Global-Health-Labs/nPOC-BB/docs/index.md

# Project Introduction

## Overview

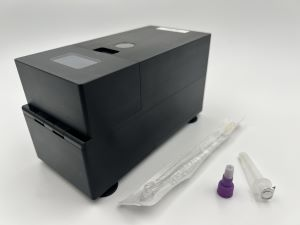
[picture p1: docs/img/gamma-09.jpg]
nPOC-BB Gamma version


The Near Point-Of-Care Bead Beater (nPOC-BB) is a portable sample preparation instrument that is designed to:

1. produce a biosafe cell lysate,
2. release amplifiable cellular nucleic acids, and
3. stabilize released nucleic acids by thermal denaturation of nucleases;

all from a minimally treated human specimen, especially when collected by a swab and transferred into a small (≤3 mL) dropper tube filled with buffer and micro-scale glass beads. Collectively, this intended use enables molecular diagnostic applications for detecting difficult-to-lyse pathogens in human biological specimens in a variety of settings.

The mechanisms by which the device achieves these intentions are a combination of heating to near-boiling liquid temperatures and rapid shaking (also known as "bead beating") to shear-force-inducing frequencies. Both mechanisms are important: the heating increases susceptibility of microorganisms to killing and lysis, which improves biosafety and contributes to lysis efficiency, and decreases nuclease activity, which stabilizes the released nucleic acids in the resulting lysate; the shaking drastically increases lysis efficiency, which releases more amplifiable nucleic acids into the resulting lysate than heating alone. We typically measure lysis efficiency by the quantity of amplifiable nucleic acids released from target cells in the sample.

Data generated on this instrument at Global Health Labs (GHL), its original developer, show that for difficult-to-lyse cellular microorganisms, such as *Mycobacterium tuberculosis* (Mtb), heating alone results in almost no lysis efficiency, while shaking alone (such as with a lab-grade bead beater or homogenizer) results in reduced lysis efficiency, compared to heating and shaking together. Therefore, we created the nPOC-BB instrument for you, the diagnostic test developer who requires a low-cost, portable, robust, and rapid method for the efficient preparation of a sample to be used in a nucleic acid amplification test (NAAT).

The goal of this documentation is to describe the nPOC-BB instrument as a stand-alone instrument whose principles may be replicated in commercial diagnostic (global) health care products, but the development of this specific instrument took place within the context of the development at GHL of [NAATOS][1], a diagnostic system for the nucleic-acid-based detection of Mtb from human tongue swab specimens. However, because the nPOC-BB has also been shown to yield high lysis efficiency of Mtb in human sputum samples, which is an excellent model for a difficult-to-lyse organism in a challenging sample matrices, we believe this instrument will be useful beyond the original application—a claim that of course must be validated in your own context.

## Contributors

### Global Health Labs (GHL)

GHL is the lead developer of the nPOC-BB device, having invested in several areas of early stage research related to new tools and technologies for diagnosis of tuberculosis (and other endemic infectious disease) in low-resource settings.

- Lex Ball [:material-linkedin:](https://www.linkedin.com/in/lex-ball-a0041219/){:target="_blank"}
- [Josh Bishop](https://github.com/jdbishop) [:material-linkedin:](https://www.linkedin.com/in/josh-bishop-ph-d-6207324/){:target="_blank"}
- [Stephen Burkot](https://github.com/sburkot24) [:material-linkedin:](https://www.linkedin.com/in/stephenburkot/){:target="_blank"}
- [Ryan Calderon](https://github.com/rcalderon04) [:material-linkedin:](https://www.linkedin.com/in/ryan-calderon-a6a02625/){:target="_blank"}
- [Simon Ghionea](https://github.com/sghionea) [:material-linkedin:](https://www.linkedin.com/in/simonghionea/){:target="_blank"}
- [Chin Ng Hei](https://github.com/ngchei) [:material-linkedin:](https://www.linkedin.com/in/chin-ng-ph-d-21522013/){:target="_blank"}
- Isabel Izek [:material-linkedin:](https://www.linkedin.com/in/isabel-izek/){:target="_blank"}
- [Matt Keller](https://github.com/mkeller99) [:material-linkedin:](https://www.linkedin.com/in/matt-keller-a360b483/){:target="_blank"}
- Khushboo Khimani [:material-linkedin:](https://www.linkedin.com/in/khushboo-khimani/){:target="_blank"}
- [Andrew Miller](https://github.com/andrewmiller-ghl) [:material-linkedin:](https://www.linkedin.com/in/andrew-miller-78938520/){:target="_blank"}
- Bryan Norton [:material-linkedin:](https://www.linkedin.com/in/bryanjnorton/){:target="_blank"}
- Julie Pendergraft [:material-linkedin:](https://www.linkedin.com/in/julielpendergraft/){:target="_blank"}
- Jamie Purcell [:material-linkedin:](https://www.linkedin.com/in/jamie-purcell-phd-098aa65a/){:target="_blank"}
- Amy Steadman [:material-linkedin:](https://www.linkedin.com/in/amy-steadman-aa80578b/){:target="_blank"}

### Central Centerless Grinding (CCG)/Scitus Engineering

[CCG](http://ccgonline.net/) is the hardware design and instrument manufacturing partner for the nPOC-BB and NAATOS systems.

- Philip Almquist
- Mark Flanagan[^1]
- James Paolino[^1]
- Ed Sienczylo
- David Sorenson
- Binh Tran

### Odic

[Odic](https://odic.com/) is the electronics design partner for the nPOC-BB and NAATOS systems.

- Rob Filipkowski[^2]
- Liam Sullivan
- Ian O’Neil
- Dylan Derose

### Market Access Africa (MAA)

[MAA](https://www.marketaccess.africa/) is the African healthcare market research partner for the nPOC-BB and NAATOS systems.

- Olawale Ajose[^3] [:material-linkedin:](https://www.linkedin.com/in/olawale-ajose-1521b975/){:target="_blank"}
- Obakeng Bagopi
- Zipporah Bundi
- Nancy Njoku-Attah
- Wambui Nyabero
- Pam Pillay[^3] [:material-linkedin:](https://www.linkedin.com/in/pam-pillay-a7b5ba65/){:target="_blank"}
- Newton Runyowa
- Chris Smit
- Shabnam Zavahir

### Health Innovation Advisors (HIA)

[HIA](https://innovationadvisors.org/) is the user research and implementation science partner for the nPOC-BB and NAATOS systems.

- Melissa Mugambi[^4] [:material-linkedin:](https://www.linkedin.com/in/melissamugambi/){:target="_blank"}

[^1]: Corresponding contributor for CCG.
[^2]: Corresponding contributor for Odic.
[^3]: Corresponding contributor for MAA.
[^4]: Corresponding contributor for HIA.

[1]: <https://www.ghlabs.org/innovations/next-generation-dx-platforms-2> "NAATOS: Nucleic Acid Amplification Test On a Strip"
