Global-Health-Labs/nPOC-BB/docs/outputs/programming.md

# Programming Instructions

## Instruction for Config / Logs

On an nPOC-BB (Gamma) unit running firmware v3.1 or later, the file system on the exposed mass storage device and NOR flash 1Gbit storage contains the two subdirectories `config` and `logs`, which contain the files for the configuration of the unit and all logs created by the unit, respectively. Below is an example filesystem from a nPOC-BB (Gamma) unit running firmware v3.5 that has been configured to operate four distinct cycles in a run and has logged two distinct runs.

    \
    ├─ config
    │   ├─ config_v3.5.txt
    │   ├─ cycle_config_1.txt
    │   ├─ cycle_config_2.txt
    │   ├─ cycle_config_3.txt
    │   └─ cycle_config_4.txt
    └─ logs
        ├─ sample_05-21-25_121449.csv
        └─ sample_05-22-25_120343.csv

### Config

The `config` subdirectory contains text files that configure the operation of an nPOC-BB unit. The configuration files contain configuration parameters that either apply to the entire run, which may comprise one or more independent cycles, or to cycles, the number of which is configurable. A standard run on a nPOC-BB (Gamma) unit running firmware v3.5 is four cycles: startup; heating; heating and shaking, and passive cooling and shaking.

!!! note
    When a new firmware version is flashed onto a unit, the unit will compare the current firmware version to the Run Configuration file version in storage. If the Run Configuration file name (e.g., `config_v3.4`) does do not match the flashed firmware version (e.g., `v3.5`), the unit will delete all configuration files from storage and create new configuration files that match the current version and contains default values. This functionality exists in the firmware to guarantee compatibility with the configuration files.

#### Run Configuration

A single Run Configuration file will be in the `config` subdirectory. The Run Configuration file is named after the current firmware of the unit (e.g., `config_v3.5.txt` when the firmware version is `v3.5`). The Run Configuration file contains the parameters that configure unit operation for an entire run of one or more cycles (but does not configure the individual cycles; see below). The following table describes the firmware v3.5 Run Configuration parameters and lists their types, default values, and units.

{{ read_csv("docs/tables/nPOC-BB_config_run_params.csv") }}

#### Cycle Configuration

One or more Cycle Configuration files will be found in the `config` subdirectory. The Cycle Configuration files are named for the cycle number (starting with `1` and proceeding in integer order, e.g., `cycle_config_1.txt`, `cycle_config_2.txt`, `cycle_config_3.txt`, and `cycle_config_4.txt`). Each Cycle Configuration file contains the parameters that apply to a single cycle. The default configuration for a nPOC-BB (Gamma) unit running firmware v3.5 uses four cycles defined by four Cycle Configuration files. The following table describes the firmware v 3.5 cycle parameters found in a Cycle Configuration file and lists their types, default values, and units.

{{ read_csv("docs/tables/nPOC-BB_config_cycle_params.csv") }}

### Logs

The `logs` subdirectory contains log files in `*.csv` format. A new log file is generated for every power-on event and every run. A log file is named after the date and time of the event or run (e.g., `sample_05-21-25_121449.csv`).

A log file containers a header row and one or more data rows. Each data row is a single line of comma-delineated text that begins with a timestamp followed by the most recent sensor data gathered at `sample_rate` (a configuration parameter set in the Run Configuration file) and an `Event`, if one has occurred. `Event`-based log entries are generated at the time of the event. Non-`Event` log entries are generated at the `logging_rate` (a configuration parameter set in the Run Configuration file).

The following table contains the header row and the first three data rows of an example log file:

| Time | HeaterTemp | HeaterPWM | MotorSpeed | MotorPWM | Battery | BatteryV | BatteryT | Event |
| - | - | - | - | - | - | - | - | - |
| 2024-12-05 12:04:34 | 24.01 | 100.00 | 0.00 | 0.00 | 19 | 3.57 | 25.03 | Cycle 1 Started |
| 2024-12-05 12:04:35 | 26.39 | 100.00 | 0.00 | 0.00 | 19 | 3.63 | 25.05 | |
| 2024-12-05 12:04:36 | 29.77 | 100.00 | 0.00 | 0.00 | 19 | 3.64 | 25.60 | |

## Instruction for Flashing Firmware

Download the latest [firmware build (v3.5)](https://github.com/Global-Health-Labs/nPOC-BB/tree/main/sw/firmware_with_bootloader) or build from source code in [firmware repository](https://github.com/Global-Health-Labs/NAATOS-V1-Modules-FW).

1. On PC, open `Device Manager` window.
2. In the `Device Manager` window, click `View` => `Show hidden devices`.
3. Connect nPOC-BB unit to PC via USB-C cable.
4. On nPOB-BB unit, With its lid opened, press its start/stop button (top of unit) at least 3 times (4/5 presses may be necessary in case some presses are not registered).
5. Verify in `Device manager` window that two new COM ports have appeared.
   - One "current" port
   - One "hidden" port (with a grey out icon). Remember the number of this port.
6. On PC, open `Command Prompt` window.
7. In the `Command Prompt` window, change directory to the folder that contains the firmware.
8. In the `Command Prompt` window, enter
   `uploadImage.bat COMX`
   (where X is the “hidden” port number we identified in 4b). You should see a progress bar (no progress until next step).
9. On the nPOC-BB unit, press its start/stop button at least 3 times.
10. In the `Command Prompt` window, once the progress reaches 100%, the nPOC-BB LEDs will turn off momentarily.
11. The firmware is updated on the nPOC-BB when its battery LED breathes blue.
12. Disconnect the nPOC-BB from the PC.

## Instruction for Programming Firmware

### Requirements

- [Segger Embedded Studio](https://www.segger.com/downloads/embedded-studio/){:target="_blank"} software version 5.34 was originally used to develop the firmware. Later versions may also work.
- [nRF Connect](https://www.nordicsemi.com/Products/Development-tools/nRF-Connect-for-Desktop){:target="_blank"} software is used to upload the firmware.
- [`nrfutil`](https://www.nordicsemi.com/Products/Development-tools/nrf-util){:target="_blank"}
- Source code for nPOC-BB firmware (shared as [NAATOS---Modules](https://github.com/Global-Health-Labs/NAATOS---Modules){:target="_blank"})
- An nRF PCA10040/56 or a Segger programmer connected to a 6-pin JTAG programming cable is used to program and communicate to the boards via both Segger Embedded Studio and nRF Connect.

### Environment

Open the code in Segger Embedded Studio go to `application/solution/`. The firmware code base for nPOC-BB is shared with the NAATOS system. Therefore, in this directory there should be `naatos_fw.emProject` which is the project file and can be double clicked to open the project inside of Segger Embedded Studio.

For opening the bootloader project, follow the same steps except follow the path `bootloader/solution/` and open `naatos_bootloader.emProject`.

### Debug / Release Modes

Switching the project between Debug and Release can be done inside of the Project Explorer tab of Segger Embedded Studio.  

In most cases, the project should be inside of Debug mode when building the firmware. The only time the Release mode should be used for would be when creating final firmware builds to keep the optimization as high as possible and memory usage as low as possible.  

For the bootloader, ONLY the release mode should be used and not the debug mode. Building and using the bootloader inside of Debug mode will lead to the Bootloader not working and unable to update firmware properly.  

When building the application code, certain memory spaces may have to be changed depending on whether the resulting .hex file being produced will be used with or without a bootloader. The two cases being one where the bootloader is being used on the unit and one that is not. Depending on this the memory map for the unit will need to be changed.  

When simple testing is required, and the bootloader is not needed on the board the memory space for the unit needs to be modified so that it does not expect bootloader code within its memory.  This is done by modifying the linker options of the project. Follow these steps to modify the linker options:

1. Right-click the project in the Project Explorer tab of Segger Embedded studios and select Options.  
2. Choose the build type for the Options, and set it to Common.  
3. Select Linker in the Options.  
4. Double-click on the Section Placement Macros  
5. A property editor should then come up on the screen.  
6. Replace the Text with the following to make the application run without the need of a bootloader flashed onto the unit:

        FLASH_PH_START=0x0
        FLASH_PH_SIZE=0x100000
        RAM_PH_START=0x20000000
        RAM_PH_SIZE=0x40000
        FLASH_START=0x0000
        FLASH_SIZE=0xF3000
        RAM_START=0x20000000
        RAM_SIZE=0x40000

    If the unit is being programmed and the firmware image is expecting to have a bootloader on the unit and contain the full firmware the following options need to be set:  

        FLASH_PH_START=0x0 
        FLASH_PH_SIZE=0x100000 
        RAM_PH_START=0x20000000 
        RAM_PH_SIZE=0x40000 
        FLASH_START=0x1000 
        FLASH_SIZE=0xF3000 
        RAM_START=0x20000008 
        RAM_SIZE=0x3FFF8 

### Bootloader

Triple-press the start button for the board to enter the bootloader from the application firmware. Bootloader must be programmed onto the board of a unit to enter the mode, or the unit will end up in a hard fault state with the unit crashing.  

There are four required files for full firmware programming of the unit (found in `/sw/firmware_with_bootloader/`):

- The [application firmware hex file]({{ files_url }}/sw/firmware_with_bootloader/npoc-bb_fw.hex), `npoc-bb_fw.hex`, is the application code, which is flashed onto the board, is generated with each revision of application firmware changes, and can be overwritten.
- The [bootloader firmware hex file]({{ files_url }}/sw/firmware_with_bootloader/npoc-bb_bootloader_SG_compilerelease_NORELOC.hex), `npoc-bb_bootloader_SG_compilerelease_NORELOC.hex`, is the bootloader code, which is flashed onto the board, is generated only once, and cannot be overwritten.  
- The [master boot record]({{ files_url }}/sw/firmware_with_bootloader/mbr_nrf52_24.1_mbr.hex), `mbr_nrf52_24.1_mbr.hex`, is the static record of the bootloader, which is taken from the nRF52840 SDK, not modified for this application, and cannot be overwritten.
- The [bootloader settings hex file]({{ files_url }}/sw/firmware_with_bootloader/npoc-bb_bootloader_settings.hex), `npoc-bb_bootloader_settings.hex`, contains the settings for the bootloader to run on, tells the bootloader what to expect on a firmware upgrade, and can be regenerated to accommodate changes to the bootloader.

!!! note
    nRF Connect must be used to program the bootloader onto the unit. Segger Embedded Studio cannot program the bootloader onto the unit.  

1. Open nRF Connect.

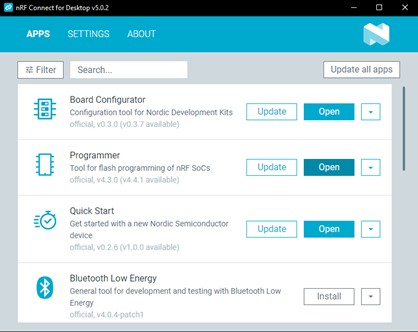
[picture p2: docs/img/sw-06-nrf_connect.png]
nRF Connect
    

2. Select the Programmer Tool, then select `nRF52 DK` as the programmer (top left).

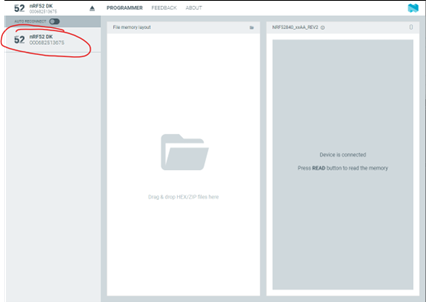
[picture p3: docs/img/sw-07-nrf52_dk.png]
Programmer Tool > nRF52 DK
    

3. Add all four firmware files into the Programmer Tool.

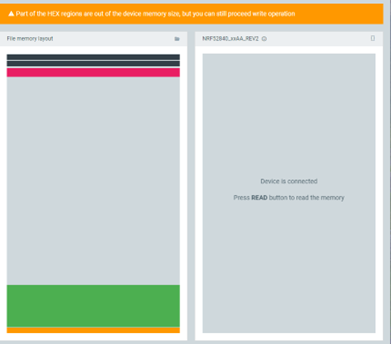
[picture p4: docs/img/sw-08-file_memory.png]
File memory
    

    !!! note
        Ensure that the application firmware hex file is generated with the correct memory layout and expects the bootloader to be there.  

4. When the firmware files are loaded into the programmer the `Erase and Write` button can be pressed to write the full firmware to the unit.

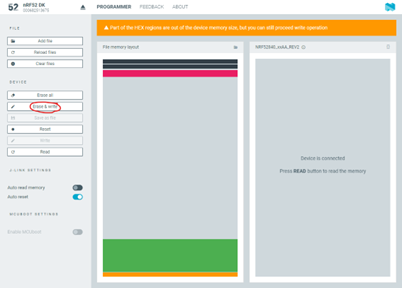
[picture p5: docs/img/sw-09-completed.png]
Erase and Write
    

    There should be no red messages in the console log and the finishing programming line should be `Reading readback protection status for Application core completed`.

5. The unit has been fully programmed and has both the bootloader and the application firmware on the unit and is ready for operation and future upgrades via the bootloader.  

### Generate Upgrade Package

To generate a package, first ```nrfutil``` must be installed which runs the entire firmware upgrade creation and flashing process.

To create a package the following command must be run with ```nrfutil```:

    nrfutil pkg generate --hw-version 52 --sd-req 0x00 --application-version 4 --application Path/To/Application/Hex/File --key-file Path/To/Key/File npoc-bb_dfu_package.zip 

This command takes in the newly created application firmware hex and our Odic generated key file which will be provided to create a .zip upgrade package with the given application firmware hex file.  

A script will also be provided which can be run to create a firmware upgrade package when the correct paths are set inside of it.  

### Flashing Upgrade Package

Now to flash the unit, it must first be put into bootloader mode via clicking the button 3 times on the unit. The unit should then open a COM port on the computer which can be seen inside of the unit manager for Windows.  



The COM port for the bootloader should be named ‘nRF52 SDFU USB’, run the following command with the COM port replacing COM_PORT:

    nrfutil dfu usb-serial -pkg npoc-bb_dfu_package.zip -p COM_PORT -b 115200 

The firmware should then begin uploading to the unit and updating it.

## Instruction for Programming Power Driver (PD) Controller

### Requirements

- nPOC-BB (Gamma) unit main printed circuit board (PCB)
- nPOC-BB (Gamma) unit battery pack
- USB-C cable (×2)
- [Adafruit FT232H breakout board](https://www.adafruit.com/product/2264){:target="_blank"}
- 6-pin TAG-Connect cable, terminated with headers
- [Zadig](https://zadig.akeo.ie/){:target="_blank"}
- `eeprom_flasher.py`
- PyFTDI python module
- `nPOC-BB_PD.bin`
- [Optional] Microsoft Visual Studio Code (vscode)
- [Optional] [TI TPS2570 Application Customization Tool](https://dev.ti.com/gallery/view/USBPD/TPS25750_Application_Customization_Tool/ver/7.0.4/){:target="_blank"}

### Setup

#### Setup Adafruit FT232H

Adafruit [has provided detailed instructions](https://learn.adafruit.com/circuitpython-on-any-computer-with-ft232h/windows){:target="_blank"} on using the Adafruit FT232H on Windows because Windows does not allow driverless devices. The driver must be updated manually, but only once per FT232H per computer. A summary of the Adafruit instructions is below.

1. Connect only the Adafruit FT232H to your PC. Disconnect all other USB to serial devices (this includes Arduinos).
2. Launch Zadig.
3. Under `Options > List All Devices`, find `USB Serial Converter`.
4. Replace the default driver with `libusbK`.

#### Wire TAG-Connect and Adafruit FT232H

Connect the TAG-Connect to the Adafruit FT232H board as follows:

| FT232H Pin | TAG-Connect Pin |
|---|---|
| GND | 4 |
| D0 | 1 |
| D1 | 3 |

Note that when looking at the header side of the TAG-Connect cable, it has the following pin numbering:

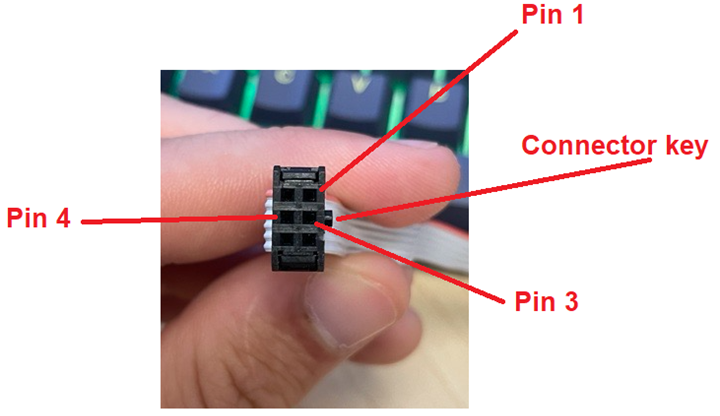
[picture p6: docs/img/sw-02.png]
TAG-Connect pins


#### Configure TPS25750

The `nPOC-BB_PD.bin` and `nPOC-BB_TPS25750_config.json` files were generated using the [TI TPS2570 Application Customization Tool](https://dev.ti.com/gallery/view/USBPD/TPS25750_Application_Customization_Tool/ver/7.0.4/){:target="_blank"}. It should not be necessary, but to regenerate the `nPOC-BB_PD.bin` and `nPOC-BB_TPS25750_config.json` files, follow the steps below.

!!! note
    The TI TPS2570 Application Customization Tool requires free registration to use. The tool will suggest to download and install software, but the `Esc` key can be pressed to avoid that step.

1. Answer the questions about your desired configuration using the values in the table below.

    | Question | Answer |
    |-|-|
    | 1. Configuration | Power Sink only (second box) with BQ and integrated switch (upper left option) |
    | 2. N/A ||
    | 3. What Sink Power is Required? | 60W |
    | 4. N/A ||
    | 5. What is the supported USB Highest Speed? | USB 2 |
    | 6. Do you have a preferred data role? | Device |
    | 7. Do you have a vendor ID supplied by the USB-IF? | No |
    | 8. Do you have a desired product ID? | No |
    | 9. Select the battery charger component to integrate | BQ25792 |
    | 10. Battery charging voltage | 8.4V |
    | 11. Battery charging current | 3.3A |
    | 12. Charge termination current | 0.12A |
    | 13. Pre-charge current | 0.32A |

2. Click `Export Settings`, type the file name `nPOC-BB_TPS25750_config`, and click `Export` to download the `nPOC-BB_TPS25750_config.json` file.
3. Click `Generate Full Flash Binary`, choose the format `Binary`, type the file name `nPOC-BB_PD`, and click `Download` to download the `nPOC-BB_PD.bin` file.

!!! note
    The TPS25750 has GPIOs that can be configured under `Advanced Configuration`. Reference the TPS25750 Host Interface Technical Reference Manual for more information.

### Programming

1. If not already installed, install PyFTDI from vscode (or other Python-enabled terminal) with `pip install pyftdi`.
2. Change directory to the location of the `eeprom_flasher.py` and `nPOC-BB_PD.bin` files.
3. Connect a USB-C cable between the PC running the Python script and the Adafruit FT232H board.
4. Connect the battery pack to the nPOC-BB (Gamma) unit main PCB. First connect black (battery pack ground), then red (battery pack positive), and finally purple (battery pack center-tap).

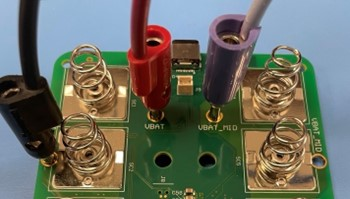
[picture p7: docs/img/sw-03.jpg]
Battery connections
    

5. Attach alligator clip to nPOC-BB (Gamma) unit main PCB at J9.

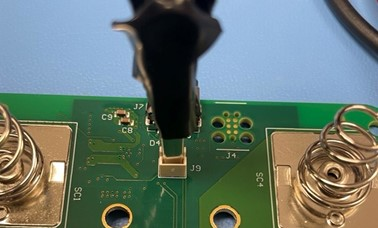
[picture p8: docs/img/sw-04.jpg]
Alligator clip
    

6. Connect a USB-C cable between the PC and the nPOC-BB (Gamma) unit main PCB.
7. Connect the TAG-Connect to the nPOC-BB (Gamma) unit main PCB at J8.

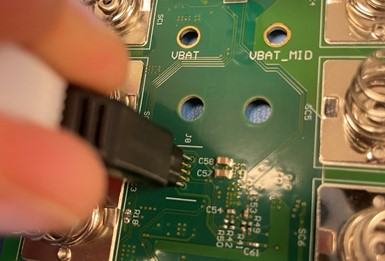
[picture p9: docs/img/sw-05.jpg]
TAG-Connect
    

8. Run `python eeprom_flasher.py`.
    - It will take approximately 15 seconds to program the board.
    - When the script reads back what it programmed to the board, it should print out `bytearray(b'\x00\x08\x00\x00\xff\xff\xff\xff\xff\xff\xff\xff\xff\xff\xff\xff')`.
9. Disconnect the TAG-Connect cable.
10. Disconnect the USB-C cable attached to the nPOC-BB (Gamma) unit main PCB.
11. Disconnect the battery pack from the nPOC-BB (Gamma) unit main PCB. First disconnect the purple wire (battery pack center-tap), then the red wire (battery pack positive), then the black wire (battery pack negative).
