Global-Health-Labs/nPOC-BB/docs/inputs/rtm.md

# Requirements Traceability Matrix (RTM)

## Overview

The nPOC-BB was originally developed at GHL as the front-end of a prototype diagnostic test system called NAATOS. Therefore, the design inputs for the nPOC-BB are a subset of the design inputs for NAATOS, and the RTM for the nPOC-BB is excerpted from the larger NAATOS RTM. As such, some of the excerpted User Needs and/or Requirements:

1. Contain NAATOS-specific references.
    1. **Product** denotes the NAATOS system.Nucleic Acid Amplification Test On a Strip. A technology under development at Global Health Labs (GHL) that combines the low-cost and availability of lateral flow assay (LFA) testing with nucleic acid amplification (i.e., molecular) testing.
    2. **SPM** is the abbreviated name of the nPOC-BB instrument in the NAATOS system.
    3. **SCC** is the abbreviated name of the swab used to collect a sample.
    4. **STC** is the abbreviated name of the dropper tube used in the nPOC-BB.
2. Do not apply to the nPOC-BB parts of NAATOS and therefore state "N/A" in an adjacent cell.
3. Apply to the specific manufacture and regulatory approval of a medical device and therefore state "**TBD**" in the cell.

You can also [download a tabular version of this RTM in the ```*.csv``` format](../tables/nPOC-BB_rtm.csv).

## Requirements Traceability Matrix

{{ read_csv("docs/tables/nPOC-BB_rtm.csv", na_filter = False) }}
