Global-Health-Labs/nPOC-BB/docs/outputs/alpha.md

# Alpha version (2024Q2)

## Bill of Materials

Not available.

## Hardware

### CAD

- SolidWorks Parts, Assemblies, and Drawings
    - [/hw/alpha/CAD/solidworks/](https://github.com/Global-Health-Labs/nPOC-BB/tree/main/hw/alpha/CAD/solidworks){:target="_blank"}
- Top-Level Assembly
    - [/hw/alpha/CAD/solidworks/GHL-1-22000.SLDASM](https://github.com/Global-Health-Labs/nPOC-BB/blob/main/hw/alpha/CAD/solidworks/GHL-1-22000.SLDASM){:target="_blank"}
- Derived Solid Files
    - [/hw/alpha/CAD/derived/](https://github.com/Global-Health-Labs/nPOC-BB/blob/main/hw/alpha/CAD/derived/){:target="_blank"}

### eCAD

- Main PCBA
    - [/hw/alpha/ECAD/](https://github.com/Global-Health-Labs/nPOC-BB/tree/main/hw/alpha/ECAD){:target="_blank"}

## Firmware

- Version 1.0–2.0a
    - [NAATOS-V1-Modules-FW](https://github.com/Global-Health-Labs/NAATOS-V1-Modules-FW){:target="_blank"}
