Global-Health-Labs/nPOC-BB/docs/outputs/notifications.md

# Notification Specification

On an nPOC-BB (Gamma) unit running firmware v3.5, the LED notification lights will notify the user according to the specification in the table below.

{{ read_csv("docs/tables/nPOC-BB_notifications.csv") }}
