Global-Health-Labs/nPOC-BB/docs/img/01-nPOC-BB-beta.png

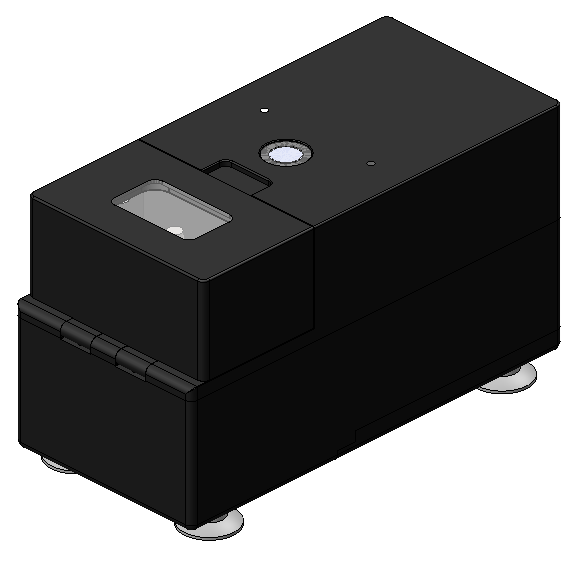
docs/img/01-nPOC-BB-beta.png
