Global-Health-Labs/nPOC-BB/docs/img/gamma-01.jpg

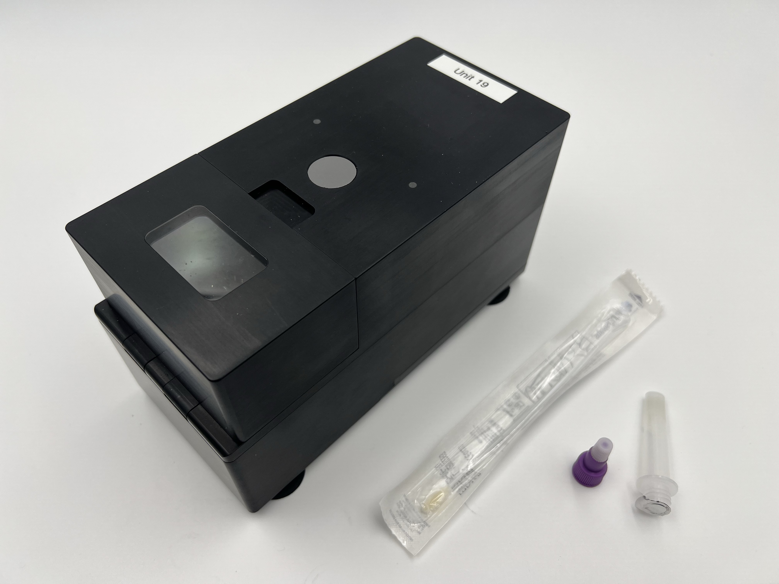
docs/img/gamma-01.jpg
