Global-Health-Labs/nPOC-BB/docs/img/gamma-02.jpg

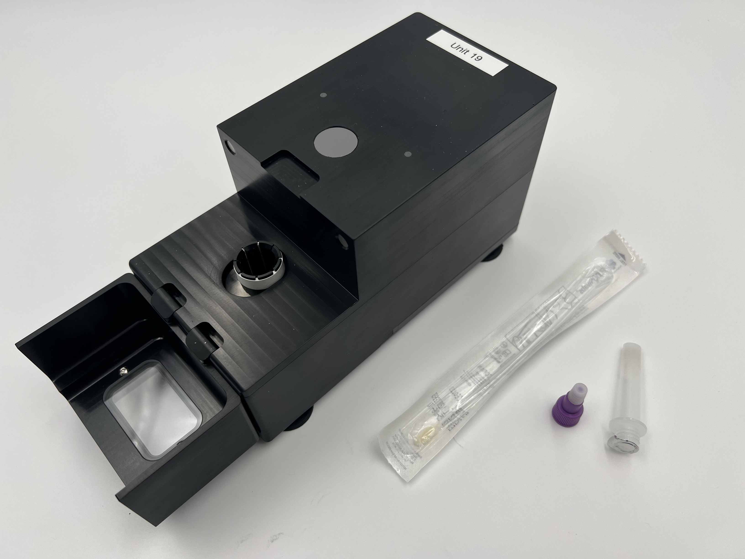
docs/img/gamma-02.jpg
