Global-Health-Labs/nPOC-BB/docs/img/gamma-04.jpg

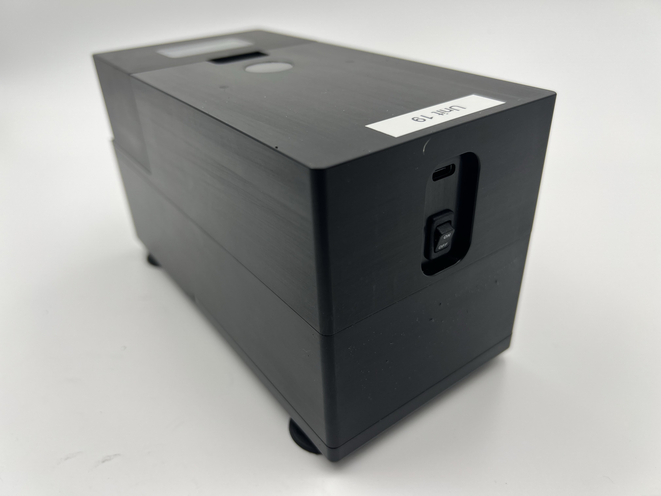
docs/img/gamma-04.jpg
