Global-Health-Labs/nPOC-BB/docs/img/gamma-05.jpg

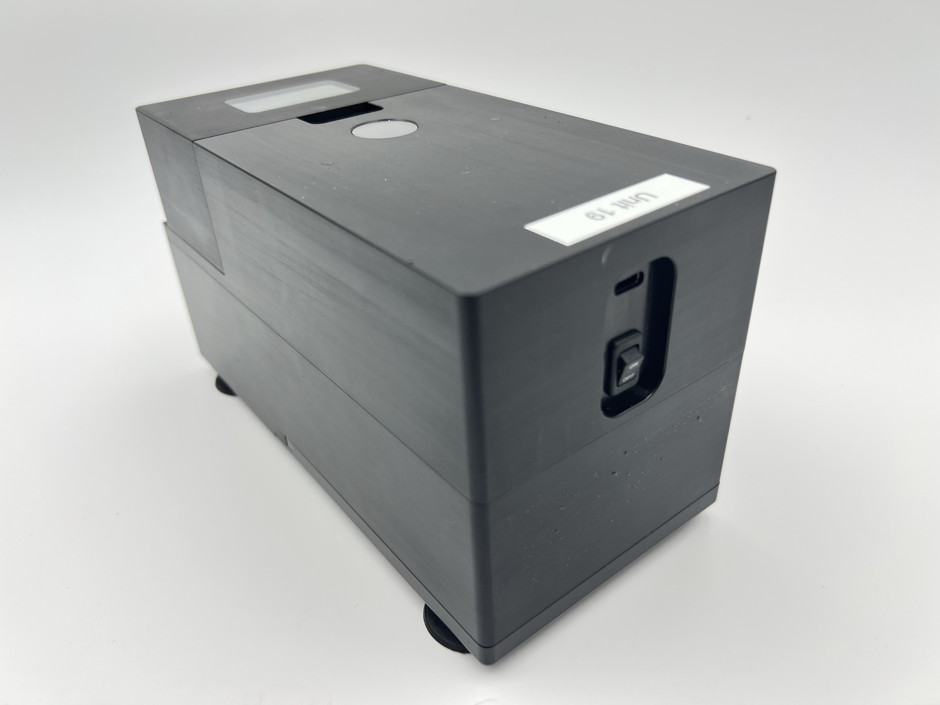
docs/img/gamma-05.jpg
