Global-Health-Labs/nPOC-BB/docs/img/gamma-07.jpg

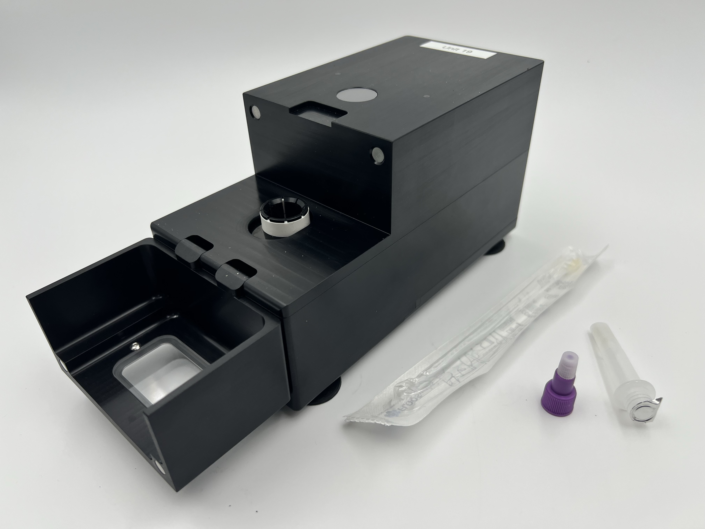
docs/img/gamma-07.jpg
