Global-Health-Labs/nPOC-BB/docs/img/gamma-08.jpg

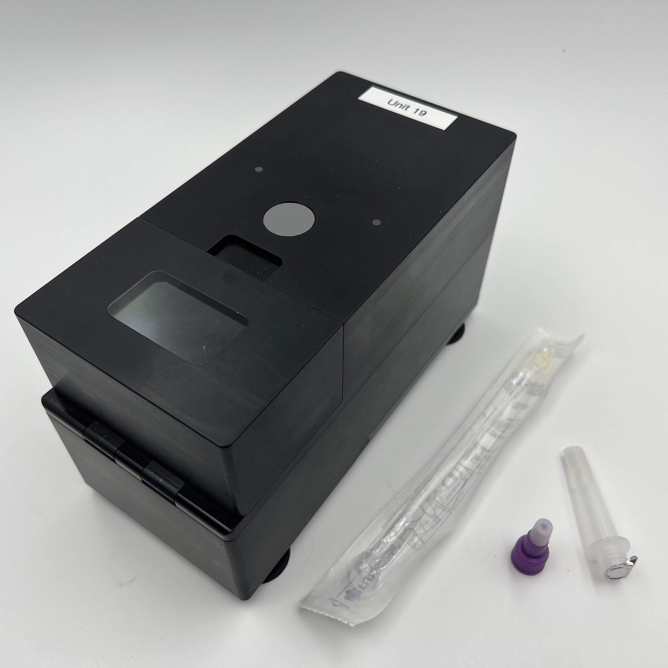
docs/img/gamma-08.jpg
