Global-Health-Labs/nPOC-BB/docs/img/vcbb-01.jpg

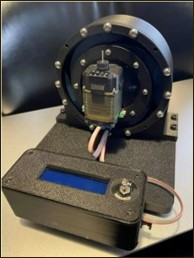
docs/img/vcbb-01.jpg
