Global-Health-Labs/nPOC-BB/docs/img/web-app-manifest-192x192.png

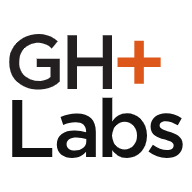
docs/img/web-app-manifest-192x192.png
