Global-Health-Labs/nPOC-BB/hw/alpha/CAD/solidworks/Heater block consumable combo.SLDASM

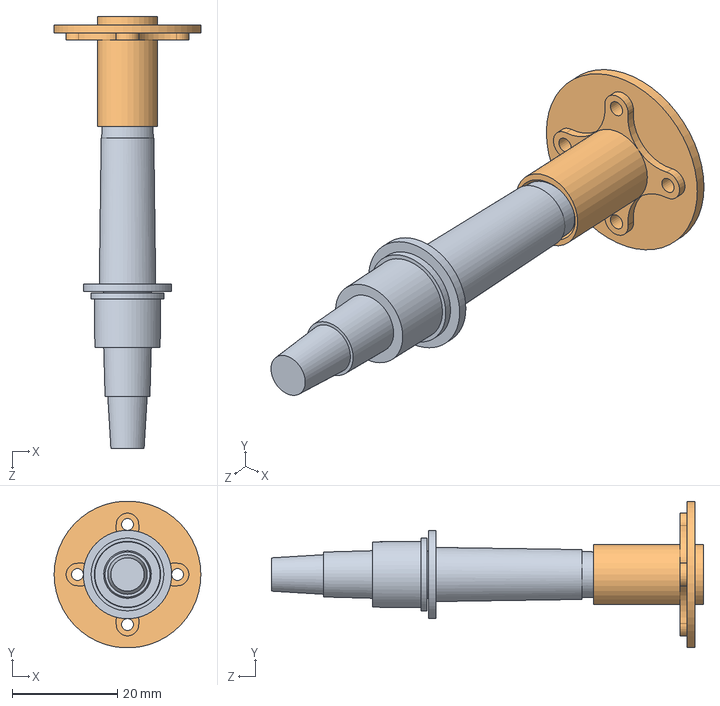
[picture p81: CAD file, 2025-06-21]
hw/alpha/CAD/solidworks/Heater block consumable combo.SLDASM
27.9 x 27.9 x 82.3 mm
GHL-1-20007
purple top big ellipsoid squeeze bottle #6
