Global-Health-Labs/nPOC-BB/hw/alpha/CAD/solidworks/DX07S024XJ1R1100--3DModel-STEP-1.SLDPRT

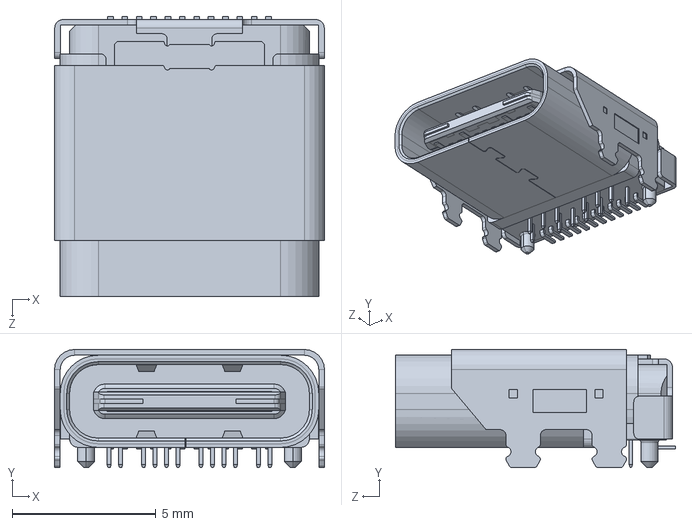
[picture p83: CAD file, 2025-06-21]
hw/alpha/CAD/solidworks/DX07S024XJ1R1100--3DModel-STEP-1.SLDPRT
9.40 x 4.11 x 9.76 mm
