Global-Health-Labs/nPOC-BB/hw/beta/ECAD/heater-board/altium/nPOC-BB_beta_heater-board.step

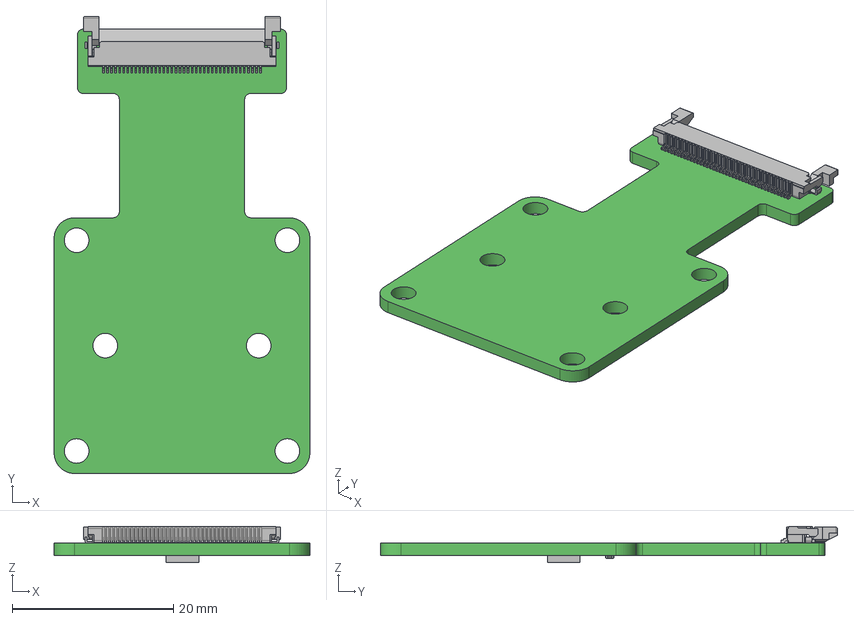
[picture p84: CAD file, 2025-06-21]
hw/beta/ECAD/heater-board/altium/nPOC-BB_beta_heater-board.step
31.8 x 56.7 x 4.53 mm
FH12A-40S-0.5SH_Èª
ť1
ť2 x 2
Extruded
