Global-Health-Labs/nPOC-BB/hw/gamma/CAD/solidworks/DIX36B.SLDPRT

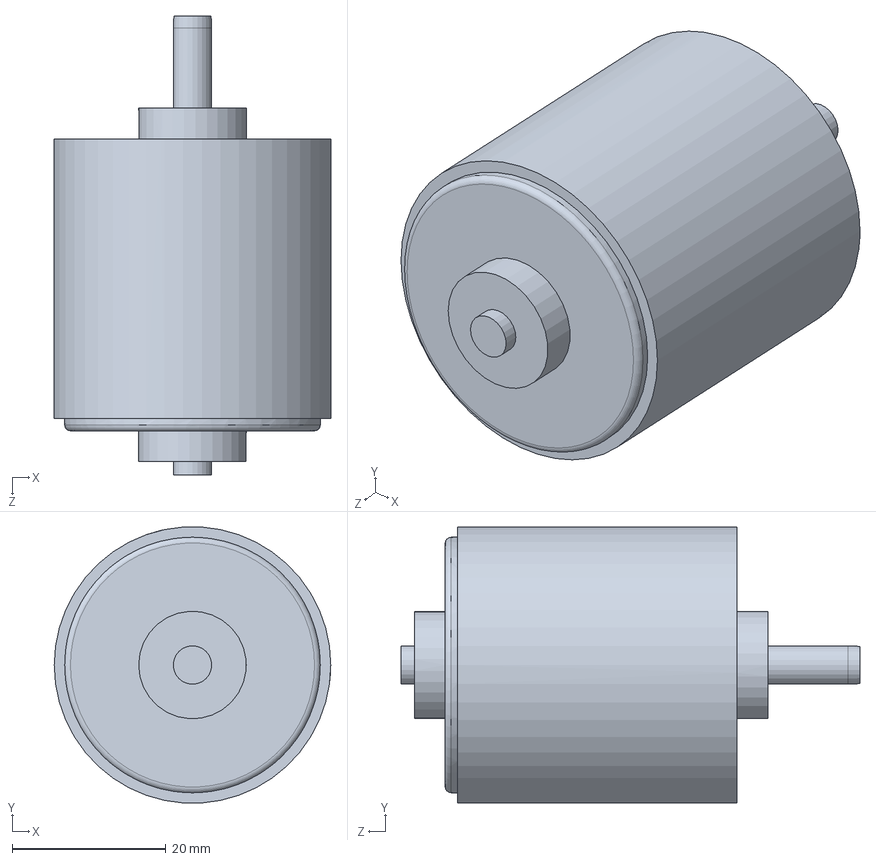
[picture p85: CAD file, 2025-06-21]
hw/gamma/CAD/solidworks/DIX36B.SLDPRT
36.0 x 35.9 x 59.8 mm
