Global-Health-Labs/nPOC-BB/hw/alpha/CAD/derived/GHL-1-20013.STEP

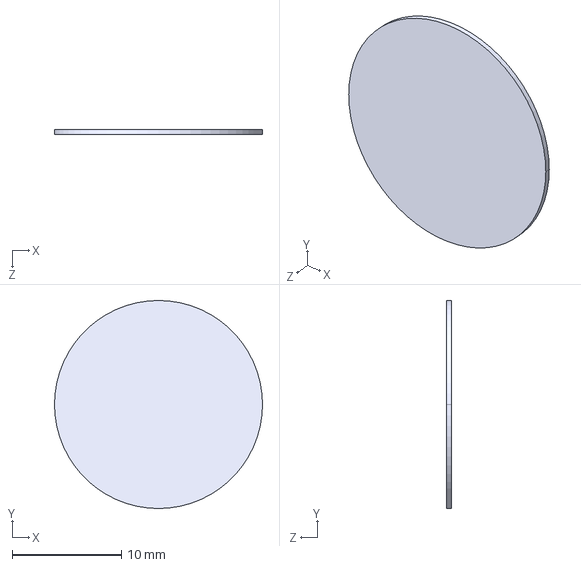
[picture p86: CAD file, 2025-06-21]
hw/alpha/CAD/derived/GHL-1-20013.STEP
19.1 x 19.1 x 0.432 mm
