Global-Health-Labs/nPOC-BB/hw/alpha/CAD/solidworks/GHL-1-20014.SLDPRT

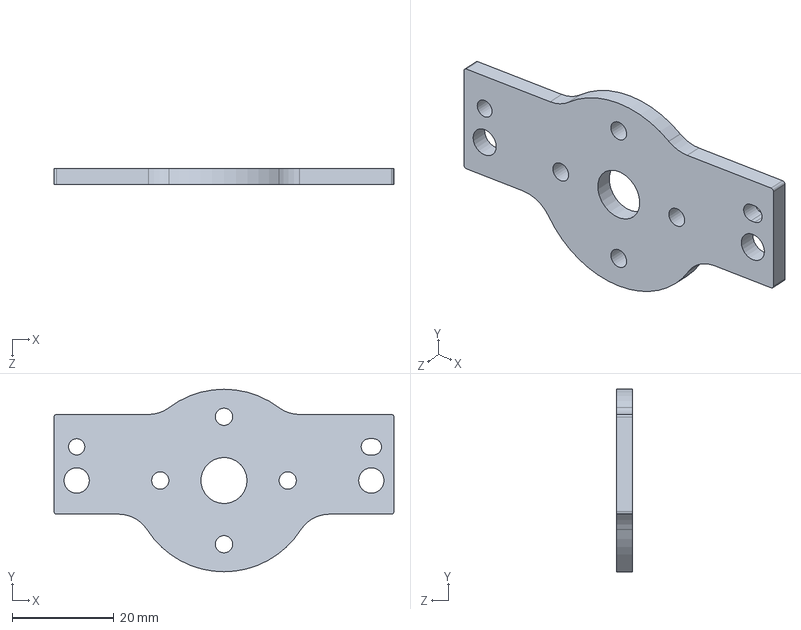
[picture p87: CAD file, 2025-06-21]
hw/alpha/CAD/solidworks/GHL-1-20014.SLDPRT
66.7 x 35.8 x 3.17 mm
