Global-Health-Labs/nPOC-BB/hw/beta/CAD/solidworks/GHL-1-20005.SLDPRT

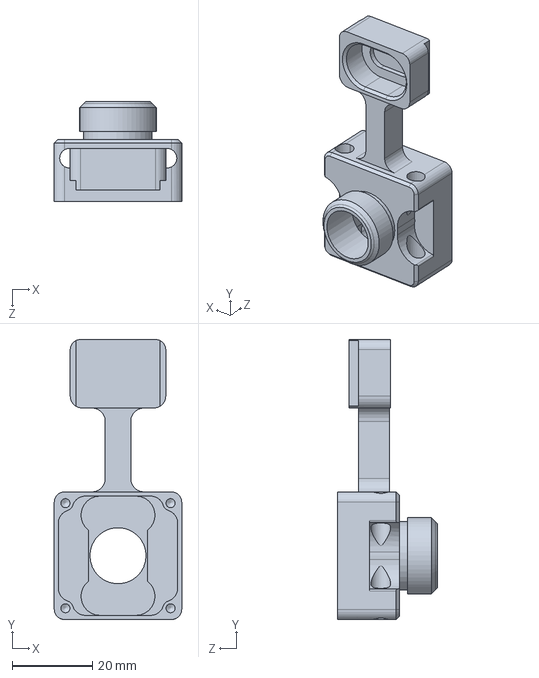
[picture p88: CAD file, 2025-06-21]
hw/beta/CAD/solidworks/GHL-1-20005.SLDPRT
31.8 x 69.7 x 24.9 mm
