Global-Health-Labs/nPOC-BB/hw/gamma/CAD/solidworks/GHL-1-20008.SLDPRT

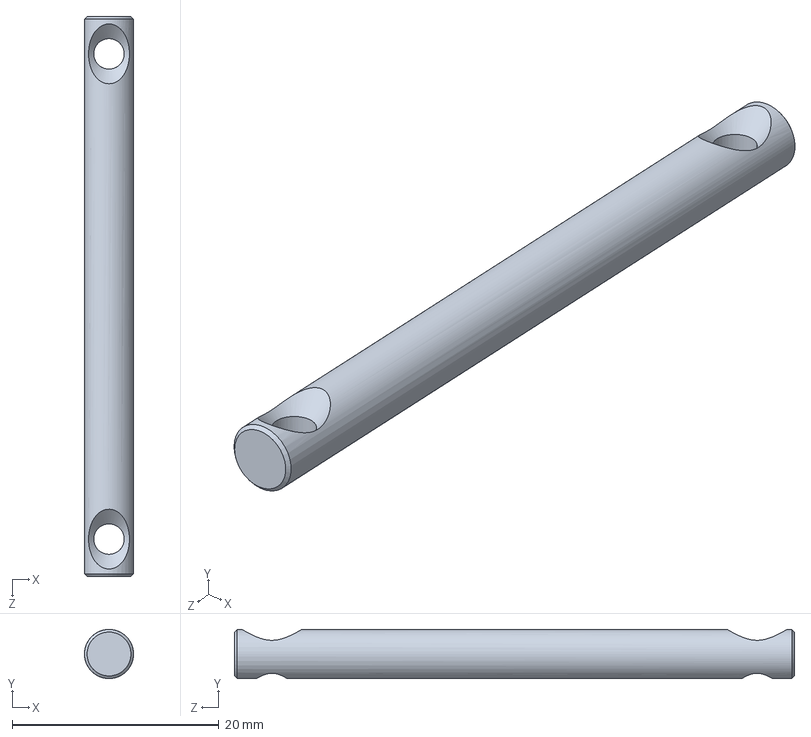
[picture p89: CAD file, 2025-06-21]
hw/gamma/CAD/solidworks/GHL-1-20008.SLDPRT
4.76 x 4.76 x 54.2 mm
