Global-Health-Labs/nPOC-BB/hw/alpha/CAD/solidworks/B2B-PH-K-S.SLDPRT

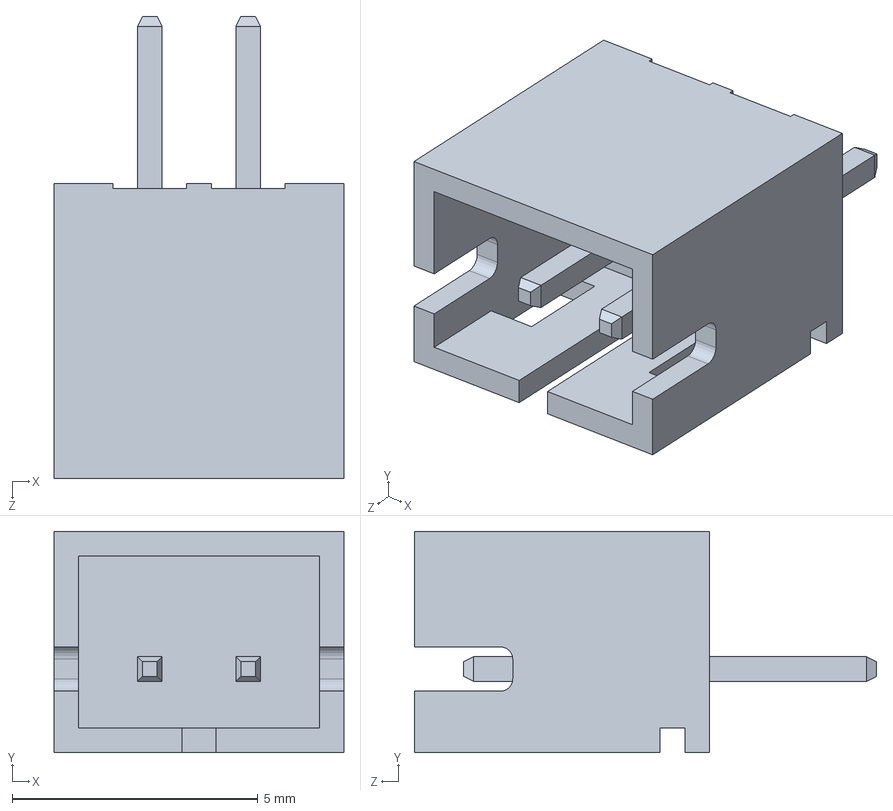
[picture p90: CAD file, 2025-06-21]
hw/alpha/CAD/solidworks/B2B-PH-K-S.SLDPRT
5.90 x 4.50 x 9.40 mm
