Global-Health-Labs/nPOC-BB/hw/alpha/CAD/derived/GHL-1-20005.STEP

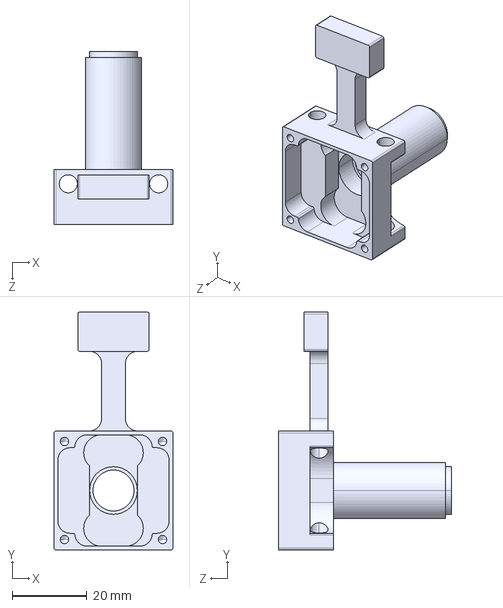
[picture p92: CAD file, 2025-06-21]
hw/alpha/CAD/derived/GHL-1-20005.STEP
31.8 x 63.5 x 46.0 mm
