Global-Health-Labs/nPOC-BB/hw/alpha/CAD/solidworks/SI7201-B-06.SLDPRT

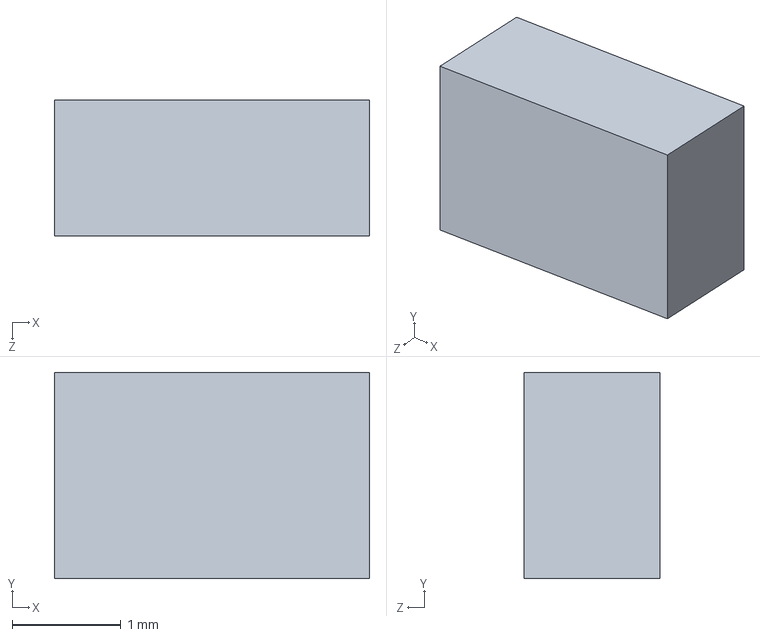
[picture p93: CAD file, 2025-06-21]
hw/alpha/CAD/solidworks/SI7201-B-06.SLDPRT
2.90 x 1.90 x 1.25 mm
