Global-Health-Labs/nPOC-BB/hw/gamma/CAD/solidworks/GHL-1-20021.SLDPRT

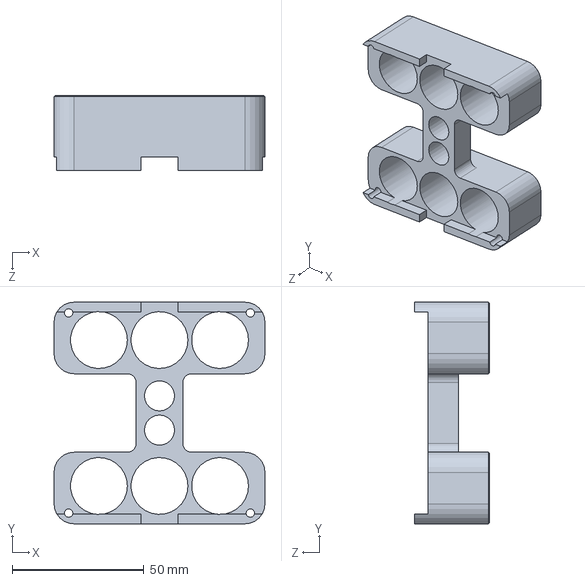
[picture p94: CAD file, 2025-06-21]
hw/gamma/CAD/solidworks/GHL-1-20021.SLDPRT
80.1 x 84.2 x 28.6 mm
