Global-Health-Labs/nPOC-BB/hw/alpha/CAD/derived/GHL-1-20007.STEP

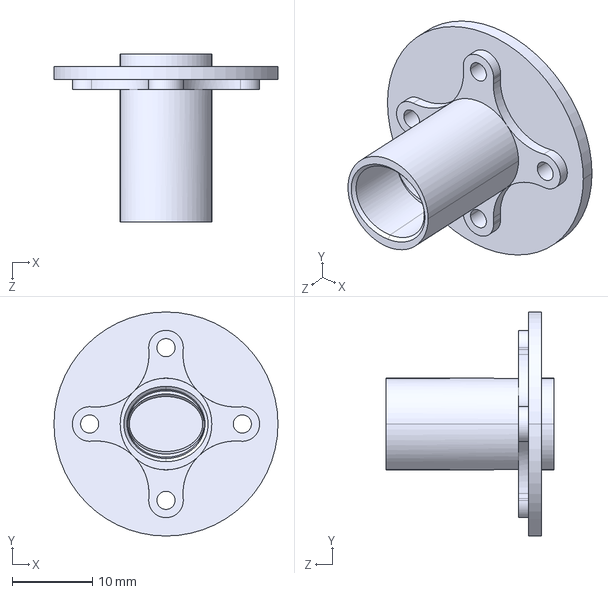
[picture p95: CAD file, 2025-06-21]
hw/alpha/CAD/derived/GHL-1-20007.STEP
27.9 x 27.9 x 21.0 mm
