Global-Health-Labs/nPOC-BB/hw/alpha/CAD/solidworks/GHL-1-20005.SLDPRT

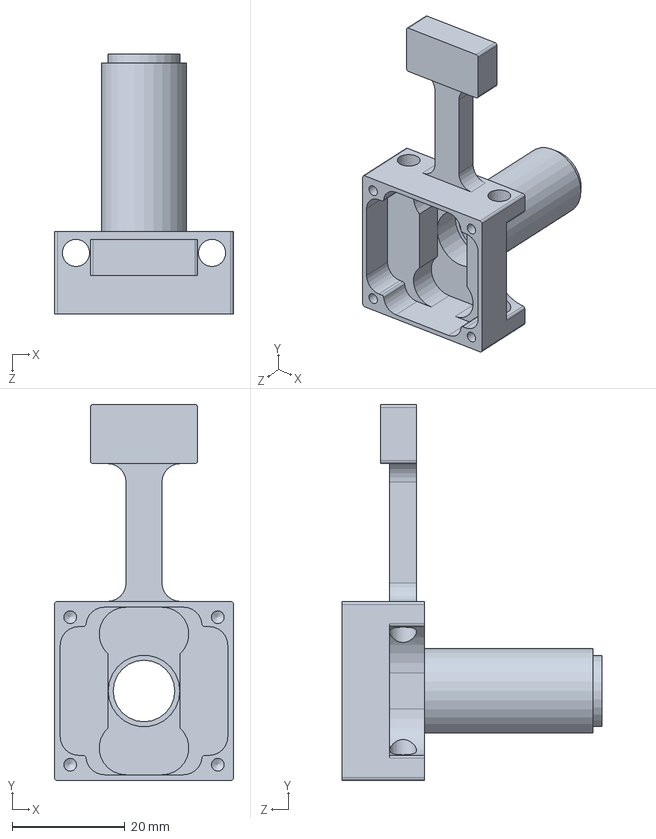
[picture p96: CAD file, 2025-06-21]
hw/alpha/CAD/solidworks/GHL-1-20005.SLDPRT
31.8 x 66.7 x 46.0 mm
