Global-Health-Labs/nPOC-BB/hw/beta/CAD/solidworks/S-21907.SLDPRT

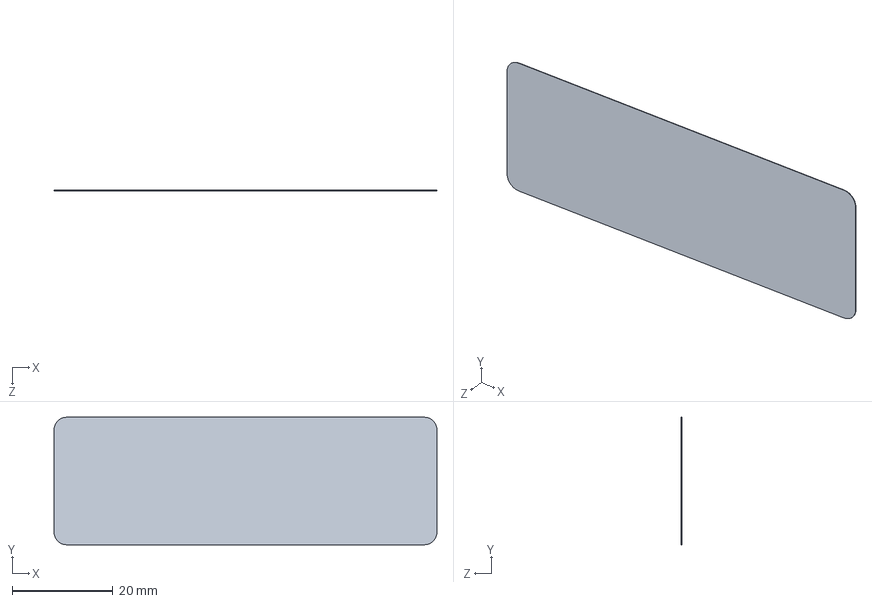
[picture p97: CAD file, 2025-06-21]
hw/beta/CAD/solidworks/S-21907.SLDPRT
76.2 x 25.4 x 0.102 mm
