Global-Health-Labs/nPOC-BB/hw/gamma/CAD/solidworks/GHL-1-20001.SLDPRT

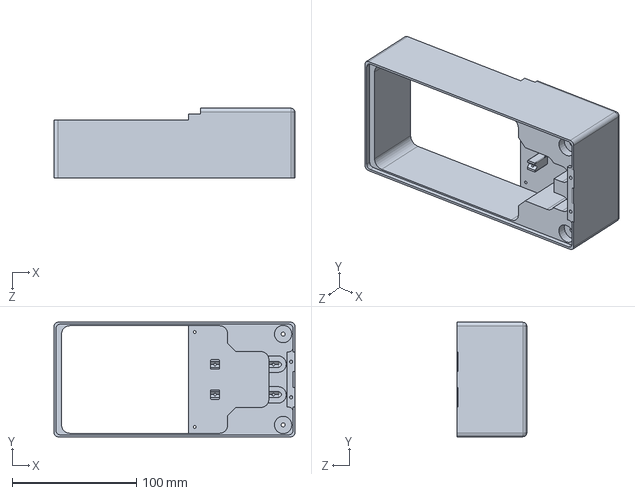
[picture p98: CAD file, 2025-06-21]
hw/gamma/CAD/solidworks/GHL-1-20001.SLDPRT
193.7 x 92.1 x 55.9 mm
