Global-Health-Labs/nPOC-BB/hw/alpha/CAD/derived/GHL-1-20012.STEP

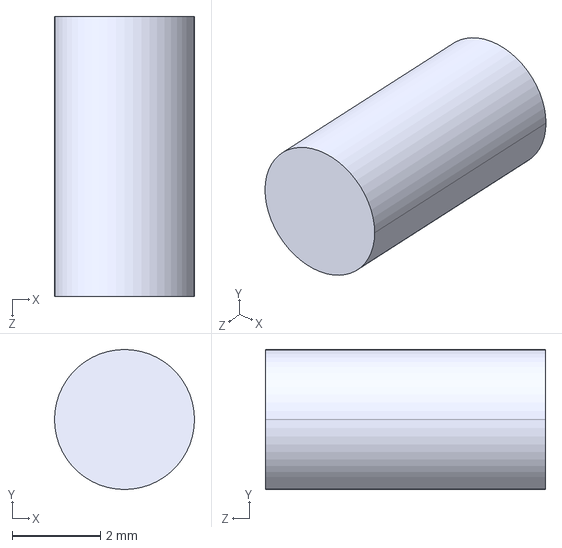
[picture p99: CAD file, 2025-06-21]
hw/alpha/CAD/derived/GHL-1-20012.STEP
3.17 x 3.17 x 6.35 mm
