Global-Health-Labs/nPOC-BB/hw/gamma/CAD/solidworks/GHL-1-20011.SLDPRT

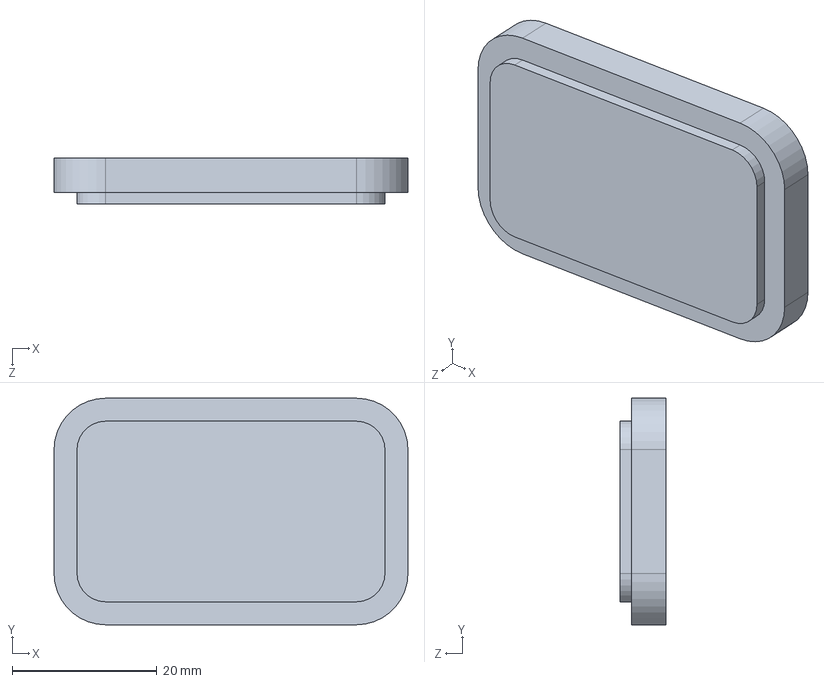
[picture p100: CAD file, 2025-06-21]
hw/gamma/CAD/solidworks/GHL-1-20011.SLDPRT
48.9 x 31.3 x 6.35 mm
