Global-Health-Labs/nPOC-BB/hw/alpha/CAD/derived/GHL-1-20010.STEP

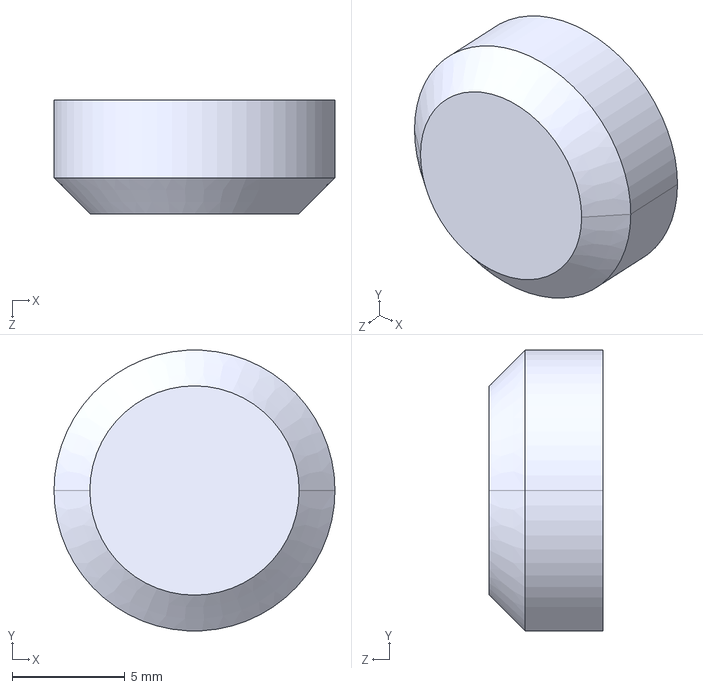
[picture p101: CAD file, 2025-06-21]
hw/alpha/CAD/derived/GHL-1-20010.STEP
12.4 x 12.4 x 5.03 mm
