Global-Health-Labs/nPOC-BB/hw/alpha/CAD/derived/GHL-1-20006.STEP

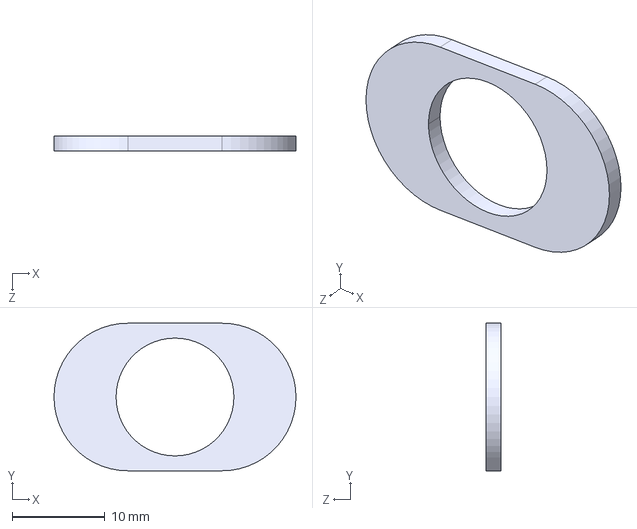
[picture p102: CAD file, 2025-06-21]
hw/alpha/CAD/derived/GHL-1-20006.STEP
26.0 x 15.9 x 1.59 mm
