Global-Health-Labs/nPOC-BB/hw/beta/CAD/solidworks/GHL-1-20003.SLDPRT

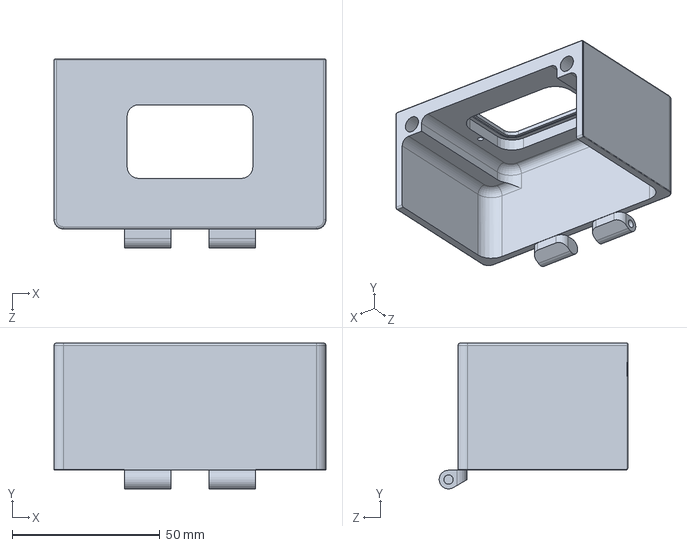
[picture p103: CAD file, 2025-06-21]
hw/beta/CAD/solidworks/GHL-1-20003.SLDPRT
92.1 x 49.4 x 63.9 mm
