Global-Health-Labs/nPOC-BB/hw/gamma/CAD/solidworks/GHL-1-20002.SLDPRT

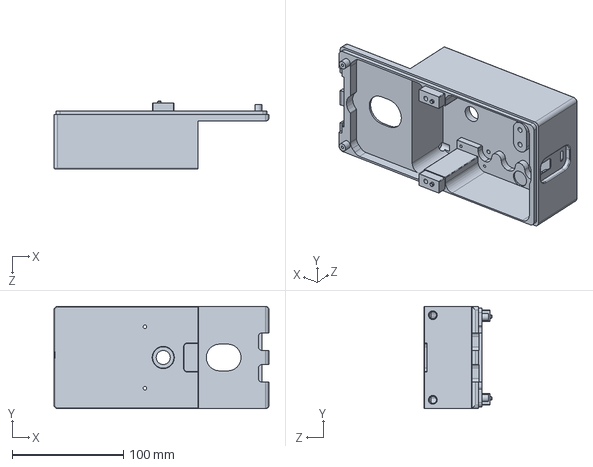
[picture p104: CAD file, 2025-06-21]
hw/gamma/CAD/solidworks/GHL-1-20002.SLDPRT
193.7 x 92.1 x 61.2 mm
