Global-Health-Labs/nPOC-BB/hw/alpha/CAD/derived/GHL-1-20009.STEP

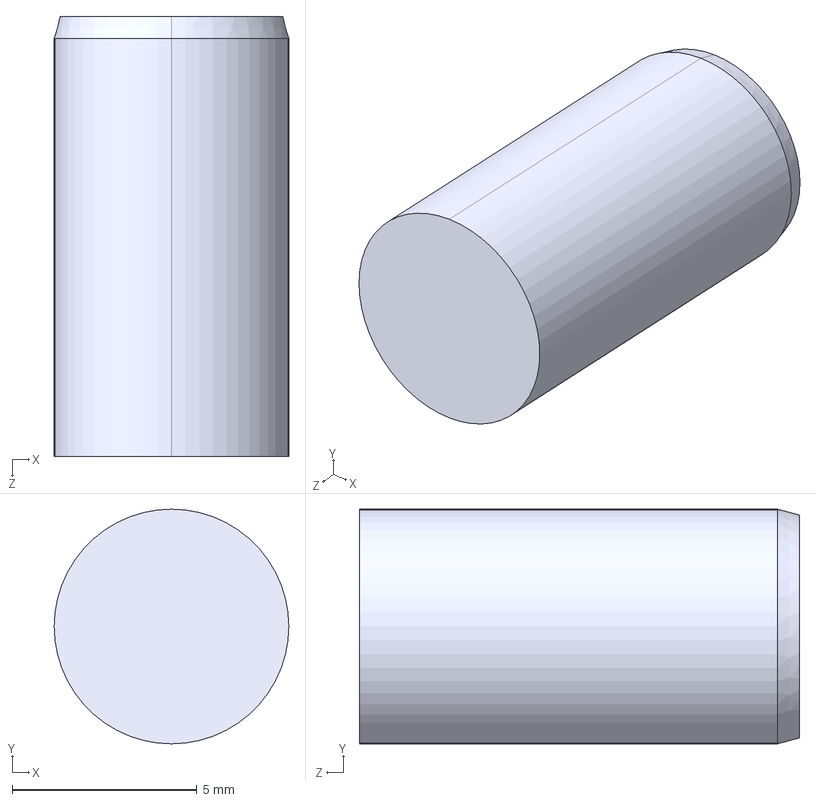
[picture p105: CAD file, 2025-06-21]
hw/alpha/CAD/derived/GHL-1-20009.STEP
6.35 x 6.35 x 11.9 mm
