Global-Health-Labs/nPOC-BB/hw/alpha/CAD/solidworks/psfw8s-2stlf.SLDPRT

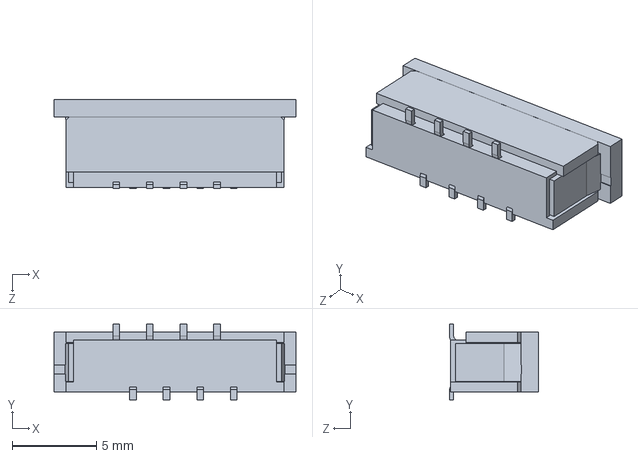
[picture p106: CAD file, 2025-06-21]
hw/alpha/CAD/solidworks/psfw8s-2stlf.SLDPRT
14.4 x 4.50 x 5.30 mm
