Global-Health-Labs/nPOC-BB/hw/gamma/CAD/solidworks/GHL-1-20024.SLDPRT

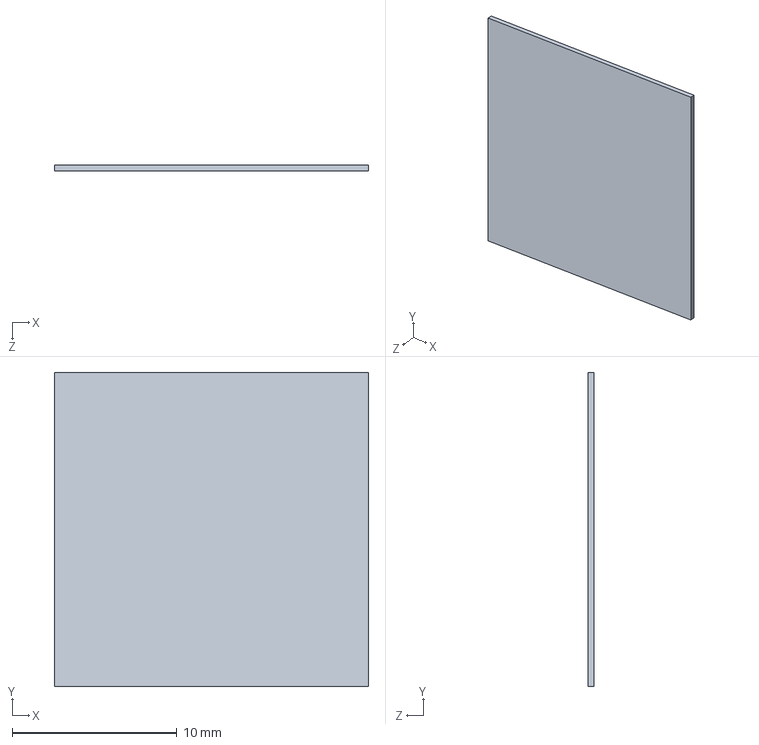
[picture p107: CAD file, 2025-06-21]
hw/gamma/CAD/solidworks/GHL-1-20024.SLDPRT
19.1 x 19.1 x 0.381 mm
