Global-Health-Labs/nPOC-BB/hw/alpha/CAD/derived/GHL-1-20003.STEP

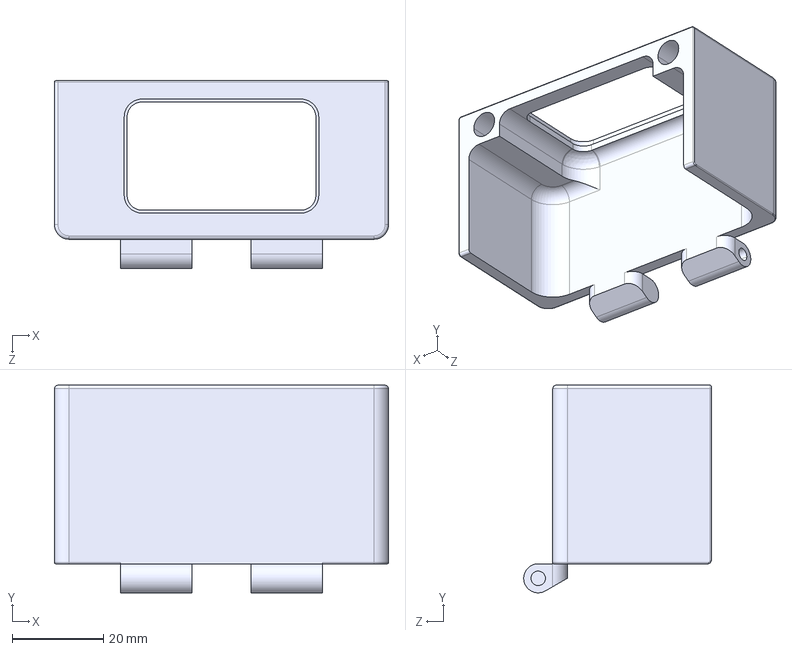
[picture p108: CAD file, 2025-06-21]
hw/alpha/CAD/derived/GHL-1-20003.STEP
73.0 x 45.4 x 41.0 mm
