Global-Health-Labs/nPOC-BB/hw/alpha/CAD/derived/GHL-1-20004.STEP

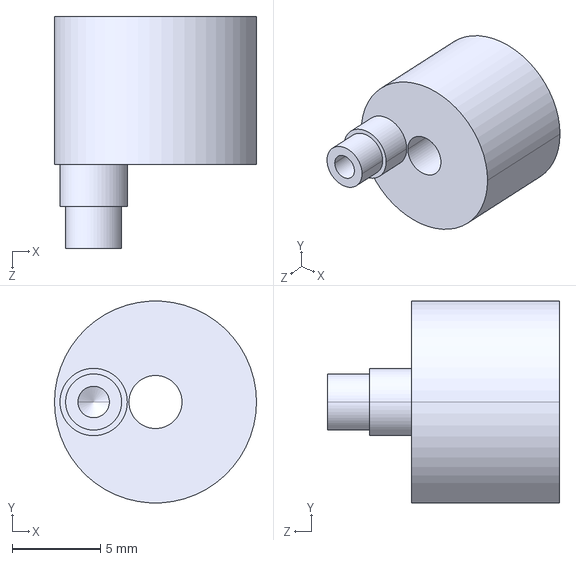
[picture p109: CAD file, 2025-06-21]
hw/alpha/CAD/derived/GHL-1-20004.STEP
11.4 x 11.4 x 13.2 mm
