Global-Health-Labs/nPOC-BB/hw/alpha/CAD/derived/GHL-1-20001.STEP

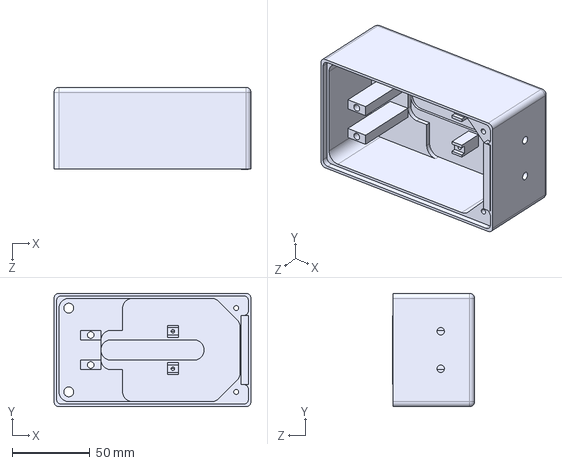
[picture p110: CAD file, 2025-06-21]
hw/alpha/CAD/derived/GHL-1-20001.STEP
127.0 x 73.0 x 53.0 mm
