Global-Health-Labs/nPOC-BB/hw/gamma/CAD/solidworks/GHL-1-20010.SLDPRT

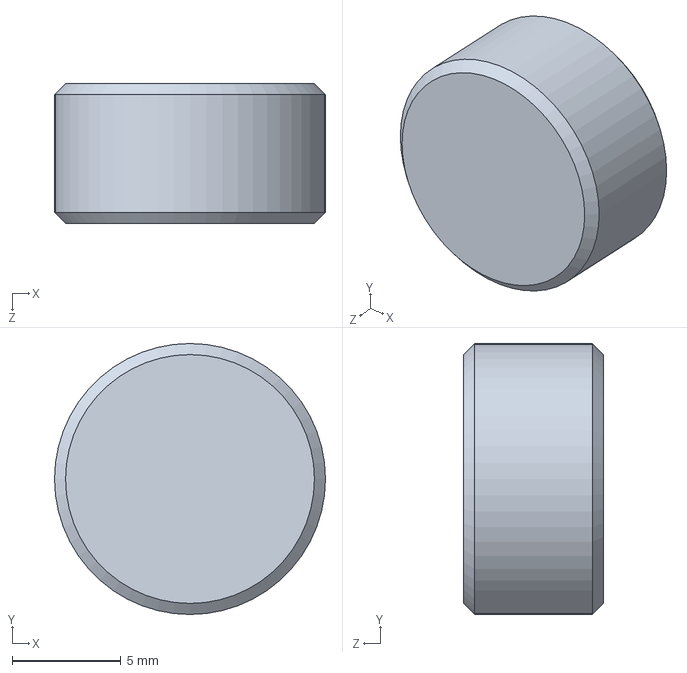
[picture p111: CAD file, 2025-06-21]
hw/gamma/CAD/solidworks/GHL-1-20010.SLDPRT
12.4 x 12.4 x 6.43 mm
