Global-Health-Labs/nPOC-BB/hw/alpha/CAD/derived/GHL-1-20002.STEP

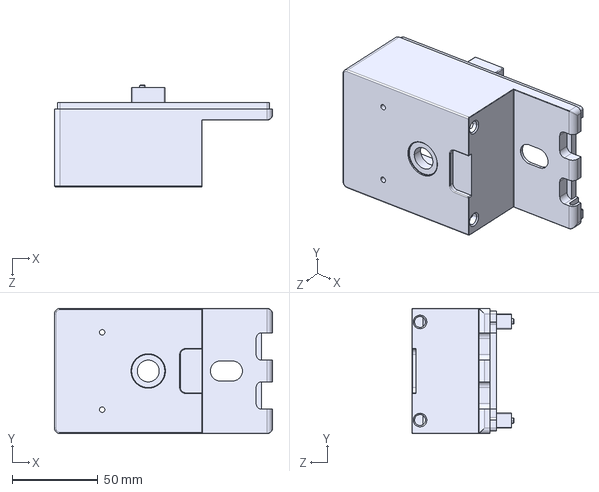
[picture p112: CAD file, 2025-06-21]
hw/alpha/CAD/derived/GHL-1-20002.STEP
127.0 x 73.0 x 59.6 mm
