Global-Health-Labs/nPOC-BB/hw/alpha/CAD/solidworks/NMB BKL7.SLDPRT

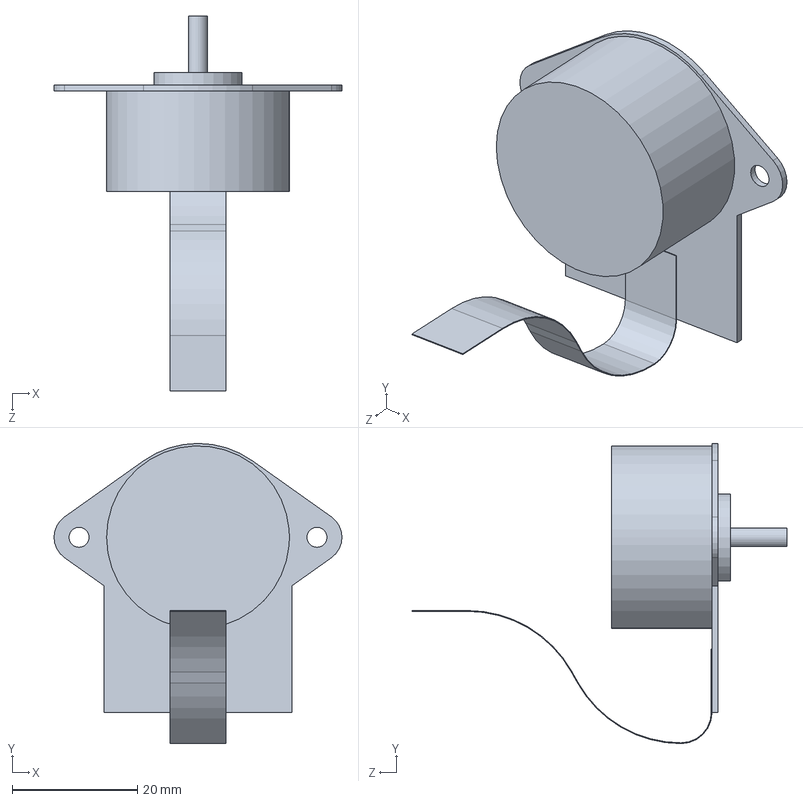
[picture p113: CAD file, 2025-06-21]
hw/alpha/CAD/solidworks/NMB BKL7.SLDPRT
46.0 x 48.0 x 59.9 mm
