Global-Health-Labs/nPOC-BB/hw/alpha/CAD/solidworks/Small Heater PCA.SLDPRT

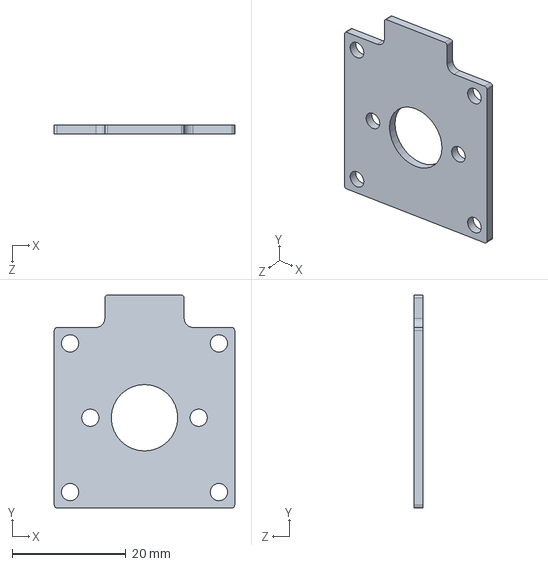
[picture p114: CAD file, 2025-06-21]
hw/alpha/CAD/solidworks/Small Heater PCA.SLDPRT
31.8 x 37.5 x 1.59 mm
