Global-Health-Labs/nPOC-BB/hw/beta/CAD/solidworks/GHL-1-20025.SLDPRT

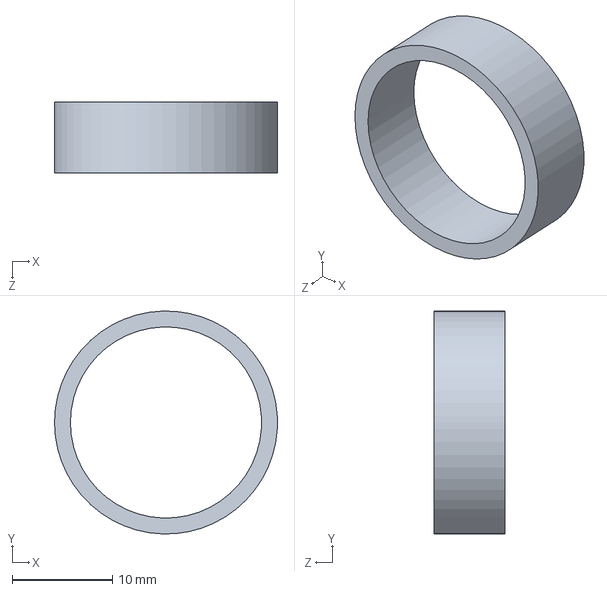
[picture p115: CAD file, 2025-06-21]
hw/beta/CAD/solidworks/GHL-1-20025.SLDPRT
22.2 x 22.2 x 7.11 mm
