Global-Health-Labs/nPOC-BB/hw/alpha/CAD/solidworks/Sanyo NCR18650GA 3500mAh 10A.SLDPRT

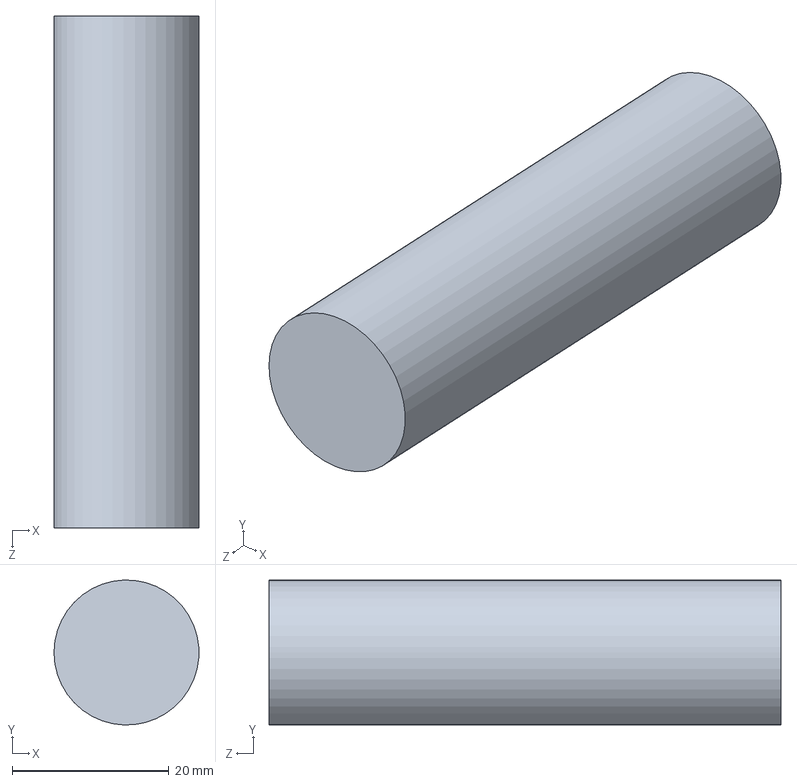
[picture p116: CAD file, 2025-06-21]
hw/alpha/CAD/solidworks/Sanyo NCR18650GA 3500mAh 10A.SLDPRT
18.5 x 18.5 x 65.3 mm
