Global-Health-Labs/nPOC-BB/hw/alpha/CAD/solidworks/Sample Prep PCA.SLDPRT

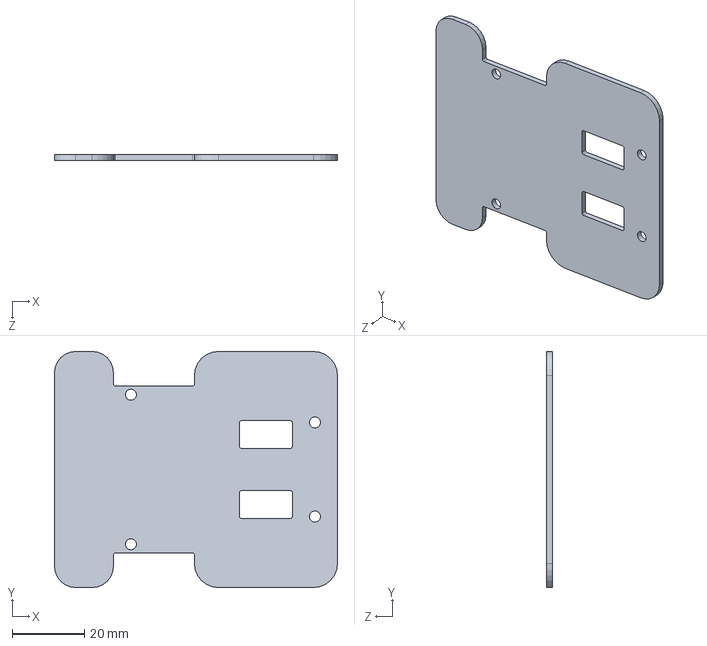
[picture p117: CAD file, 2025-06-21]
hw/alpha/CAD/solidworks/Sample Prep PCA.SLDPRT
78.1 x 65.2 x 1.59 mm
