Global-Health-Labs/nPOC-BB/hw/beta/CAD/solidworks/molicel-p45b.SLDPRT

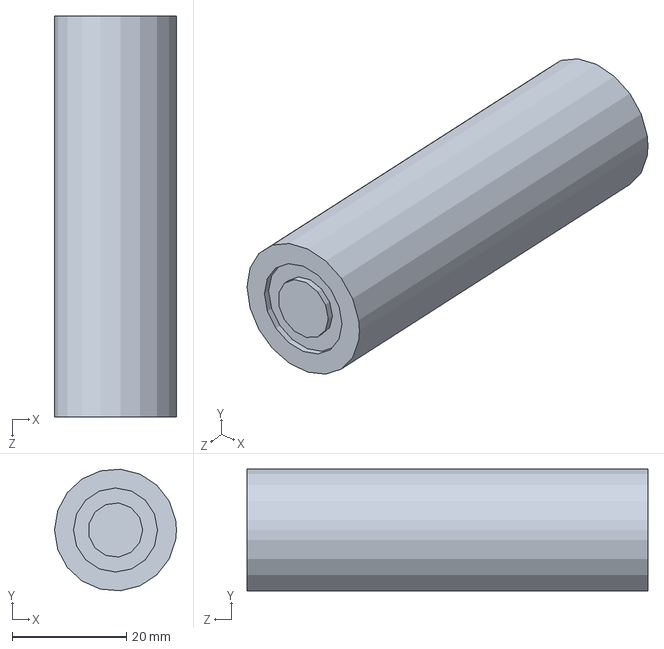
[picture p118: CAD file, 2025-06-21]
hw/beta/CAD/solidworks/molicel-p45b.SLDPRT
21.4 x 21.3 x 70.2 mm
