Global-Health-Labs/nPOC-BB/hw/beta/CAD/solidworks/GHL-1-20014.SLDPRT

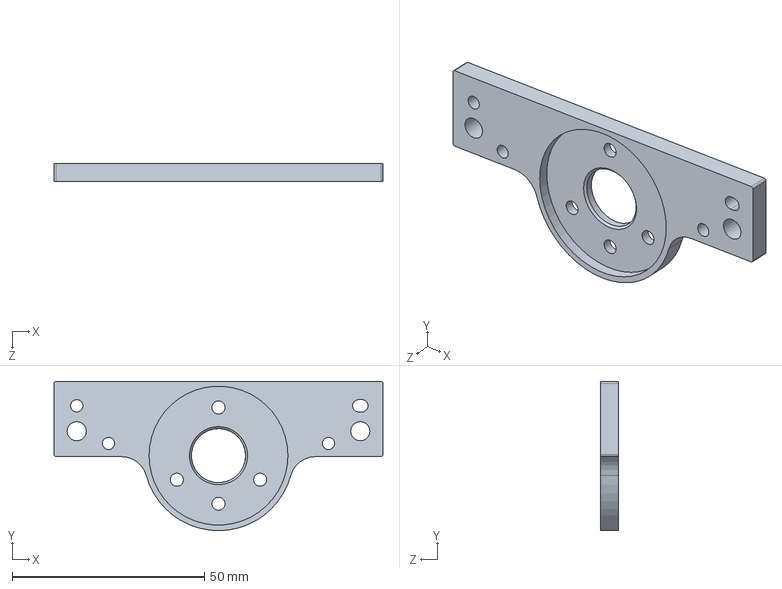
[picture p119: CAD file, 2025-06-21]
hw/beta/CAD/solidworks/GHL-1-20014.SLDPRT
85.5 x 38.8 x 4.76 mm
