Global-Health-Labs/nPOC-BB/hw/gamma/CAD/solidworks/GHL-1-20004.SLDPRT

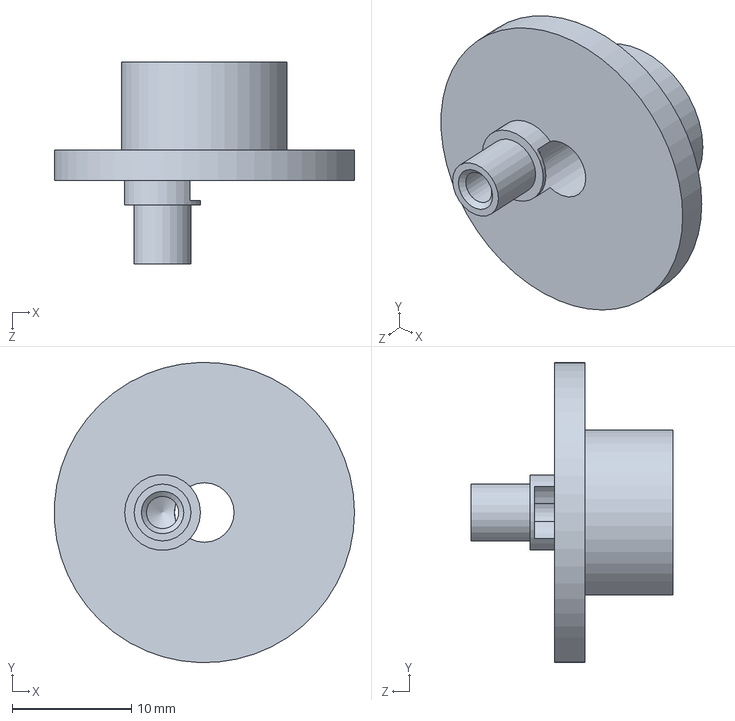
[picture p120: CAD file, 2025-06-21]
hw/gamma/CAD/solidworks/GHL-1-20004.SLDPRT
25.1 x 25.1 x 16.9 mm
