Global-Health-Labs/nPOC-BB/hw/beta/CAD/solidworks/A06ZR06ZR28H51A.SLDPRT

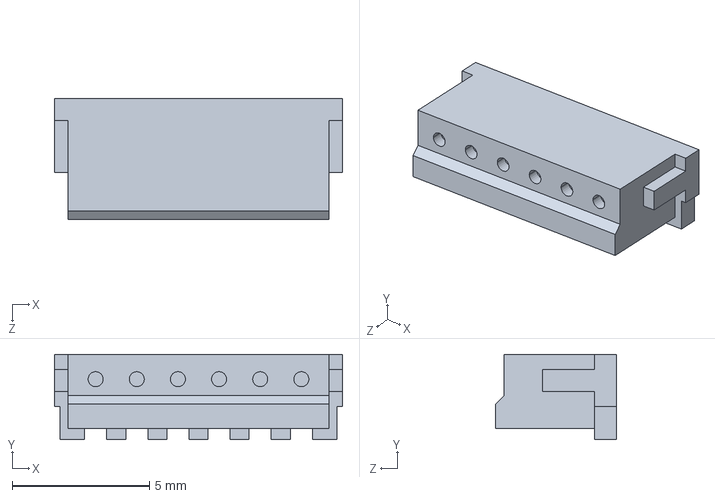
[picture p121: CAD file, 2025-06-21]
hw/beta/CAD/solidworks/A06ZR06ZR28H51A.SLDPRT
10.5 x 3.10 x 4.40 mm
