Global-Health-Labs/nPOC-BB/hw/alpha/CAD/solidworks/purple top big ellipsoid squeeze bottle #6.SLDPRT

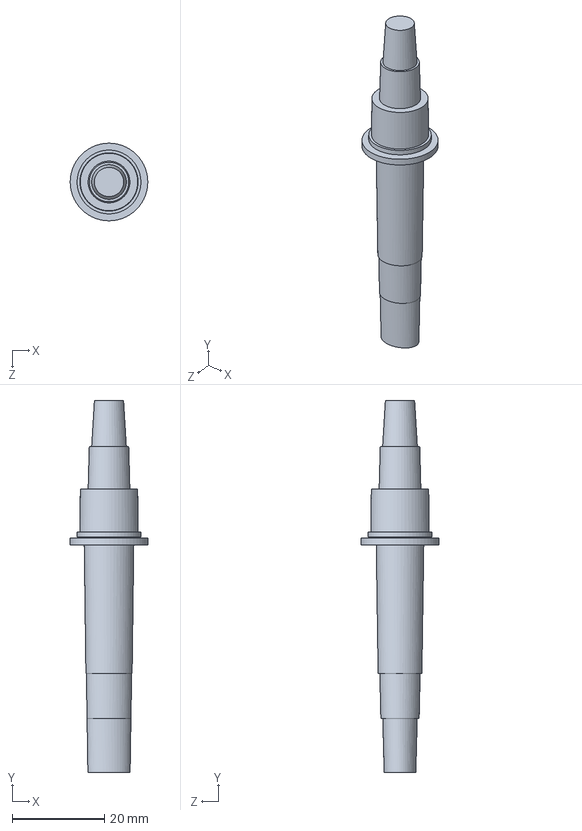
[picture p122: CAD file, 2025-06-21]
hw/alpha/CAD/solidworks/purple top big ellipsoid squeeze bottle #6.SLDPRT
16.8 x 80.7 x 16.8 mm
