Global-Health-Labs/nPOC-BB/hw/beta/CAD/solidworks/GHL-1-20007.SLDPRT

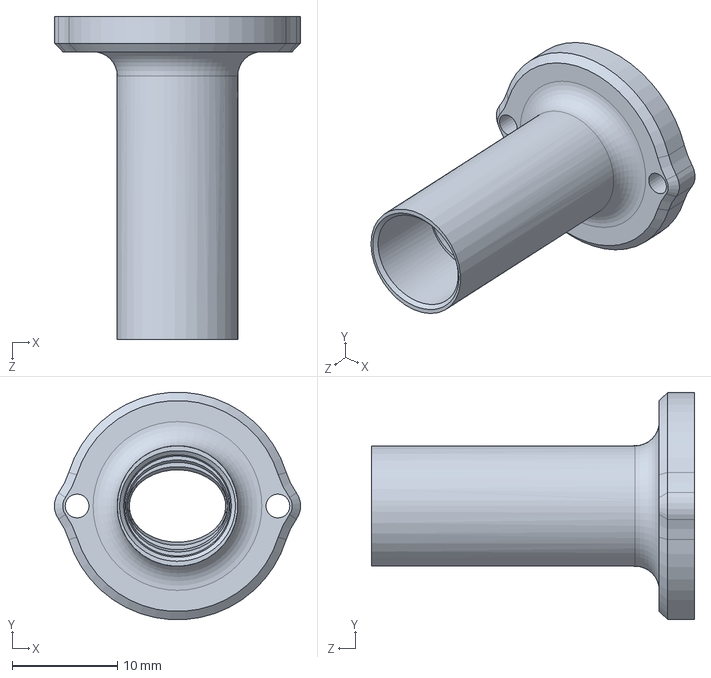
[picture p123: CAD file, 2025-06-21]
hw/beta/CAD/solidworks/GHL-1-20007.SLDPRT
23.3 x 21.5 x 30.7 mm
