Global-Health-Labs/nPOC-BB/hw/beta/CAD/solidworks/GHL-1-20026.SLDPRT

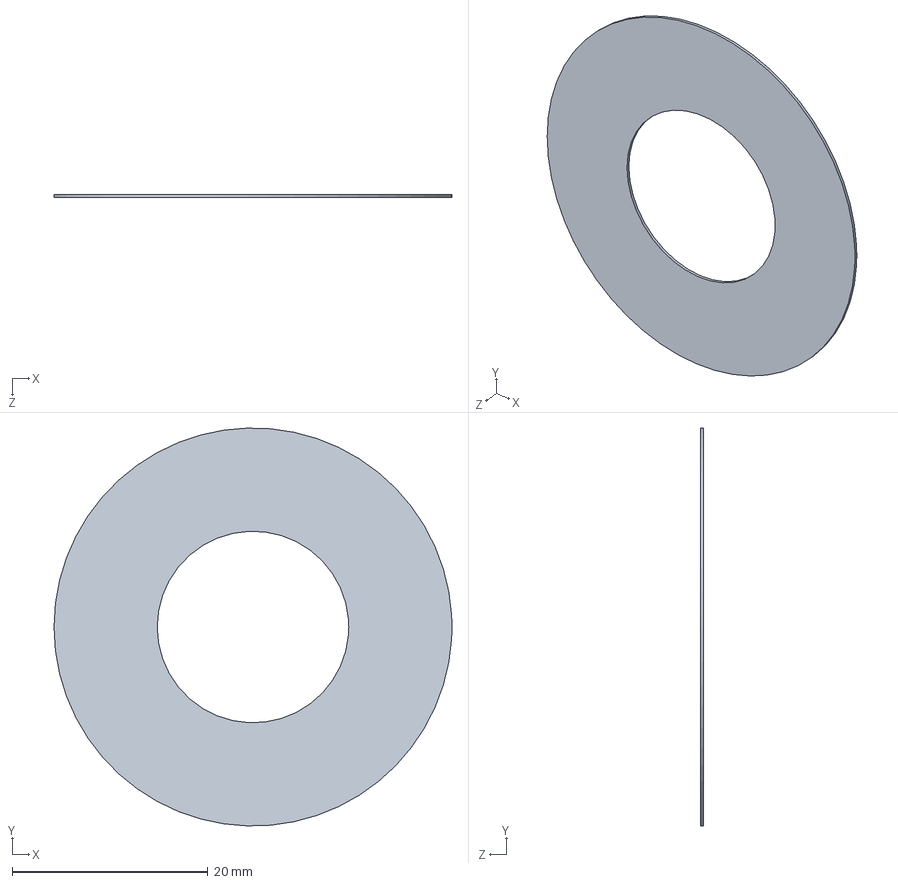
[picture p124: CAD file, 2025-06-21]
hw/beta/CAD/solidworks/GHL-1-20026.SLDPRT
40.6 x 40.6 x 0.317 mm
