Global-Health-Labs/nPOC-BB/hw/beta/CAD/solidworks/PRK22J5DBBNN.SLDPRT

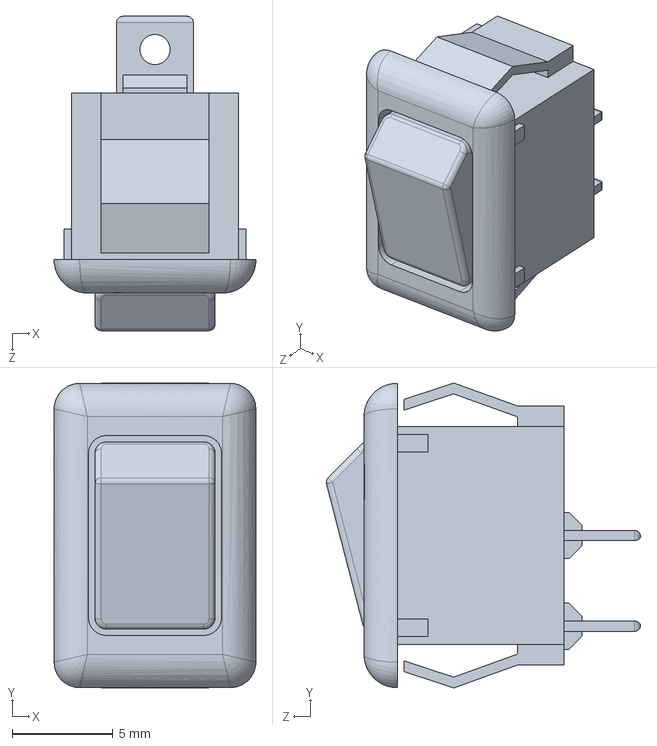
[picture p125: CAD file, 2025-06-21]
hw/beta/CAD/solidworks/PRK22J5DBBNN.SLDPRT
10.0 x 15.1 x 15.6 mm
