Global-Health-Labs/nPOC-BB/hw/beta/CAD/solidworks/GHL-1-20029.SLDPRT

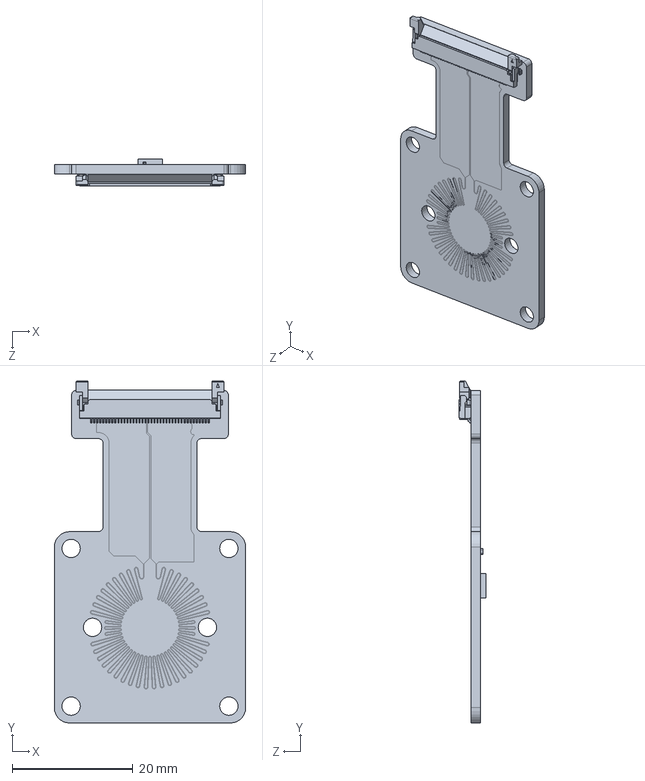
[picture p126: CAD file, 2025-06-21]
hw/beta/CAD/solidworks/GHL-1-20029.SLDPRT
31.8 x 56.7 x 4.52 mm
