Global-Health-Labs/nPOC-BB/hw/alpha/CAD/solidworks/TSYS01.SLDPRT

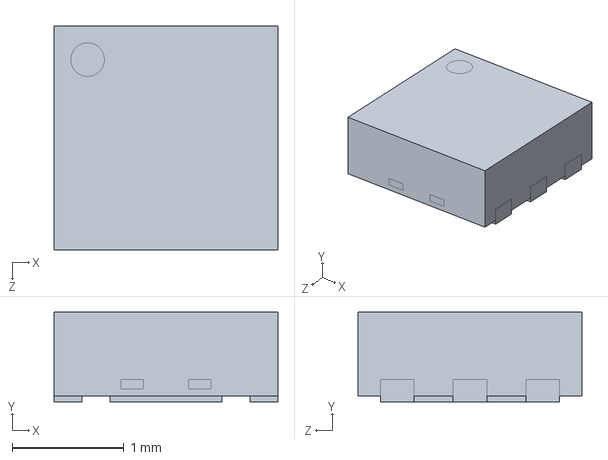
[picture p127: CAD file, 2025-06-21]
hw/alpha/CAD/solidworks/TSYS01.SLDPRT
2.00 x 0.8 x 2.00 mm
