Global-Health-Labs/nPOC-BB/hw/gamma/CAD/solidworks/D44.SLDPRT

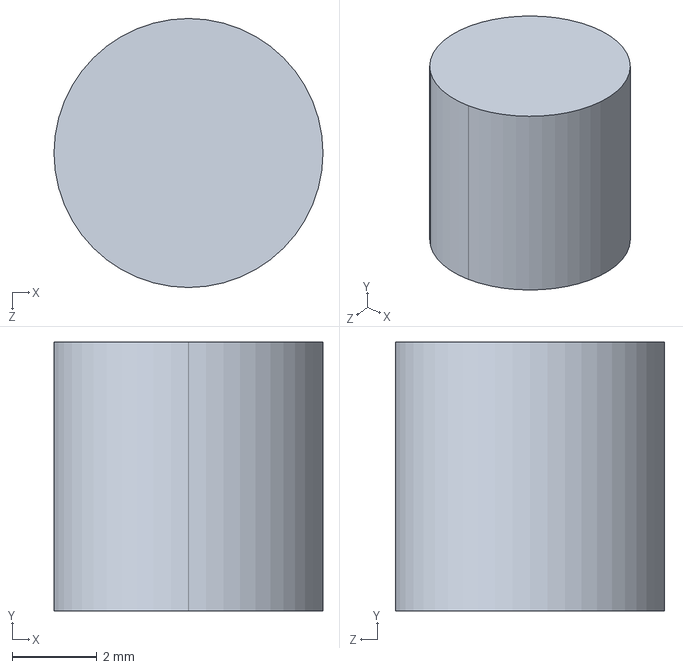
[picture p128: CAD file, 2025-06-21]
hw/gamma/CAD/solidworks/D44.SLDPRT
6.35 x 6.35 x 6.35 mm
