Global-Health-Labs/nPOC-BB/hw/beta/CAD/solidworks/GHL-1-20015.SLDPRT

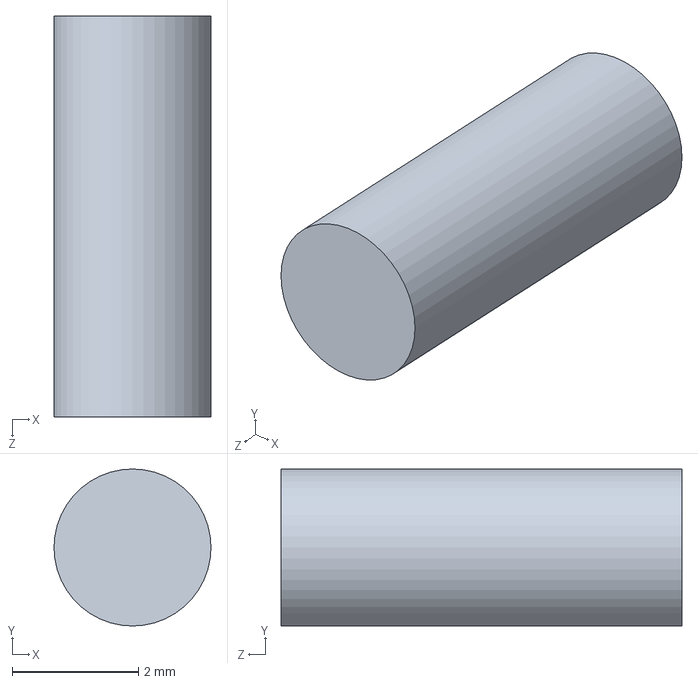
[picture p129: CAD file, 2025-06-21]
hw/beta/CAD/solidworks/GHL-1-20015.SLDPRT
2.49 x 2.49 x 6.35 mm
