Global-Health-Labs/nPOC-BB/hw/gamma/CAD/solidworks/GHL-1-20022.SLDPRT

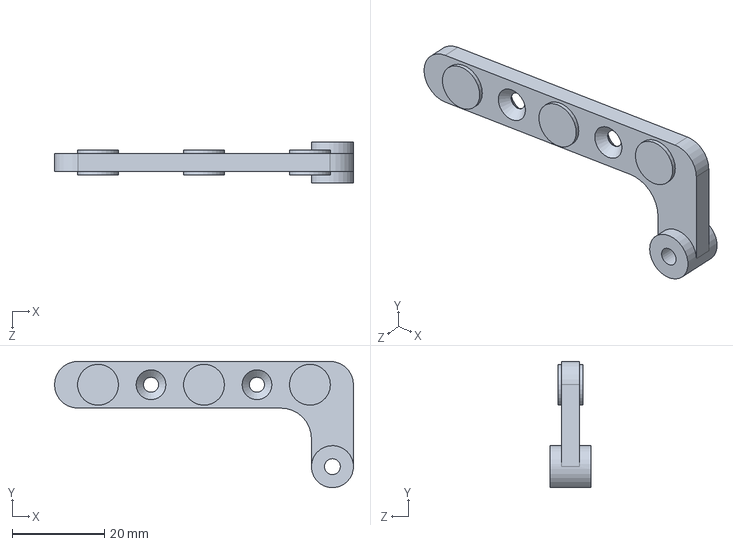
[picture p130: CAD file, 2025-06-21]
hw/gamma/CAD/solidworks/GHL-1-20022.SLDPRT
64.9 x 27.4 x 8.89 mm
