Global-Health-Labs/nPOC-BB/hw/beta/CAD/solidworks/GHL-1-20027.SLDPRT

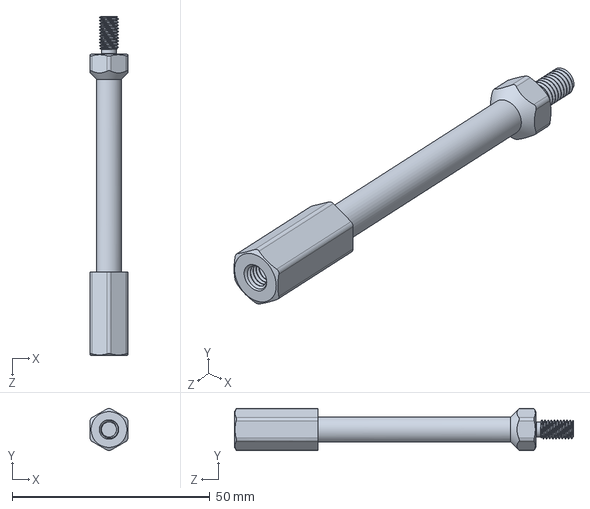
[picture p131: CAD file, 2025-06-21]
hw/beta/CAD/solidworks/GHL-1-20027.SLDPRT
9.53 x 10.7 x 85.7 mm
