Global-Health-Labs/nPOC-BB/hw/gamma/CAD/solidworks/GHL-1-20020.SLDPRT

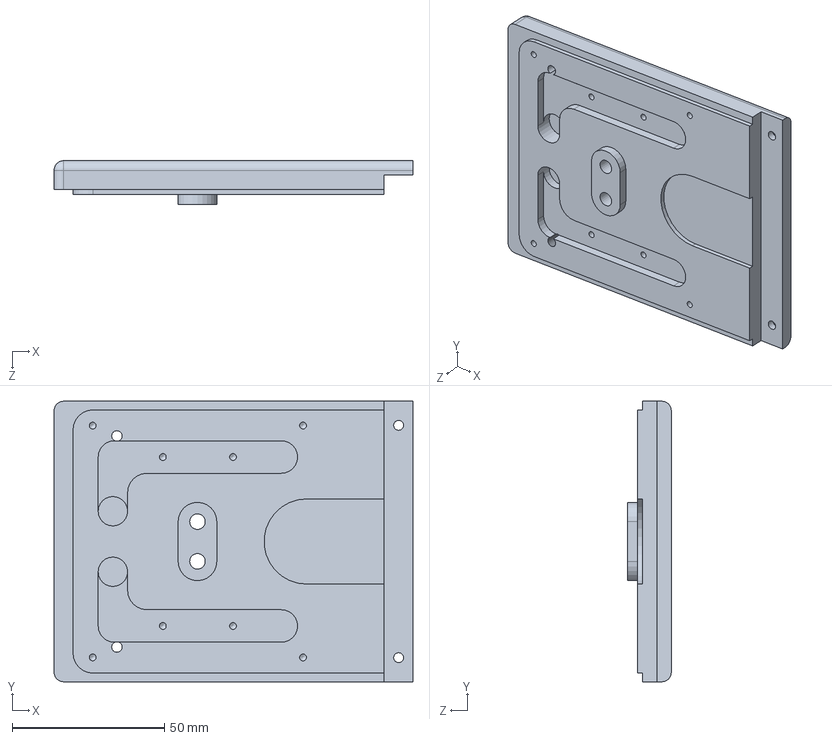
[picture p132: CAD file, 2025-06-21]
hw/gamma/CAD/solidworks/GHL-1-20020.SLDPRT
117.7 x 92.1 x 14.4 mm
