Global-Health-Labs/nPOC-BB/hw/alpha/CAD/solidworks/3625BL-24.SLDPRT

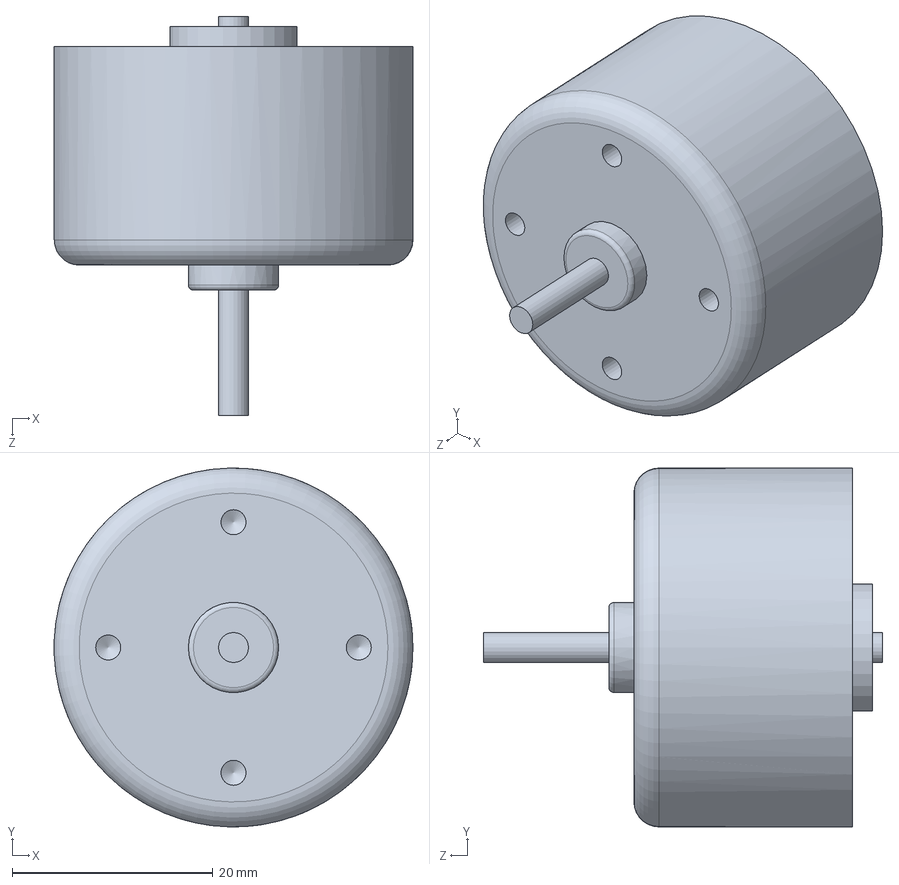
[picture p133: CAD file, 2025-06-21]
hw/alpha/CAD/solidworks/3625BL-24.SLDPRT
35.8 x 35.8 x 39.8 mm
