Global-Health-Labs/nPOC-BB/hw/gamma/CAD/solidworks/GHL-1-20023.SLDPRT

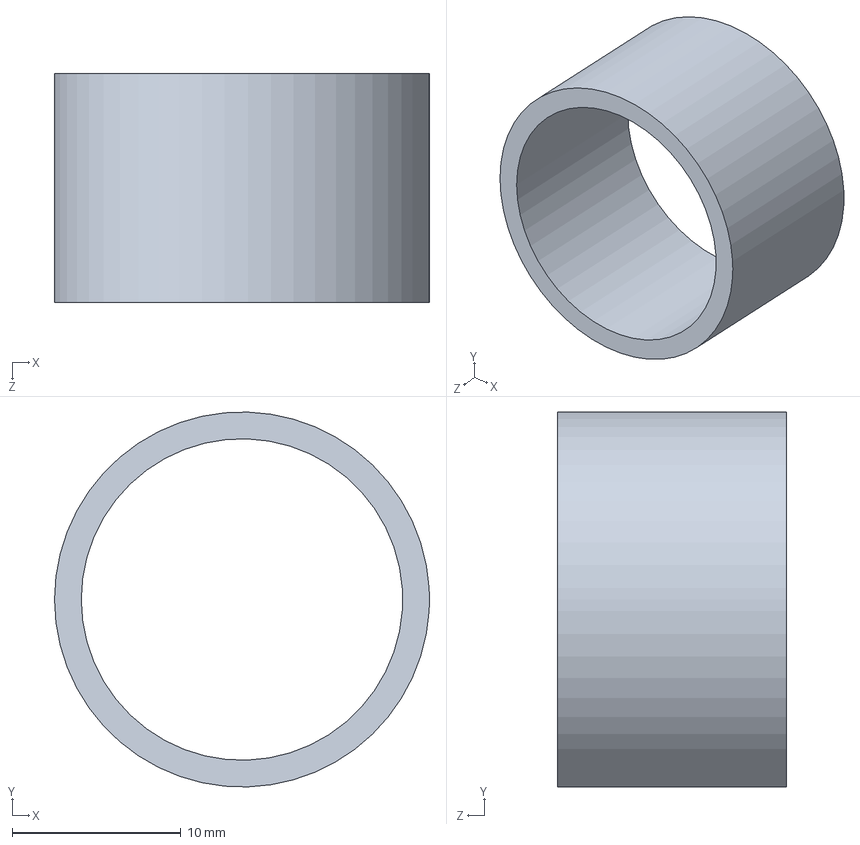
[picture p134: CAD file, 2025-06-21]
hw/gamma/CAD/solidworks/GHL-1-20023.SLDPRT
22.2 x 22.2 x 13.6 mm
