Global-Health-Labs/nPOC-BB/hw/alpha/CAD/solidworks/PTS645SM43SMTR92 LFS.SLDPRT

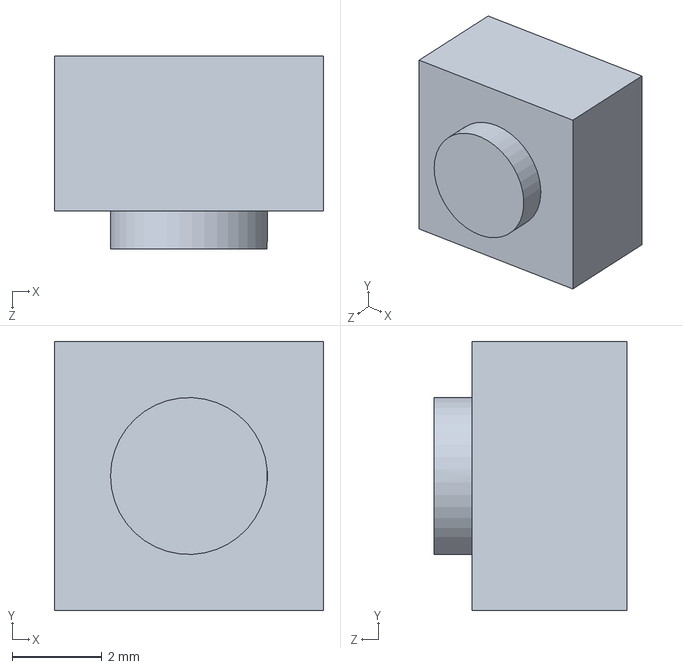
[picture p135: CAD file, 2025-06-21]
hw/alpha/CAD/solidworks/PTS645SM43SMTR92 LFS.SLDPRT
6.00 x 6.00 x 4.30 mm
