Global-Health-Labs/nPOC-BB/hw/gamma/CAD/solidworks/GHL-1-20009.SLDPRT

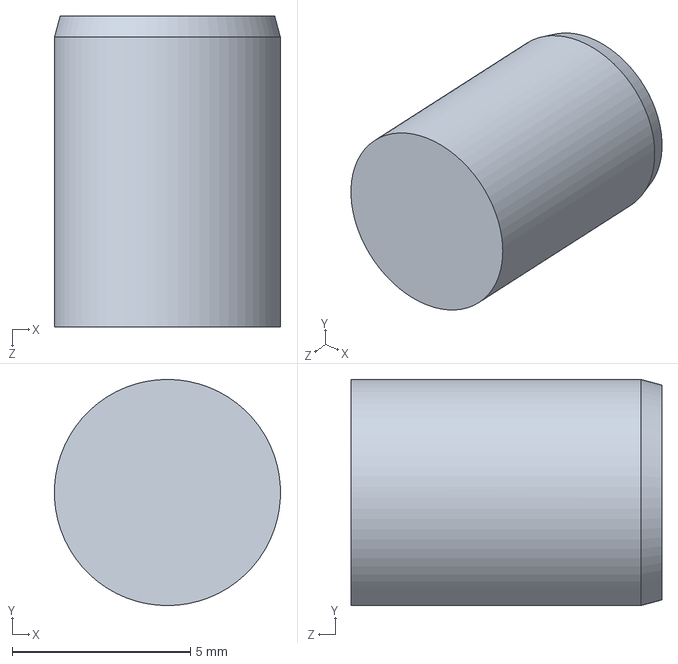
[picture p136: CAD file, 2025-06-21]
hw/gamma/CAD/solidworks/GHL-1-20009.SLDPRT
6.35 x 6.35 x 8.73 mm
