Global-Health-Labs/nPOC-BB/hw/beta/CAD/solidworks/GHL-1-22001.SLDASM

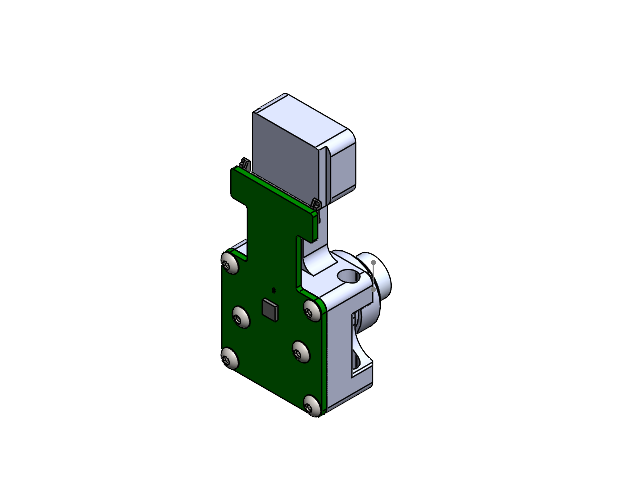
[picture p137: CAD file, 2025-06-21]
hw/beta/CAD/solidworks/GHL-1-22001.SLDASM
GHL-1-20005
GHL-1-20007
92949A105 x 6
GHL-1-20029
