Global-Health-Labs/nPOC-BB/hw/gamma/CAD/solidworks/GHL-1-22004.SLDASM

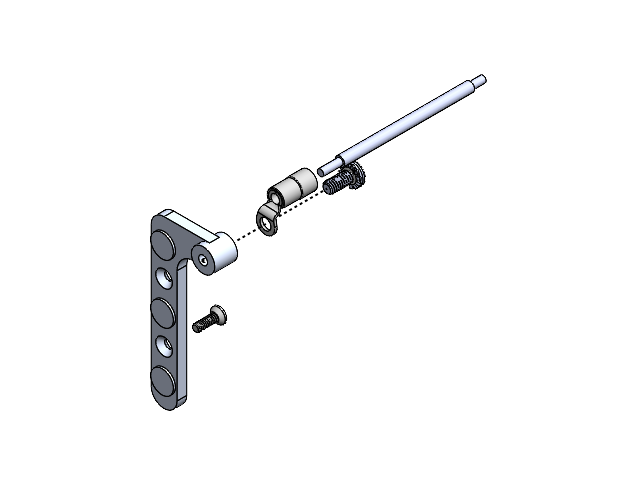
[picture p138: CAD file, 2025-06-21]
hw/gamma/CAD/solidworks/GHL-1-22004.SLDASM
GHL-1-20022
7113K219
8054T19
95345A530
92210A108 x 2
