Global-Health-Labs/nPOC-BB/hw/beta/CAD/solidworks/GHL-1-22002.SLDASM

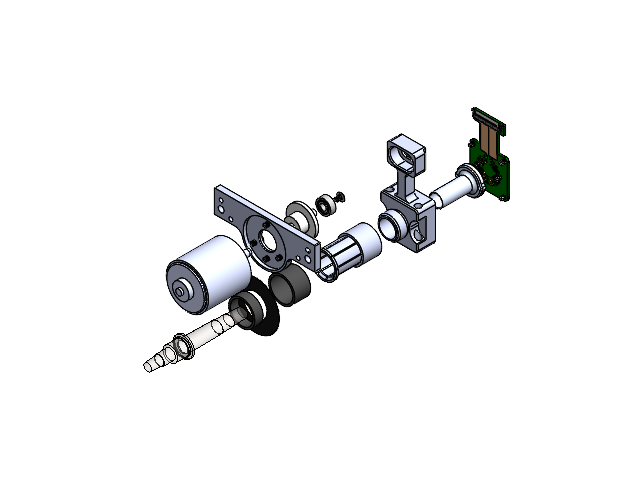
[picture p139: CAD file, 2025-06-21]
hw/beta/CAD/solidworks/GHL-1-22002.SLDASM
GHL-1-20004
GHL-1-20005
GHL-1-20007
92949A105 x 6
GHL-1-20029
57155K374
92949A143
KJ7025-3ML
DIX36B
GHL-1-20018
GHL-1-20023
GHL-1-20025
GHL-1-20026
GHL-1-20014
91292A110 x 4
