Global-Health-Labs/nPOC-BB/hw/gamma/CAD/solidworks/GHL-1-22003.SLDASM

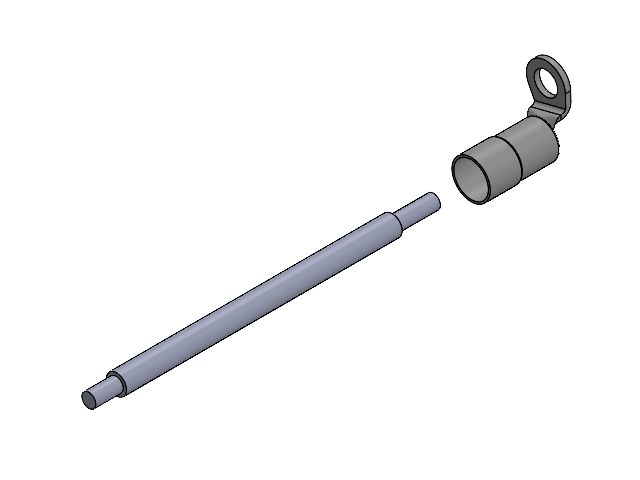
[picture p140: CAD file, 2025-06-21]
hw/gamma/CAD/solidworks/GHL-1-22003.SLDASM
7113K219
8054T19
