Global-Health-Labs/nPOC-BB/hw/alpha/CAD/solidworks/Heater PCA.SLDASM

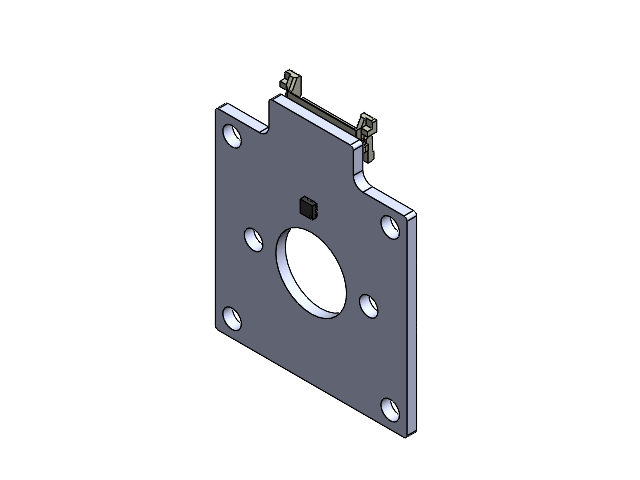
[picture p141: CAD file, 2025-06-21]
hw/alpha/CAD/solidworks/Heater PCA.SLDASM
FH12A-20S-0.5SH
TSYS01
Small Heater PCA
