Global-Health-Labs/nPOC-BB/hw/alpha/CAD/solidworks/SP Main PCA.SLDASM

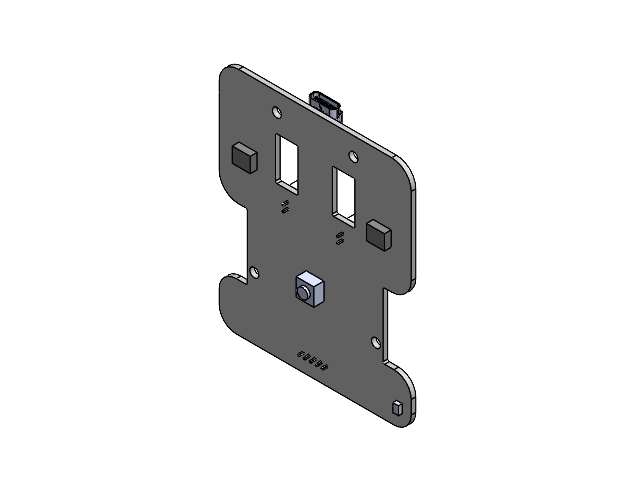
[picture p142: CAD file, 2025-06-21]
hw/alpha/CAD/solidworks/SP Main PCA.SLDASM
Sample Prep PCA
SI7201-B-06
DX07S024XJ1R1100--3DModel-STEP-1
B2B-PH-K-S x 2
FH12A-20S-0.5SH
PTS645SM43SMTR92 LFS
B5B-PH-K-S(LF)(SN)
