Global-Health-Labs/nPOC-BB/(list of files, cad)

Other CAD files:
hw/alpha/CAD/solidworks/U1.SLDASM
hw/alpha/CAD/solidworks/0402.SLDASM
hw/alpha/CAD/solidworks/J1.SLDASM
hw/alpha/CAD/solidworks/GHL-1-22001.SLDASM
hw/alpha/CAD/solidworks/C1.SLDASM
hw/alpha/CAD/solidworks/BATTERY HOLDER x2(2).SLDASM
hw/alpha/CAD/solidworks/FH12A-20S-0.5SH_RGB8421504.SLDASM
hw/alpha/CAD/derived/GHL-1-20008.STEP
hw/alpha/CAD/solidworks/GHL-1-20007.SLDPRT
hw/alpha/CAD/solidworks/______2.SLDPRT
hw/beta/CAD/solidworks/GHL-1-20012.SLDPRT
hw/alpha/CAD/derived/GHL-1-20014.STEP
hw/alpha/CAD/solidworks/B5B-PH-K-S(LF)(SN).SLDPRT
hw/gamma/CAD/solidworks/GHL-1-20012.SLDPRT
hw/alpha/CAD/solidworks/GHL-1-20003.SLDPRT
hw/beta/CAD/solidworks/GHL-1-20013.SLDPRT
hw/alpha/CAD/solidworks/GHL-1-20001.SLDPRT
hw/alpha/CAD/solidworks/Contacto_Helice_v2.0.SLDPRT
hw/alpha/CAD/solidworks/GHL-1-20009.SLDPRT
hw/alpha/CAD/solidworks/GHL-1-20011.SLDPRT
hw/alpha/CAD/solidworks/Extruded.SLDPRT
hw/alpha/CAD/solidworks/GHL-1-20012.SLDPRT
hw/alpha/CAD/solidworks/remache_v1.0.SLDPRT
hw/alpha/CAD/solidworks/GHL-1-20008.SLDPRT
hw/alpha/CAD/solidworks/SP Label.SLDPRT
hw/gamma/CAD/solidworks/KJ7025-3ML.SLDPRT
hw/alpha/CAD/solidworks/FH12A-20S-0.5SH.SLDPRT
hw/alpha/CAD/solidworks/GHL-1-20002.SLDPRT
hw/alpha/CAD/solidworks/GHL-1-20010.SLDPRT
hw/alpha/CAD/solidworks/D44.SLDPRT
hw/beta/CAD/solidworks/KJ7025-3ML.SLDPRT
hw/gamma/CAD/solidworks/GHL-1-20013.SLDPRT
hw/alpha/CAD/solidworks/GHL-1-20006.SLDPRT
hw/alpha/CAD/solidworks/Contacto_plano_v1.0.SLDPRT
hw/alpha/CAD/solidworks/______1.SLDPRT
hw/alpha/CAD/solidworks/Porta baterias 2x18650.SLDPRT
hw/alpha/CAD/solidworks/0151660215.SLDPRT
hw/alpha/CAD/solidworks/57155K346.SLDPRT
hw/alpha/CAD/solidworks/6181182224.SLDPRT
hw/alpha/CAD/solidworks/6495828208.SLDASM
hw/alpha/CAD/solidworks/90145A483.SLDPRT
hw/alpha/CAD/solidworks/91292A110.SLDPRT
hw/alpha/CAD/solidworks/92196A108.SLDPRT
hw/alpha/CAD/solidworks/92196A215.SLDPRT
hw/alpha/CAD/solidworks/92196A241.SLDPRT
hw/alpha/CAD/solidworks/92210A418.SLDPRT
hw/alpha/CAD/solidworks/92949A074.SLDPRT
hw/alpha/CAD/solidworks/92949A105.SLDPRT
hw/alpha/CAD/solidworks/92949A106.SLDPRT
hw/alpha/CAD/solidworks/9305K114.SLDPRT
hw/alpha/CAD/solidworks/B18650-2.SLDASM
hw/alpha/CAD/solidworks/FH12A-20S-0.5SH_________.SLDPRT
hw/alpha/CAD/solidworks/GHL-1-20001.SLDDRW
hw/alpha/CAD/solidworks/GHL-1-20002.SLDDRW
hw/alpha/CAD/solidworks/GHL-1-20003.SLDDRW
hw/alpha/CAD/solidworks/GHL-1-20004.SLDDRW
hw/alpha/CAD/solidworks/GHL-1-20005.SLDDRW
hw/alpha/CAD/solidworks/GHL-1-20006.SLDDRW
hw/alpha/CAD/solidworks/GHL-1-20007.SLDDRW
hw/alpha/CAD/solidworks/GHL-1-20008.SLDDRW
hw/alpha/CAD/solidworks/GHL-1-20009.SLDDRW
hw/alpha/CAD/solidworks/GHL-1-20010.SLDDRW
hw/alpha/CAD/solidworks/GHL-1-20011.SLDDRW
hw/alpha/CAD/solidworks/GHL-1-20012.SLDDRW
hw/alpha/CAD/solidworks/GHL-1-20013.SLDDRW
hw/alpha/CAD/solidworks/GHL-1-20014.SLDDRW
hw/beta/CAD/solidworks/151660436.SLDPRT
hw/beta/CAD/solidworks/53535A11.SLDPRT
hw/beta/CAD/solidworks/57155K374.SLDPRT
hw/beta/CAD/solidworks/7113K219.SLDPRT
hw/beta/CAD/solidworks/77595A33.SLDPRT
hw/beta/CAD/solidworks/8054T19.SLDPRT
hw/beta/CAD/solidworks/8969T108.SLDPRT
hw/beta/CAD/solidworks/90145A483.SLDPRT
hw/beta/CAD/solidworks/90295A420.SLDPRT
hw/beta/CAD/solidworks/91292A110.SLDPRT
hw/beta/CAD/solidworks/92196A106.SLDPRT
hw/beta/CAD/solidworks/92196A118.SLDPRT
hw/beta/CAD/solidworks/92196A215.SLDPRT
hw/beta/CAD/solidworks/92196A242.SLDPRT
hw/beta/CAD/solidworks/92196A273.SLDPRT
hw/beta/CAD/solidworks/92210A108.SLDPRT
hw/beta/CAD/solidworks/92949A103.SLDPRT
hw/beta/CAD/solidworks/92949A105.SLDPRT
hw/beta/CAD/solidworks/92949A143.SLDPRT
hw/beta/CAD/solidworks/95345A530.SLDPRT
hw/beta/CAD/solidworks/DIX36B.SLDDRW
hw/beta/CAD/solidworks/GHL-1-20001.SLDDRW
hw/beta/CAD/solidworks/GHL-1-20002.SLDDRW
hw/beta/CAD/solidworks/GHL-1-20003.SLDDRW
hw/beta/CAD/solidworks/GHL-1-20004.SLDDRW
hw/beta/CAD/solidworks/GHL-1-20005.SLDDRW
hw/beta/CAD/solidworks/GHL-1-20007.SLDDRW
hw/beta/CAD/solidworks/GHL-1-20008.SLDDRW
hw/beta/CAD/solidworks/GHL-1-20009.SLDDRW
hw/beta/CAD/solidworks/GHL-1-20010.SLDDRW
hw/beta/CAD/solidworks/GHL-1-20011.SLDDRW
hw/beta/CAD/solidworks/GHL-1-20012.SLDDRW
hw/beta/CAD/solidworks/GHL-1-20013.SLDDRW
hw/beta/CAD/solidworks/GHL-1-20014.SLDDRW
hw/beta/CAD/solidworks/GHL-1-20015.SLDDRW
hw/beta/CAD/solidworks/GHL-1-20018.SLDDRW
hw/beta/CAD/solidworks/GHL-1-20020.SLDDRW
hw/beta/CAD/solidworks/GHL-1-20021.SLDDRW
hw/beta/CAD/solidworks/GHL-1-20022.SLDDRW
hw/beta/CAD/solidworks/GHL-1-20023.SLDDRW
hw/beta/CAD/solidworks/GHL-1-20024.SLDDRW
hw/beta/CAD/solidworks/GHL-1-20025.SLDDRW
hw/beta/CAD/solidworks/GHL-1-20026.SLDDRW
hw/beta/CAD/solidworks/GHL-1-20027.SLDDRW
hw/beta/CAD/solidworks/GHL-1-22002.SLDDRW
hw/beta/CAD/solidworks/GHL-1-22003.SLDDRW
hw/gamma/CAD/solidworks/151660436.SLDPRT
hw/gamma/CAD/solidworks/53535A11.SLDPRT
hw/gamma/CAD/solidworks/57155K374.SLDPRT
hw/gamma/CAD/solidworks/7113K219.SLDPRT
hw/gamma/CAD/solidworks/77595A33.SLDPRT
hw/gamma/CAD/solidworks/8054T19.SLDPRT
hw/gamma/CAD/solidworks/8969T108.SLDPRT
hw/gamma/CAD/solidworks/90145A483.SLDPRT
hw/gamma/CAD/solidworks/90295A420.SLDPRT
hw/gamma/CAD/solidworks/91292A110.SLDPRT
hw/gamma/CAD/solidworks/92196A106.SLDPRT
hw/gamma/CAD/solidworks/92196A118.SLDPRT
hw/gamma/CAD/solidworks/92196A215.SLDPRT
hw/gamma/CAD/solidworks/92196A242.SLDPRT
hw/gamma/CAD/solidworks/92196A273.SLDPRT
hw/gamma/CAD/solidworks/92210A108.SLDPRT
hw/gamma/CAD/solidworks/92949A103.SLDPRT
hw/gamma/CAD/solidworks/92949A105.SLDPRT
hw/gamma/CAD/solidworks/92949A143.SLDPRT
hw/gamma/CAD/solidworks/95345A530.SLDPRT
hw/gamma/CAD/solidworks/DIX36B.SLDDRW
hw/gamma/CAD/solidworks/GHL-1-20001.SLDDRW
hw/gamma/CAD/solidworks/GHL-1-20002.SLDDRW
hw/gamma/CAD/solidworks/GHL-1-20003.SLDDRW
hw/gamma/CAD/solidworks/GHL-1-20004.SLDDRW
hw/gamma/CAD/solidworks/GHL-1-20005.SLDDRW
hw/gamma/CAD/solidworks/GHL-1-20007.SLDDRW
hw/gamma/CAD/solidworks/GHL-1-20008.SLDDRW
hw/gamma/CAD/solidworks/GHL-1-20009.SLDDRW
hw/gamma/CAD/solidworks/GHL-1-20010.SLDDRW
hw/gamma/CAD/solidworks/GHL-1-20011.SLDDRW
hw/gamma/CAD/solidworks/GHL-1-20012.SLDDRW
hw/gamma/CAD/solidworks/GHL-1-20013.SLDDRW
hw/gamma/CAD/solidworks/GHL-1-20014.SLDDRW
hw/gamma/CAD/solidworks/GHL-1-20015.SLDDRW
hw/gamma/CAD/solidworks/GHL-1-20018.SLDDRW
hw/gamma/CAD/solidworks/GHL-1-20020.SLDDRW
hw/gamma/CAD/solidworks/GHL-1-20021.SLDDRW
hw/gamma/CAD/solidworks/GHL-1-20022.SLDDRW
hw/gamma/CAD/solidworks/GHL-1-20023.SLDDRW
hw/gamma/CAD/solidworks/GHL-1-20024.SLDDRW
hw/gamma/CAD/solidworks/GHL-1-20025.SLDDRW
hw/gamma/CAD/solidworks/GHL-1-20026.SLDDRW
hw/gamma/CAD/solidworks/GHL-1-20027.SLDDRW
hw/gamma/CAD/solidworks/GHL-1-22002.SLDDRW
hw/gamma/CAD/solidworks/GHL-1-22003.SLDDRW
