Global-Health-Labs/nPOC-BB/hw/beta/ECAD/main-board/derived/PDF/Schematic Prints.PDF

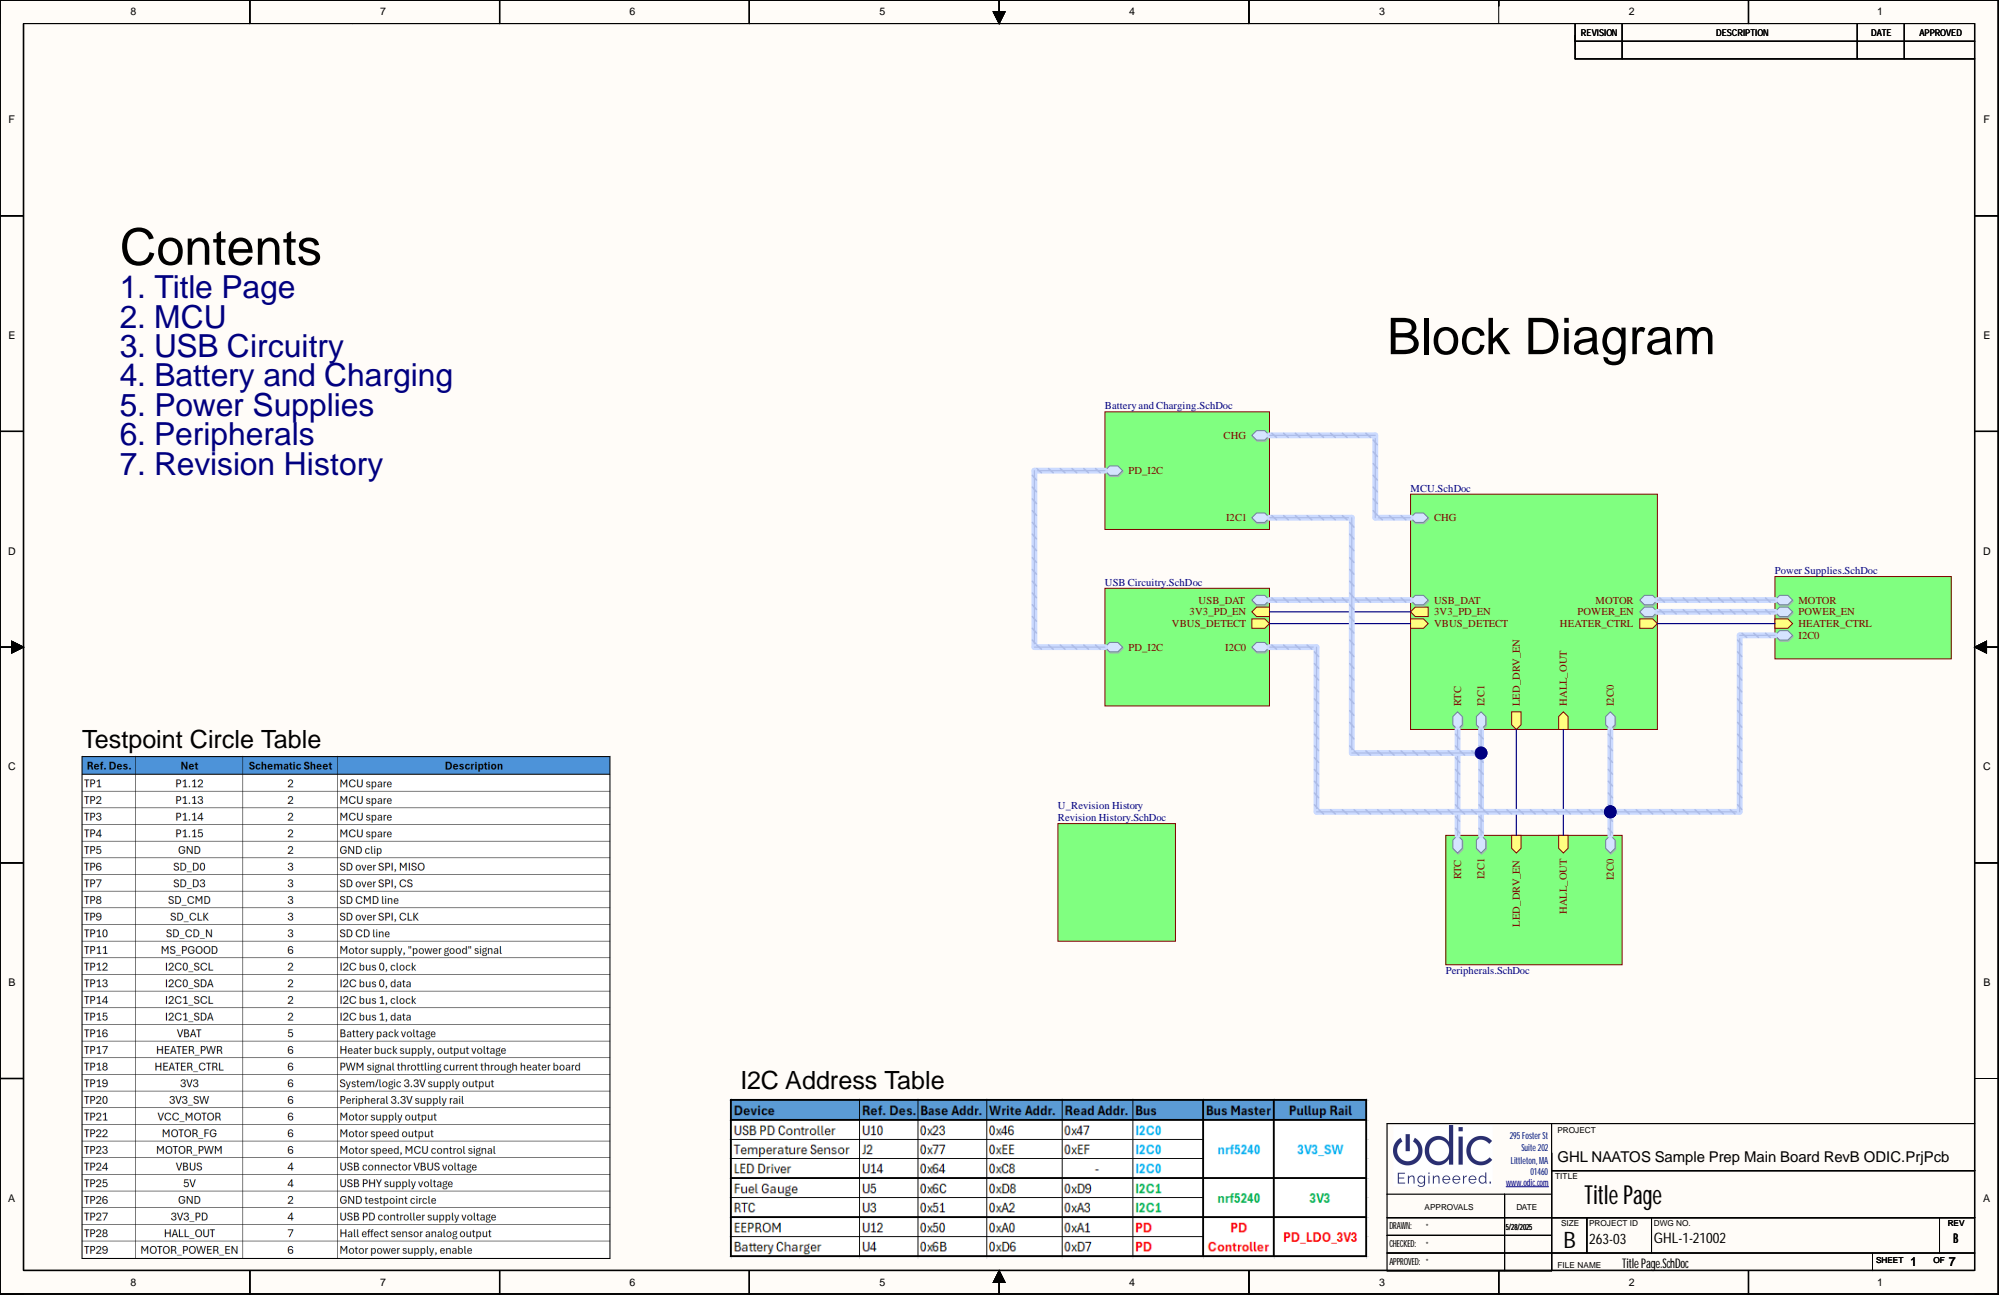
[picture p147: page 1]

Battery and Charging.SchDoc

PROJECT
GHL NAATOS Sample Prep Main Board RevB ODIC.PrjPcb

APPROVALS | DATE
DRAWN: * | | SIZE B | PROJECT ID | DWG NO. GHL-1-21002 | REV

CHECKED:
APPROVED: * | | FILE NAME Title Page.SchDoc | SHEET SHEET 1 1 OF OF 7 7

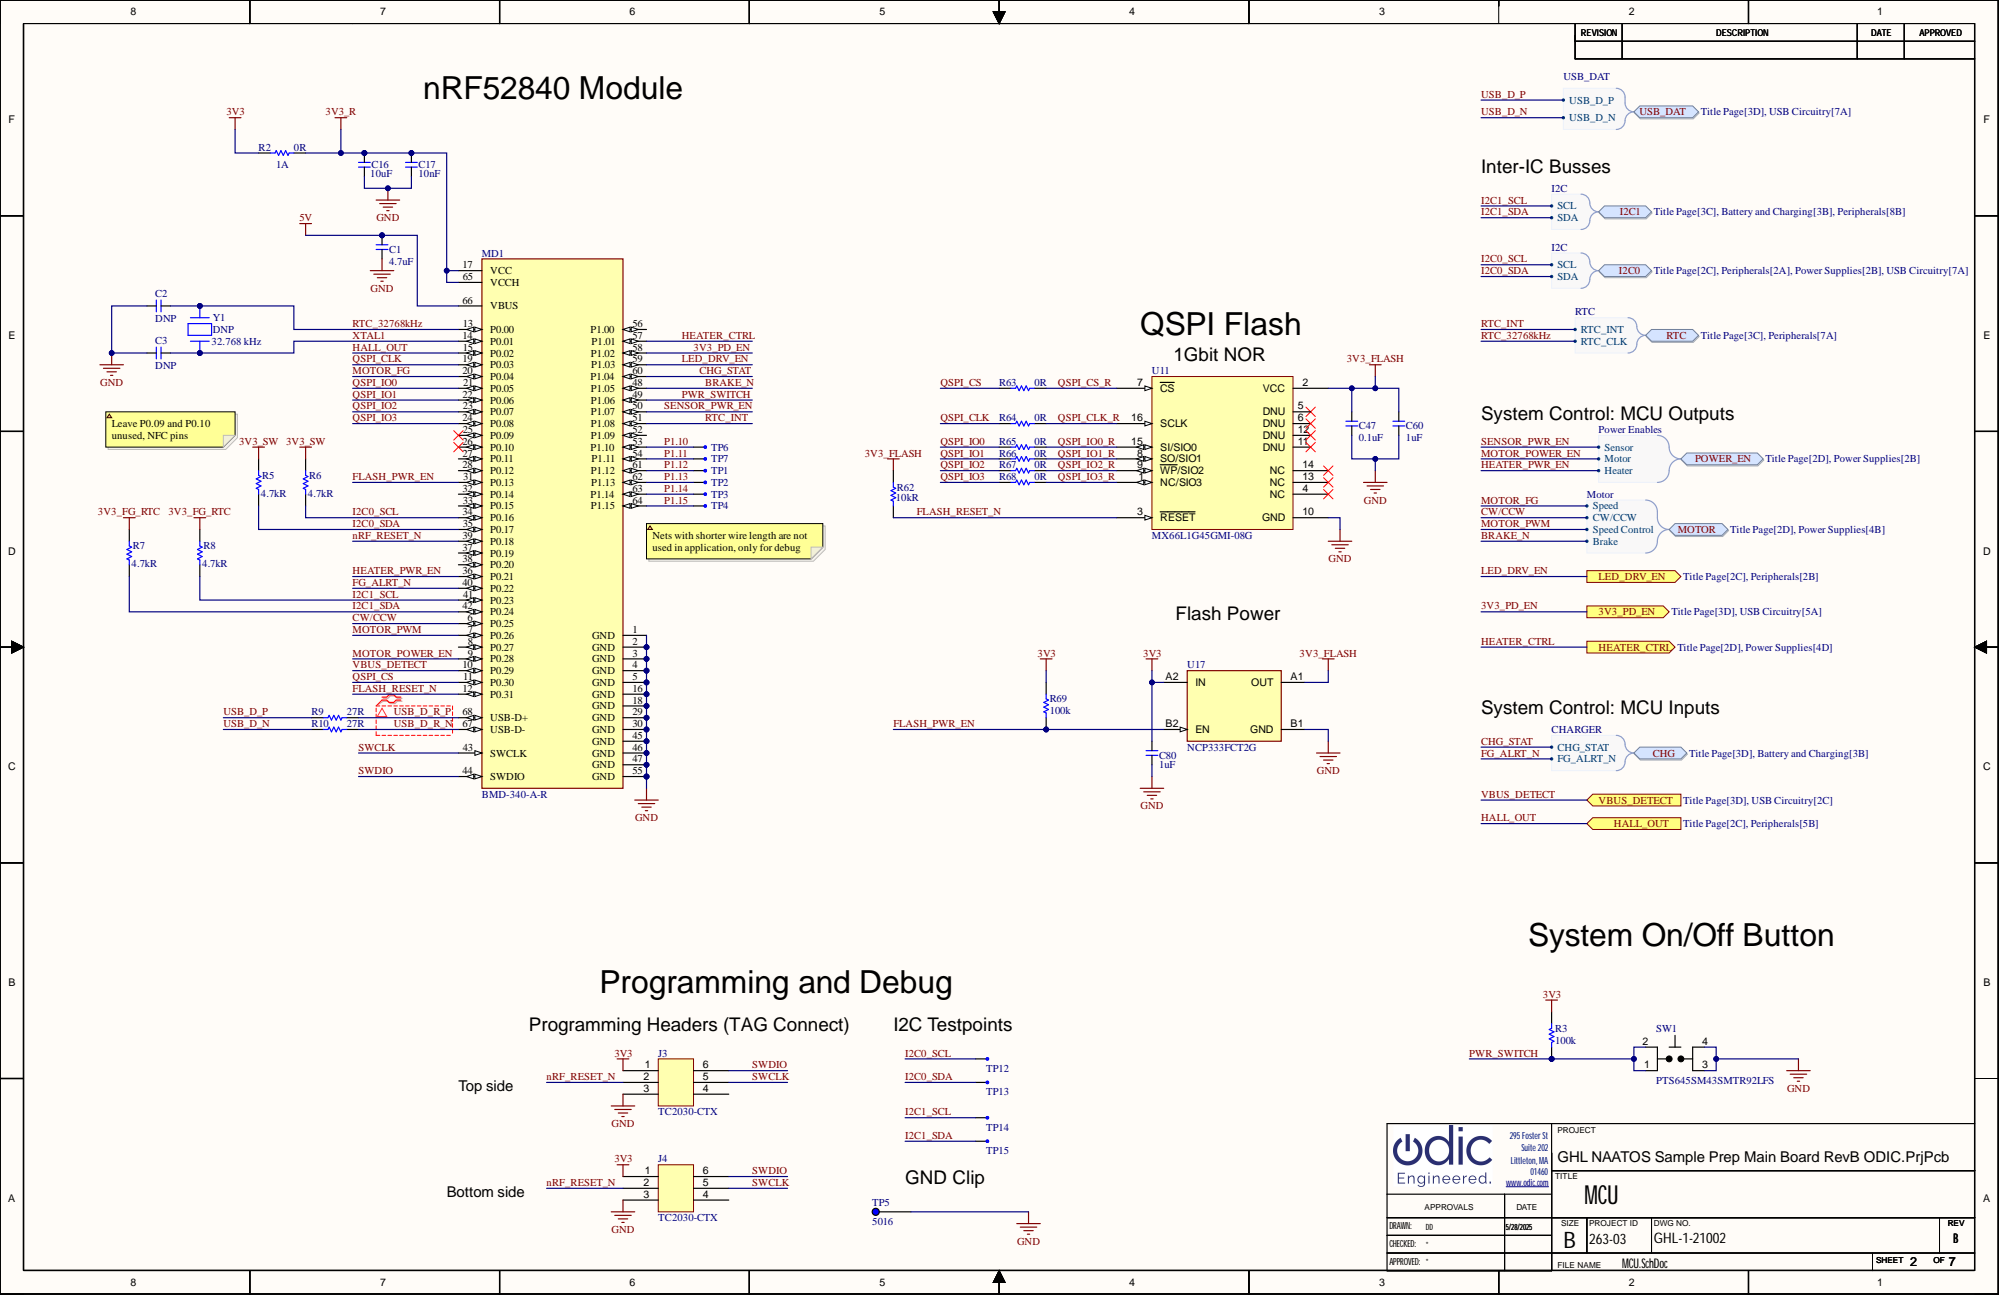
[picture p148: page 2]

VCCH 65

HALL_OUT | | P0.02 15 | 3V3_PD_EN

DNP MOTOR_FG QSPI_IO0 QSPI_IO1 QSPI_IO2 QSPI_IO3 Leave P0.09 and P0.10 unused, NFC pins 3V3_SW 3V3_SW R5 R6 FLASH_PWR_EN R7 R8 | P0.03 19 P0.04 20 P0.05 21 P0.06 22 P0.07 23 P0.08 24 P0.09 25 | LED_DRV_EN

System Control: MCU Outputs

Nets with shorter wire length are not
used in application, only for debug

System Control: MCU Inputs

VBUS_DETECT Title Page[3D], USB Circuitry[2C] VBUS_DETECT

System On/Off Button

PROJECT
GHL NAATOS Sample Prep Main Board RevB ODIC.PrjPcb

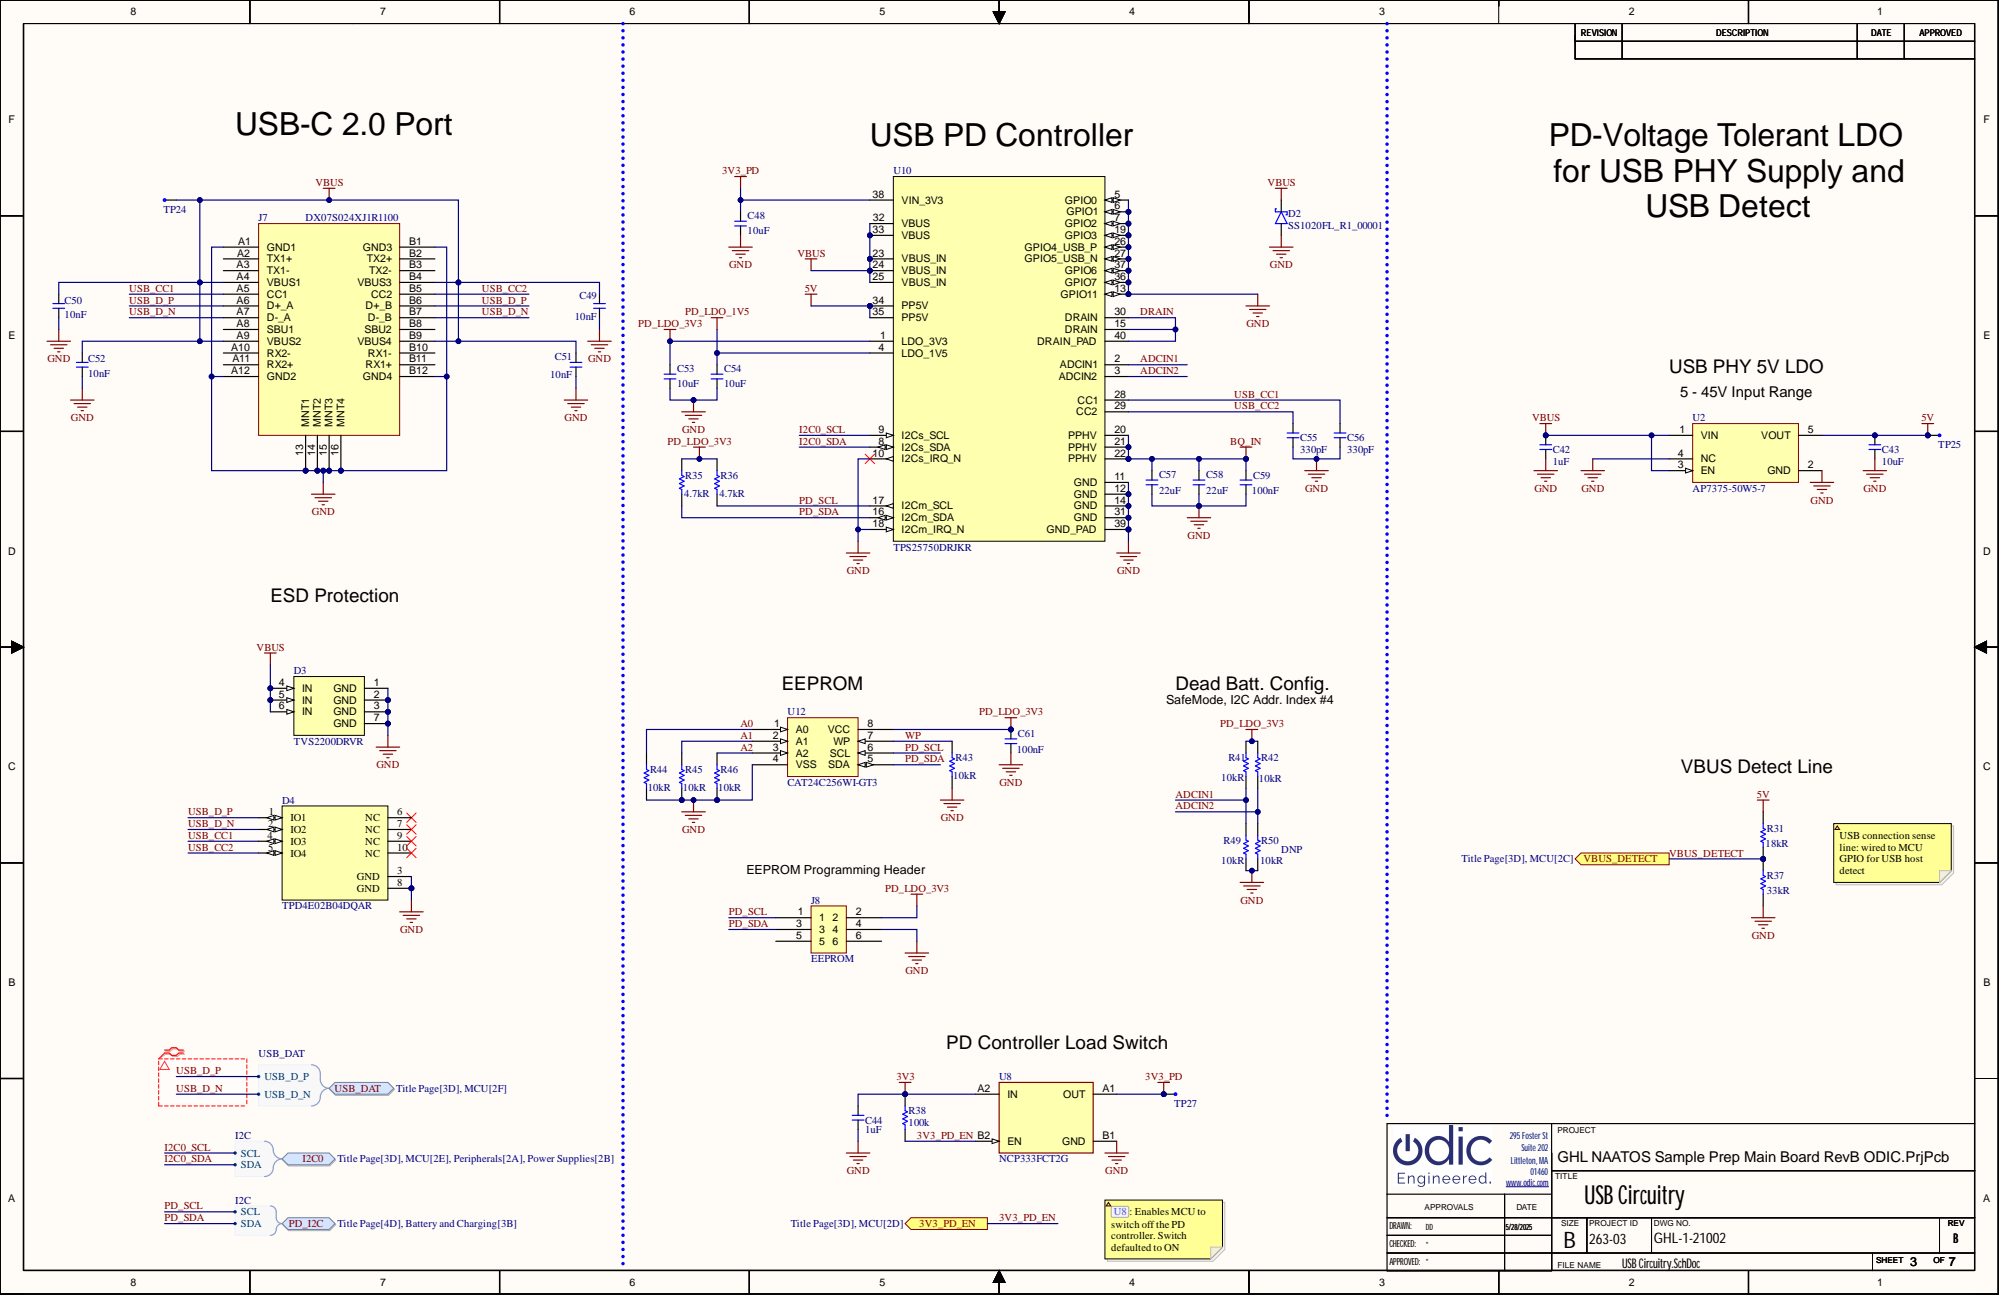
[picture p149: page 3]

PD-Voltage Tolerant LDO
for USB PHY Supply and

A1 | A1 2 | WP
A2 | A2 3

USB connection sense
line: wired to MCU
GPIO for USB host
detect

PD Controller Load Switch

PROJECT
GHL NAATOS Sample Prep Main Board RevB ODIC.PrjPcb

U8 : Enables MCU to
switch off the PD
controller. Switch
defaulted to ON

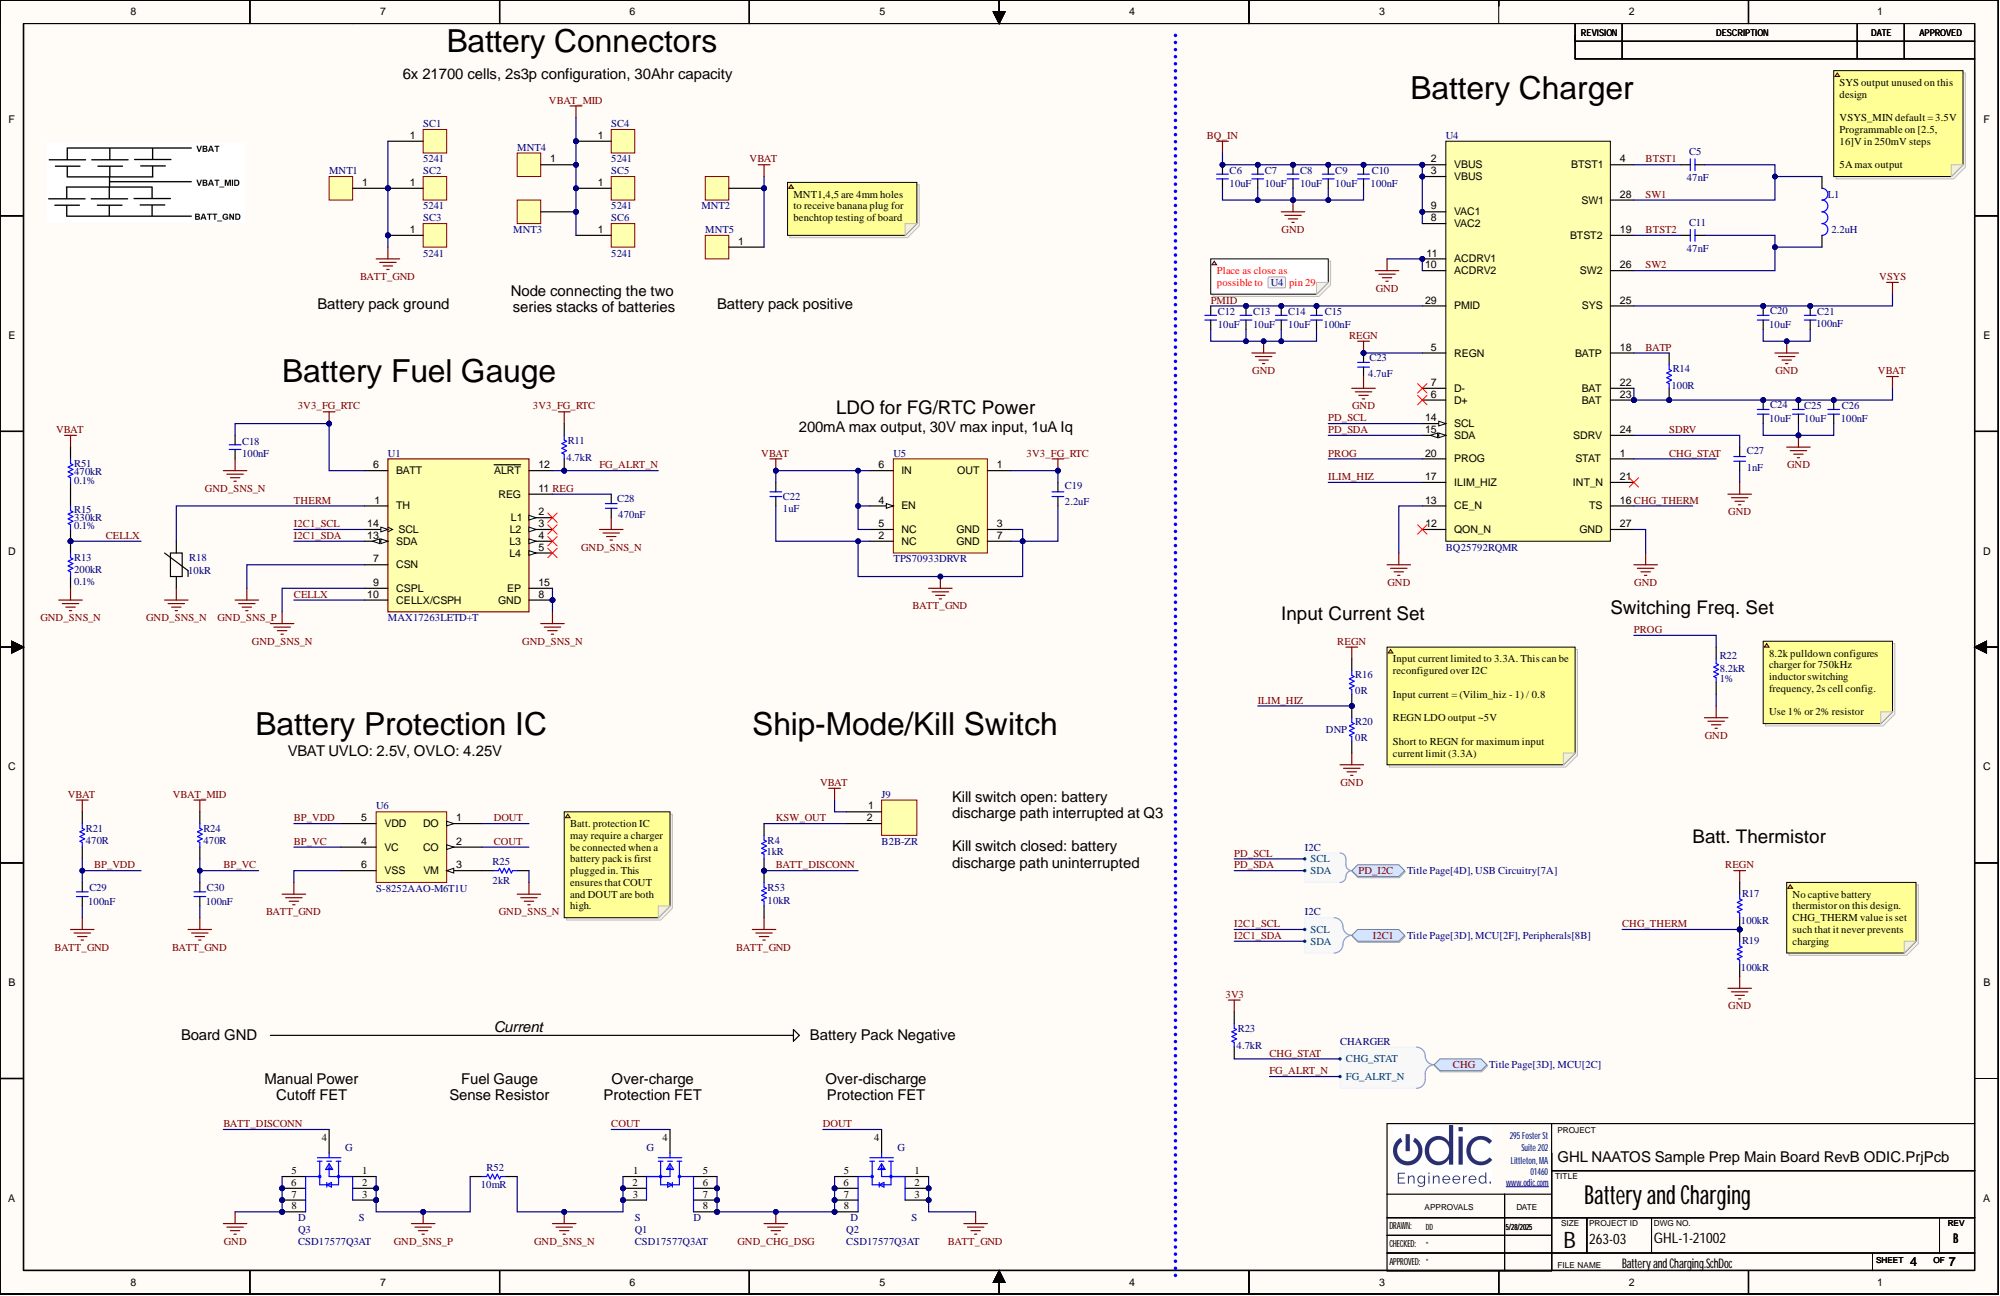
[picture p150: page 4]

SYS output unused on this
design

MNT1,4,5 are 4mm holes
to receive banana plug for
benchtop testing of board

Node connecting the two

LDO for FG/RTC Power
200mA max output, 30V max input, 1uA Iq

CSPL 9

CELLX | | CELLX/CSPH 10

Input current limited to 3.3A. This can be
reconfigured over I2C

Ship-Mode/Kill Switch

Short to REGN for maximum input
current limit (3.3A)

Kill switch open: battery
discharge path interrupted at Q3

Batt. protection IC
may require a charger
be connected when a
battery pack is first
plugged in. This
ensuresthat COUT
and DOUT are both
high.

Kill switch closed: battery
discharge path uninterrupted

No captive battery
thermistor on this design.
CHG_THERM value is set
such that it never prevents
charging

PROJECT
GHL NAATOS Sample Prep Main Board RevB ODIC.PrjPcb
Battery and Charging 5/28/2025

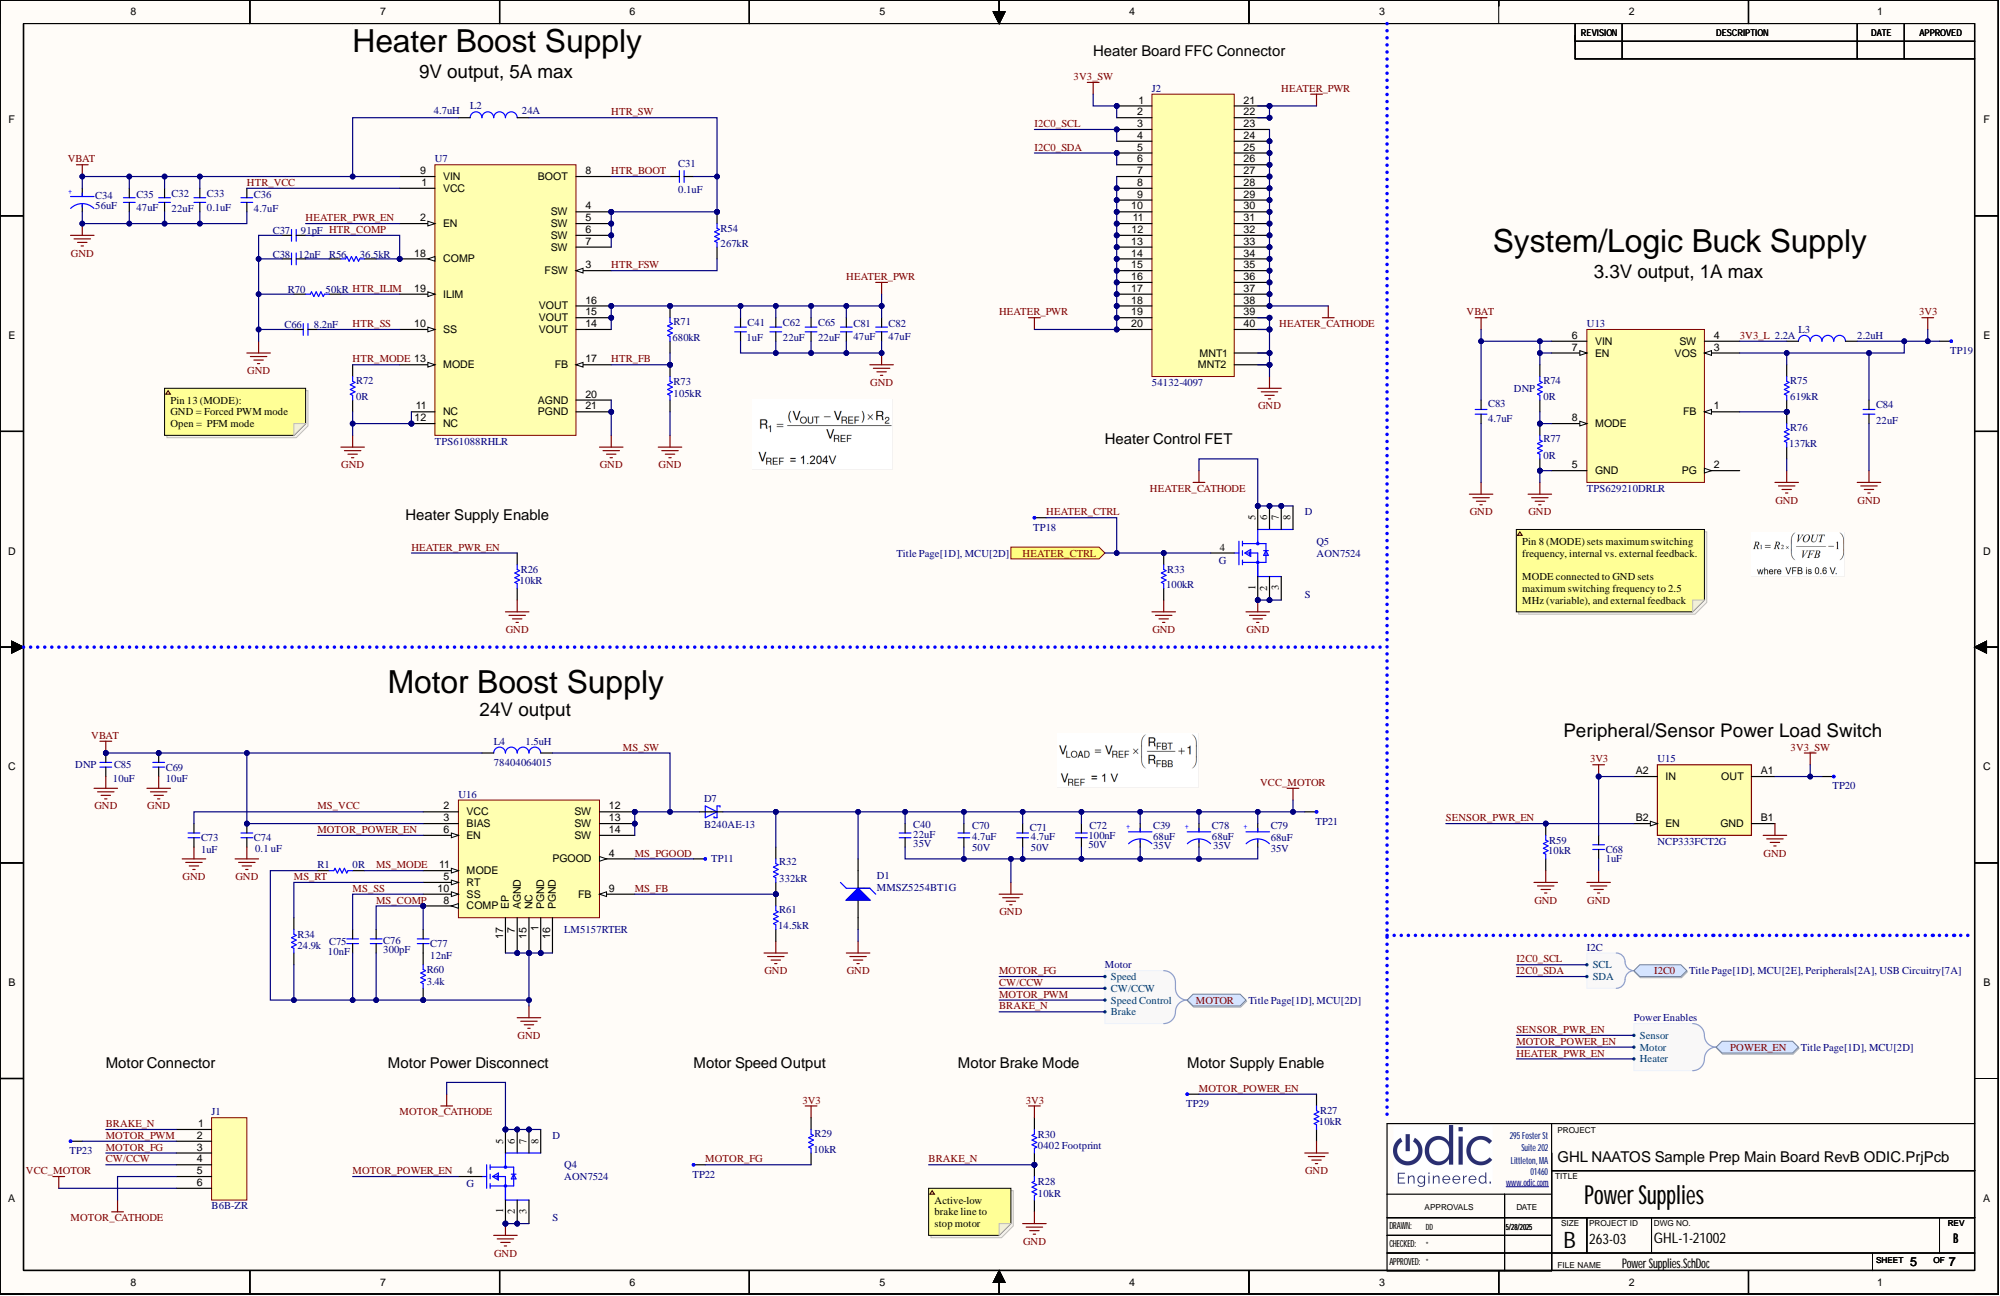
[picture p151: page 5]

Heater Board FFC Connector

System/Logic Buck Supply

13 | 33
14 | 34

16 | 36
17 | 37
18 | 38

Pin 13 (MODE):
GND = Forced PWM mode
Open = PFM mode

Pin 8 (MODE) sets maximum switching
frequency, internal vs. external feedback.

MODE connected to GND sets
maximum switching frequency to 2.5
MHz (variable), and external feedback

Peripheral/Sensor Power Load Switch

PROJECT
GHL NAATOS Sample Prep Main Board RevB ODIC.PrjPcb
Power Supplies 5/28/2025

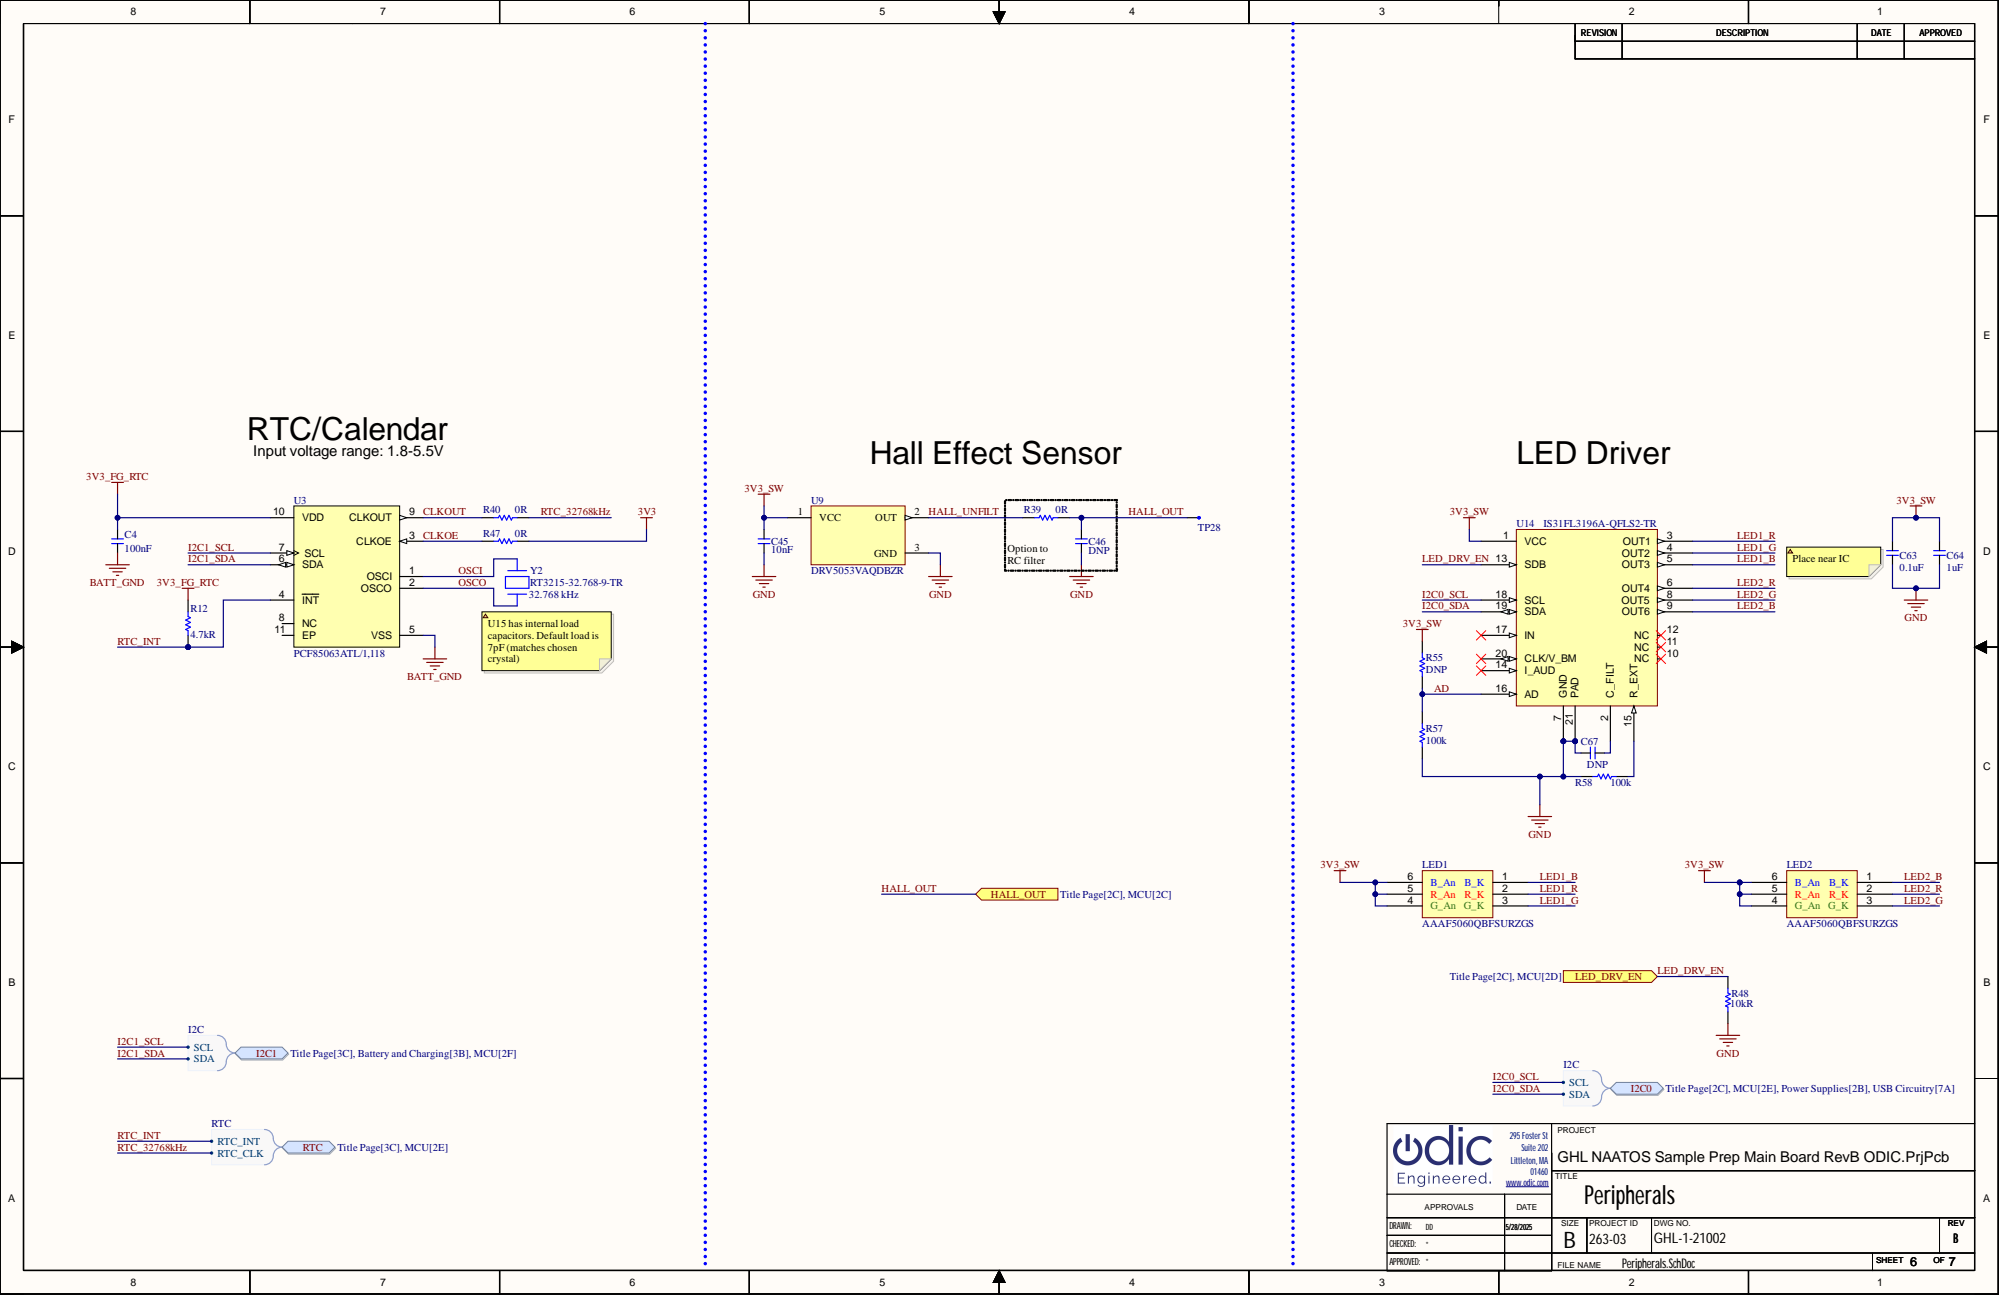
[picture p152: page 6]

U15 has internal load
capacitors. Default load is
7pF (matches chosen
crystal)

PROJECT
GHL NAATOS Sample Prep Main Board RevB ODIC.PrjPcb

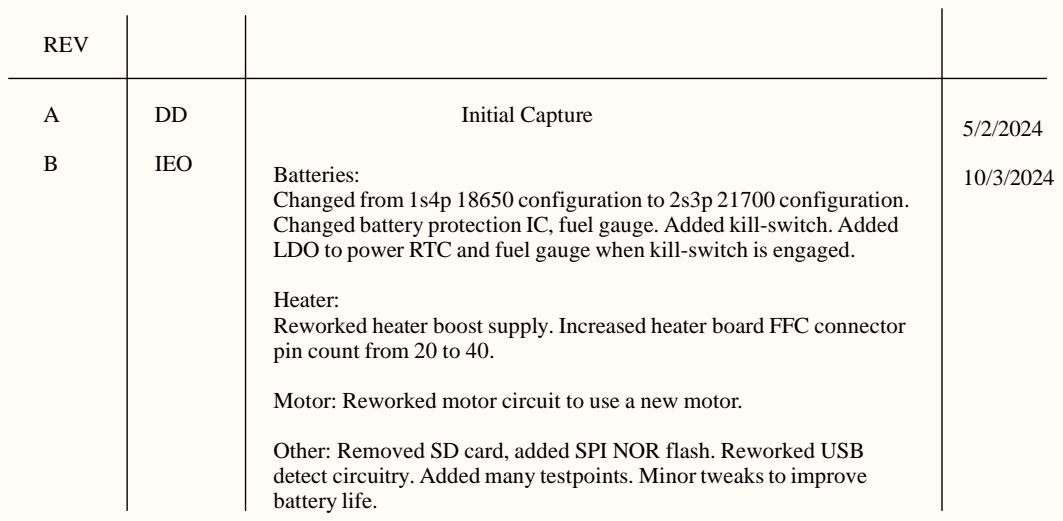
[picture p153: page 7]

Changed from 1s4p 18650 configuration to 2s3p 21700 configuration.
Changed battery protection IC, fuel gauge. Added kill-switch. Added
LDO to power RTC and fuel gauge when kill-switch is engaged.

Heater:
Reworked heater boost supply. Increased heater board FFC connector
pin count from 20 to 40.

Motor: Reworked motor circuit to use a new motor.

Other: Removed SD card, added SPI NOR flash. Reworked USB
detect circuitry. Added many testpoints. Minor tweaks to improve
battery life.

PROJECT
GHL NAATOS Sample Prep Main Board RevB ODIC.PrjPcb
Revision History 5/28/2025
