Global-Health-Labs/nPOC-BB/docs/verifications/tr-20240821.md

# 20240821 Technical Review (Alpha)

[Technical Review](../reviews/20240821%20TR%20NAATOS%20v1%20Alpha%20Technical%20Review.pdf){:target="_blank"}

[Meeting Review Record](../reviews/20240611%20MRR%20NAATOS%20v1%20Alpha%20Handoff.pdf){:target="_blank"} (20240611 Prototype Transfer)
