Global-Health-Labs/nPOC-BB/docs/verifications/tr-20250409.md

# 20250409 Technical Review (Gamma)

[Technical Review](../reviews/20250409%20TR%20nPOC-BB%20Final%20Technical%20Review.pdf){:target="_blank"} / [Meeting Review Record](../reviews/20250409%20MRR%20NAATOS%20v1%20Gamma%20(Final)%20Technical%20Review.pdf){:target="_blank"}
