Global-Health-Labs/nPOC-BB/sw_tools/python/_sample_data/SamplePrepTestData/20250501_npocbb_autodl/SP16/logs/sample_03-14-25_160727.csv

Time | HeaterTemp | HeaterPWM | MotorSpeed | MotorPWM | Battery | BatteryV | BatteryT | Event
2025-03-14 16:07:27 | 0.00 | 0.00 | 0.00 | 0.00 | 99 | 4.14 | 23.07 | Cycle 1 Started. runtime_s=51 ticks=15165 rtc=1741968447
2025-03-14 16:07:28 | 22.58 | 100.00 | 0.00 | 0.00 | 99 | 4.07 | 23.09
2025-03-14 16:07:29 | 24.98 | 100.00 | 0.00 | 0.00 | 99 | 4.07 | 23.30
2025-03-14 16:07:30 | 28.15 | 100.00 | 0.00 | 0.00 | 99 | 4.07 | 23.36
2025-03-14 16:07:31 | 31.57 | 100.00 | 0.00 | 0.00 | 99 | 4.07 | 23.64
2025-03-14 16:07:32 | 35.04 | 100.00 | 0.00 | 0.00 | 99 | 4.07 | 23.79
2025-03-14 16:07:33 | 38.47 | 100.00 | 0.00 | 0.00 | 99 | 4.07 | 23.99
2025-03-14 16:07:34 | 41.84 | 100.00 | 0.00 | 0.00 | 99 | 4.07 | 23.81
2025-03-14 16:07:35 | 45.14 | 100.00 | 0.00 | 0.00 | 99 | 4.07 | 24.36
2025-03-14 16:07:36 | 48.36 | 100.00 | 0.00 | 0.00 | 99 | 4.07 | 24.34
2025-03-14 16:07:37 | 51.51 | 100.00 | 0.00 | 0.00 | 99 | 4.07 | 24.36
2025-03-14 16:07:38 | 54.58 | 100.00 | 0.00 | 0.00 | 99 | 4.07 | 24.69
2025-03-14 16:07:39 | 57.57 | 100.00 | 0.00 | 0.00 | 98 | 4.07 | 24.56
2025-03-14 16:07:40 | 60.52 | 100.00 | 0.00 | 0.00 | 98 | 4.07 | 24.75
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
