Global-Health-Labs/nPOC-BB/sw_tools/python/_sample_data/SamplePrepTestData/20250501_npocbb_autodl/SP16/logs/sample_03-19-25_114259.csv

Time | HeaterTemp | HeaterPWM | MotorSpeed | MotorPWM | Battery | BatteryV | BatteryT | Event
2025-03-19 11:42:59 | 0.00 | 0.00 | 0.00 | 0.00 | 97 | 4.12 | 23.73 | Cycle 1 Started. runtime_s=51 ticks=178365 rtc=1742384579
2025-03-19 11:43:00 | 24.25 | 100.00 | 0.00 | 0.00 | 97 | 4.06 | 23.79
2025-03-19 11:43:01 | 26.62 | 100.00 | 0.00 | 0.00 | 97 | 4.06 | 23.91
2025-03-19 11:43:02 | 29.67 | 100.00 | 0.00 | 0.00 | 97 | 4.06 | 24.20
2025-03-19 11:43:03 | 32.94 | 100.00 | 0.00 | 0.00 | 97 | 4.06 | 24.44
2025-03-19 11:43:04 | 36.21 | 100.00 | 0.00 | 0.00 | 97 | 4.06 | 24.36
2025-03-19 11:43:05 | 39.35 | 100.00 | 0.00 | 0.00 | 97 | 4.06 | 24.62
2025-03-19 11:43:06 | 42.41 | 100.00 | 0.00 | 0.00 | 97 | 4.06 | 24.67
2025-03-19 11:43:07 | 45.32 | 100.00 | 0.00 | 0.00 | 97 | 4.06 | 24.83
2025-03-19 11:43:08 | 48.12 | 100.00 | 0.00 | 0.00 | 97 | 4.06 | 24.93
2025-03-19 11:43:09 | 50.81 | 100.00 | 0.00 | 0.00 | 97 | 4.06 | 24.99
2025-03-19 11:43:10 | 53.37 | 100.00 | 0.00 | 0.00 | 97 | 4.06 | 25.10
2025-03-19 11:43:11 | 55.83 | 100.00 | 0.00 | 0.00 | 97 | 4.06 | 25.24
2025-03-19 11:43:12 | 58.19 | 100.00 | 0.00 | 0.00 | 97 | 4.06 | 25.28
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
