Global-Health-Labs/nPOC-BB/sw_tools/python/_sample_data/SamplePrepTestData/20250501_npocbb_autodl/SP16/logs/sample_03-19-25_115029.csv

Time | HeaterTemp | HeaterPWM | MotorSpeed | MotorPWM | Battery | BatteryV | BatteryT | Event
2025-03-19 11:50:29 | 0.00 | 0.00 | 0.00 | 0.00 | 94 | 4.11 | 25.05 | Cycle 1 Started. runtime_s=51 ticks=638980 rtc=1742385029
2025-03-19 11:50:30 | 39.90 | 100.00 | 0.00 | 0.00 | 94 | 4.11 | 25.05
2025-03-19 11:50:31 | 40.69 | 100.00 | 0.00 | 0.00 | 94 | 4.06 | 24.95
2025-03-19 11:50:32 | 42.84 | 100.00 | 0.00 | 0.00 | 94 | 4.06 | 25.10
2025-03-19 11:50:33 | 45.54 | 100.00 | 0.00 | 0.00 | 94 | 4.06 | 25.10
2025-03-19 11:50:34 | 48.41 | 100.00 | 0.00 | 0.00 | 94 | 4.06 | 25.46
2025-03-19 11:50:35 | 51.29 | 100.00 | 0.00 | 0.00 | 94 | 4.05 | 25.40
2025-03-19 11:50:36 | 54.09 | 100.00 | 0.00 | 0.00 | 94 | 4.06 | 25.71
2025-03-19 11:50:37 | 56.79 | 100.00 | 0.00 | 0.00 | 94 | 4.05 | 25.85
2025-03-19 11:50:38 | 59.37 | 100.00 | 0.00 | 0.00 | 94 | 4.05 | 25.93
2025-03-19 11:50:39 | 61.86 | 100.00 | 0.00 | 0.00 | 94 | 4.06 | 26.05
2025-03-19 11:50:40 | 64.24 | 100.00 | 0.00 | 0.00 | 94 | 4.06 | 26.14
2025-03-19 11:50:41 | 66.52 | 100.00 | 0.00 | 0.00 | 94 | 4.06 | 26.20
2025-03-19 11:50:42 | 68.73 | 100.00 | 0.00 | 0.00 | 94 | 4.05 | 26.18
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
