Global-Health-Labs/nPOC-BB/sw_tools/python/_sample_data/SamplePrepTestData/20250501_npocbb_autodl/SP16/logs/sample_03-19-25_115759.csv

Time | HeaterTemp | HeaterPWM | MotorSpeed | MotorPWM | Battery | BatteryV | BatteryT | Event
2025-03-19 11:57:59 | 0.00 | 0.00 | 0.00 | 0.00 | 92 | 4.11 | 25.75 | Cycle 1 Started. runtime_s=51 ticks=1098590 rtc=1742385479
2025-03-19 11:57:59 | 44.31 | 100.00 | 0.00 | 0.00 | 92 | 4.11 | 25.75
2025-03-19 11:58:00 | 44.80 | 100.00 | 0.00 | 0.00 | 92 | 4.05 | 26.00
2025-03-19 11:58:01 | 46.63 | 100.00 | 0.00 | 0.00 | 91 | 4.05 | 26.00
2025-03-19 11:58:02 | 49.04 | 100.00 | 0.00 | 0.00 | 91 | 4.05 | 26.04
2025-03-19 11:58:03 | 51.66 | 100.00 | 0.00 | 0.00 | 91 | 4.05 | 26.36
2025-03-19 11:58:04 | 54.29 | 100.00 | 0.00 | 0.00 | 91 | 4.05 | 26.26
2025-03-19 11:58:05 | 56.88 | 100.00 | 0.00 | 0.00 | 91 | 4.05 | 26.51
2025-03-19 11:58:06 | 59.40 | 100.00 | 0.00 | 0.00 | 91 | 4.05 | 26.75
2025-03-19 11:58:07 | 61.81 | 100.00 | 0.00 | 0.00 | 91 | 4.05 | 26.65
2025-03-19 11:58:08 | 64.15 | 100.00 | 0.00 | 0.00 | 91 | 4.05 | 26.98
2025-03-19 11:58:09 | 66.39 | 100.00 | 0.00 | 0.00 | 91 | 4.05 | 27.10
2025-03-19 11:58:10 | 68.56 | 100.00 | 0.00 | 0.00 | 91 | 4.05 | 27.20
2025-03-19 11:58:11 | 70.65 | 100.00 | 0.00 | 0.00 | 91 | 4.05 | 27.16
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
