Global-Health-Labs/nPOC-BB/hw/alpha/ECAD/derived/PDF/Schematic Prints.PDF

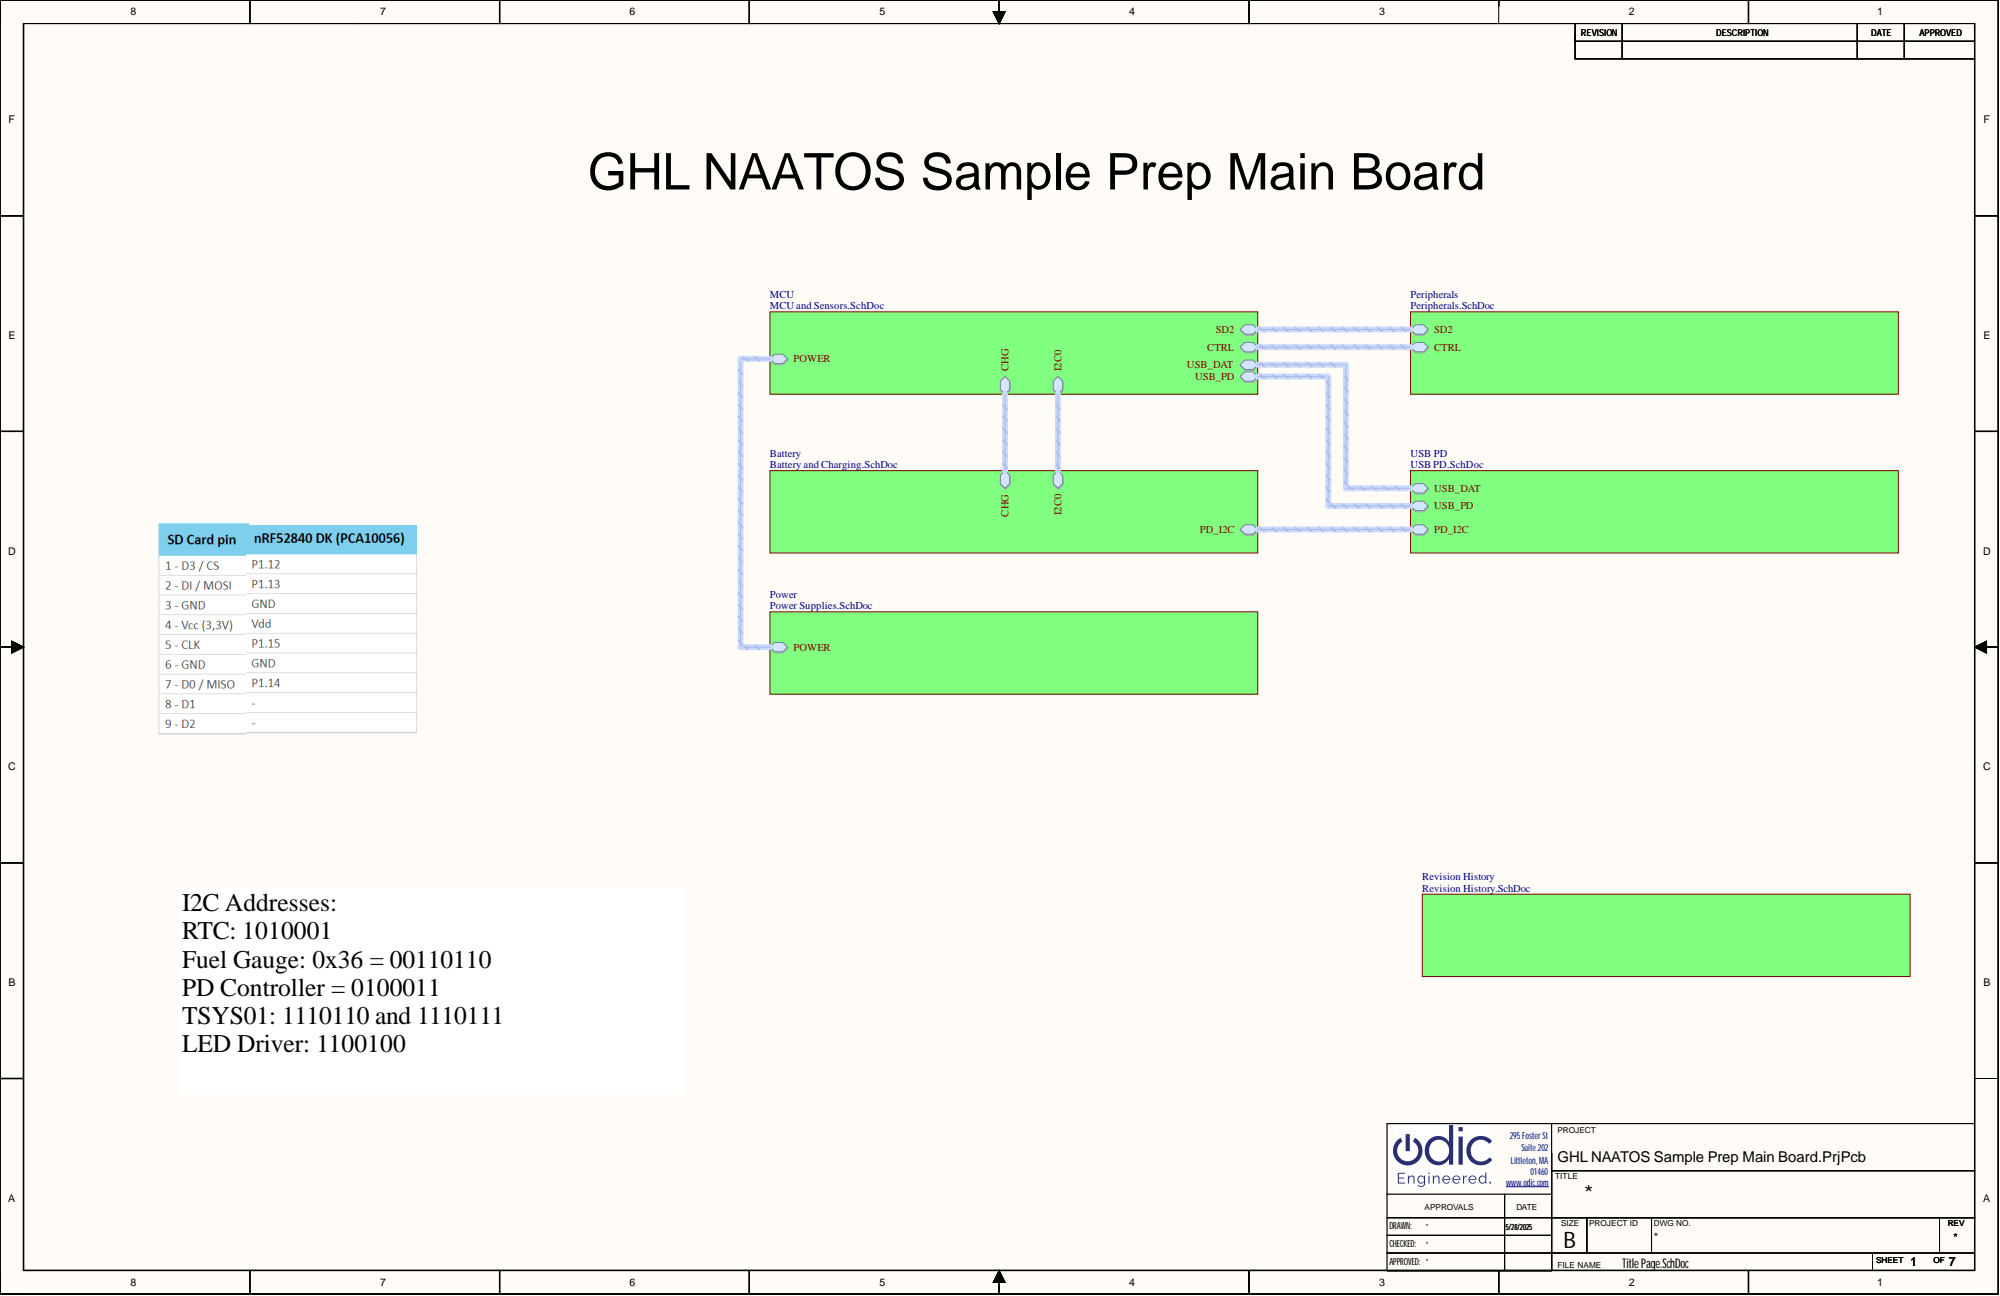
[picture p157: page 1]

GHL NAATOS Sample Prep Main Board

MCU
MCU and Sensors.SchDoc

Battery
Battery and Charging.SchDoc

PROJECT
GHL NAATOS Sample Prep Main Board.PrjPcb

APPROVALS | DATE
DRAWN: * | | SIZE B | PROJECT ID | DWG NO. | REV

CHECKED:
APPROVED: * | | FILE NAME Title Page.SchDoc | SHEET SHEET 1 1 OF OF 7 7

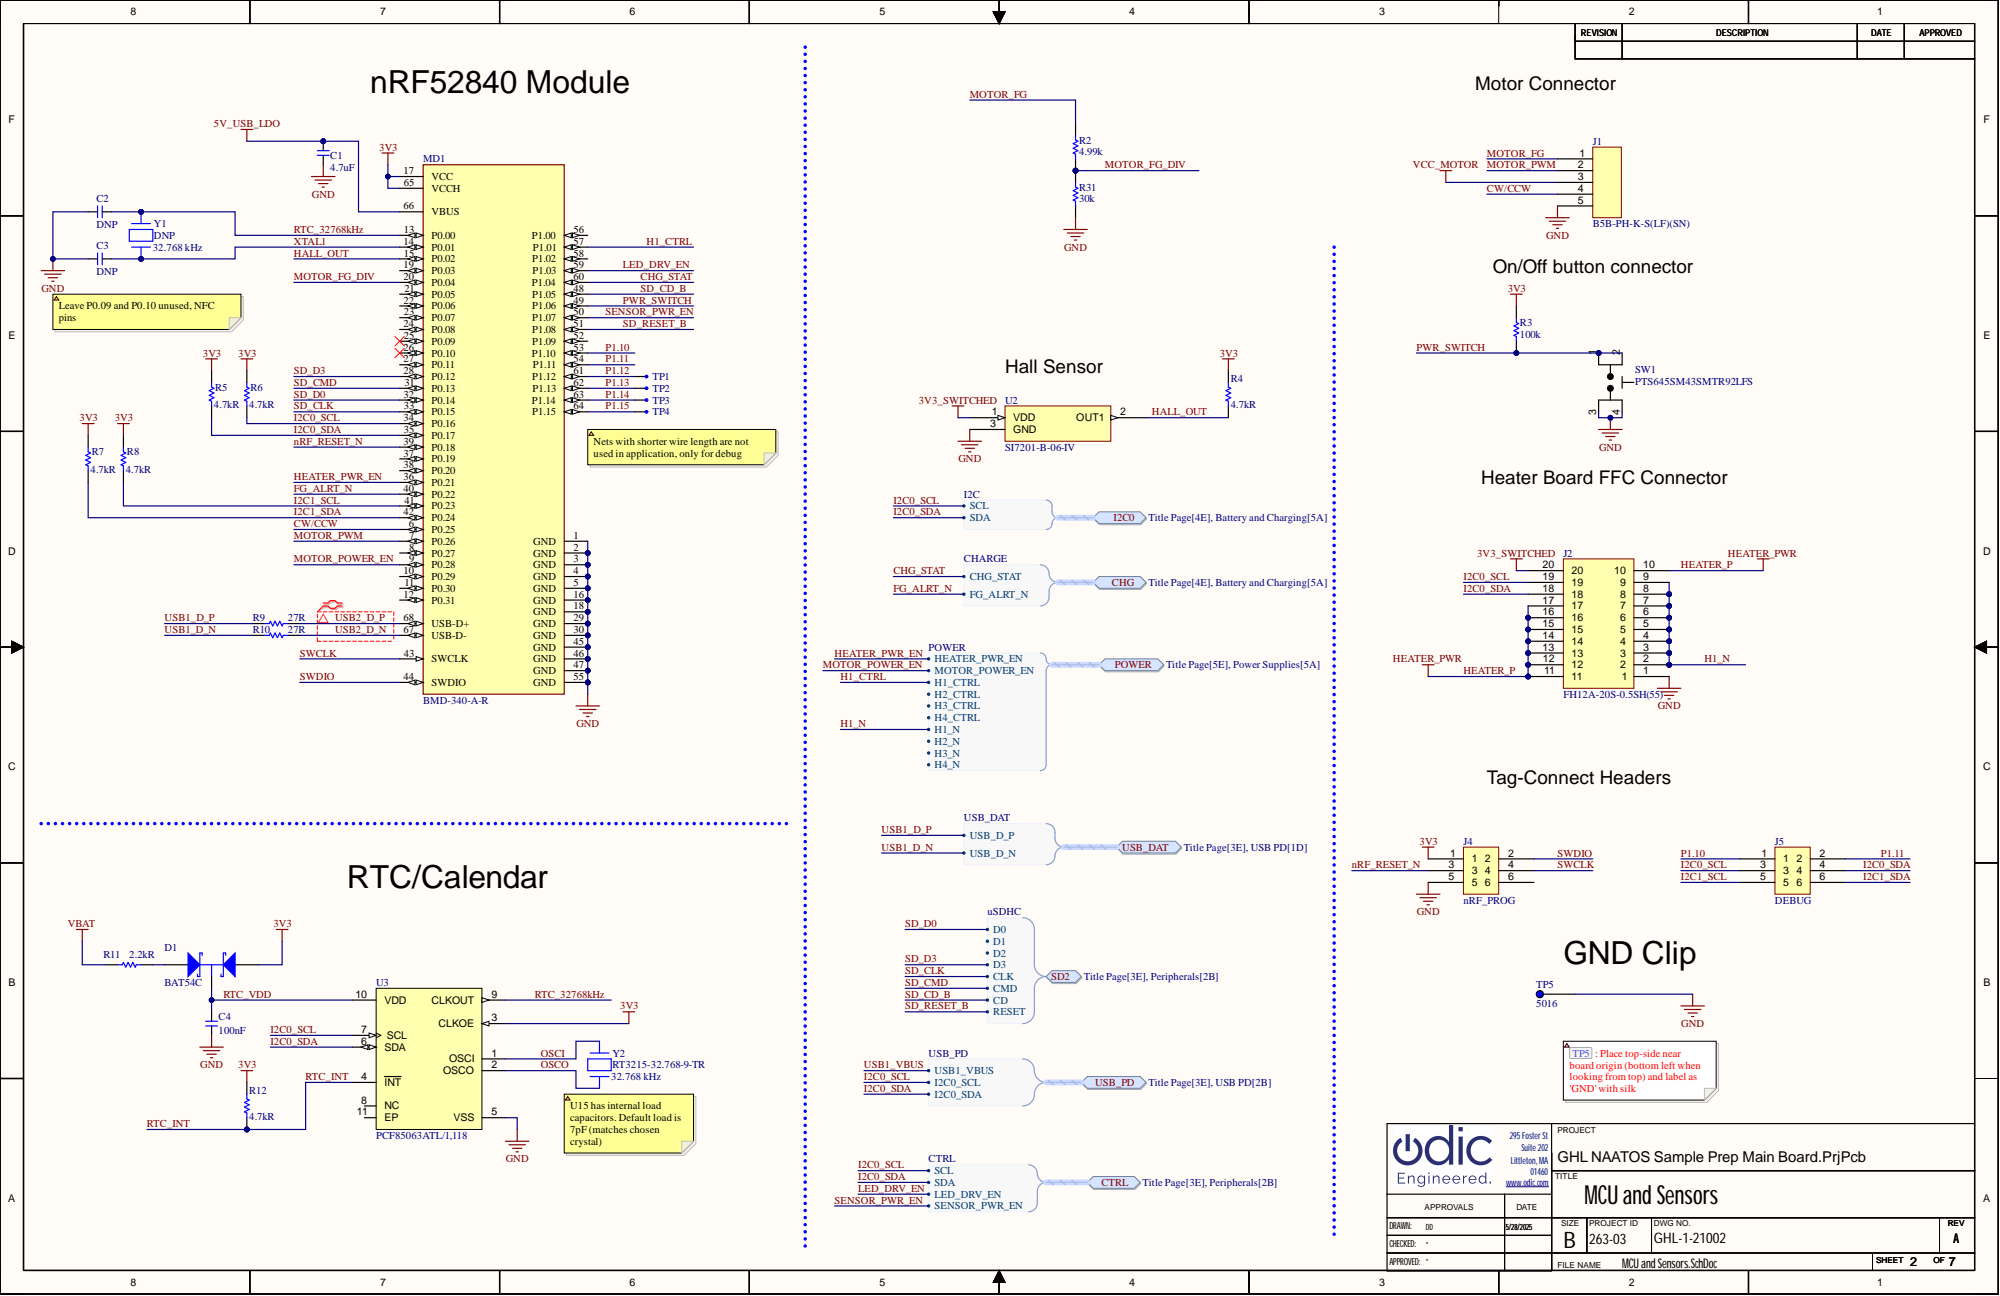
[picture p158: page 2]

GND
On/Off button connector

HALL_OUT | | P0.02 15

Leave P0.09 and P0.10 unused, NFC
pins

Nets with shorter wire length are not
used in application, only for debug

Heater Board FFC Connector

TP5 : Place top-side near
board origin (bottom left when
looking from top) and label as
'GND' with silk

U15 has internal load
capacitors. Default load is
7pF (matches chosen
crystal)

295 Foster St Suite 202 Littleton, MA 01460 www.odic.com | PROJECT GHL NAATOS Sample Prep Main Board.PrjPcb

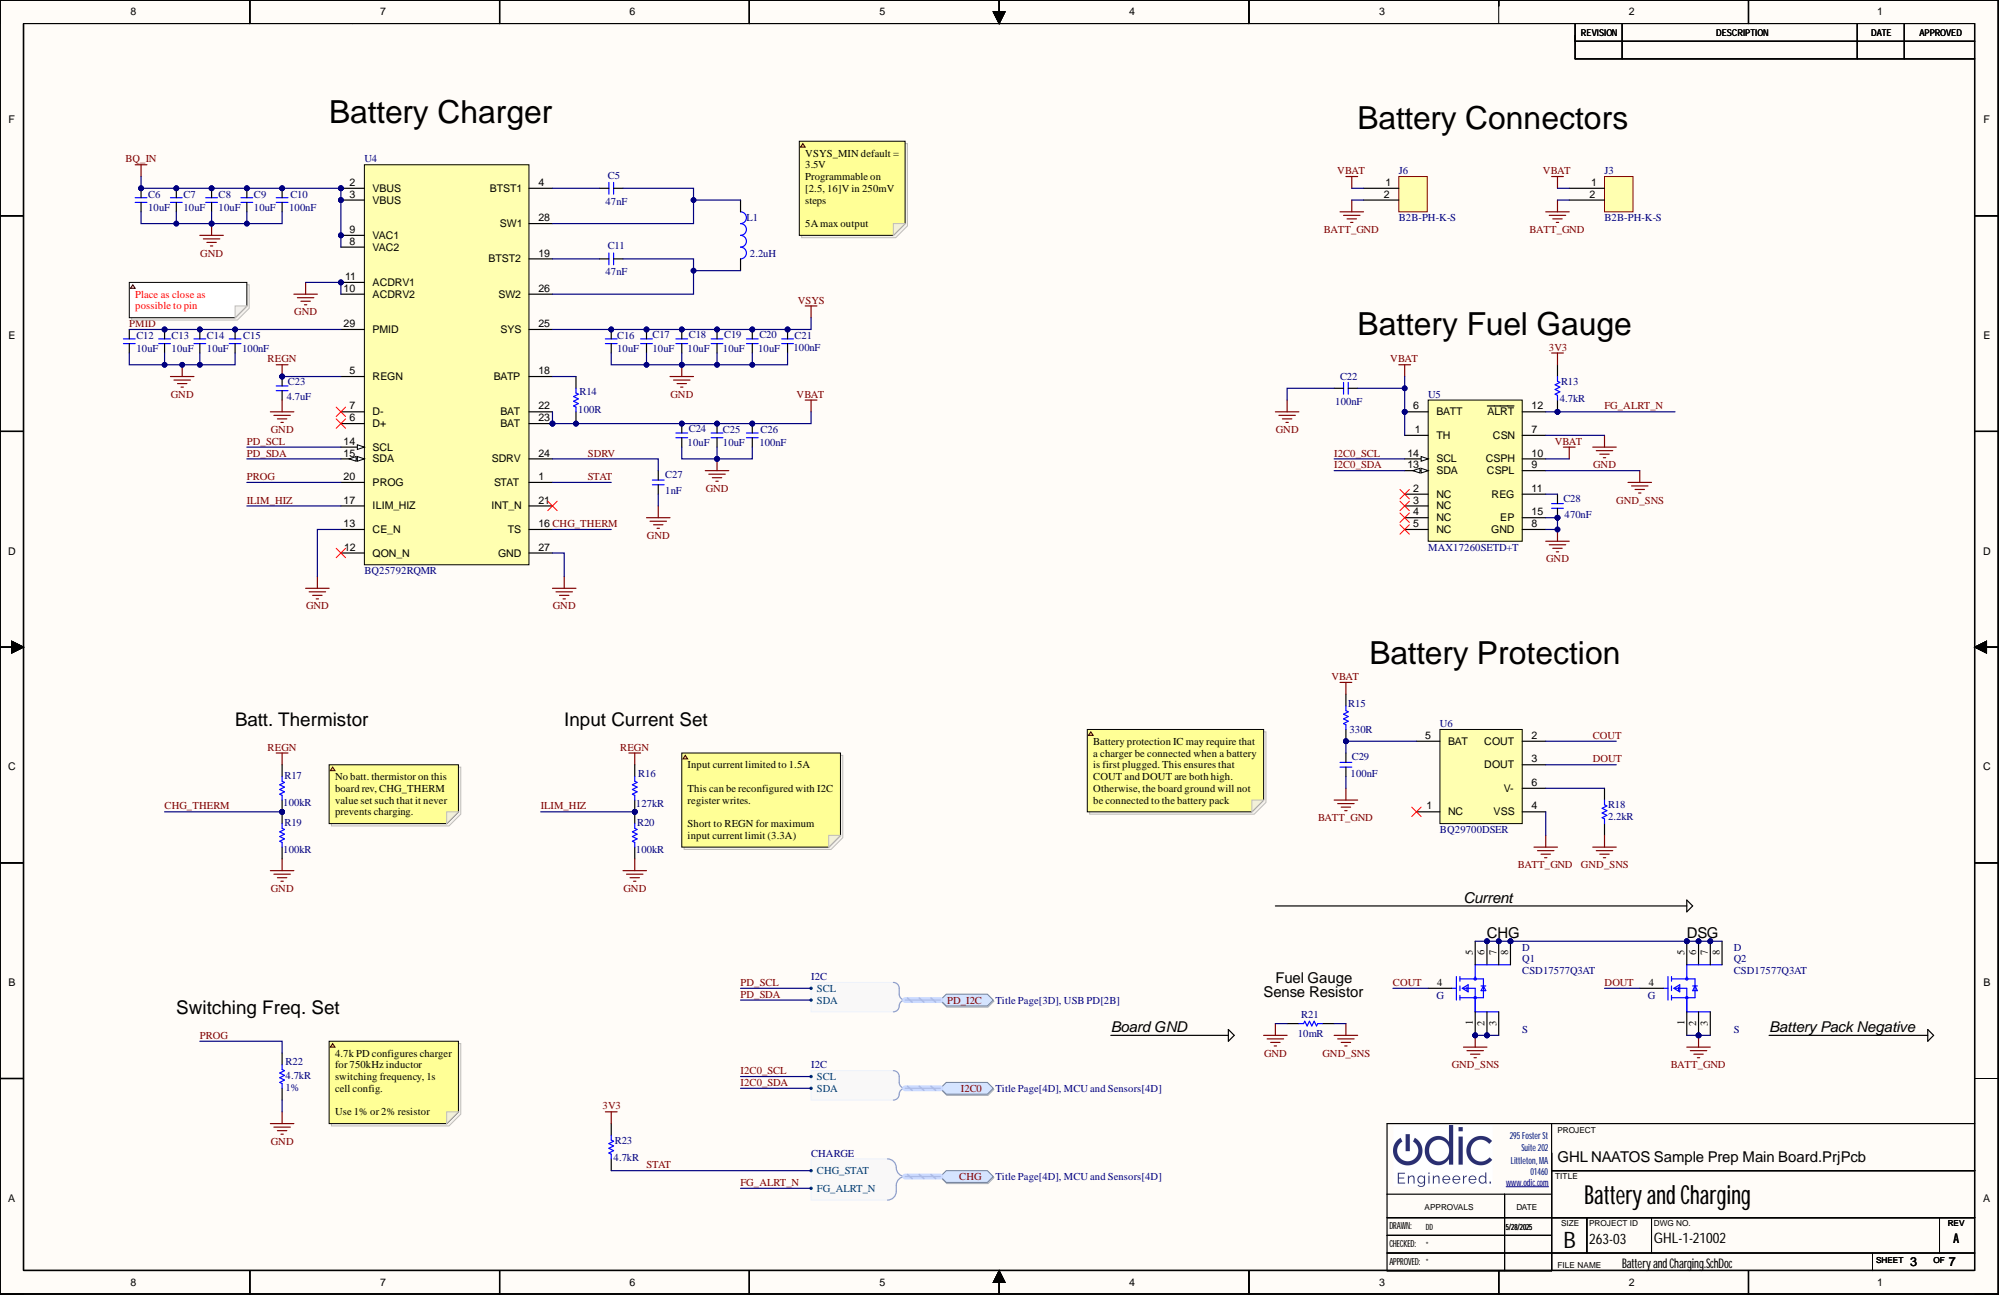
[picture p159: page 3]

Battery protection IC may require that
a charger be connected when a battery
is first plugged. This ensuresthat
COUT and DOUT are both high.
Otherwise, the board ground will not
be connected to the battery pack

Input current limited to 1.5A

No batt. thermistor on this
board rev, CHG_THERM
value setsuch that it never
prevents charging.

This can be reconfigured with I2C
register writes.

Short to REGN for maximum
input current limit (3.3A)

PROJECT
GHL NAATOS Sample Prep Main Board.PrjPcb
Battery and Charging 5/28/2025

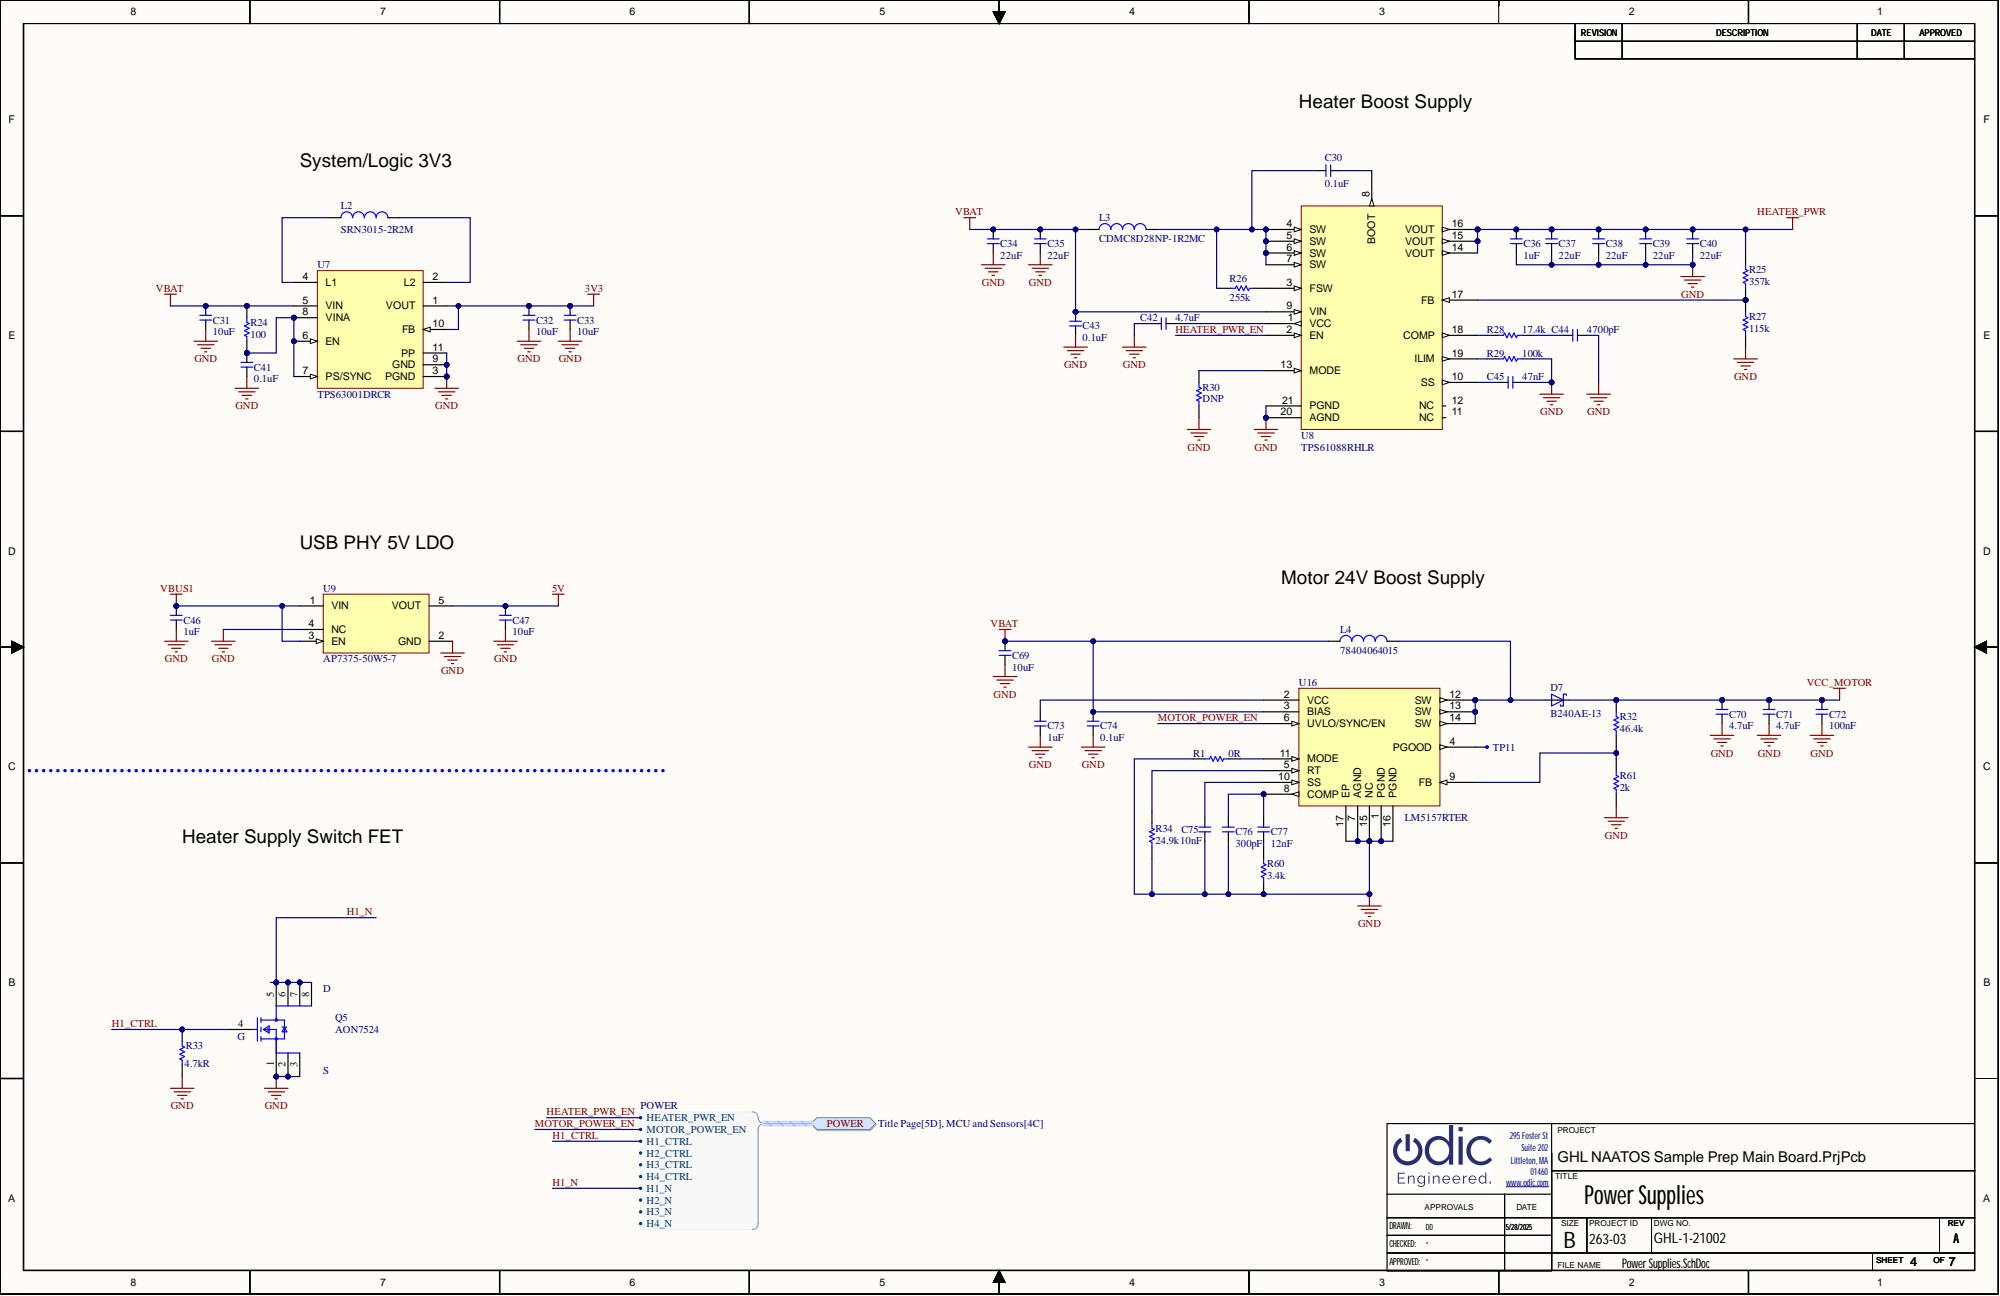
[picture p160: page 4]

VCC 1

Heater Supply Switch FET

PROJECT
GHL NAATOS Sample Prep Main Board.PrjPcb
Power Supplies 5/28/2025

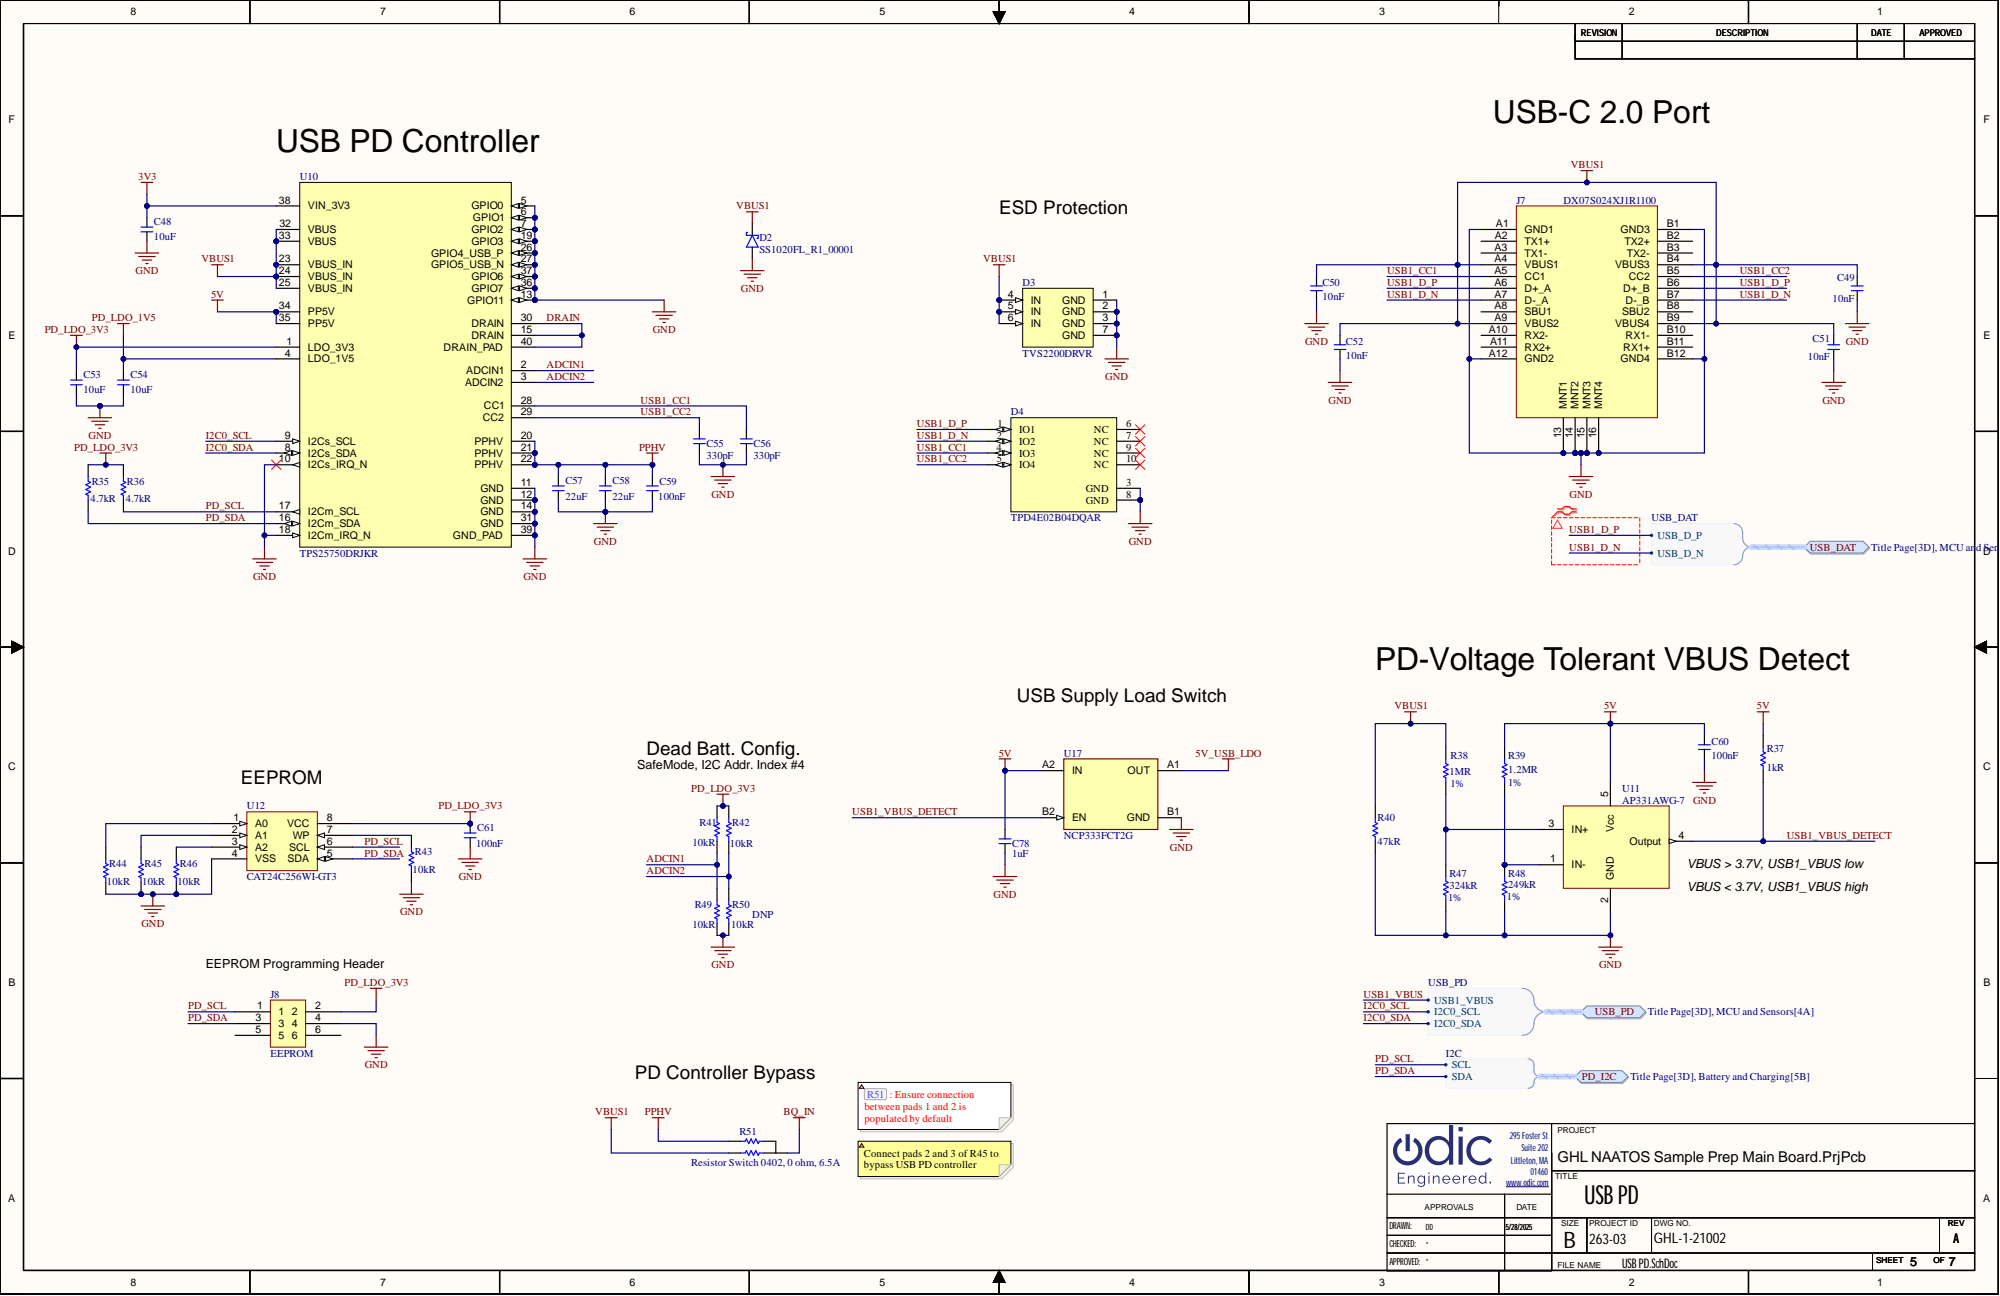
[picture p161: page 5]

PD-Voltage Tolerant VBUS Detect

USB Supply Load Switch

A1 2
A2 3 | PD_LDO_3V3

R51 : Ensure connection
between pads 1 and 2 is
populated by default

PROJECT
GHL NAATOS Sample Prep Main Board.PrjPcb

Connect pads 2 and 3 of R45 to
bypass USB PD controller

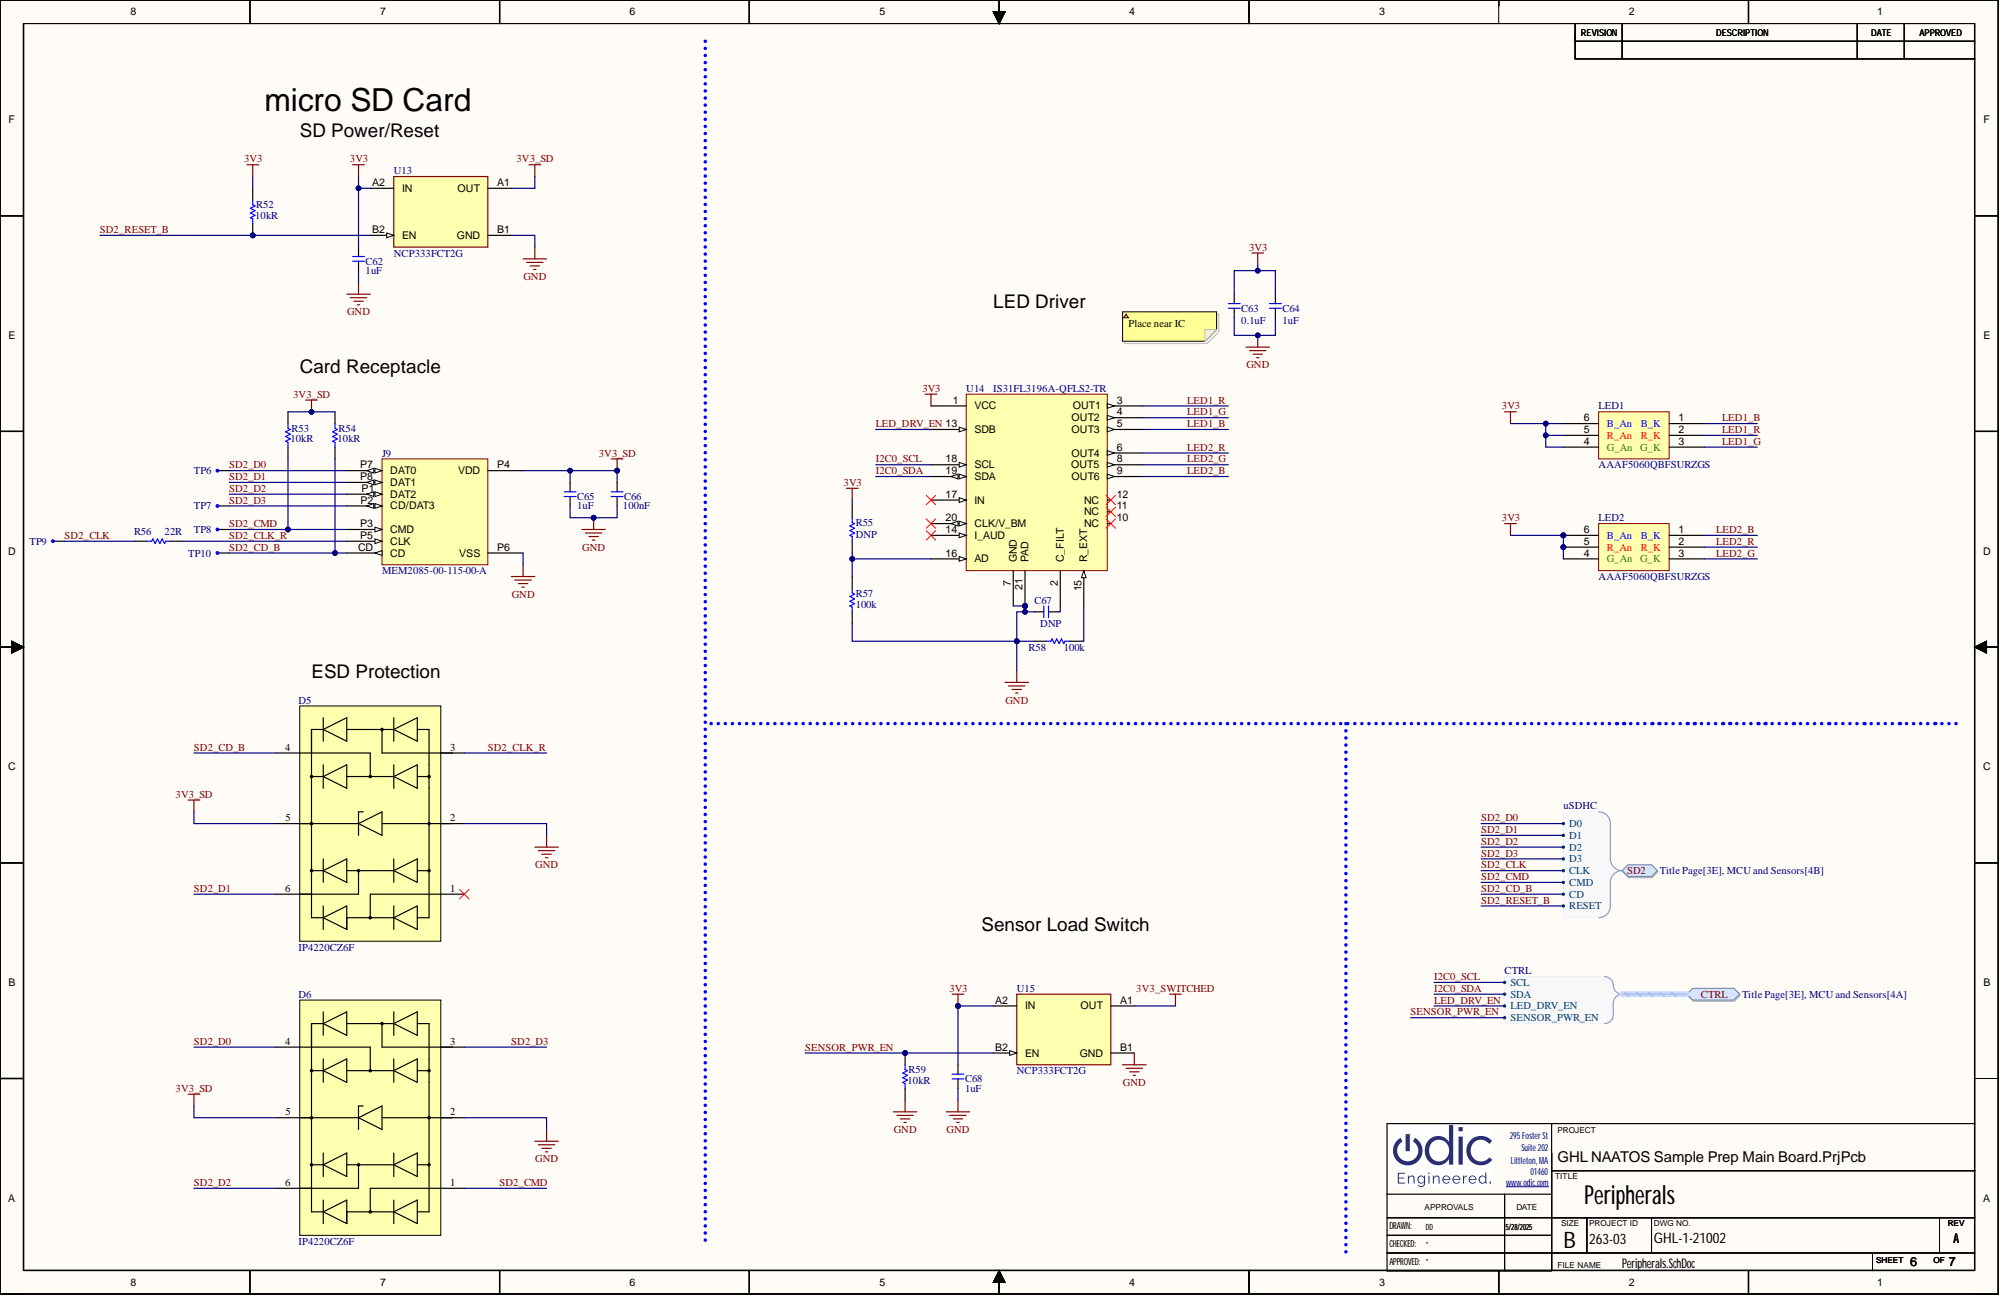
[picture p162: page 6]

PROJECT
GHL NAATOS Sample Prep Main Board.PrjPcb

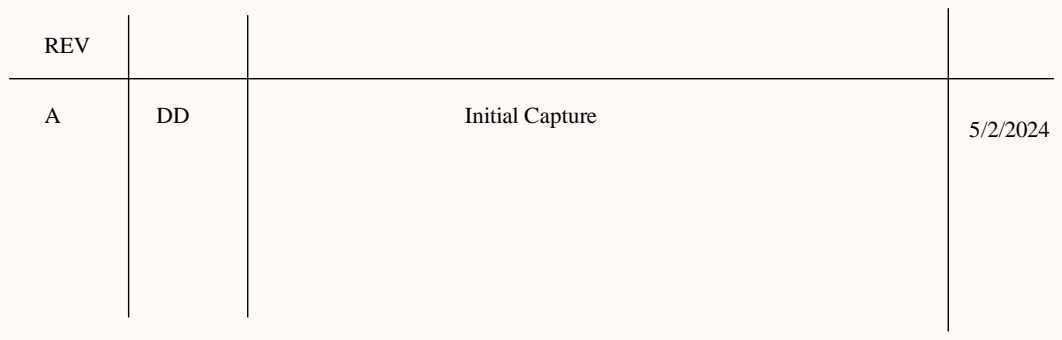
[picture p163: page 7]

PROJECT
GHL NAATOS Sample Prep Main Board.PrjPcb
Revision History 5/28/2025
