Global-Health-Labs/nPOC-BB/hw/beta/ECAD/heater-board/derived/PDF/Schematic Prints.PDF

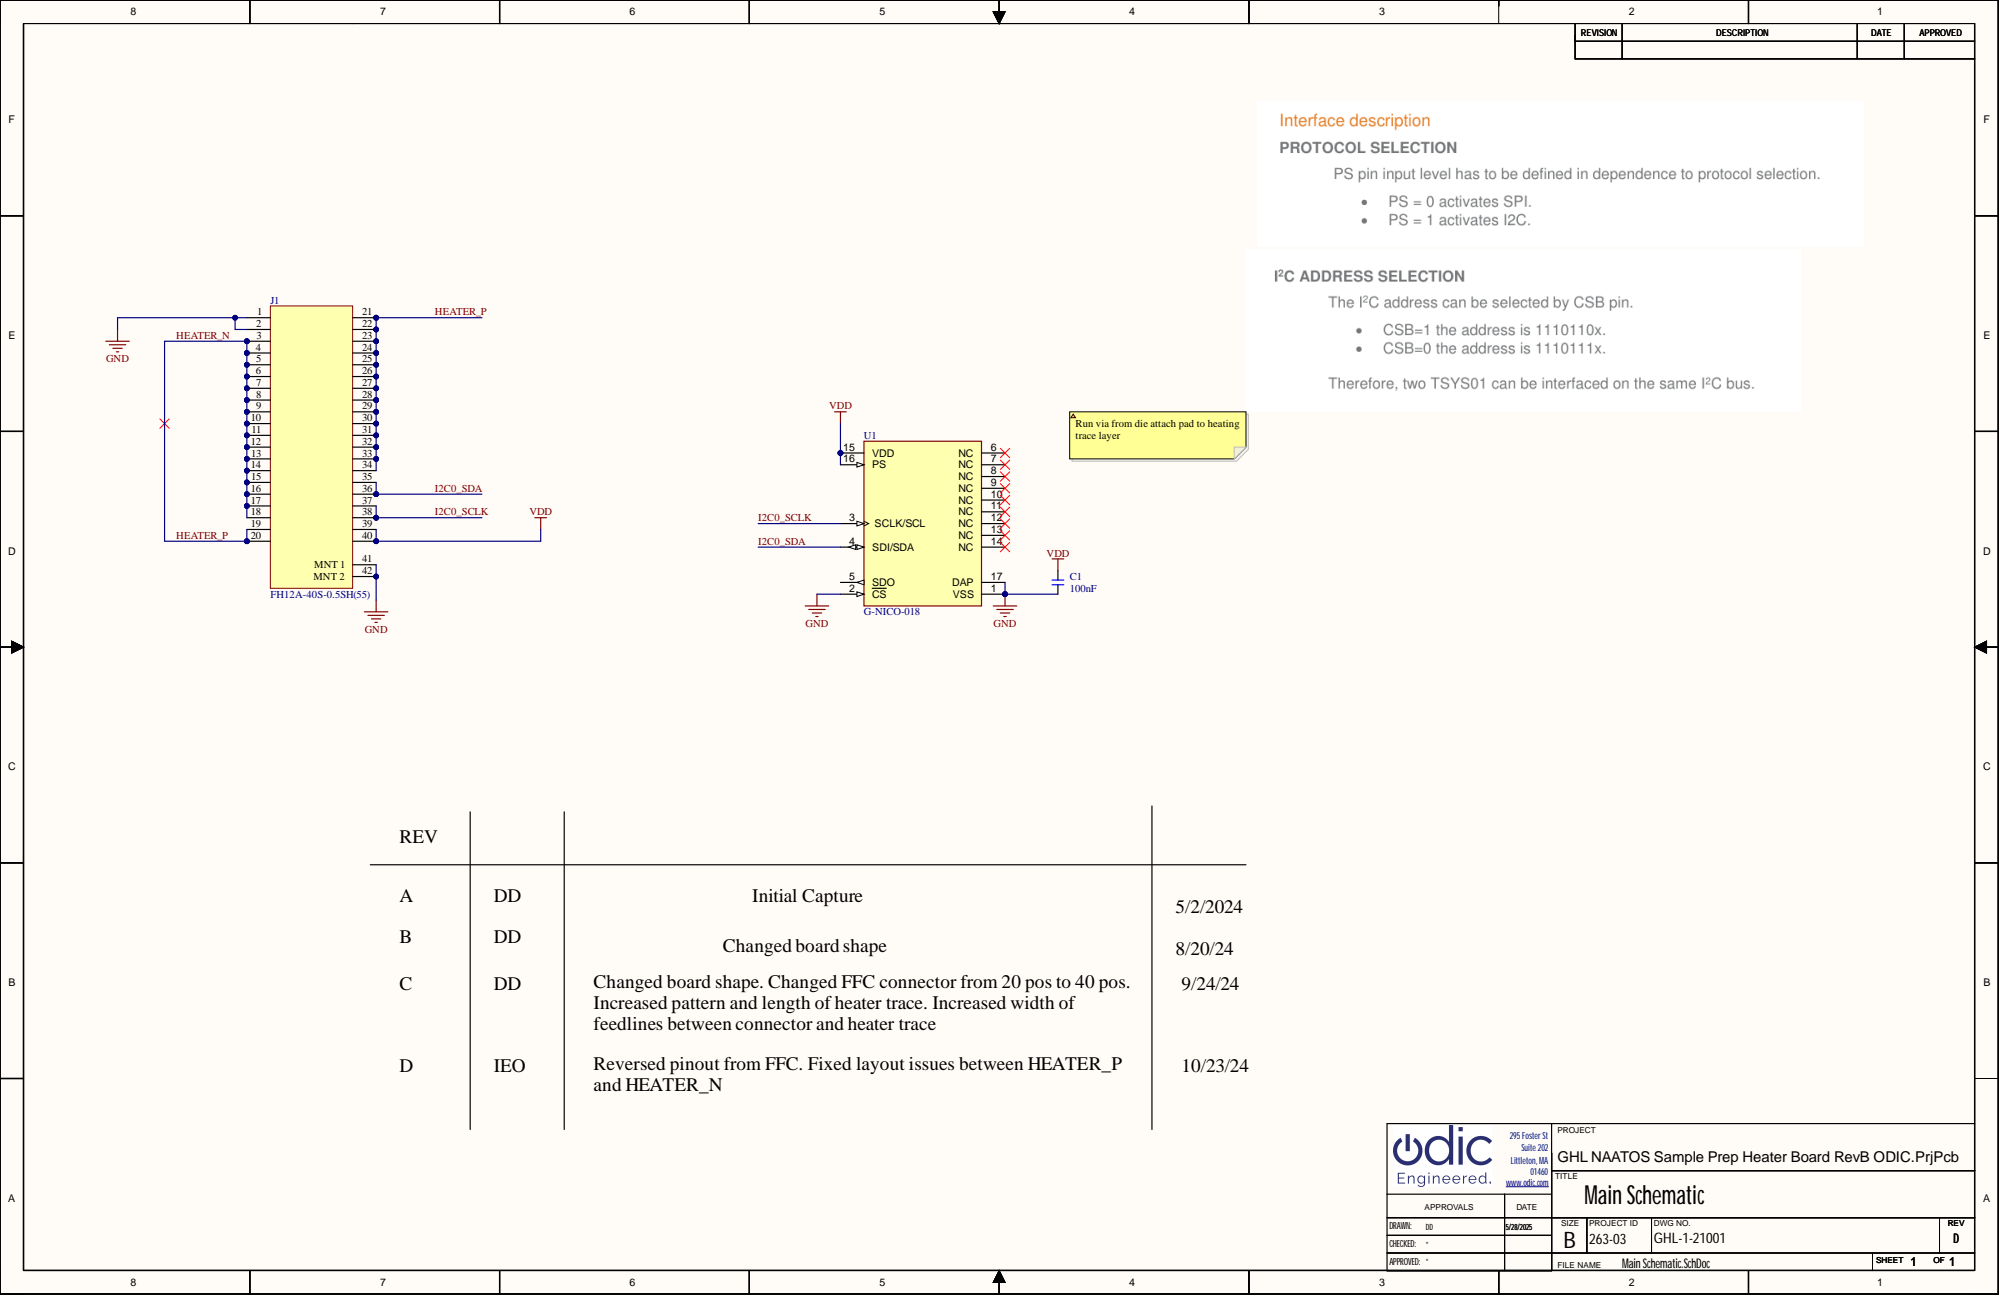
[picture p164: page 1]

1 0 | 3 0
1 1 | 3 1

1 3 | 3 3
1 4 | 3 4
1 5 | 3 5
1 6 | 3 7

heater trace. Increased width
heater trace

ut from FFC. Fixed lay

APPRO VAL S | DATE
DRAWN : DD* | 5/28/2025 | SIZE B | PRO JECT ID 263-03 | DWG NO . GHL-1-2100 1 | REV REV REV D D D

CHECKED :
APPROVED : * | | E M a i n Sch ematic.SchDo c FILE NAM | SHEET SHEET SHEET 1 1 1 O O O F F F 1 1 1
