Global-Health-Labs/nPOC-BB/hw/beta/CAD/derived/drawings/DIX36B.pdf

5 | 4 | 3 | 2

6

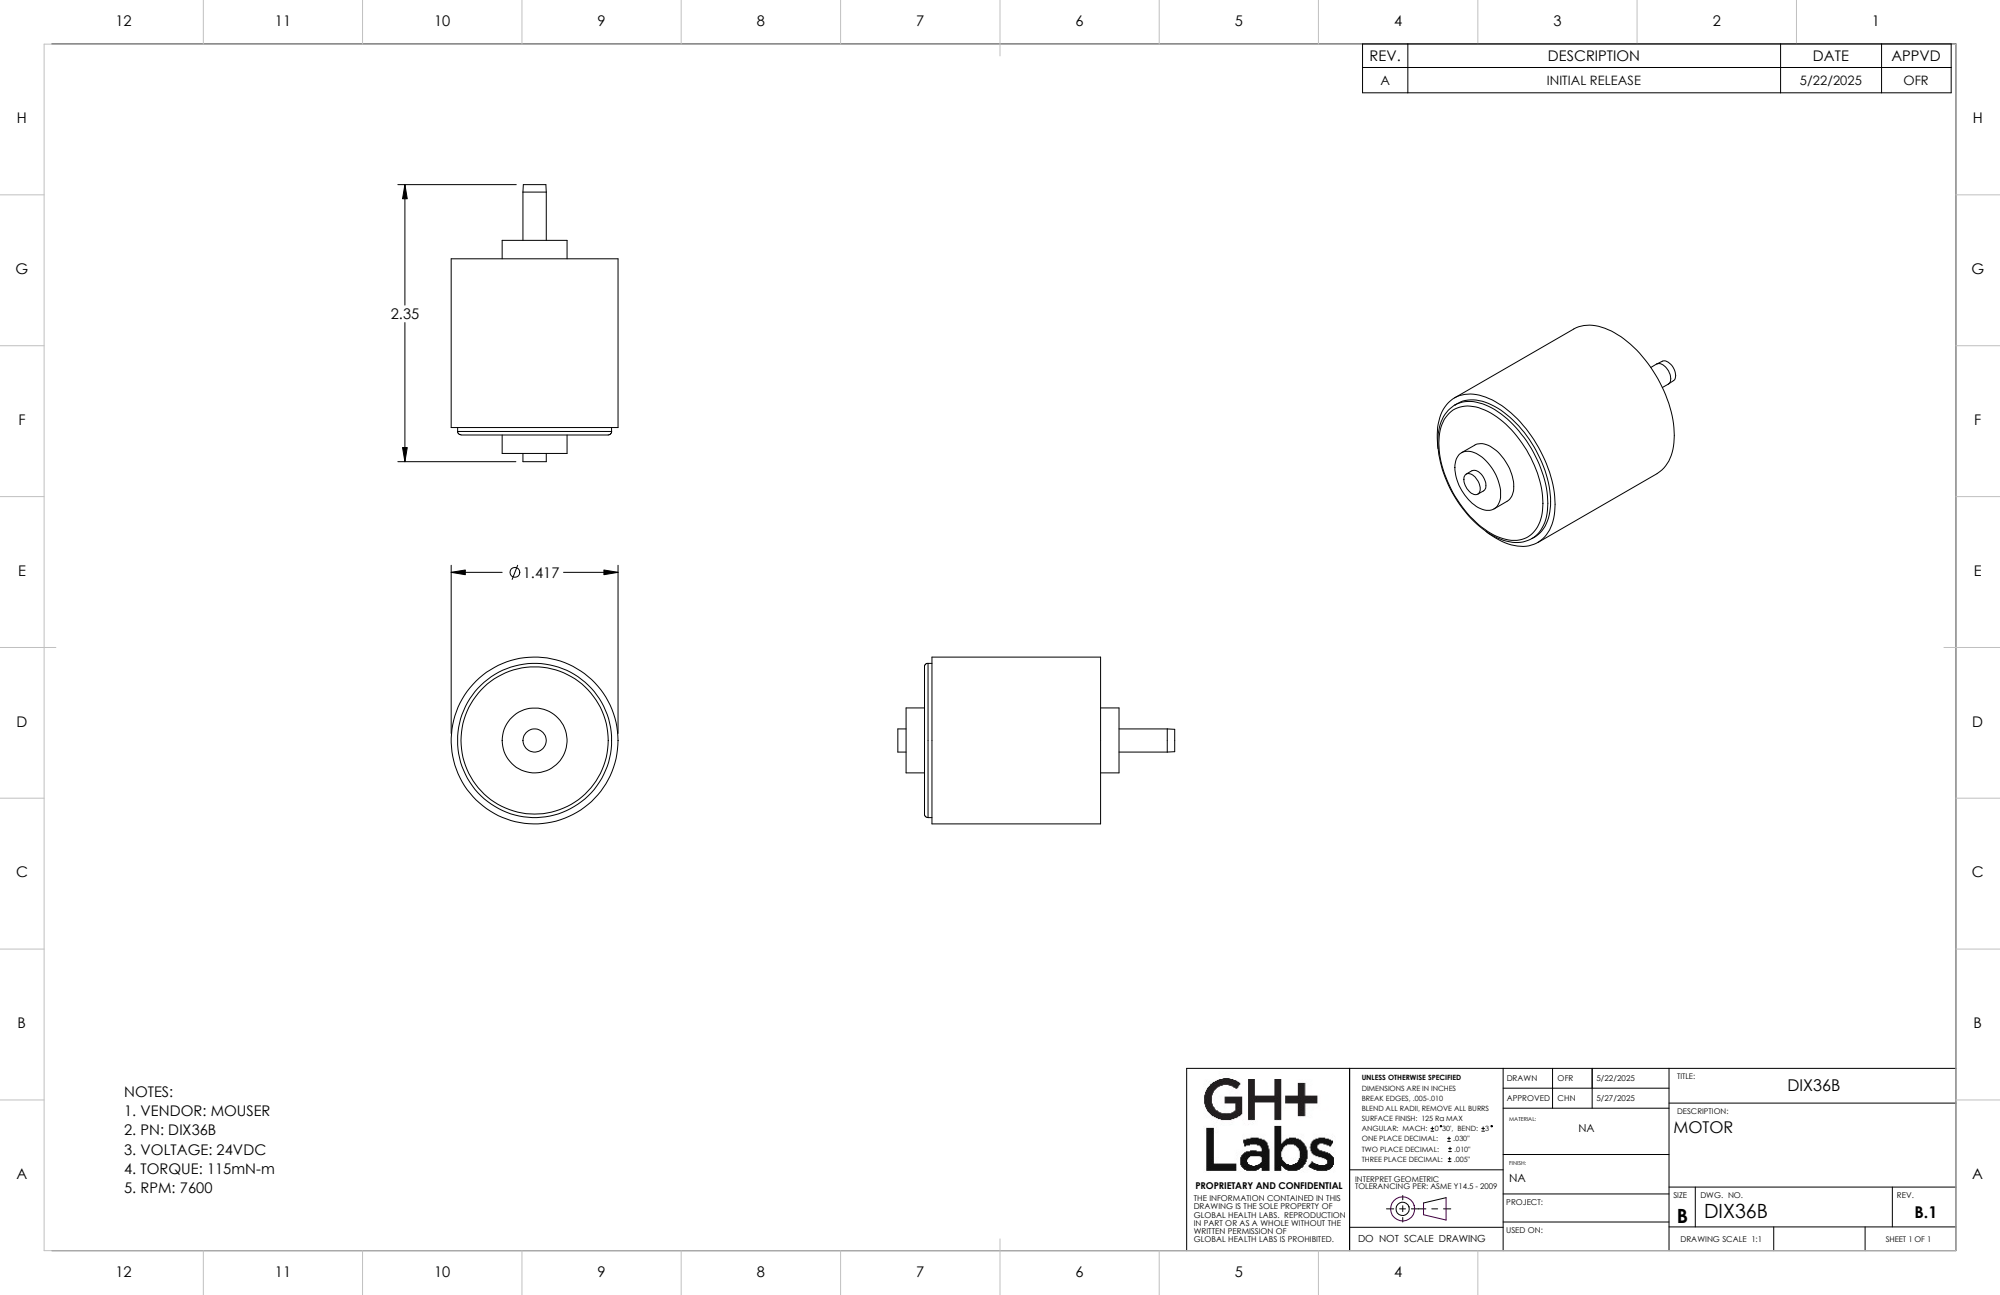
[picture p172: page 1]
PROJECT:; DESCRIPTION:; FINISH:; MATERIAL:; MOTOR; USED ON:; NOTES: 1. VENDOR: MOUSER 2. PN: DIX36B 3. VOLTAGE: 24VDC 4. TORQUE: 115mN-m 5. RPM: 7600

REV. | DESCRIPTION | DATE | APPVD
A | INITIAL RELEASE | 5/22/2025 | OFR

PROPRIETARY AND CONFIDENTIAL THE INFORMATION CONTAINED IN THIS DRAWING IS THE SOLE PROPERTY OF IN PART OR AS A WHOLE WITHOUT THE GLOBAL HEALTH LABS. REPRODUCTION WRITTEN PERMISSION OF GLOBAL HEALTH LABS IS PROHIBITED. | UNLESS OTHERWISE SPECIFIED DIMENSIONS ARE IN INCHES BREAK EDGES, .005-.010 BLEND ALL RADII, REMOVE ALL BURRS SURFACE FINISH: 125 Ra MAX ANGULAR: MACH: 0 30', BEND: 3 ONE PLACE DECIMAL: .030" TWO PLACE DECIMAL: .010" THREE PLACE DECIMAL: .005" | DRAWN | OFR | 5/22/2025 | TITLE: DIX36B

APPROVED | CHN | 5/27/2025

INTERPRET GEOMETRIC
TOLERANCING PER: ASME Y14.5 - 2009

SIZE B | DWG. NO. DIX36B | REV. B.1

DO NOT SCALE DRAWING | | DRAWING SCALE 1:1 | SHEET 1 OF 1
