Global-Health-Labs/nPOC-BB/hw/beta/CAD/derived/drawings/GHL-1-20003.pdf

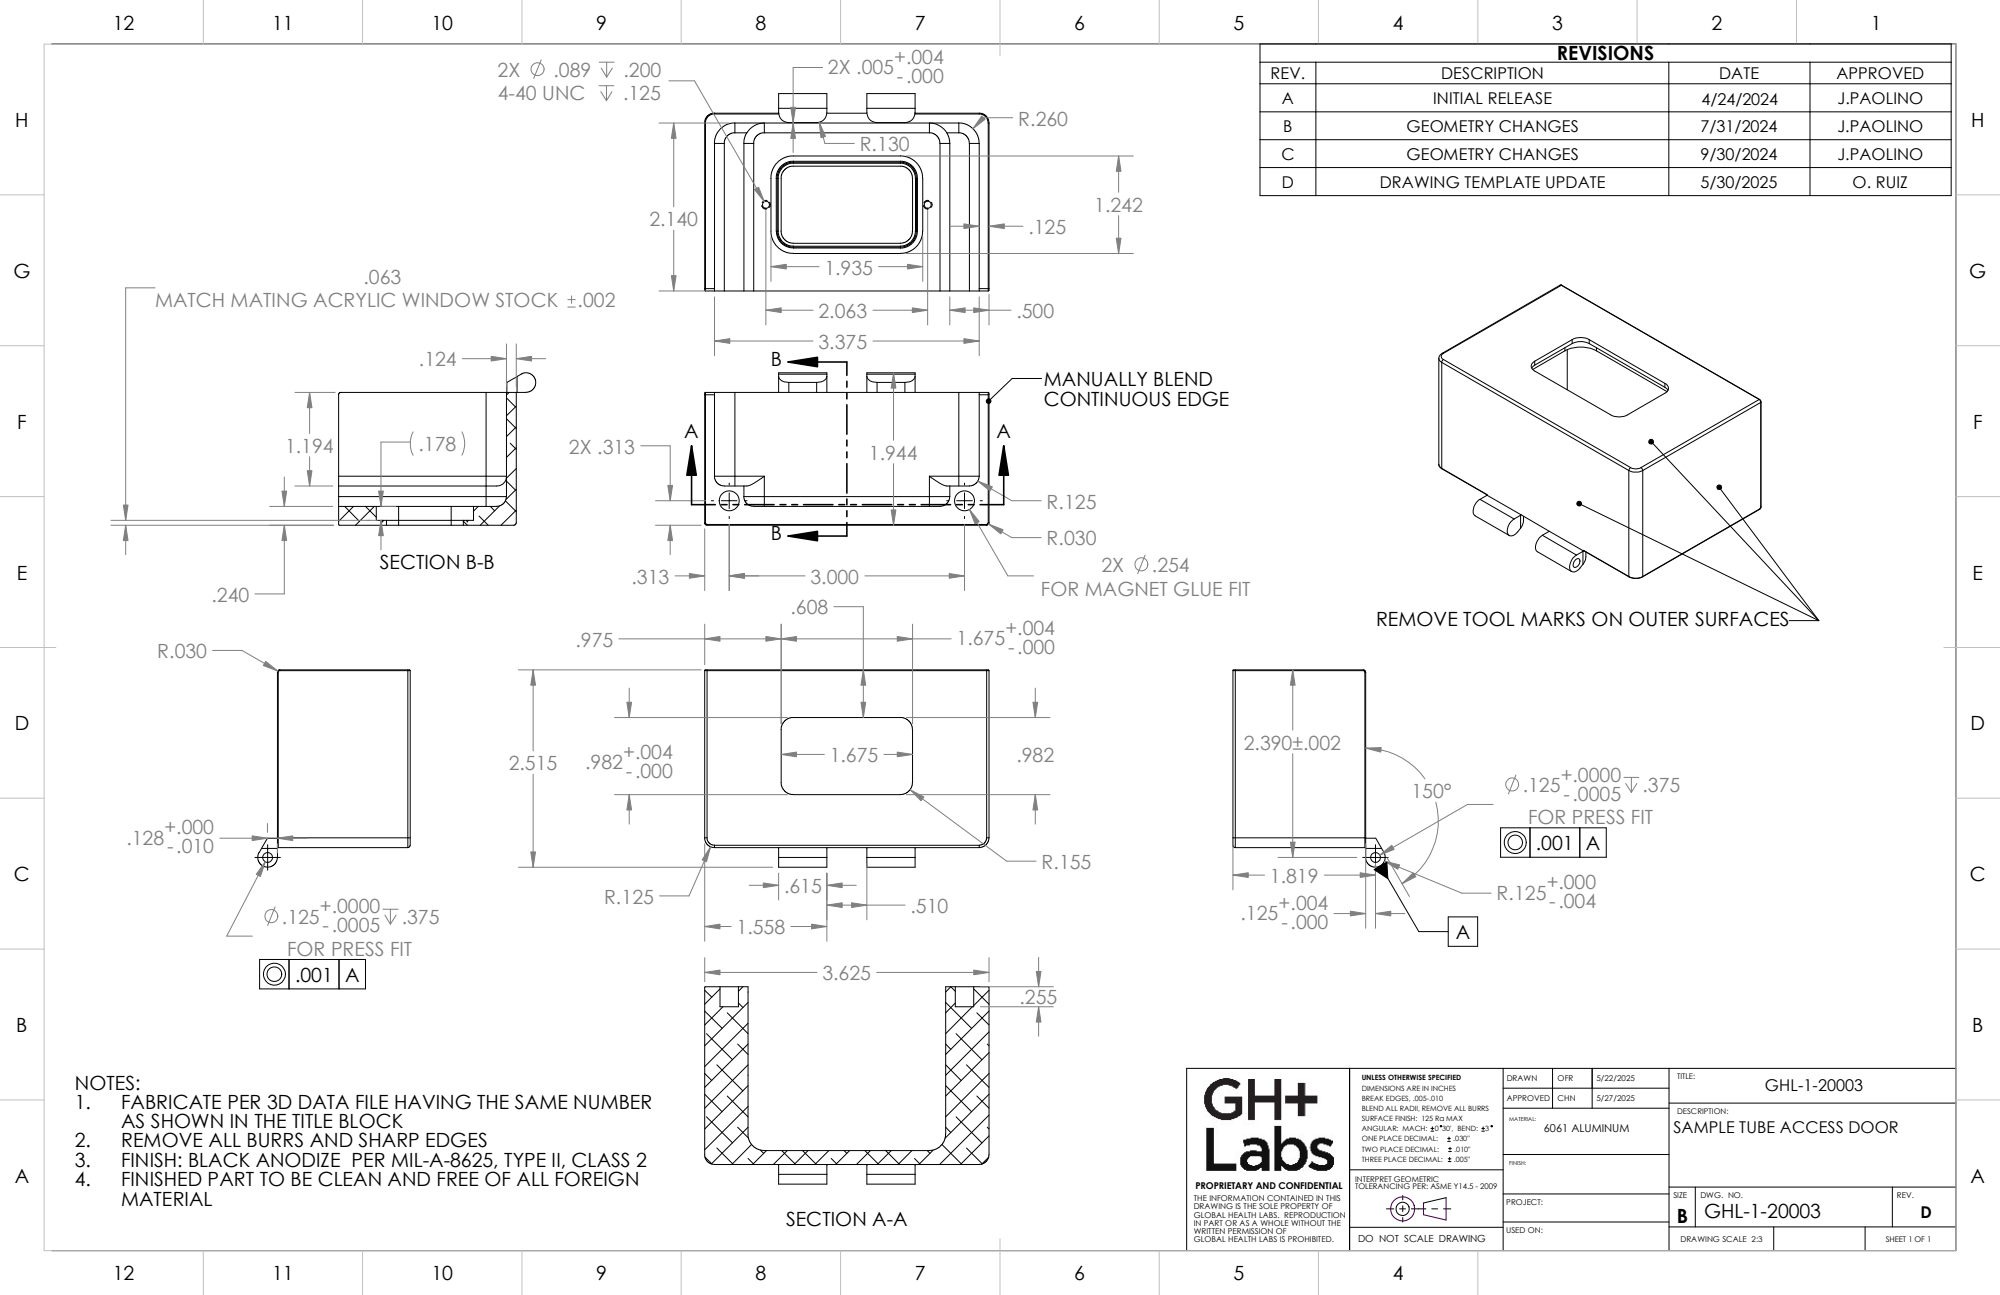
[picture p173: page 1]
PROJECT:; FINISH:; MATERIAL:; 6061 ALUMINUM; USED ON:; SECTION B-B; 4-40 UNC; MANUALLY BLEND CONTINUOUS EDGE; FOR MAGNET GLUE FIT; FOR PRESS FIT; SECTION A-A

REVISIONS

REV. | DESCRIPTION | DATE | APPROVED
A | INITIAL RELEASE | 4/24/2024 | J.PAOLINO
B | GEOMETRY CHANGES | 7/31/2024 | J.PAOLINO
C | GEOMETRY CHANGES | 9/30/2024 | J.PAOLINO
D | DRAWING TEMPLATE UPDATE | 5/30/2025 | O. RUIZ

MATCH MATING ACRYLIC WINDOW STOCK

REMOVE TOOL MARKS ON OUTER SURFACES

NOTES:
1. FABRICATE PER 3D DATA FILE HAVING THE SAME NUMBER
AS SHOWN IN THE TITLE BLOCK
2. REMOVE ALL BURRS AND SHARP EDGES
3. FINISH: BLACK ANODIZE PER MIL-A-8625, TYPE II, CLASS 2
4. FINISHED PART TO BE CLEAN AND FREE OF ALL FOREIGN
MATERIAL

PROPRIETARY AND CONFIDENTIAL THE INFORMATION CONTAINED IN THIS DRAWING IS THE SOLE PROPERTY OF GLOBAL HEALTH LABS. REPRODUCTION IN PART OR AS A WHOLE WITHOUT THE WRITTEN PERMISSION OF GLOBAL HEALTH LABS IS PROHIBITED. | UNLESS OTHERWISE SPECIFIED DIMENSIONS ARE IN INCHES BREAK EDGES, .005-.010 BLEND ALL RADII, REMOVE ALL BURRS SURFACE FINISH: 125 Ra MAX ANGULAR: MACH: 0 30', BEND: 3 ONE PLACE DECIMAL: .030" TWO PLACE DECIMAL: .010" THREE PLACE DECIMAL: .005" | DRAWN | OFR | 5/22/2025 | TITLE: GHL-1-20003

APPROVED | CHN | 5/27/2025

DESCRIPTION:
SAMPLE TUBE ACCESS DOOR

INTERPRET GEOMETRIC TOLERANCING PER: ASME Y14.5 - 2009

SIZE B | DWG. NO. GHL-1-20003 | REV. D

DO NOT SCALE DRAWING | | DRAWING SCALE 2:3 | SHEET 1 OF 1
