Global-Health-Labs/nPOC-BB/hw/beta/CAD/derived/drawings/GHL-1-20009.pdf

1

4 | 3 | 2

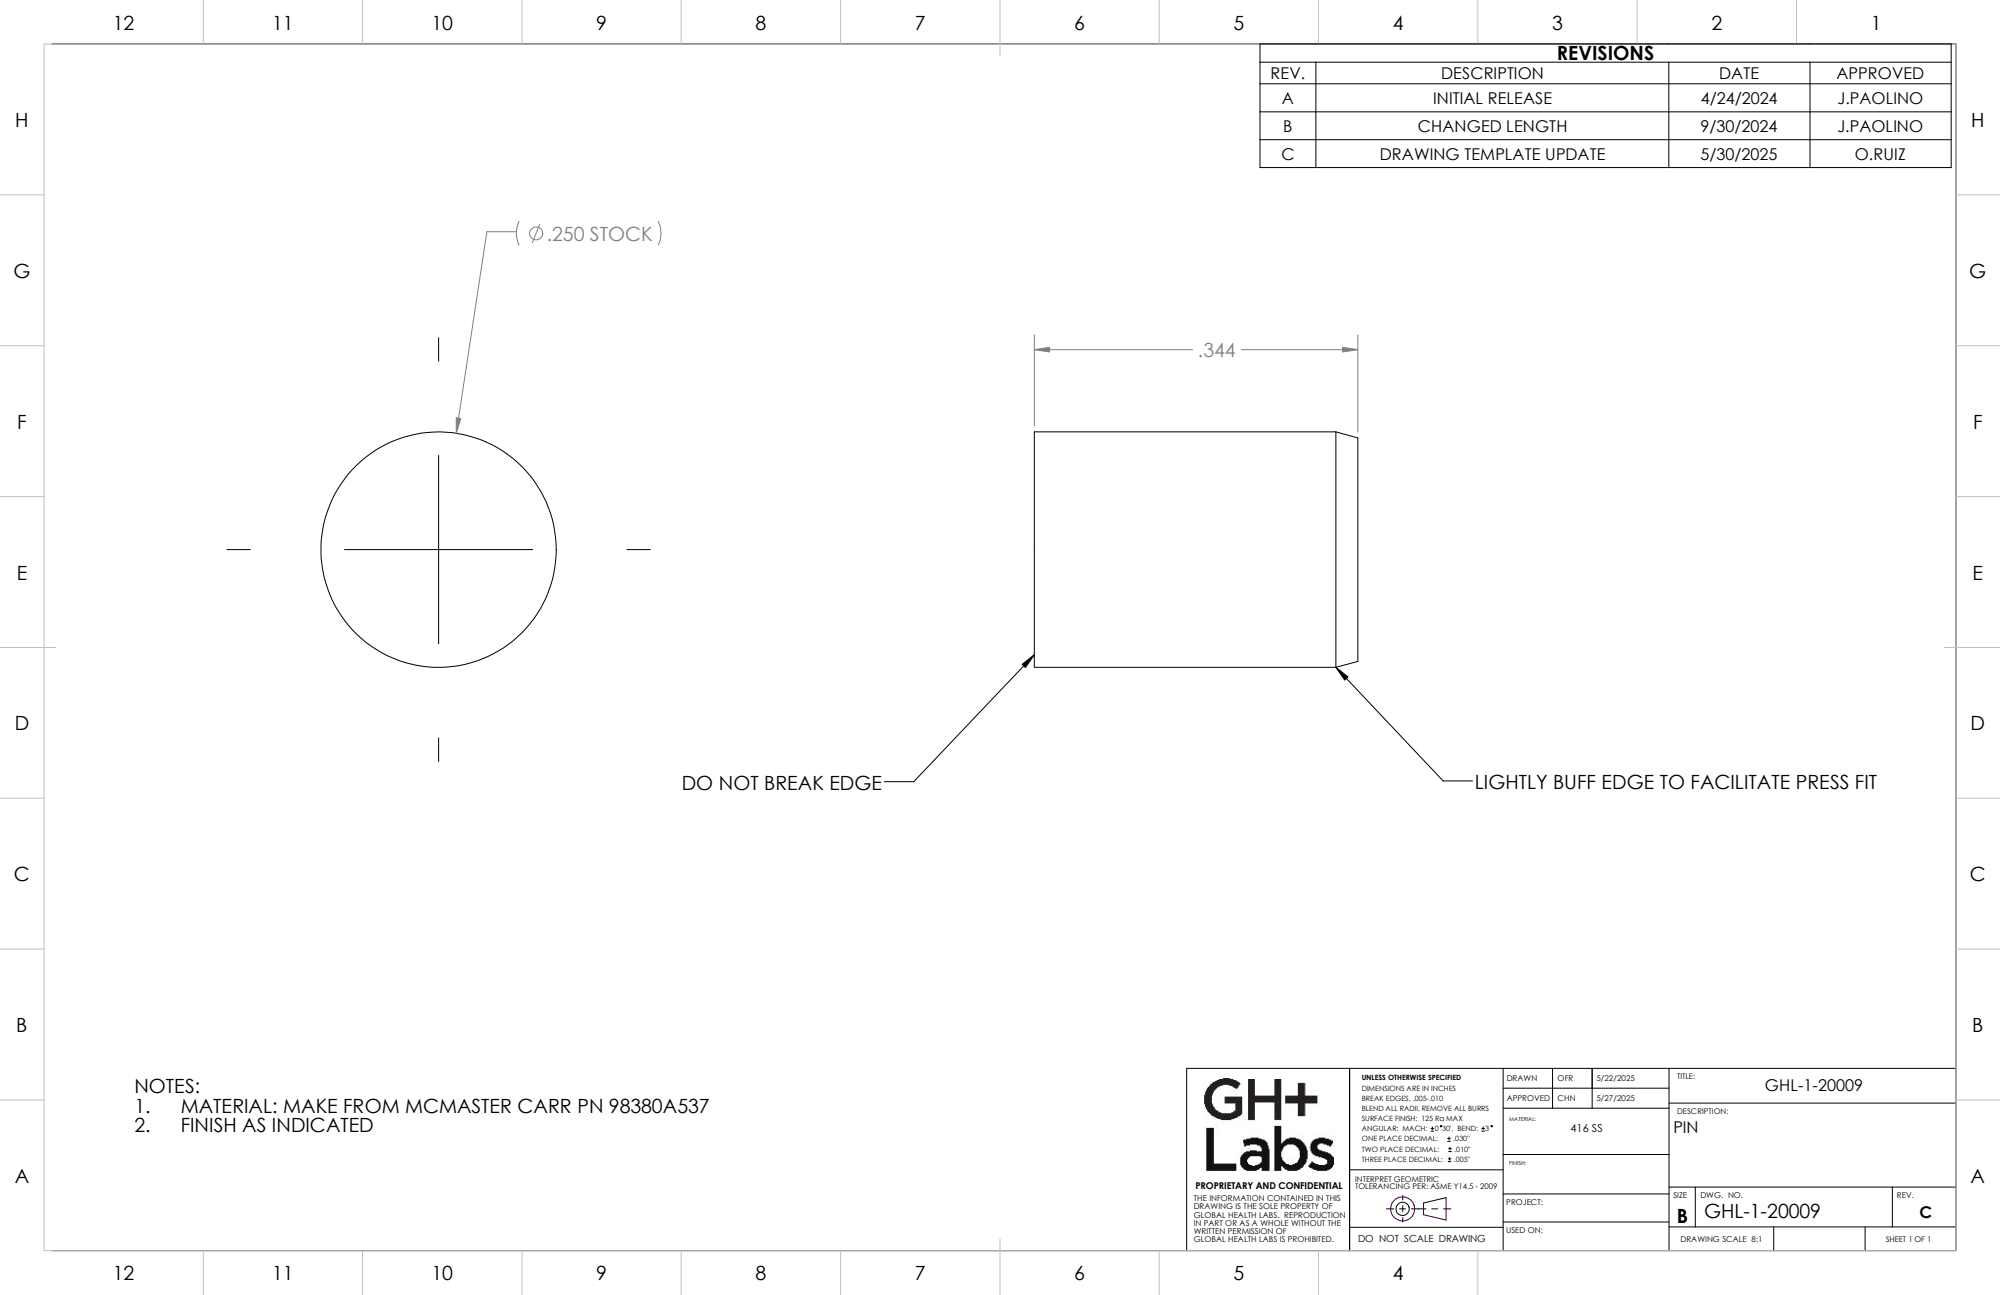
[picture p176: page 1]
PROJECT:; DESCRIPTION:; FINISH:; MATERIAL:; PIN; USED ON:; DO NOT BREAK EDGE; LIGHTLY BUFF EDGE TO FACILITATE PRESS FIT; .250 STOCK

REVISIONS

REV. | DESCRIPTION | DATE | APPROVED
A | INITIAL RELEASE | 4/24/2024 | J.PAOLINO
B | CHANGED LENGTH | 9/30/2024 | J.PAOLINO
C | DRAWING TEMPLATE UPDATE | 5/30/2025 | O.RUIZ

NOTES:
1. MATERIAL: MAKE FROM MCMASTER CARR PN 98380A537
2. FINISH AS INDICATED

PROPRIETARY AND CONFIDENTIAL THE INFORMATION CONTAINED IN THIS DRAWING IS THE SOLE PROPERTY OF GLOBAL HEALTH LABS. REPRODUCTION IN PART OR AS A WHOLE WITHOUT THE WRITTEN PERMISSION OF GLOBAL HEALTH LABS IS PROHIBITED. | UNLESS OTHERWISE SPECIFIED DIMENSIONS ARE IN INCHES BREAK EDGES, .005-.010 BLEND ALL RADII, REMOVE ALL BURRS SURFACE FINISH: 125 Ra MAX ANGULAR: MACH: 0 30', BEND: 3 ONE PLACE DECIMAL: .030" TWO PLACE DECIMAL: .010" THREE PLACE DECIMAL: .005" | DRAWN | OFR | 5/22/2025 | TITLE: GHL-1-20009

APPROVED | CHN | 5/27/2025

INTERPRET GEOMETRIC TOLERANCING PER: ASME Y14.5 - 2009

SIZE B | DWG. NO. GHL-1-20009 | REV. C

DO NOT SCALE DRAWING | | DRAWING SCALE 8:1 | SHEET 1 OF 1
