Global-Health-Labs/nPOC-BB/hw/beta/CAD/derived/drawings/GHL-1-20014.pdf

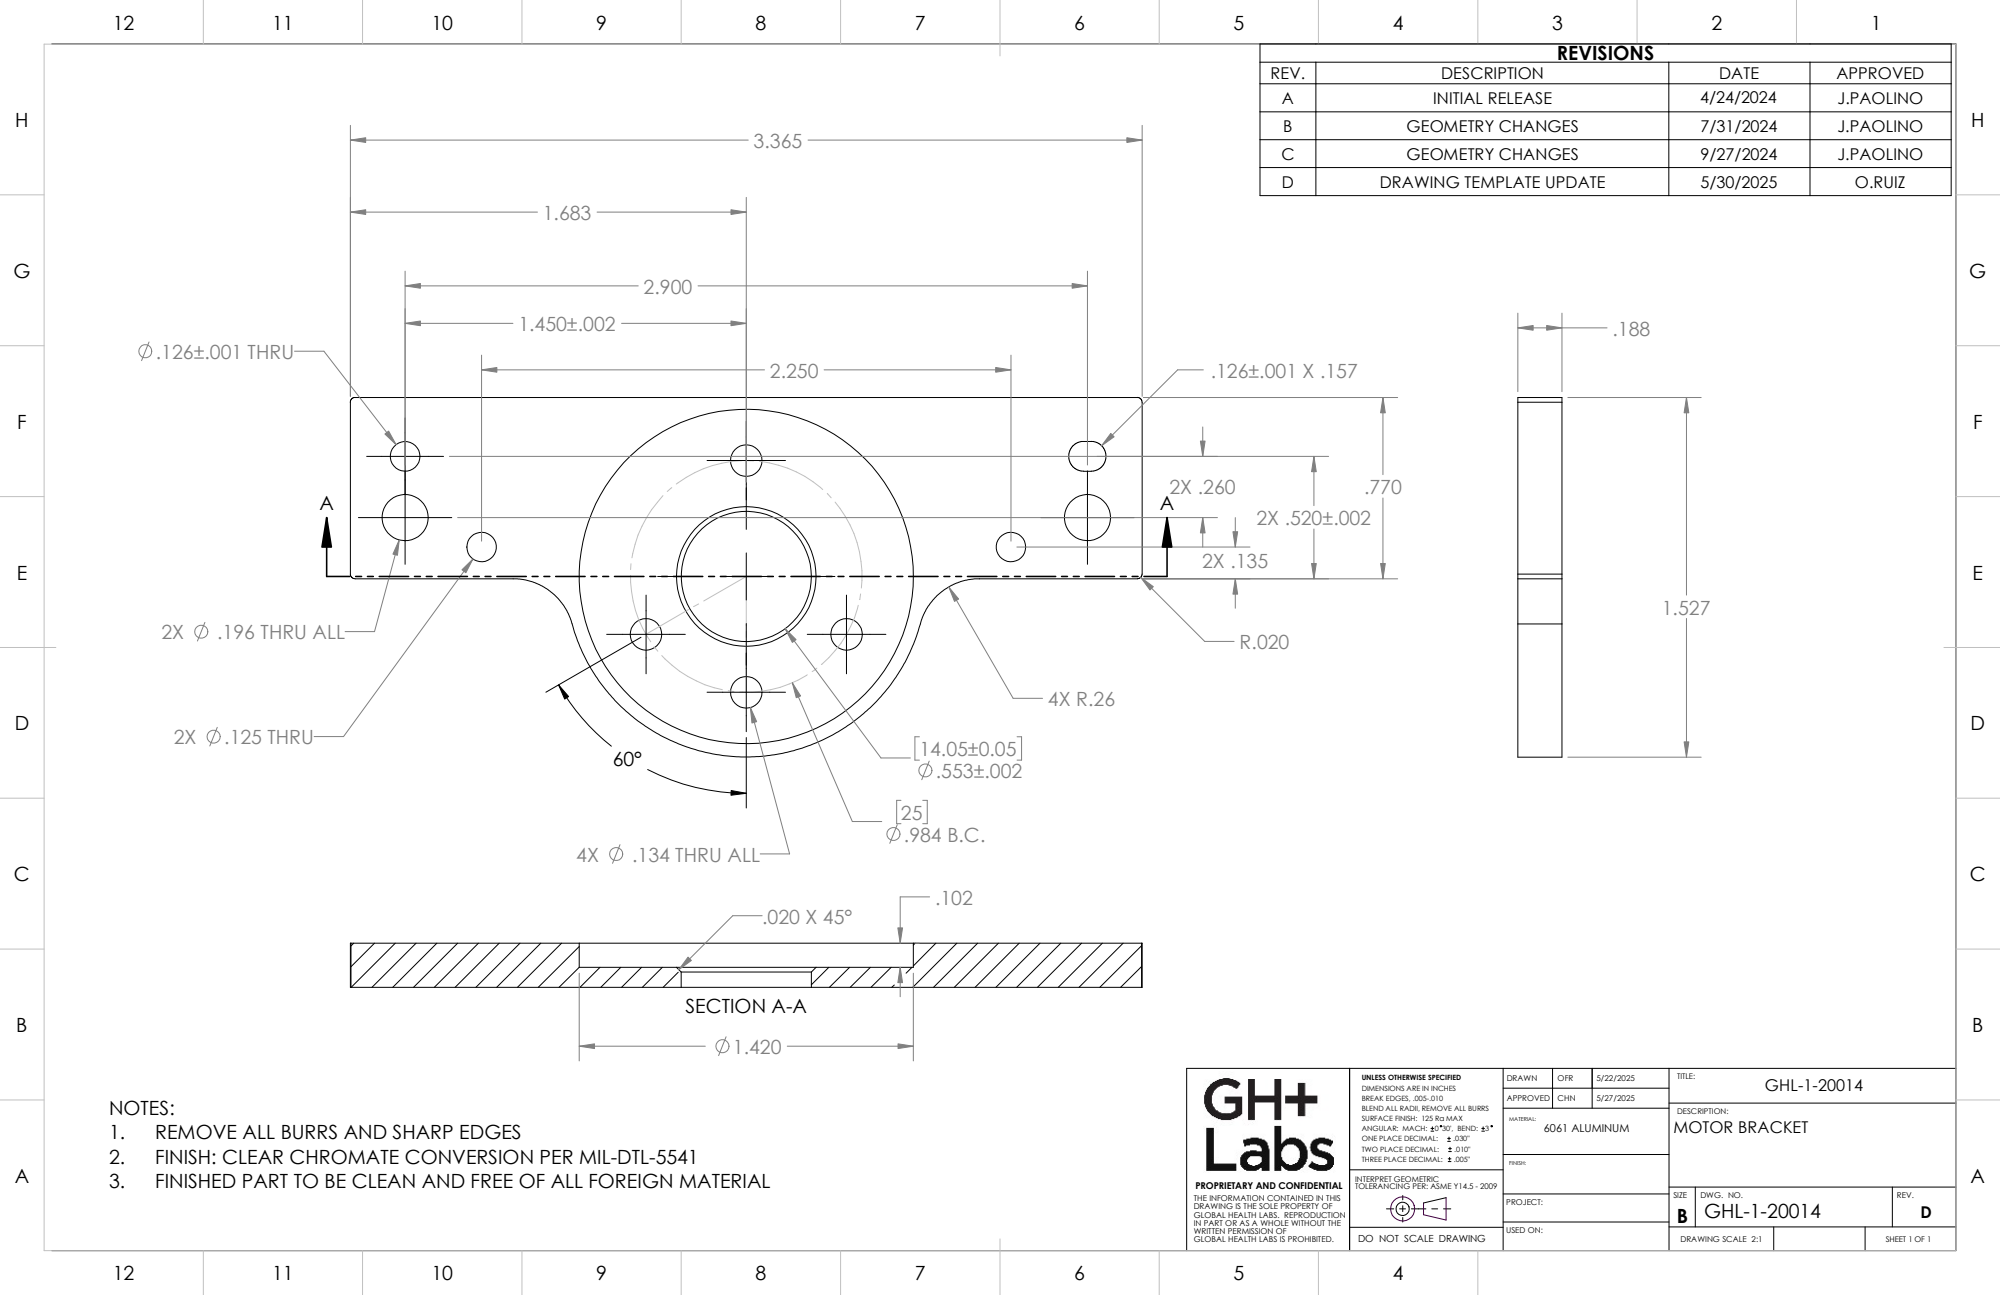
[picture p178: page 1]
PROJECT:; DESCRIPTION:; FINISH:; MATERIAL:; 6061 ALUMINUM; MOTOR BRACKET; USED ON:; SECTION A-A; 2X .125 THRU; .134 THRU ALL; .196 THRU ALL; .126±.001 THRU

REVISIONS

REV. | DESCRIPTION | DATE | APPROVED
A | INITIAL RELEASE | 4/24/2024 | J.PAOLINO
B | GEOMETRY CHANGES | 7/31/2024 | J.PAOLINO
C | GEOMETRY CHANGES | 9/27/2024 | J.PAOLINO
D | DRAWING TEMPLATE UPDATE | 5/30/2025 | O.RUIZ

PROPRIETARY AND CONFIDENTIAL THE INFORMATION CONTAINED IN THIS DRAWING IS THE SOLE PROPERTY OF GLOBAL HEALTH LABS. REPRODUCTION IN PART OR AS A WHOLE WITHOUT THE WRITTEN PERMISSION OF GLOBAL HEALTH LABS IS PROHIBITED. | UNLESS OTHERWISE SPECIFIED DIMENSIONS ARE IN INCHES BREAK EDGES, .005-.010 BLEND ALL RADII, REMOVE ALL BURRS SURFACE FINISH: 125 Ra MAX ANGULAR: MACH: 0 30', BEND: 3 ONE PLACE DECIMAL: .030" TWO PLACE DECIMAL: .010" THREE PLACE DECIMAL: .005" | DRAWN | OFR | 5/22/2025 | TITLE: GHL-1-20014

NOTES:
1. REMOVE ALL BURRS AND SHARP EDGES
2. FINISH: CLEAR CHROMATE CONVERSION PER MIL-DTL-5541
3. FINISHED PART TO BE CLEAN AND FREE OF ALL FOREIGN MATERIAL

APPROVED | CHN | 5/27/2025

INTERPRET GEOMETRIC TOLERANCING PER: ASME Y14.5 - 2009

SIZE B | DWG. NO. GHL-1-20014 | REV. D

DO NOT SCALE DRAWING | | DRAWING SCALE 2:1 | SHEET 1 OF 1
