Global-Health-Labs/nPOC-BB/hw/beta/CAD/derived/drawings/GHL-1-20019.pdf

2

4 3

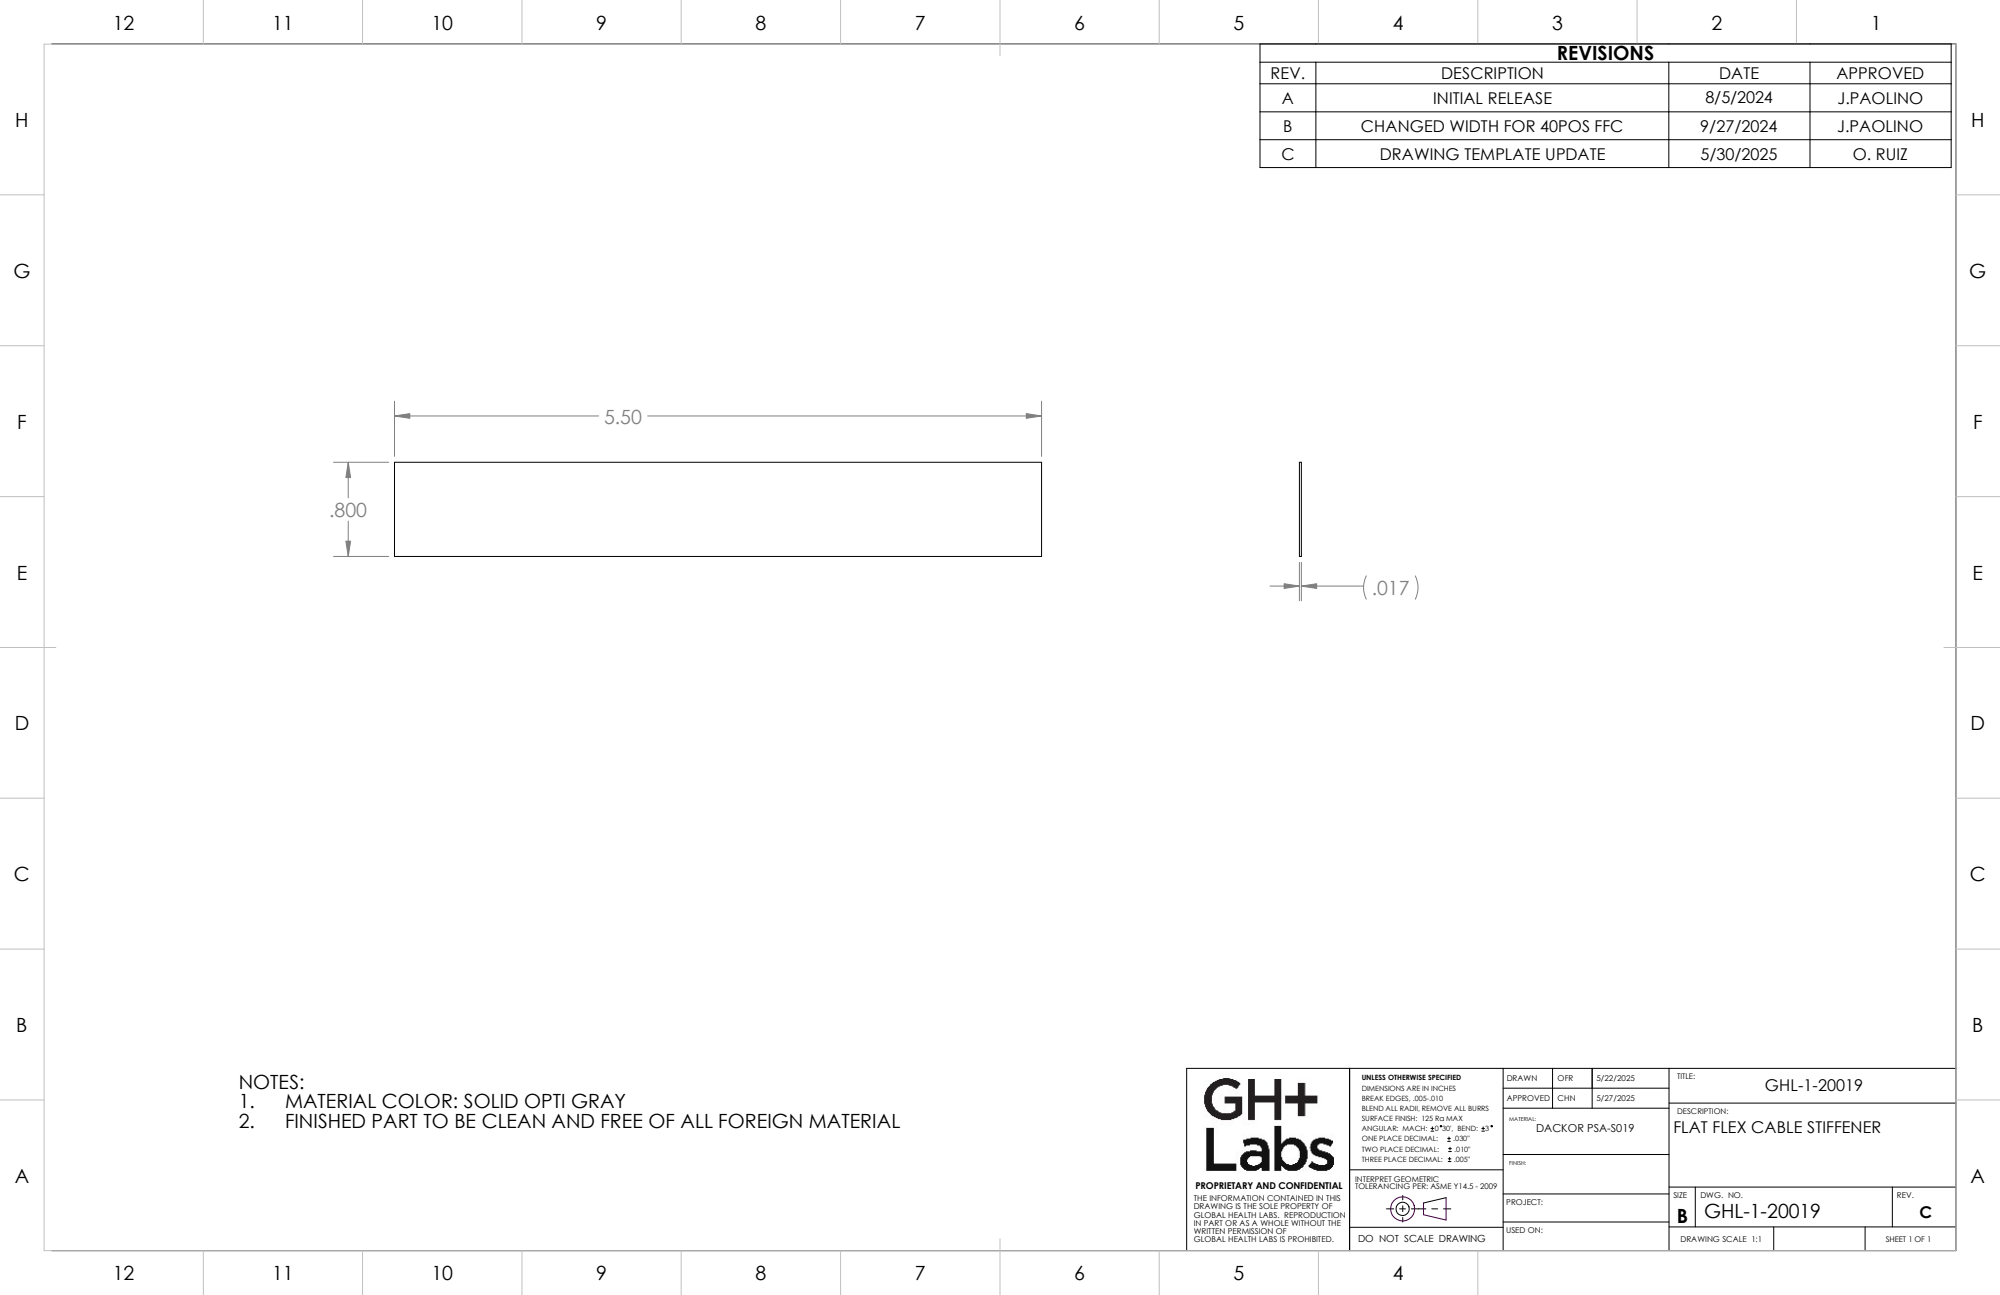
[picture p180: page 1]
PROJECT:; FINISH:; MATERIAL: DACKOR PSA-S019; USED ON:

REVISIONS

REV. | DESCRIPTION | DATE | APPROVED
A | INITIAL RELEASE | 8/5/2024 | J.PAOLINO
B | CHANGED WIDTH FOR 40POS FFC | 9/27/2024 | J.PAOLINO
C | DRAWING TEMPLATE UPDATE | 5/30/2025 | O. RUIZ

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

PROPRIETARY AND CONFIDENTIAL THE INFORMATION CONTAINED IN THIS DRAWING IS THE SOLE PROPERTY OF GLOBAL HEALTH LABS. REPRODUCTION IN PART OR AS A WHOLE WITHOUT THE WRITTEN PERMISSION OF GLOBAL HEALTH LABS IS PROHIBITED. | UNLESS OTHERWISE SPECIFIED DIMENSIONS ARE IN INCHES BREAK EDGES, .005-.010 BLEND ALL RADII, REMOVE ALL BURRS SURFACE FINISH: 125 Ra MAX ANGULAR: MACH: 0 30', BEND: 3 ONE PLACE DECIMAL: .030" TWO PLACE DECIMAL: .010" THREE PLACE DECIMAL: .005" | DRAWN | OFR | 5/22/2025 | TITLE: GHL-1-20019

APPROVED | CHN | 5/27/2025

DESCRIPTION:
FLAT FLEX CABLE STIFFENER

INTERPRET GEOMETRIC TOLERANCING PER: ASME Y14.5 - 2009

SIZE B | DWG. NO. GHL-1-20019 | REV. C

DO NOT SCALE DRAWING | | DRAWING SCALE 1:1 | SHEET 1 OF 1
