Global-Health-Labs/nPOC-BB/hw/beta/CAD/derived/drawings/GHL-1-20020.pdf

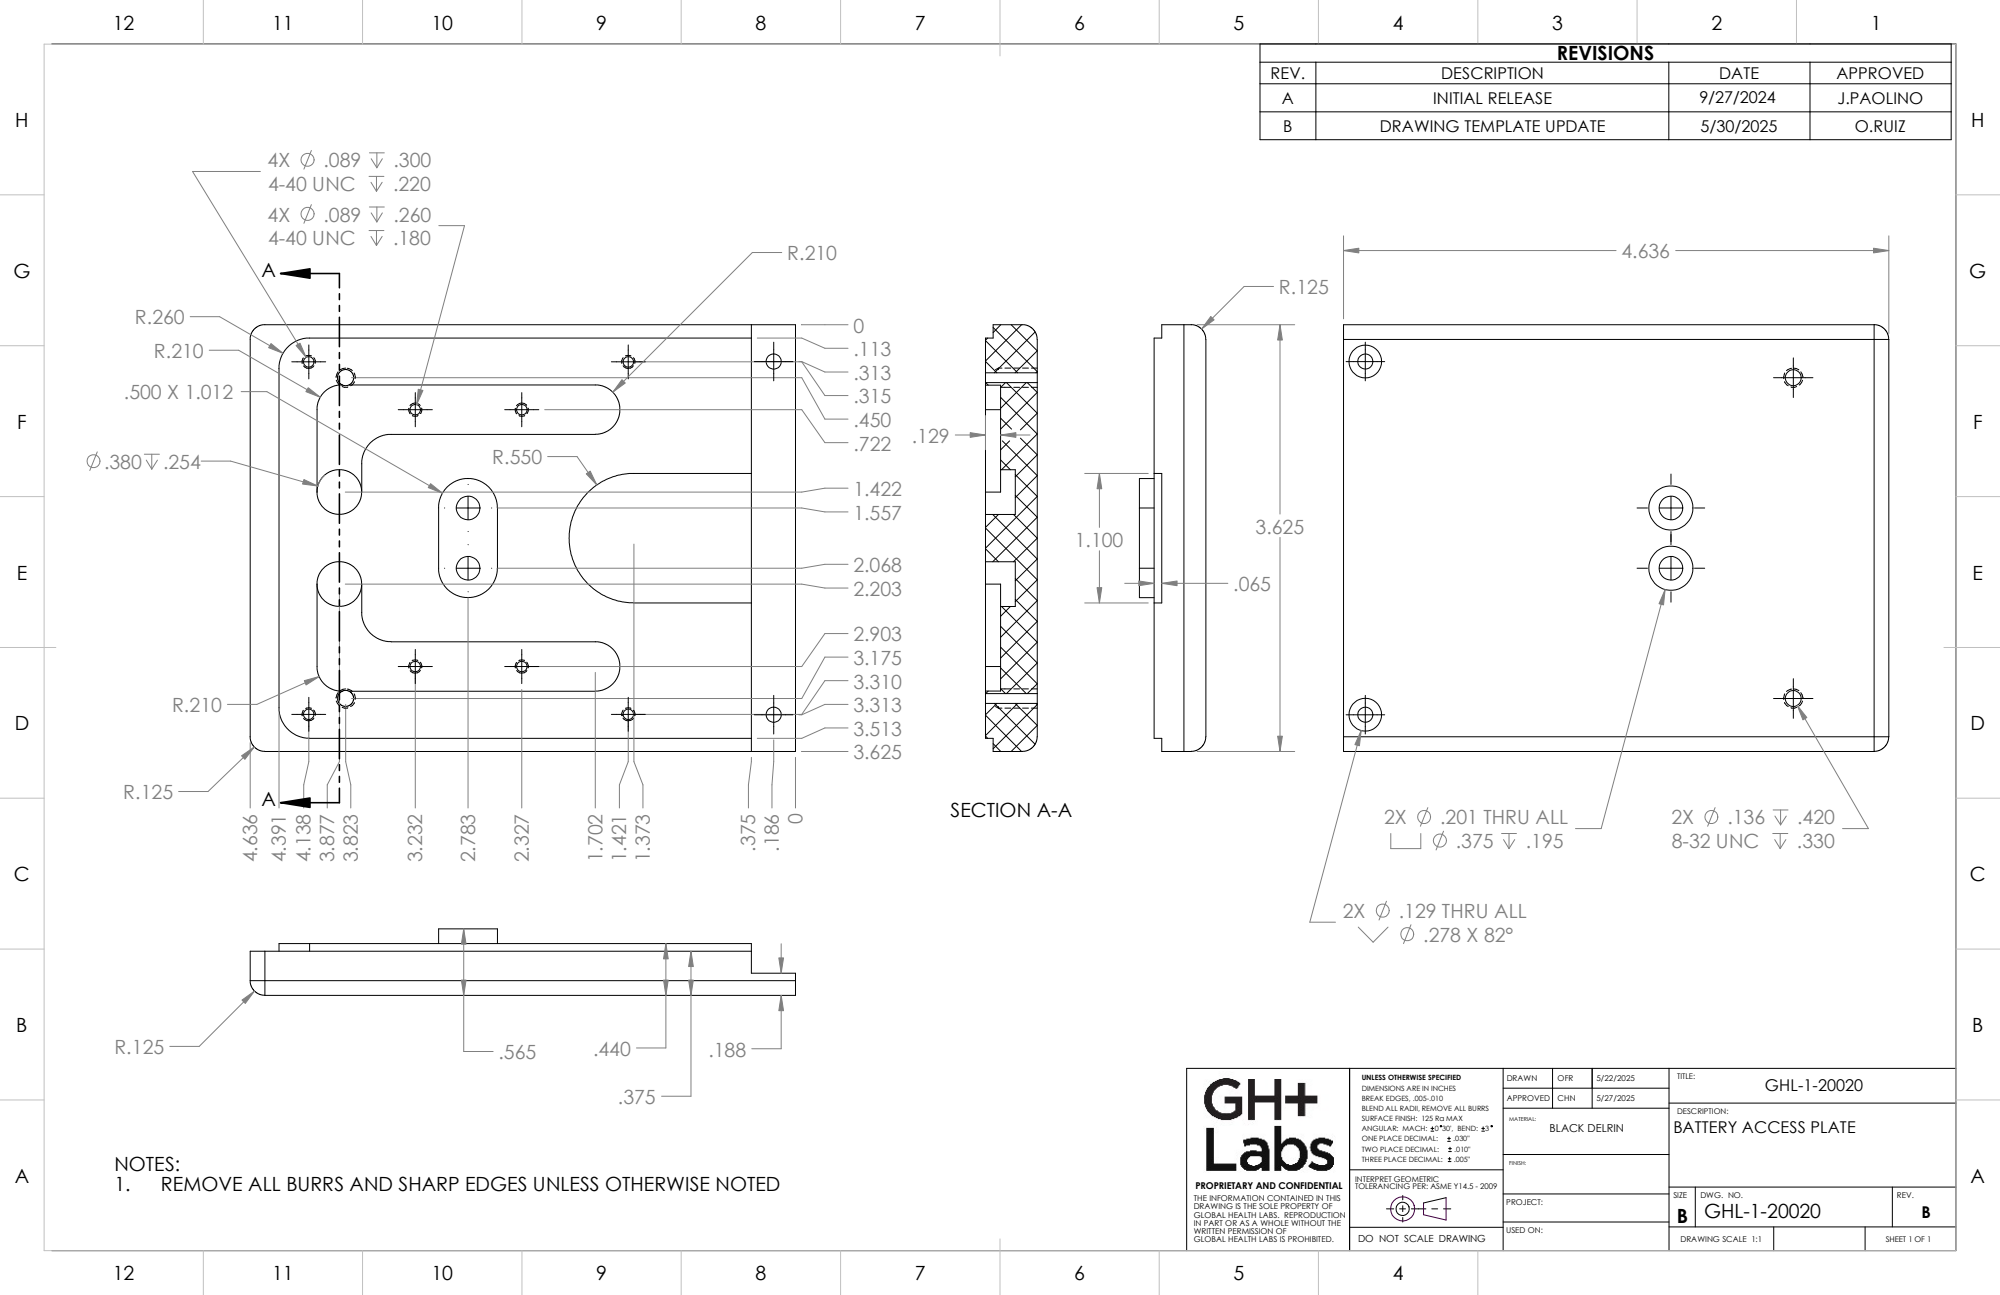
[picture p181: page 1]
PROJECT:; FINISH:; MATERIAL:; BLACK DELRIN; USED ON:; 8-32 UNC; .201 THRU ALL .195; .129 THRU ALL; SECTION A-A; 4-40 UNC; 4-40 UNC .089

REVISIONS

REV. | DESCRIPTION | DATE | APPROVED
A | INITIAL RELEASE | 9/27/2024 | J.PAOLINO
B | DRAWING TEMPLATE UPDATE | 5/30/2025 | O.RUIZ

PROPRIETARY AND CONFIDENTIAL THE INFORMATION CONTAINED IN THIS DRAWING IS THE SOLE PROPERTY OF GLOBAL HEALTH LABS. REPRODUCTION IN PART OR AS A WHOLE WITHOUT THE WRITTEN PERMISSION OF GLOBAL HEALTH LABS IS PROHIBITED. | UNLESS OTHERWISE SPECIFIED DIMENSIONS ARE IN INCHES BREAK EDGES, .005-.010 BLEND ALL RADII, REMOVE ALL BURRS SURFACE FINISH: 125 Ra MAX ANGULAR: MACH: 0 30', BEND: 3 ONE PLACE DECIMAL: .030" TWO PLACE DECIMAL: .010" THREE PLACE DECIMAL: .005" | DRAWN | OFR | 5/22/2025 | TITLE: GHL-1-20020

APPROVED | CHN | 5/27/2025

DESCRIPTION:
BATTERY ACCESS PLATE

NOTES:
1. REMOVE ALL BURRS AND SHARP EDGES UNLESS OTHERWISE NOTED

INTERPRET GEOMETRIC TOLERANCING PER: ASME Y14.5 - 2009

SIZE B GHL-1-20020 | DWG. NO. | REV. B

DO NOT SCALE DRAWING | | DRAWING SCALE 1:1 | SHEET 1 OF 1
