Global-Health-Labs/nPOC-BB/hw/beta/CAD/derived/drawings/GHL-1-20021.pdf

1.497

2

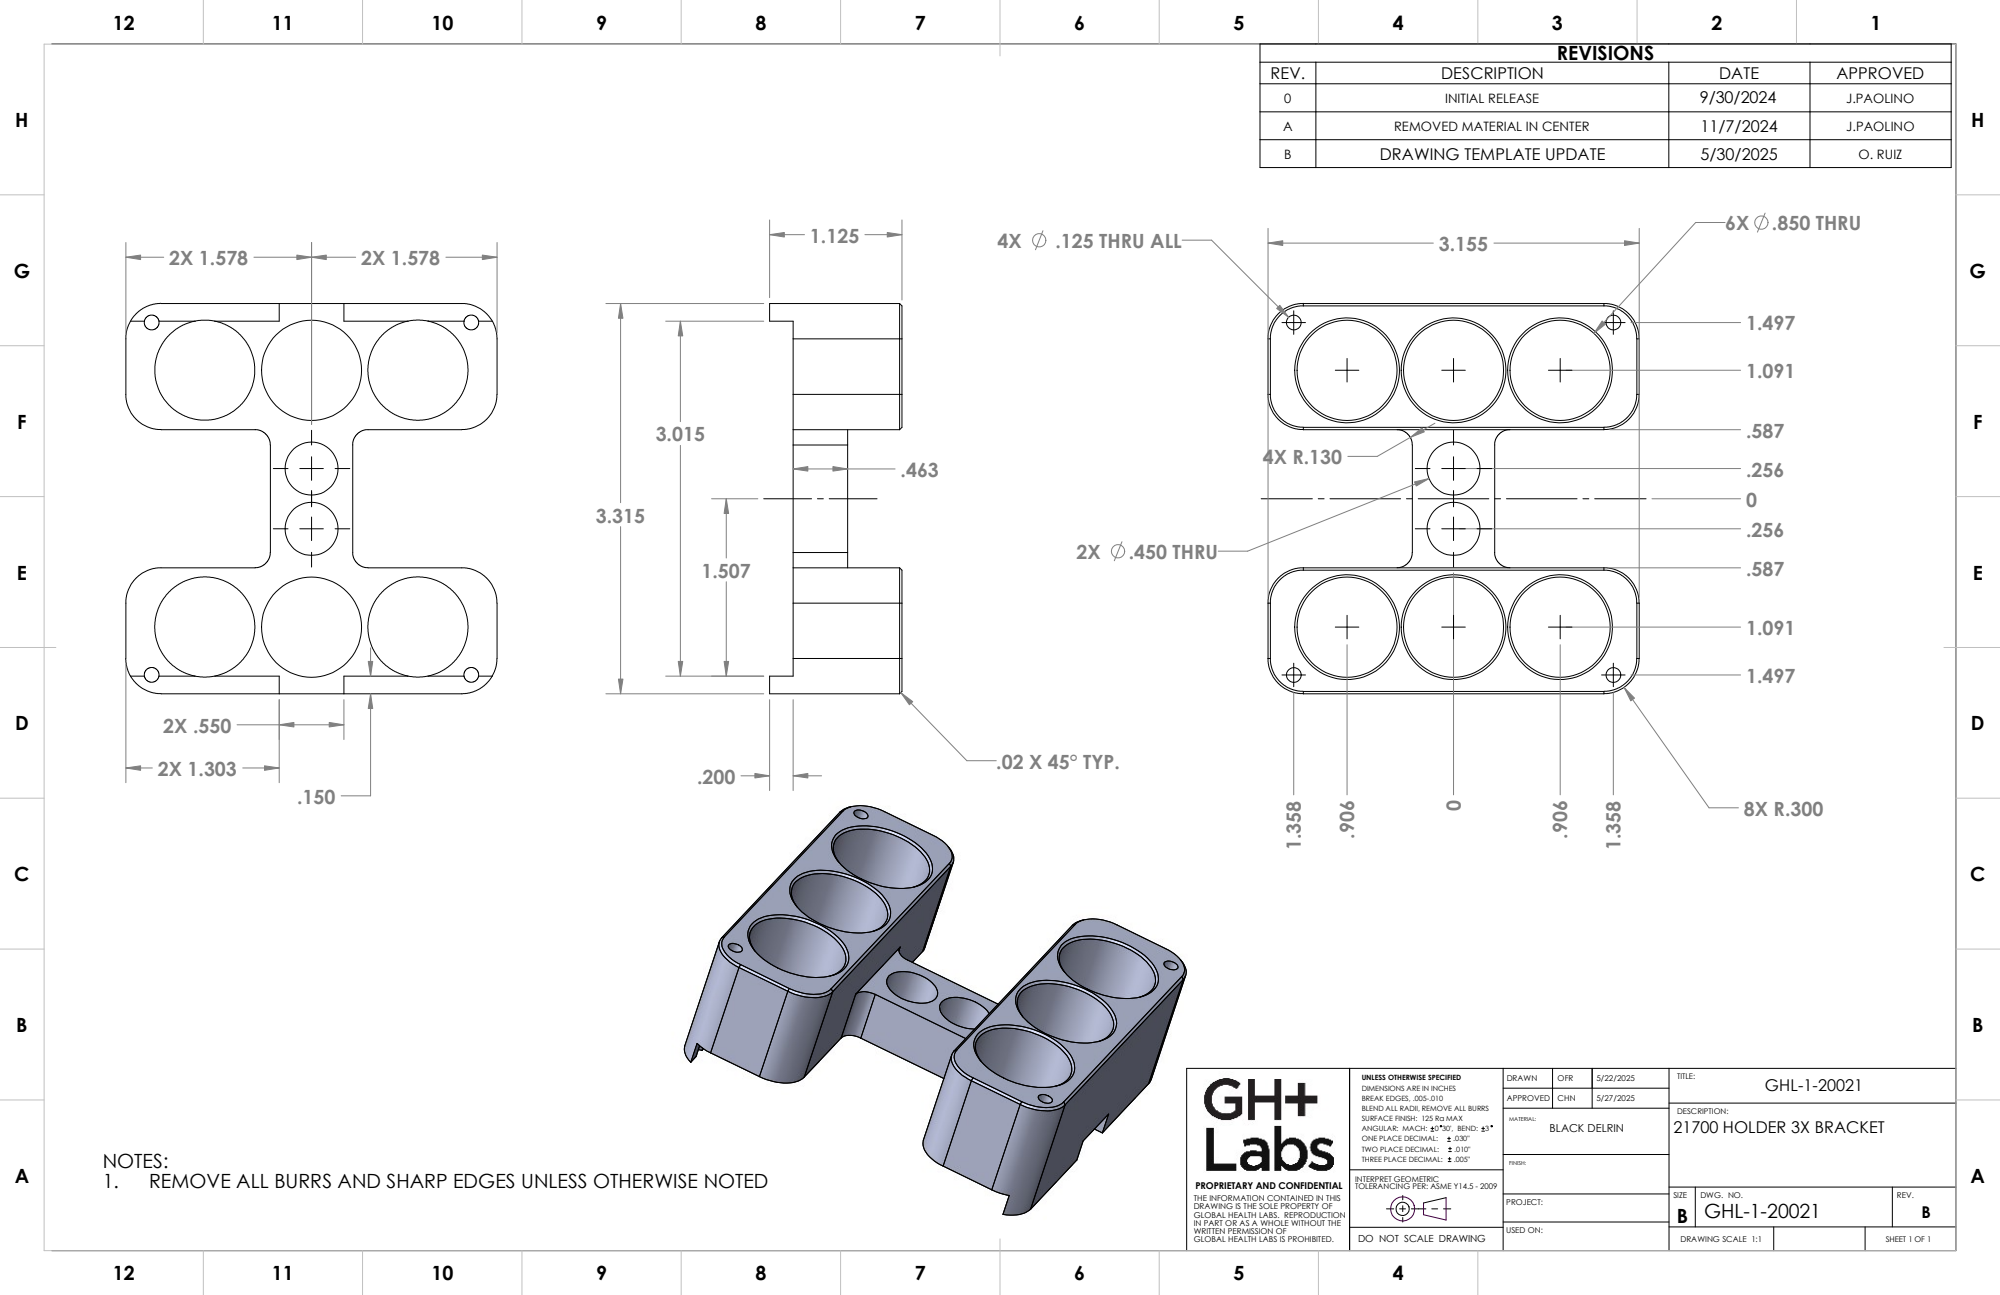
[picture p182: page 1]
PROJECT:; DESCRIPTION:; FINISH:; MATERIAL:; BLACK DELRIN; 21700 HOLDER 3X BRACKET; USED ON:; 6X .850 THRU; .125 THRU ALL; 2X .450 THRU; .02 X 45° TYP.

REVISIONS

REV. | DESCRIPTION | DATE | APPROVED
0 | INITIAL RELEASE | 9/30/2024 | J.PAOLINO
A | REMOVED MATERIAL IN CENTER | 11/7/2024 | J.PAOLINO
B | DRAWING TEMPLATE UPDATE | 5/30/2025 | O. RUIZ

PROPRIETARY AND CONFIDENTIAL THE INFORMATION CONTAINED IN THIS DRAWING IS THE SOLE PROPERTY OF GLOBAL HEALTH LABS. REPRODUCTION IN PART OR AS A WHOLE WITHOUT THE WRITTEN PERMISSION OF GLOBAL HEALTH LABS IS PROHIBITED. | UNLESS OTHERWISE SPECIFIED DIMENSIONS ARE IN INCHES BREAK EDGES, .005-.010 BLEND ALL RADII, REMOVE ALL BURRS SURFACE FINISH: 125 Ra MAX ANGULAR: MACH: 0 30', BEND: 3 ONE PLACE DECIMAL: .030" TWO PLACE DECIMAL: .010" THREE PLACE DECIMAL: .005" | DRAWN | OFR | 5/22/2025 | TITLE: GHL-1-20021

APPROVED | CHN | 5/27/2025

NOTES:
1. REMOVE ALL BURRS AND SHARP EDGES UNLESS OTHERWISE NOTED

INTERPRET GEOMETRIC
TOLERANCING PER: ASME Y14.5 - 2009

SIZE B | DWG. NO. GHL-1-20021 | REV. B

DO NOT SCALE DRAWING | | DRAWING SCALE 1:1 | SHEET 1 OF 1
