Global-Health-Labs/nPOC-BB/hw/beta/CAD/derived/drawings/GHL-1-20024.pdf

2

4 3

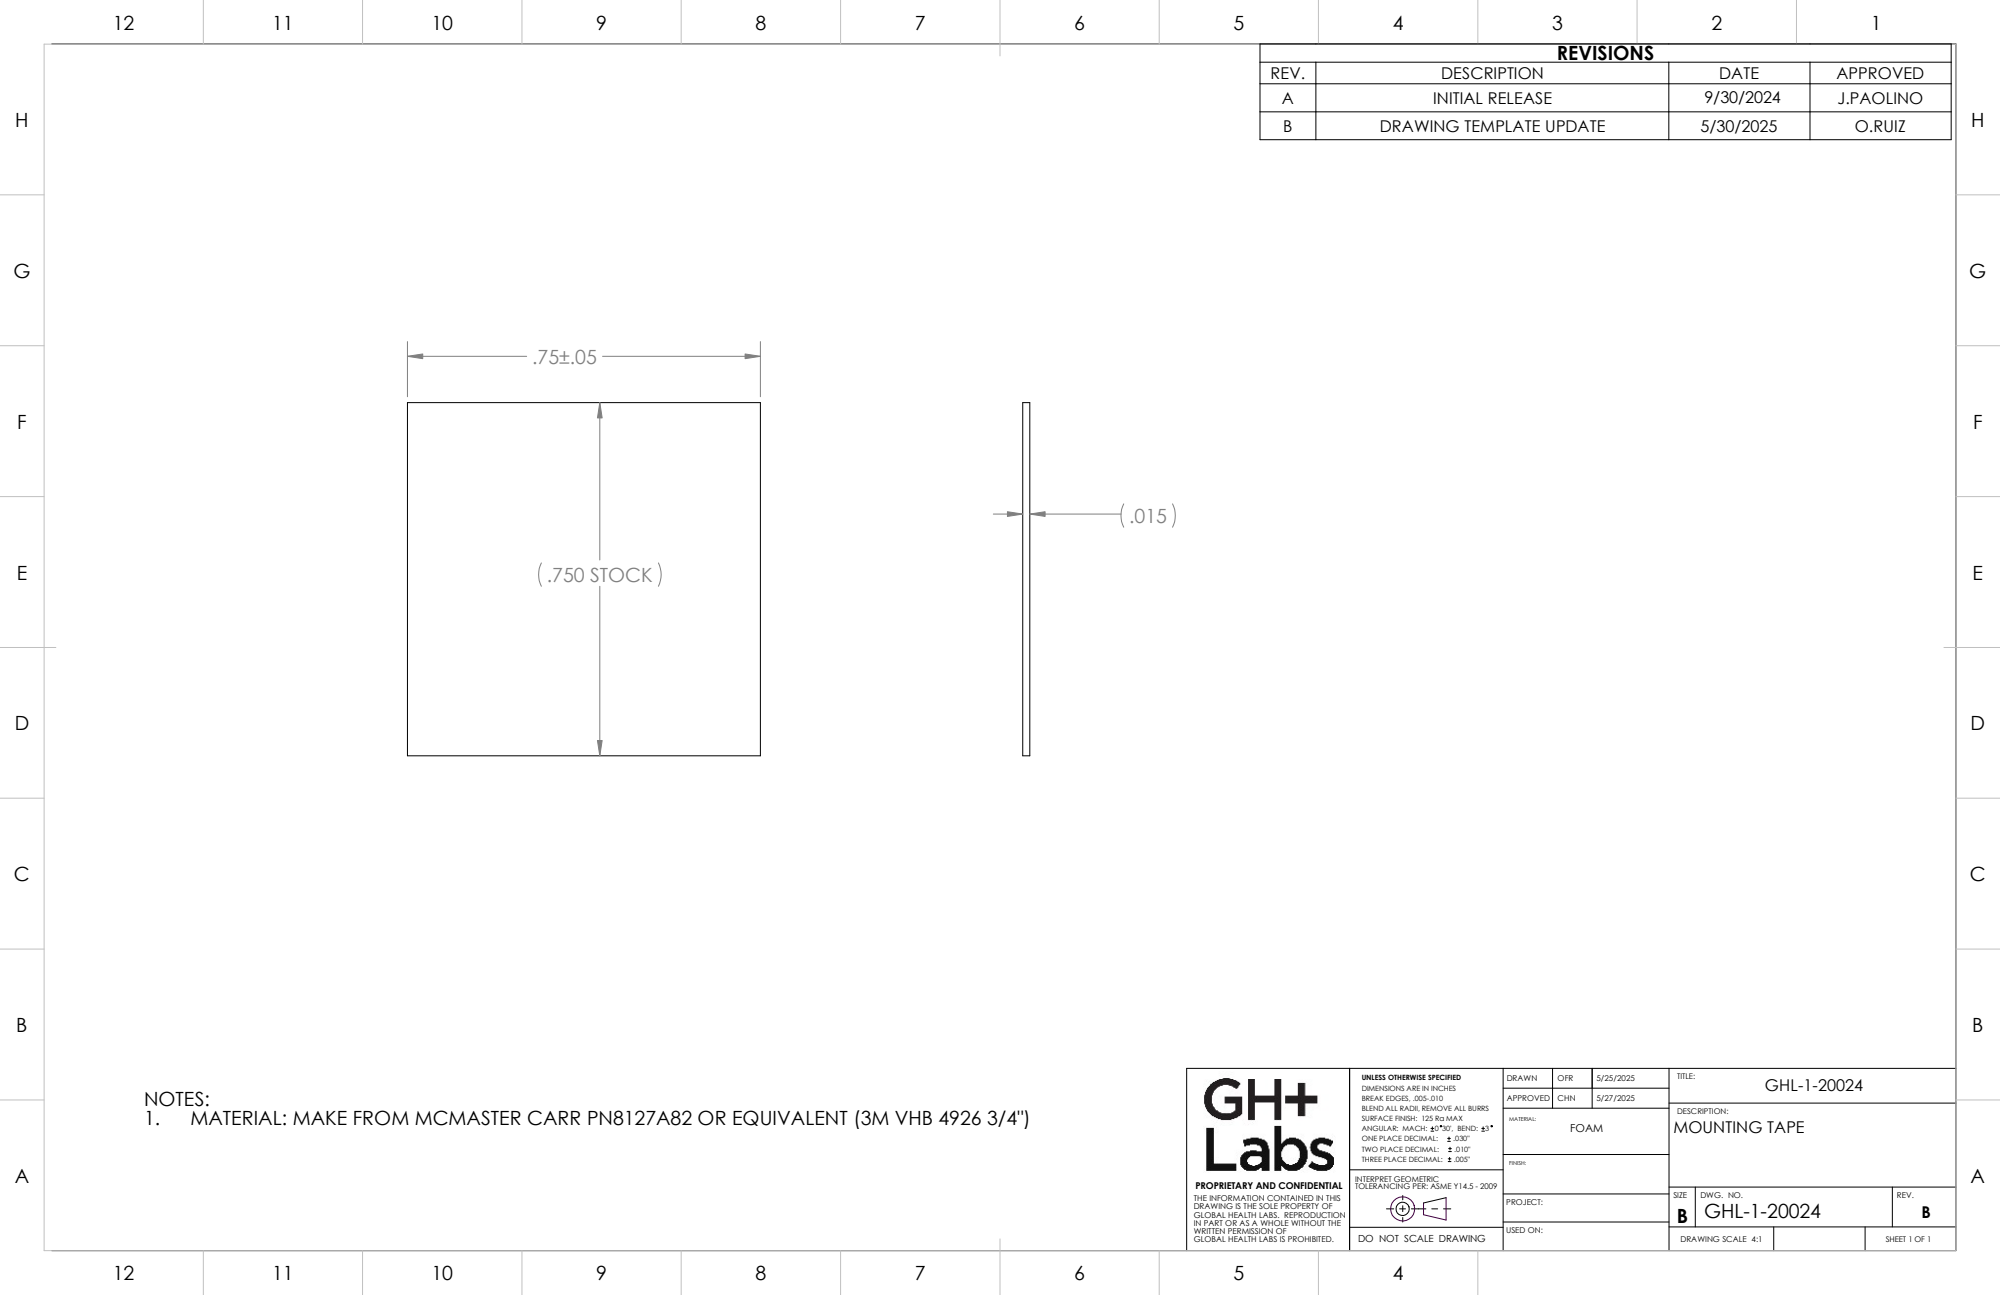
[picture p183: page 1]
PROJECT:; DESCRIPTION:; FINISH:; MATERIAL:; FOAM; MOUNTING TAPE; USED ON:; .750 STOCK

REVISIONS

REV. | DESCRIPTION | DATE | APPROVED
A | INITIAL RELEASE | 9/30/2024 | J.PAOLINO
B | DRAWING TEMPLATE UPDATE | 5/30/2025 | O.RUIZ

PROPRIETARY AND CONFIDENTIAL THE INFORMATION CONTAINED IN THIS DRAWING IS THE SOLE PROPERTY OF GLOBAL HEALTH LABS. REPRODUCTION IN PART OR AS A WHOLE WITHOUT THE WRITTEN PERMISSION OF GLOBAL HEALTH LABS IS PROHIBITED. | UNLESS OTHERWISE SPECIFIED DIMENSIONS ARE IN INCHES BREAK EDGES, .005-.010 BLEND ALL RADII, REMOVE ALL BURRS SURFACE FINISH: 125 Ra MAX ANGULAR: MACH: 0 30', BEND: 3 ONE PLACE DECIMAL: .030" TWO PLACE DECIMAL: .010" THREE PLACE DECIMAL: .005" | DRAWN | OFR | 5/25/2025 | TITLE: GHL-1-20024

NOTES:
1. MATERIAL: MAKE FROM MCMASTER CARR PN8127A82 OR EQUIVALENT (3M VHB 4926 3/4")

APPROVED | CHN | 5/27/2025

INTERPRET GEOMETRIC TOLERANCING PER: ASME Y14.5 - 2009

SIZE B | DWG. NO. GHL-1-20024 | REV. B

DO NOT SCALE DRAWING | | DRAWING SCALE 4:1 | SHEET 1 OF 1
