Global-Health-Labs/nPOC-BB/hw/beta/CAD/derived/drawings/GHL-1-20025.pdf

2

4 3

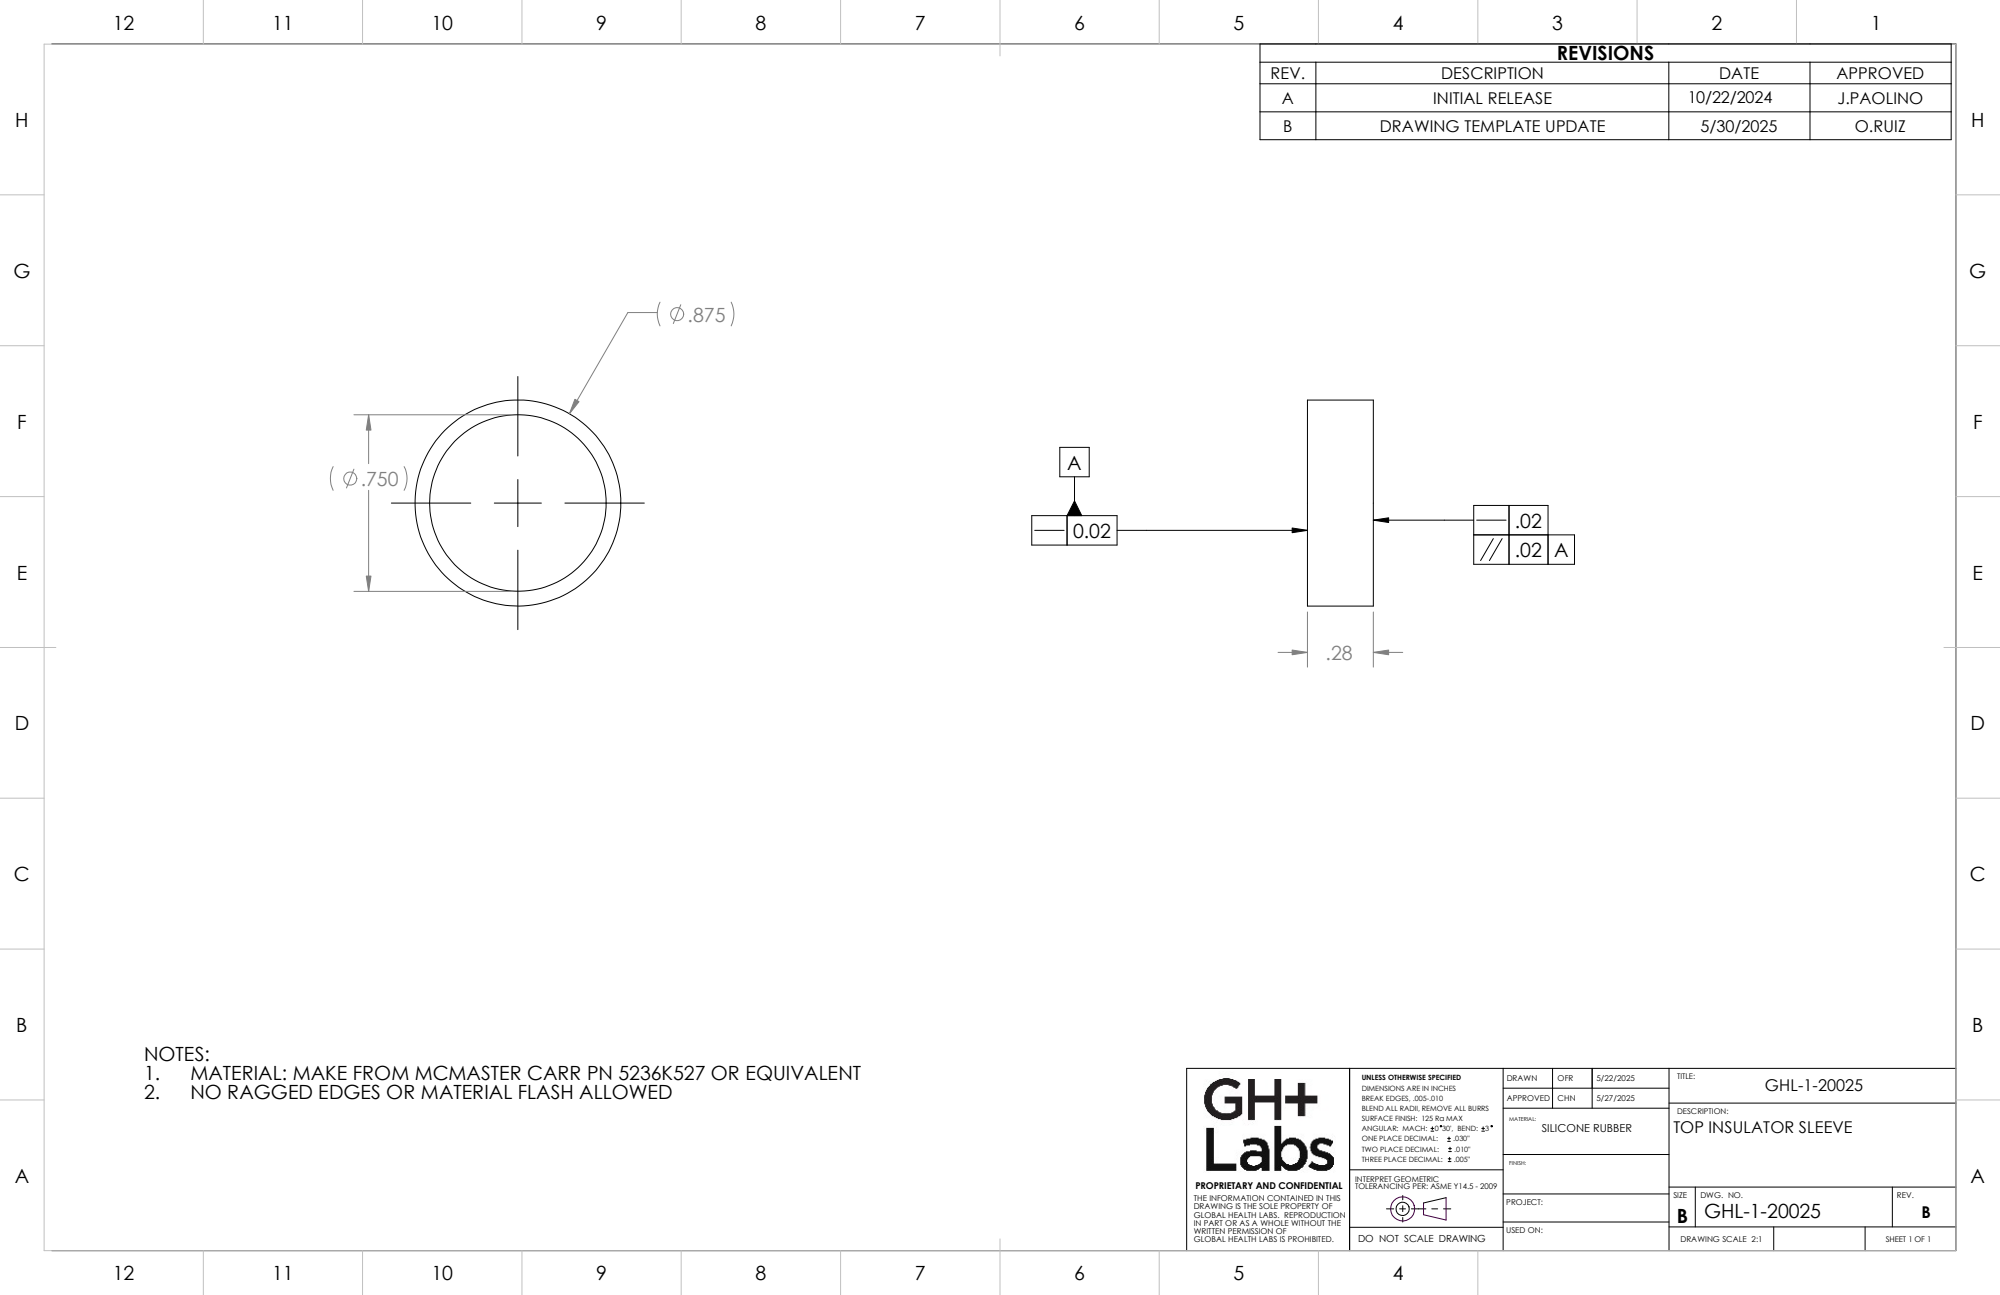
[picture p184: page 1]
PROJECT:; FINISH:; MATERIAL:; SILICONE RUBBER; USED ON:

REVISIONS

REV. | DESCRIPTION | DATE | APPROVED
A | INITIAL RELEASE | 10/22/2024 | J.PAOLINO
B | DRAWING TEMPLATE UPDATE | 5/30/2025 | O.RUIZ

NOTES:
1. MATERIAL: MAKE FROM MCMASTER CARR PN 5236K527 OR EQUIVALENT
2. NO RAGGED EDGES OR MATERIAL FLASH ALLOWED

PROPRIETARY AND CONFIDENTIAL THE INFORMATION CONTAINED IN THIS DRAWING IS THE SOLE PROPERTY OF GLOBAL HEALTH LABS. REPRODUCTION IN PART OR AS A WHOLE WITHOUT THE WRITTEN PERMISSION OF GLOBAL HEALTH LABS IS PROHIBITED. | UNLESS OTHERWISE SPECIFIED DIMENSIONS ARE IN INCHES BREAK EDGES, .005-.010 BLEND ALL RADII, REMOVE ALL BURRS SURFACE FINISH: 125 Ra MAX ANGULAR: MACH: 0 30', BEND: 3 ONE PLACE DECIMAL: .030" TWO PLACE DECIMAL: .010" THREE PLACE DECIMAL: .005" | DRAWN | OFR | 5/22/2025 | TITLE: GHL-1-20025

APPROVED | CHN | 5/27/2025

DESCRIPTION:
TOP INSULATOR SLEEVE

INTERPRET GEOMETRIC TOLERANCING PER: ASME Y14.5 - 2009

SIZE B | DWG. NO. GHL-1-20025 | REV. B

DO NOT SCALE DRAWING | | DRAWING SCALE 2:1 | SHEET 1 OF 1
