Global-Health-Labs/nPOC-BB/hw/beta/CAD/derived/drawings/GHL-1-22000.pdf

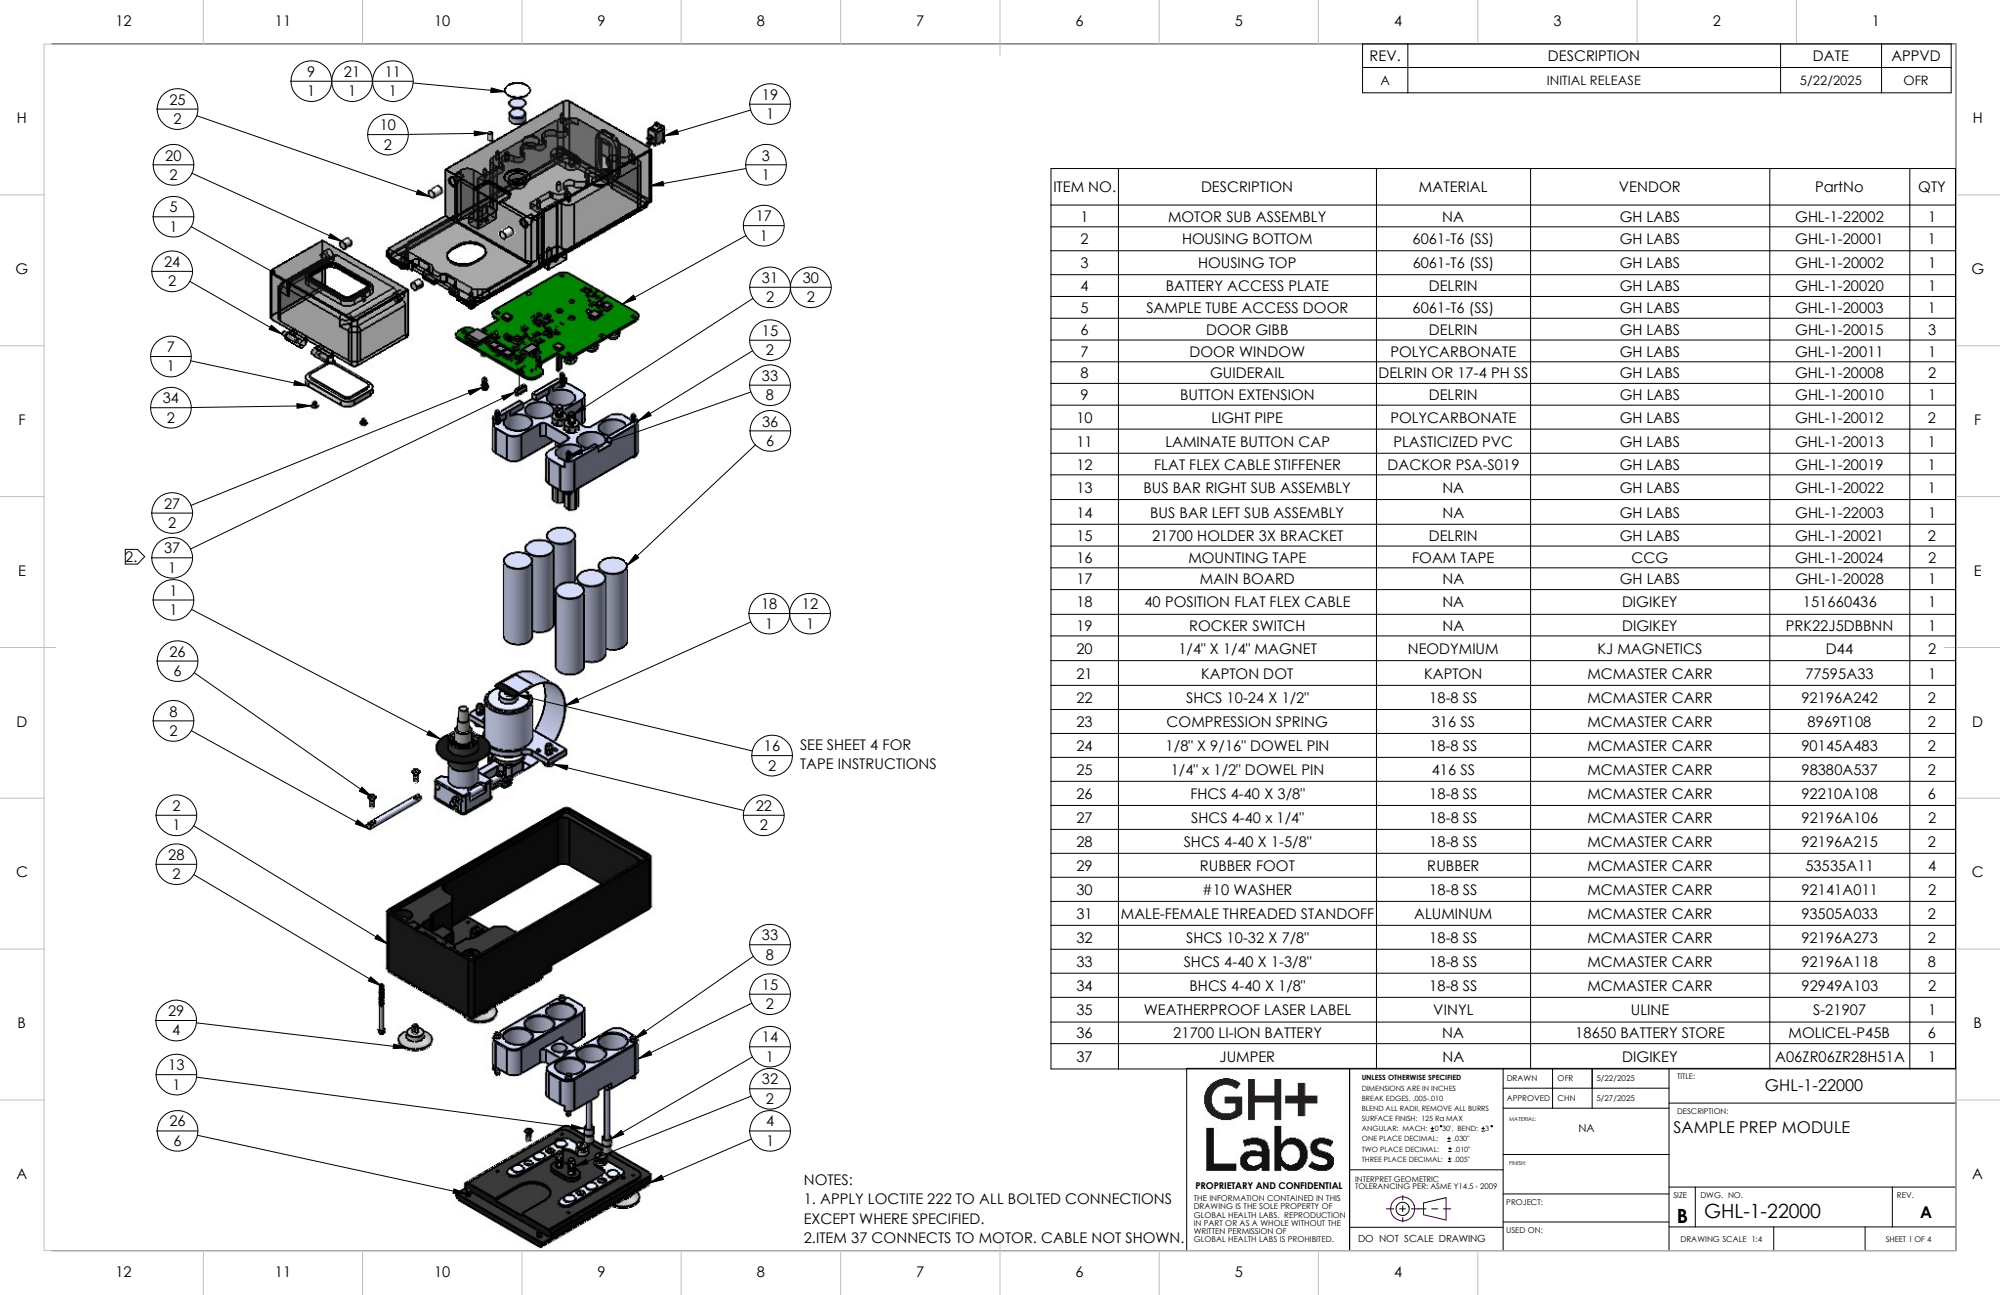
[picture p186: page 1]
PROJECT:; FINISH:; MATERIAL:; USED ON:; SEE SHEET 4 FOR TAPE INSTRUCTIONS

REV. | DESCRIPTION | DATE | APPVD
A | INITIAL RELEASE | 5/22/2025 | OFR

ITEM NO. | DESCRIPTION | MATERIAL | VENDOR | PartNo | QTY
1 | MOTOR SUB ASSEMBLY | NA | GH LABS | GHL-1-22002 | 1
2 | HOUSING BOTTOM | 6061-T6 (SS) | GH LABS | GHL-1-20001 | 1
3 | HOUSING TOP | 6061-T6 (SS) | GH LABS | GHL-1-20002 | 1
4 | BATTERY ACCESS PLATE | DELRIN | GH LABS | GHL-1-20020 | 1
5 | SAMPLE TUBE ACCESS DOOR | 6061-T6 (SS) | GH LABS | GHL-1-20003 | 1
6 | DOOR GIBB | DELRIN | GH LABS | GHL-1-20015 | 3
7 | DOOR WINDOW | POLYCARBONATE | GH LABS | GHL-1-20011 | 1
8 | GUIDERAIL | DELRIN OR 17-4 PH SS | GH LABS | GHL-1-20008 | 2
9 | BUTTON EXTENSION | DELRIN | GH LABS | GHL-1-20010 | 1
10 | LIGHT PIPE | POLYCARBONATE | GH LABS | GHL-1-20012 | 2
11 | LAMINATE BUTTON CAP | PLASTICIZED PVC | GH LABS | GHL-1-20013 | 1
12 | FLAT FLEX CABLE STIFFENER | DACKOR PSA-S019 | GH LABS | GHL-1-20019 | 1
13 | BUS BAR RIGHT SUB ASSEMBLY | NA | GH LABS | GHL-1-20022 | 1
14 | BUS BAR LEFT SUB ASSEMBLY | NA | GH LABS | GHL-1-22003 | 1
15 | 21700 HOLDER 3X BRACKET | DELRIN | GH LABS | GHL-1-20021 | 2
16 | MOUNTING TAPE | FOAM TAPE | CCG | GHL-1-20024 | 2
17 | MAIN BOARD | NA | GH LABS | GHL-1-20028 | 1
18 | 40 POSITION FLAT FLEX CABLE | NA | DIGIKEY | 151660436 | 1
19 | ROCKER SWITCH | NA | DIGIKEY | PRK22J5DBBNN | 1
20 | 1/4" X 1/4" MAGNET | NEODYMIUM | KJ MAGNETICS | D44 | 2
21 | KAPTON DOT | KAPTON | MCMASTER CARR | 77595A33 | 1
22 | SHCS 10-24 X 1/2" | 18-8 SS | MCMASTER CARR | 92196A242 | 2
23 | COMPRESSION SPRING | 316 SS | MCMASTER CARR | 8969T108 | 2
24 | 1/8" X 9/16" DOWEL PIN | 18-8 SS | MCMASTER CARR | 90145A483 | 2
25 | 1/4" x 1/2" DOWEL PIN | 416 SS | MCMASTER CARR | 98380A537 | 2
26 | FHCS 4-40 X 3/8" | 18-8 SS | MCMASTER CARR | 92210A108 | 6
27 | SHCS 4-40 x 1/4" | 18-8 SS | MCMASTER CARR | 92196A106 | 2
28 | SHCS 4-40 X 1-5/8" | 18-8 SS | MCMASTER CARR | 92196A215 | 2
29 | RUBBER FOOT | RUBBER | MCMASTER CARR | 53535A11 | 4
30 | #10 WASHER | 18-8 SS | MCMASTER CARR | 92141A011 | 2
31 | MALE-FEMALE THREADED STANDOFF | ALUMINUM | MCMASTER CARR | 93505A033 | 2
32 | SHCS 10-32 X 7/8" | 18-8 SS | MCMASTER CARR | 92196A273 | 2
33 | SHCS 4-40 X 1-3/8" | 18-8 SS | MCMASTER CARR | 92196A118 | 8
34 | BHCS 4-40 X 1/8" | 18-8 SS | MCMASTER CARR | 92949A103 | 2
35 | WEATHERPROOF LASER LABEL | VINYL | ULINE | S-21907 | 1
36 | 21700 LI-ION BATTERY | NA | 18650 BATTERY STORE | MOLICEL-P45B | 6
37 | JUMPER | NA | DIGIKEY | A06ZR06ZR28H51A | 1

PROPRIETARY AND CONFIDENTIAL THE INFORMATION CONTAINED IN THIS DRAWING IS THE SOLE PROPERTY OF GLOBAL HEALTH LABS. REPRODUCTION IN PART OR AS A WHOLE WITHOUT THE WRITTEN PERMISSION OF GLOBAL HEALTH LABS IS PROHIBITED. | UNLESS OTHERWISE SPECIFIED DIMENSIONS ARE IN INCHES BREAK EDGES, .005-.010 BLEND ALL RADII, REMOVE ALL BURRS SURFACE FINISH: 125 Ra MAX ANGULAR: MACH: 0 30', BEND: 3 ONE PLACE DECIMAL: .030" TWO PLACE DECIMAL: .010" THREE PLACE DECIMAL: .005" | DRAWN | OFR | 5/22/2025 | TITLE: GHL-1-22000

APPROVED | CHN | 5/27/2025

DESCRIPTION:
SAMPLE PREP MODULE

NOTES:
1. APPLY LOCTITE 222 TO ALL BOLTED CONNECTIONS
EXCEPT WHERE SPECIFIED.
2.ITEM 37 CONNECTS TO MOTOR. CABLE NOT SHOWN.

INTERPRET GEOMETRIC
TOLERANCING PER: ASME Y14.5 - 2009

SIZE B | DWG. NO. GHL-1-22000 | REV. A

DO NOT SCALE DRAWING | | DRAWING SCALE 1:4 | SHEET 1 OF 4

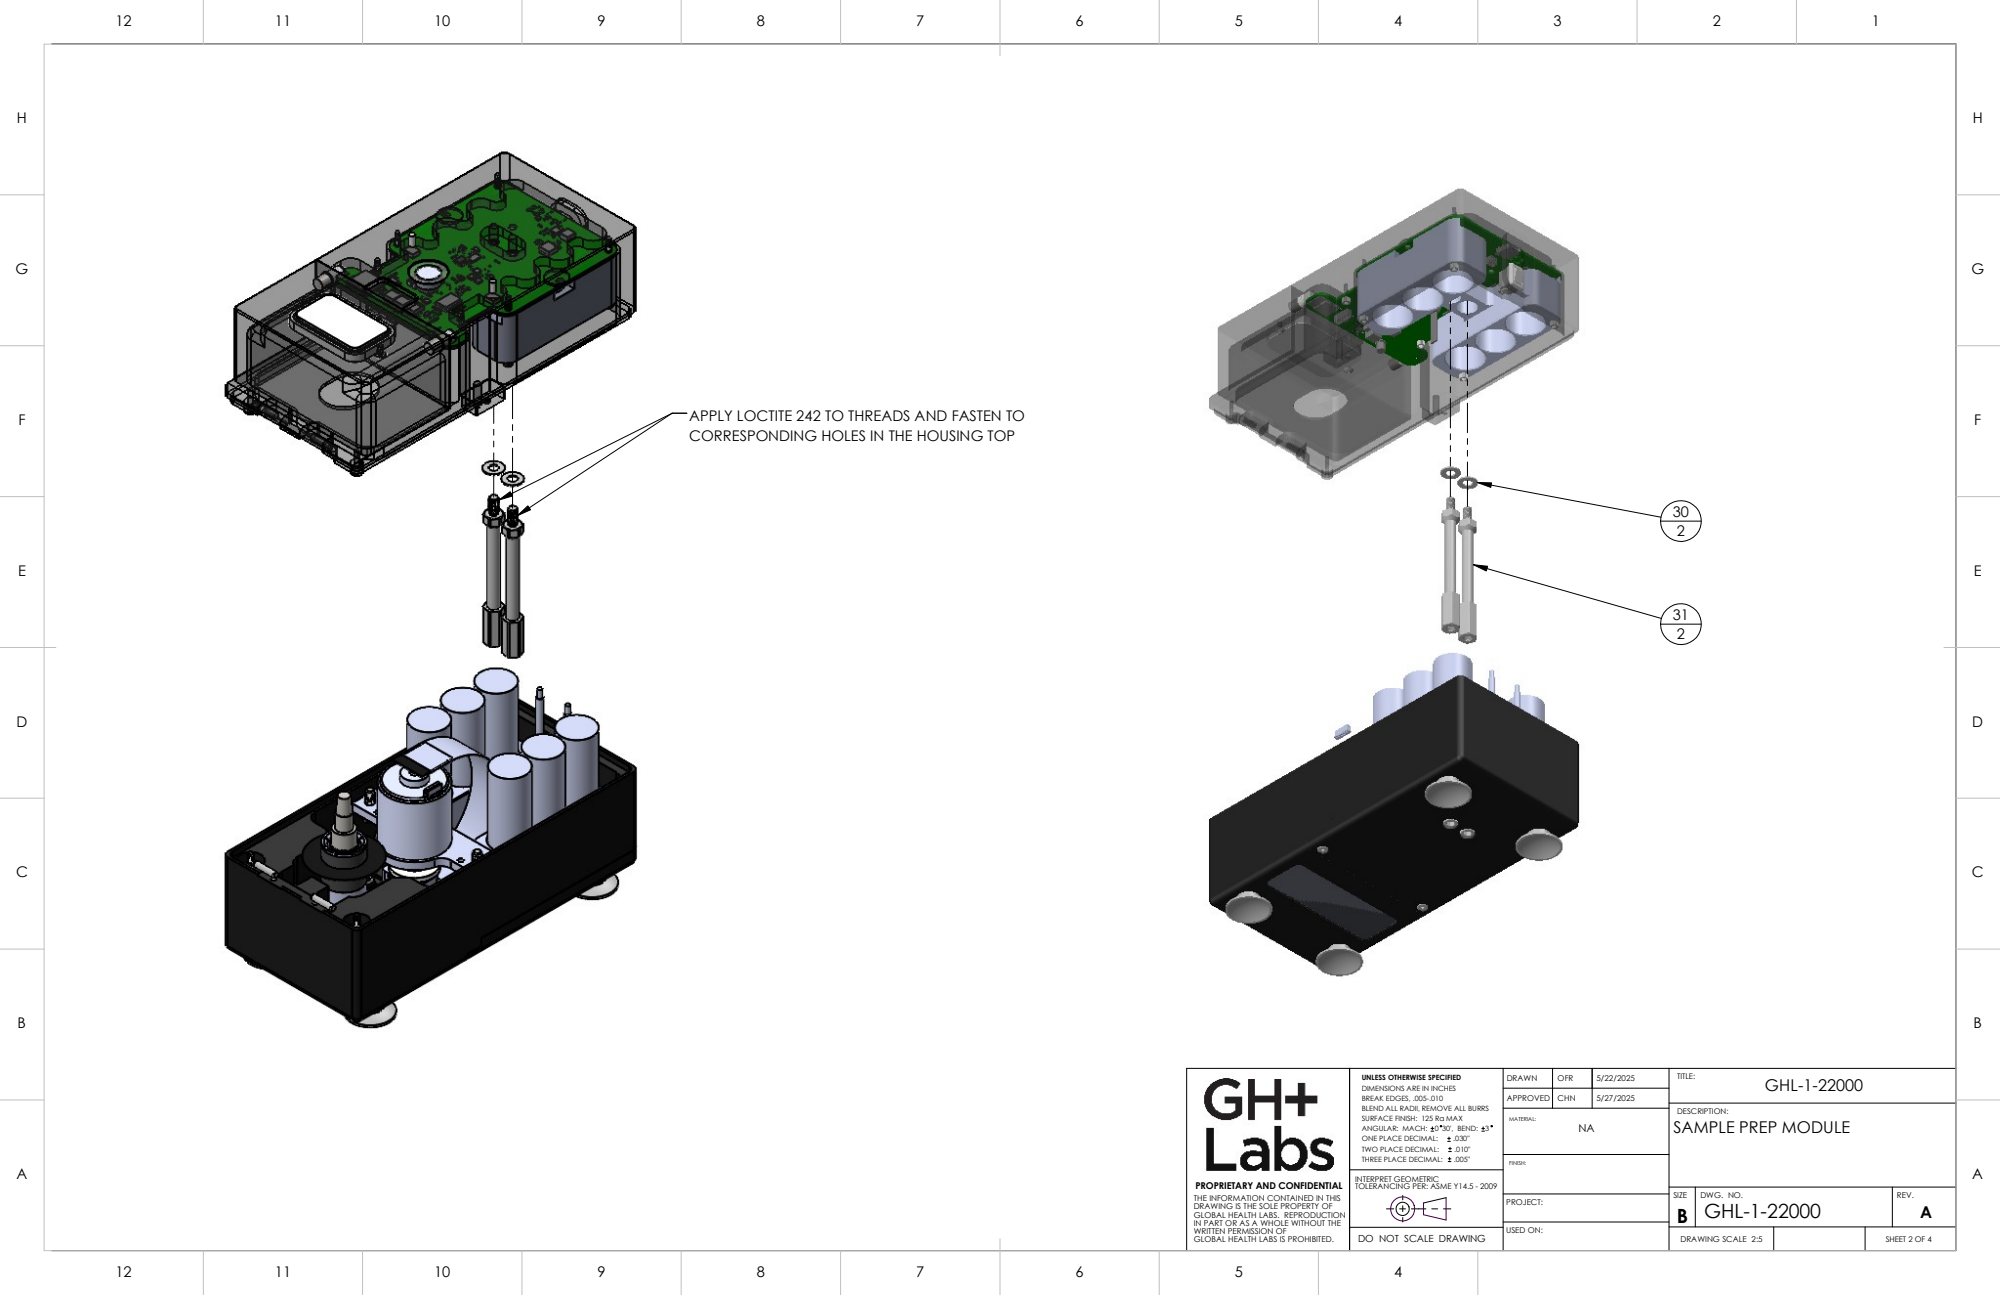
[picture p187: page 2]
FINISH:; MATERIAL:

APPLY LOCTITE 242 TO THREADS AND FASTEN TO
CORRESPONDING HOLES IN THE HOUSING TOP

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

APPROVED | CHN | 5/27/2025

DESCRIPTION:
SAMPLE PREP MODULE

INTERPRET GEOMETRIC

DRAWING SCALE 2:5 | SHEET 2 OF 4

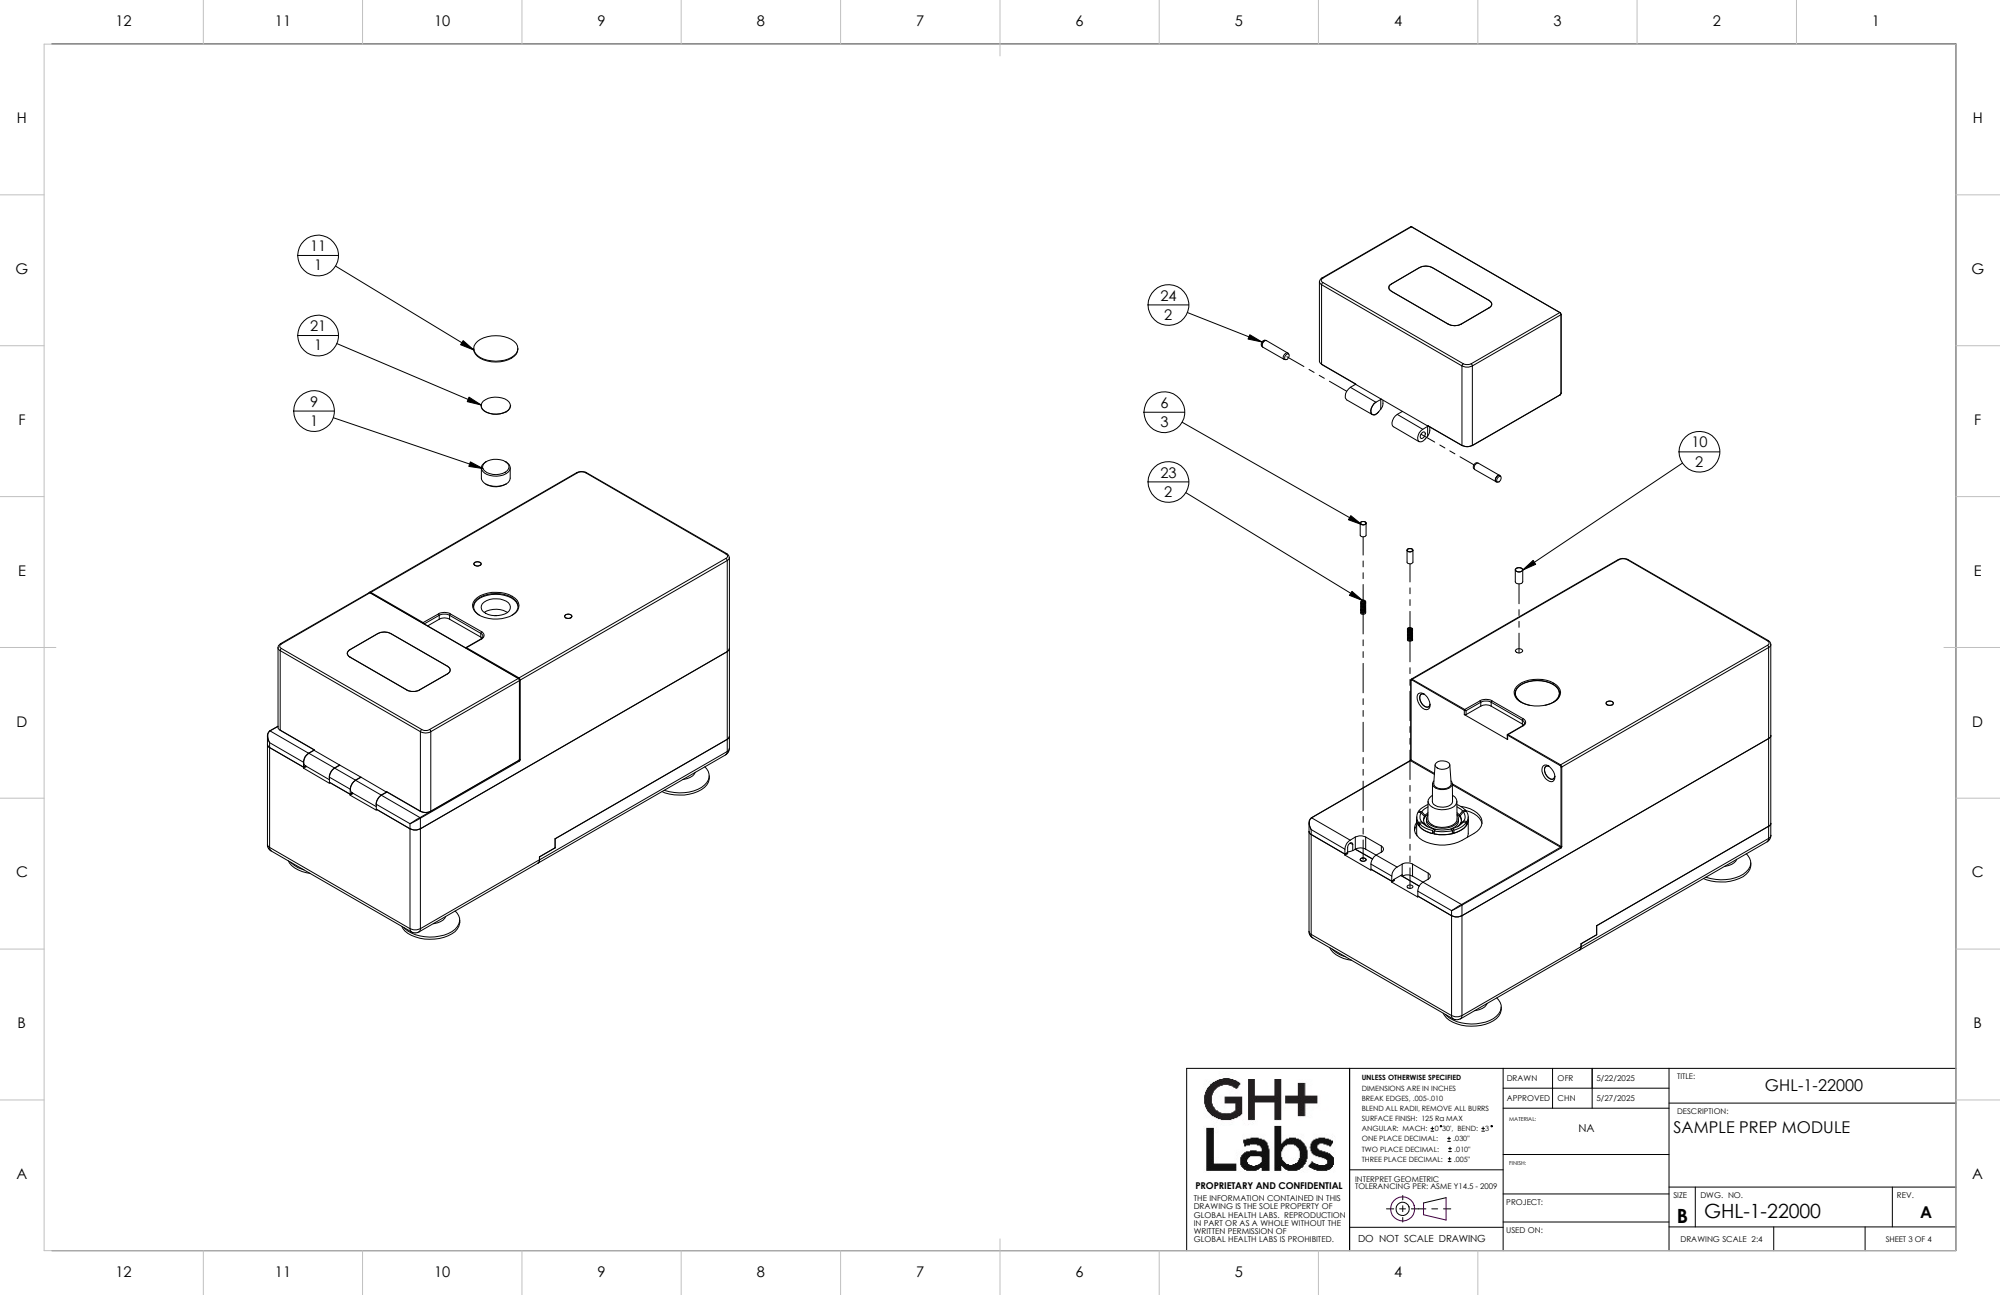
[picture p188: page 3]
FINISH:; MATERIAL:

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

APPROVED | CHN | 5/27/2025

DESCRIPTION:
SAMPLE PREP MODULE

INTERPRET GEOMETRIC

DRAWING SCALE 2:4 | SHEET 3 OF 4

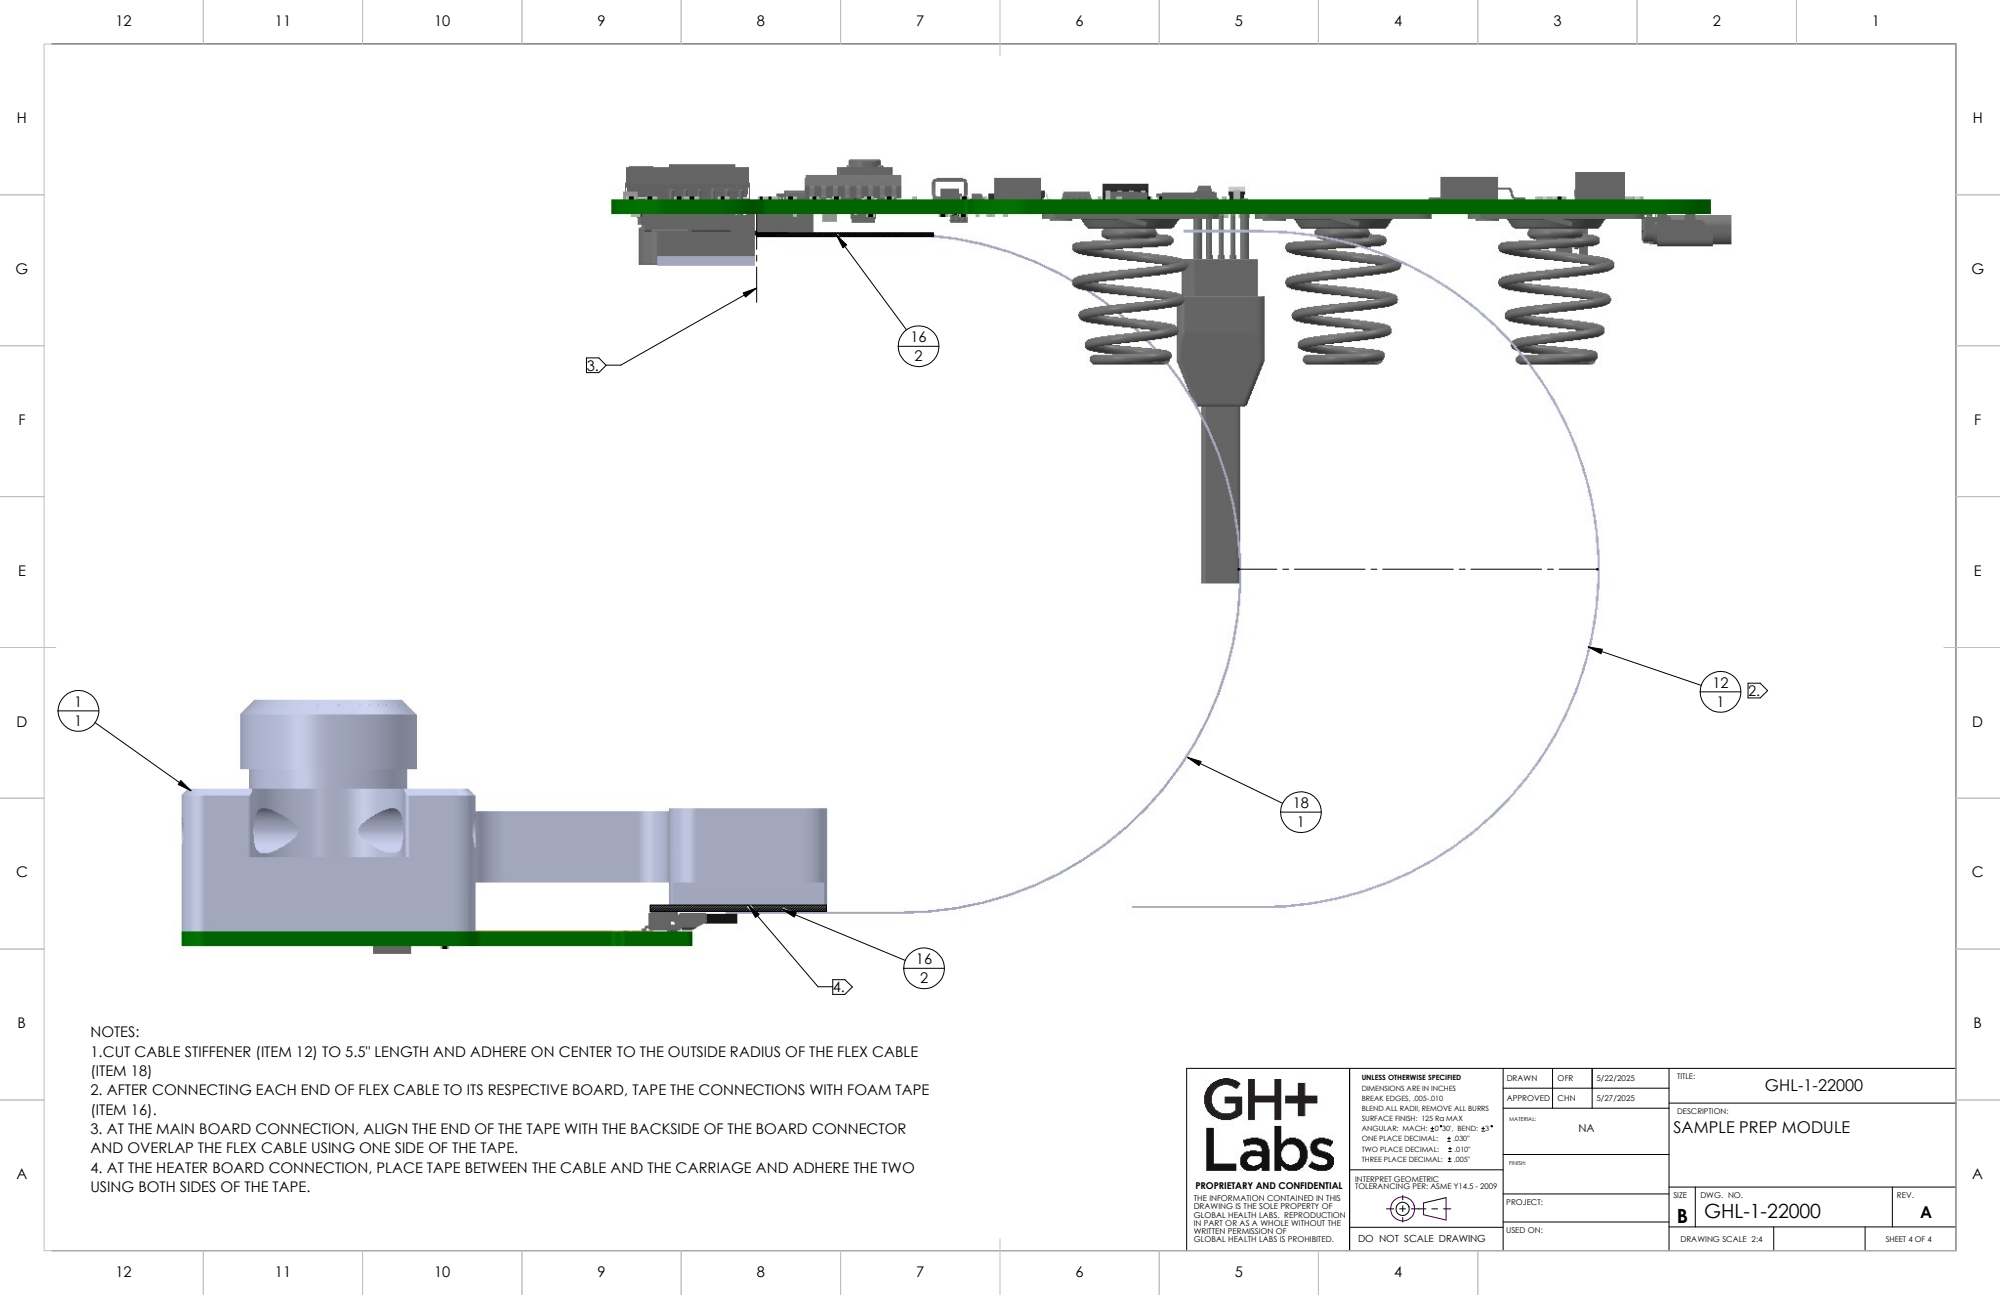
[picture p189: page 4]
FINISH:; MATERIAL:

NOTES:
1.CUT CABLE STIFFENER (ITEM 12) TO 5.5" LENGTH AND ADHERE ON CENTER TO THE OUTSIDE RADIUS OF THE FLEX CABLE
(ITEM 18)
2. AFTER CONNECTING EACH END OF FLEX CABLE TO ITS RESPECTIVE BOARD, TAPE THE CONNECTIONS WITH FOAM TAPE
(ITEM 16).
3. AT THE MAIN BOARD CONNECTION, ALIGN THE END OF THE TAPE WITH THE BACKSIDE OF THE BOARD CONNECTOR
AND OVERLAP THE FLEX CABLE USING ONE SIDE OF THE TAPE.
4. AT THE HEATER BOARD CONNECTION, PLACE TAPE BETWEEN THE CABLE AND THE CARRIAGE AND ADHERE THE TWO
USING BOTH SIDES OF THE TAPE.

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

APPROVED | CHN | 5/27/2025

DESCRIPTION:
SAMPLE PREP MODULE

INTERPRET GEOMETRIC

DRAWING SCALE 2:4 | SHEET 4 OF 4
