Global-Health-Labs/nPOC-BB/hw/beta/CAD/derived/drawings/GHL-1-22003.pdf

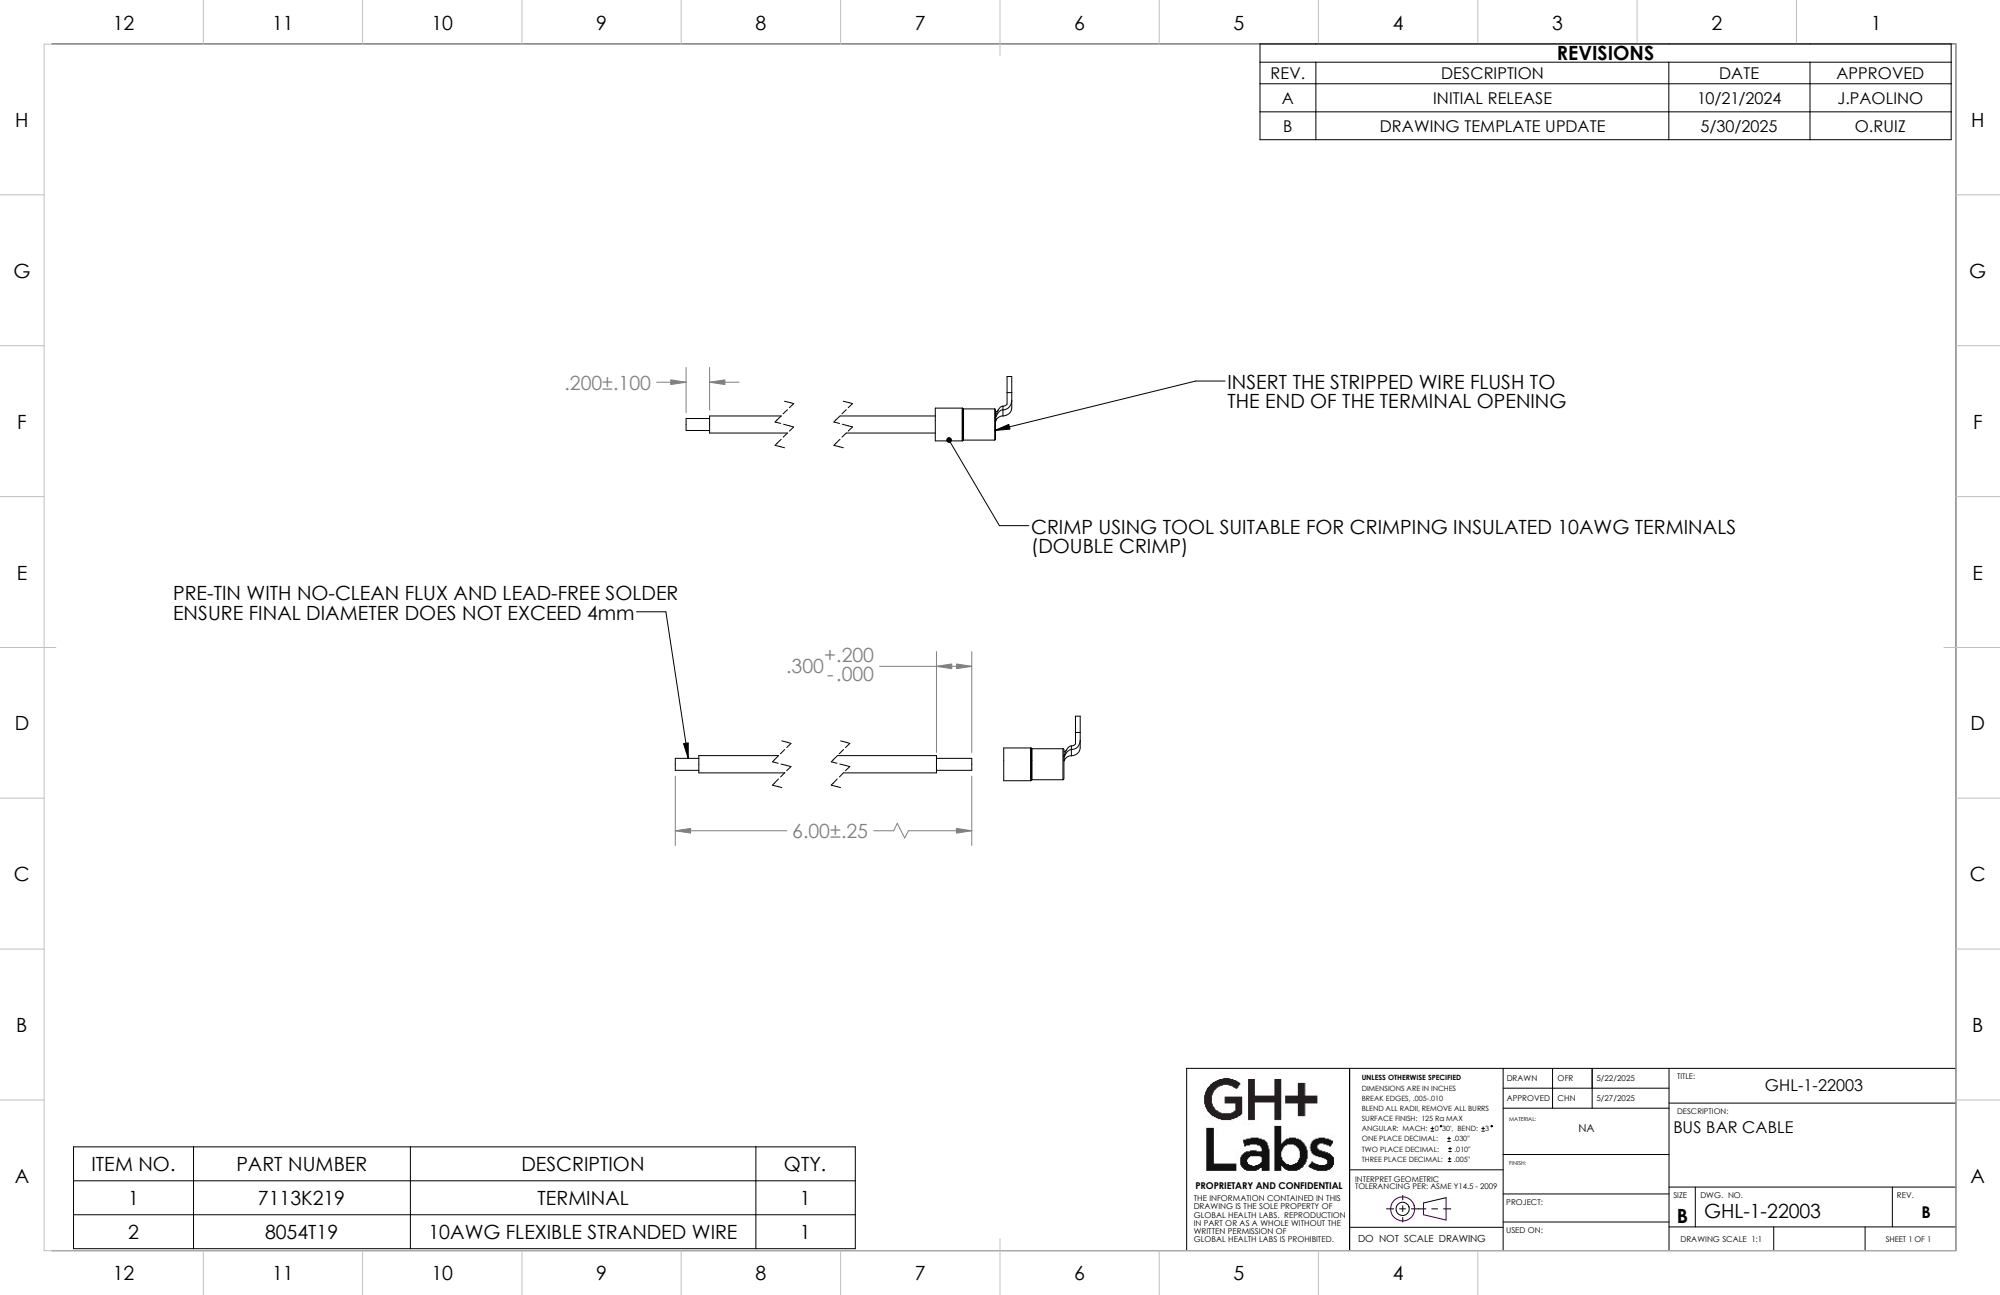
[picture p191: page 1]
PROJECT:; FINISH:; MATERIAL:; USED ON:

REVISIONS

REV. | DESCRIPTION | DATE | APPROVED
A | INITIAL RELEASE | 10/21/2024 | J.PAOLINO
B | DRAWING TEMPLATE UPDATE | 5/30/2025 | O.RUIZ

INSERT THE STRIPPED WIRE FLUSH TO
THE END OF THE TERMINAL OPENING

CRIMP USING TOOL SUITABLE FOR CRIMPING INSULATED 10AWG TERMINALS
(DOUBLE CRIMP)

PRE-TIN WITH NO-CLEAN FLUX AND LEAD-FREE SOLDER
ENSURE FINAL DIAMETER DOES NOT EXCEED 4mm

PROPRIETARY AND CONFIDENTIAL THE INFORMATION CONTAINED IN THIS DRAWING IS THE SOLE PROPERTY OF GLOBAL HEALTH LABS. REPRODUCTION IN PART OR AS A WHOLE WITHOUT THE WRITTEN PERMISSION OF GLOBAL HEALTH LABS IS PROHIBITED. | UNLESS OTHERWISE SPECIFIED DIMENSIONS ARE IN INCHES BREAK EDGES, .005-.010 BLEND ALL RADII, REMOVE ALL BURRS SURFACE FINISH: 125 Ra MAX ANGULAR: MACH: 0 30', BEND: 3 ONE PLACE DECIMAL: .030" TWO PLACE DECIMAL: .010" THREE PLACE DECIMAL: .005" | DRAWN | OFR | 5/22/2025 | TITLE: GHL-1-22003

APPROVED | CHN | 5/27/2025

DESCRIPTION:
BUS BAR CABLE

ITEM NO. | PART NUMBER | DESCRIPTION | QTY.
1 | 7113K219 | TERMINAL | 1
2 | 8054T19 | 10AWG FLEXIBLE STRANDED WIRE | 1

INTERPRET GEOMETRIC TOLERANCING PER: ASME Y14.5 - 2009

SIZE B | DWG. NO. GHL-1-22003 | REV. B

DO NOT SCALE DRAWING | | DRAWING SCALE 1:1 | SHEET 1 OF 1
