Global-Health-Labs/nPOC-BB/hw/alpha/ECAD/derived/PDF/Copy of Draftsman.PDF

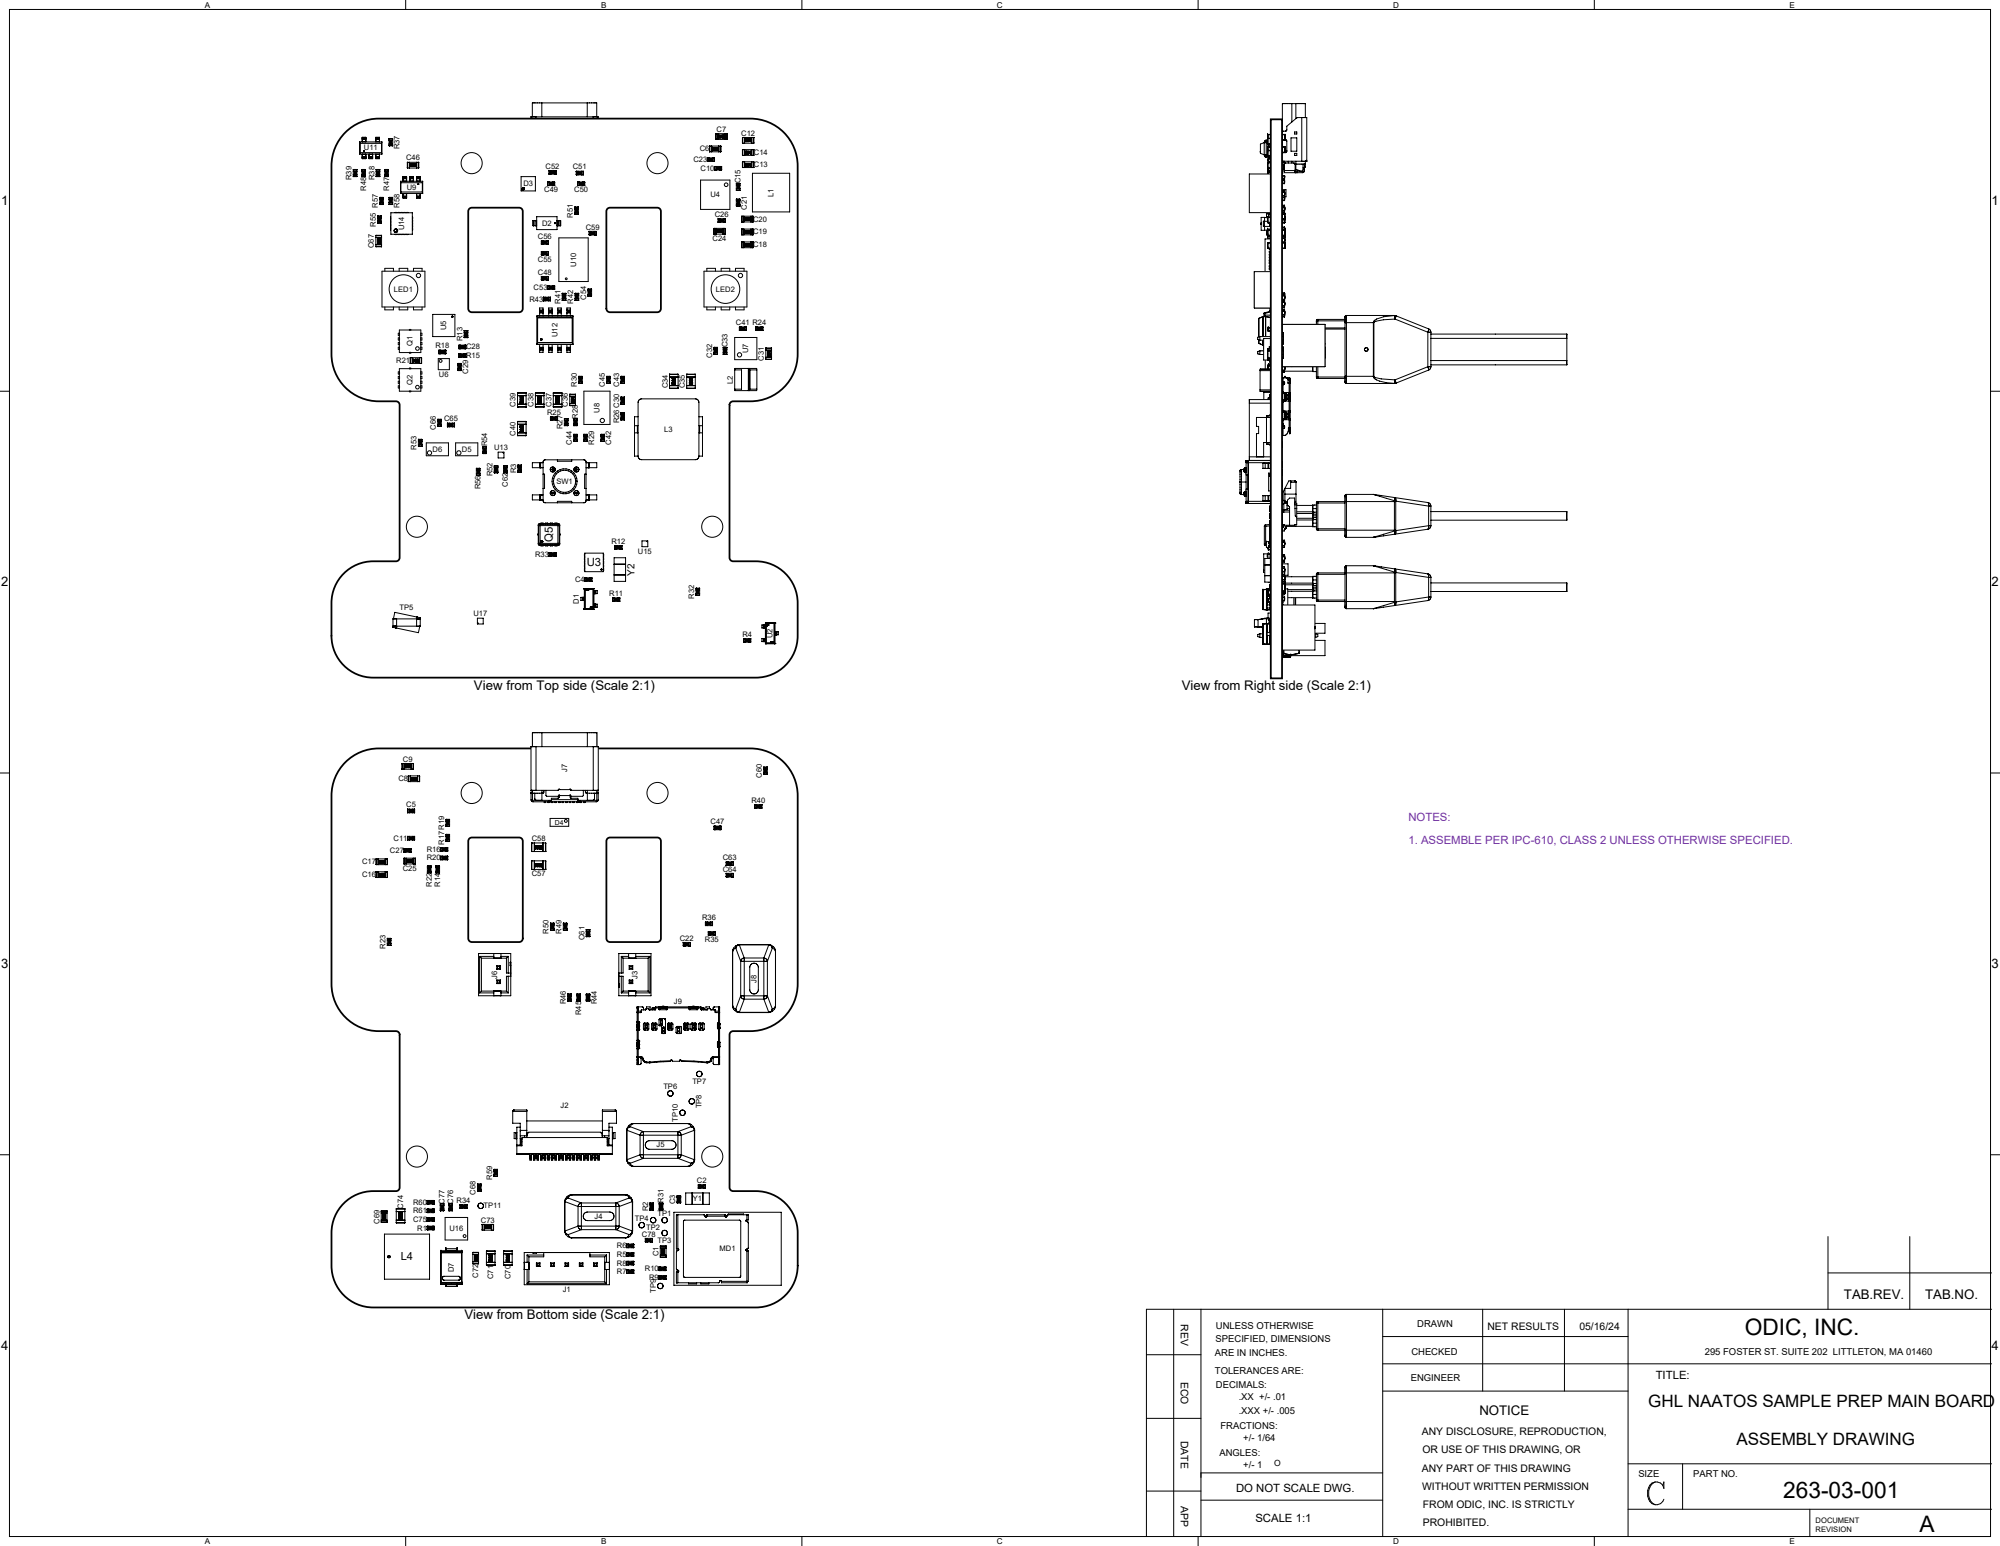
[picture p192: page 1]

View from Top side (Scale 2:1) J7

View from Right side (Scale 2:1)

NOTES:
1. ASSEMBLE PER IPC-610, CLASS 2 UNLESS OTHERWISE SPECIFIED.

View from Bottom side (Scale 2:1)

REV ECO DATE APP

295 FOSTER ST. SUITE 202 LITTLETON, MA 01460

TITLE:
GHL NAATOS SAMPLE PREP MAIN BOARD

ANY DISCLOSURE, REPRODUCTION,
OR USE OF THIS DRAWING, OR
ANY PART OF THIS DRAWING
WITHOUT WRITTEN PERMISSION
FROM ODIC, INC. IS STRICTLY
PROHIBITED.
