Global-Health-Labs/nPOC-BB/hw/alpha/ECAD/derived/PDF/Draftsman.PDF

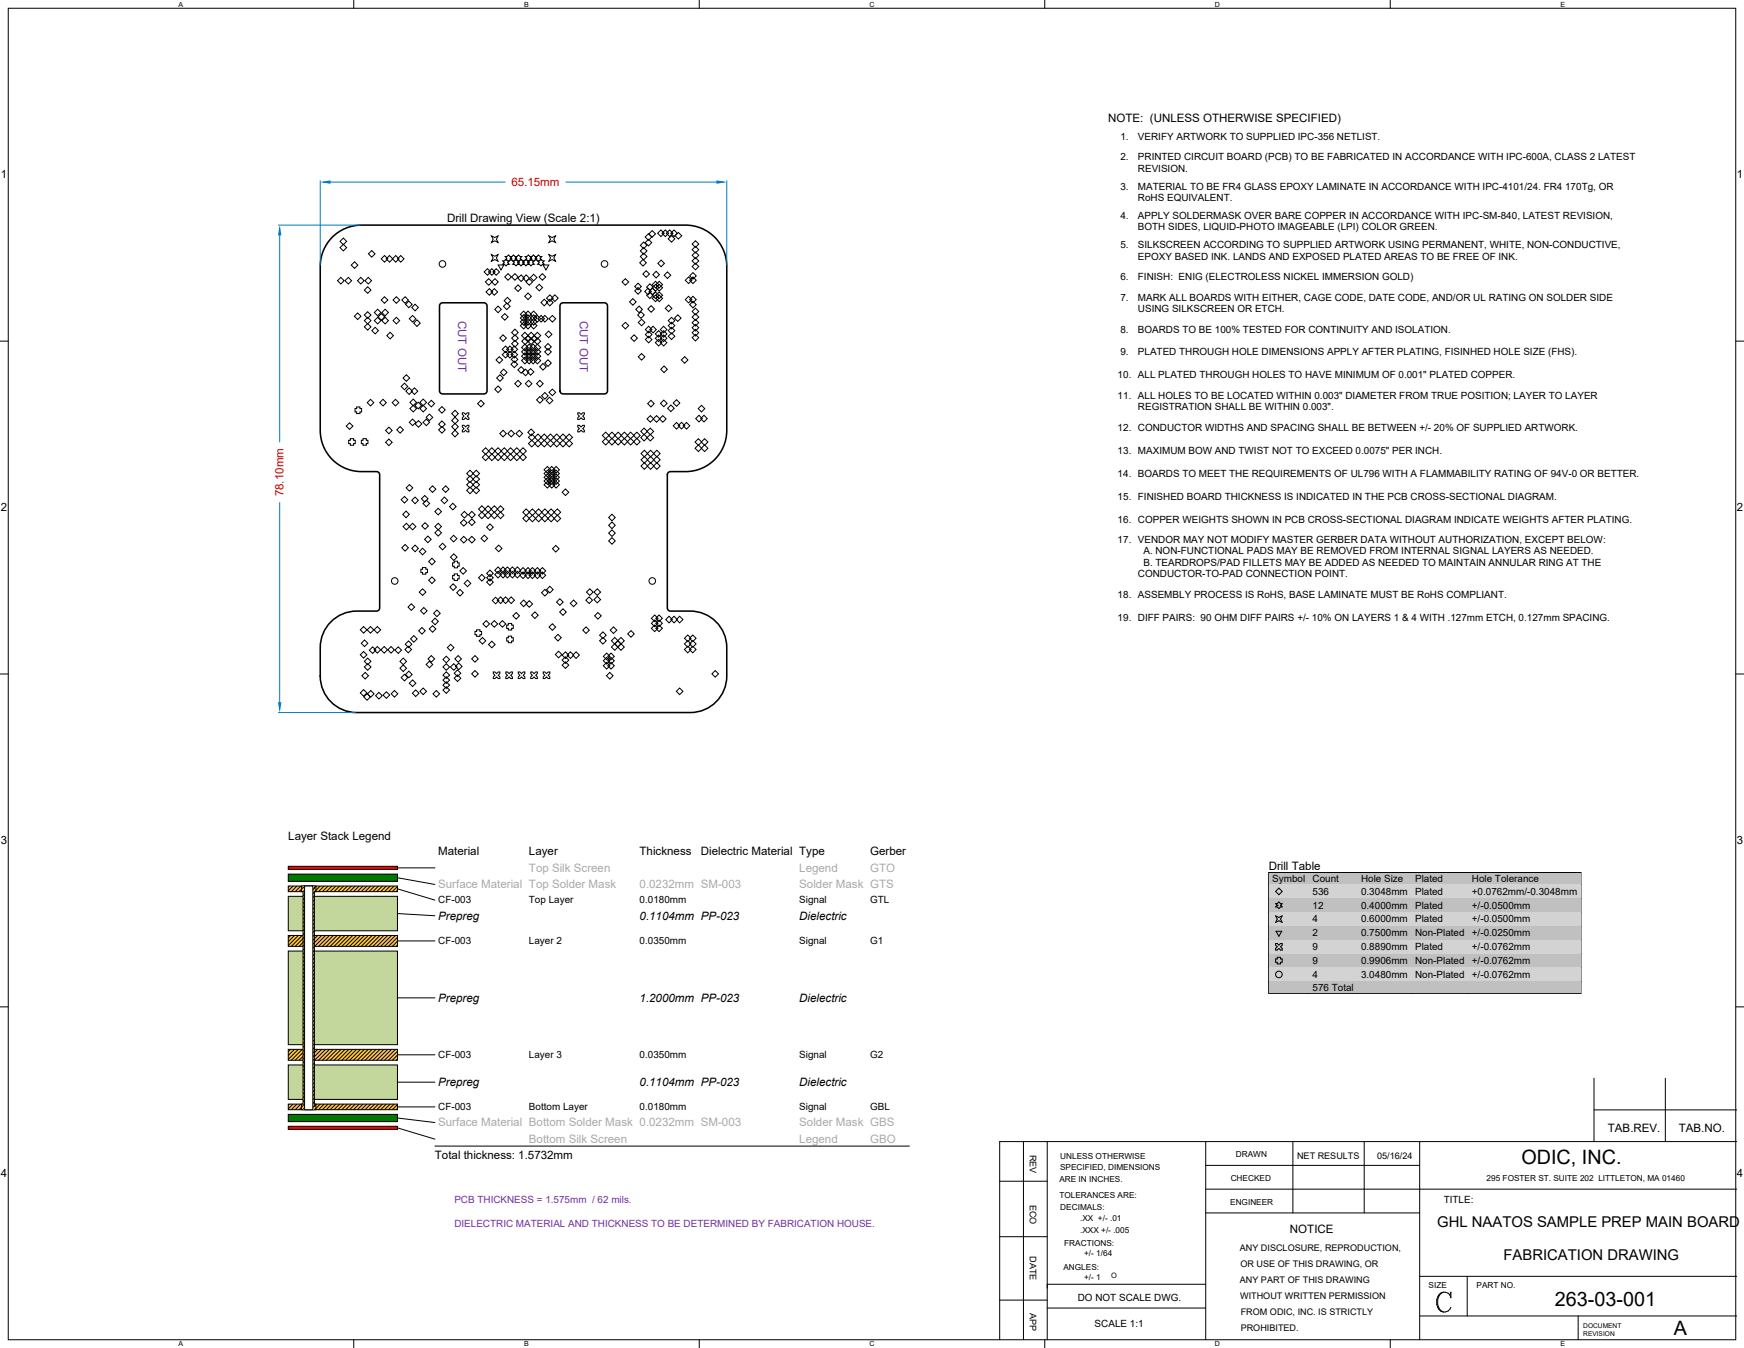
[picture p193: page 1]

NOTE: (UNLESS OTHERWISE SPECIFIED)
1. VERIFY ARTWORK TO SUPPLIED IPC-356 NETLIST.
PRINTED CIRCUIT BOARD (PCB) TO BE FABRICATED IN ACCORDANCE WITH IPC-600A, CLASS 2 LATEST
REVISION.
MATERIAL TO BE FR4 GLASS EPOXY LAMINATE IN ACCORDANCE WITH IPC-4101/24. FR4 170Tg, OR
RoHS EQUIVALENT.
APPLY SOLDERMASK OVER BARE COPPER IN ACCORDANCE WITH IPC-SM-840, LATEST REVISION,
BOTH SIDES, LIQUID-PHOTO IMAGEABLE (LPI) COLOR GREEN.
SILKSCREEN ACCORDING TO SUPPLIED ARTWORK USING PERMANENT, WHITE, NON-CONDUCTIVE,
EPOXY BASED INK. LANDS AND EXPOSED PLATED AREAS TO BE FREE OF INK.
6. FINISH: ENIG (ELECTROLESS NICKEL IMMERSION GOLD)
MARK ALL BOARDS WITH EITHER, CAGE CODE, DATE CODE, AND/OR UL RATING ON SOLDER SIDE
USING SILKSCREEN OR ETCH.
8. BOARDS TO BE 100% TESTED FOR CONTINUITY AND ISOLATION.

Drill Drawing View (Scale 2:1)

9. PLATED THROUGH HOLE DIMENSIONS APPLY AFTER PLATING, FISINHED HOLE SIZE (FHS).

10. ALL PLATED THROUGH HOLES TO HAVE MINIMUM OF 0.001" PLATED COPPER.
ALL HOLES TO BE LOCATED WITHIN 0.003" DIAMETER FROM TRUE POSITION; LAYER TO LAYER
REGISTRATION SHALL BE WITHIN 0.003".
12. CONDUCTOR WIDTHS AND SPACING SHALL BE BETWEEN +/- 20% OF SUPPLIED ARTWORK.

13. MAXIMUM BOW AND TWIST NOT TO EXCEED 0.0075" PER INCH.

14. BOARDS TO MEET THE REQUIREMENTS OF UL796 WITH A FLAMMABILITY RATING OF 94V-0 OR BETTER.

15. FINISHED BOARD THICKNESS IS INDICATED IN THE PCB CROSS-SECTIONAL DIAGRAM.

16. COPPER WEIGHTS SHOWN IN PCB CROSS-SECTIONAL DIAGRAM INDICATE WEIGHTS AFTER PLATING.
VENDOR MAY NOT MODIFY MASTER GERBER DATA WITHOUT AUTHORIZATION, EXCEPT BELOW:
A. NON-FUNCTIONAL PADS MAY BE REMOVED FROM INTERNAL SIGNAL LAYERS AS NEEDED.
B. TEARDROPS/PAD FILLETS MAY BE ADDED AS NEEDED TO MAINTAIN ANNULAR RING AT THE
CONDUCTOR-TO-PAD CONNECTION POINT.
18. ASSEMBLY PROCESS IS RoHS, BASE LAMINATE MUST BE RoHS COMPLIANT.

19. DIFF PAIRS: 90 OHM DIFF PAIRS +/- 10% ON LAYERS 1 & 4 WITH .127mm ETCH, 0.127mm SPACING.

Symbol | Count | Hole Size | Plated | Hole Tolerance

536 | 0.3048mm | Plated | +0.0762mm/-0.3048mm
12 | 0.4000mm | Plated | +/-0.0500mm
4 | 0.6000mm | Plated | +/-0.0500mm
2 | 0.7500mm | Non-Plated | +/-0.0250mm
9 | 0.8890mm | Plated | +/-0.0762mm
9 | 0.9906mm | Non-Plated | +/-0.0762mm
4 | 3.0480mm | Non-Plated | +/-0.0762mm
576 Total

APP DATE ECO REV

295 FOSTER ST. SUITE 202 LITTLETON, MA 01460

TITLE:
GHL NAATOS SAMPLE PREP MAIN BOARD

DIELECTRIC MATERIAL AND THICKNESS TO BE DETERMINED BY FABRICATION HOUSE.

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
