Global-Health-Labs/nPOC-BB/hw/beta/ECAD/heater-board/derived/PDF/Draftsman.PDF

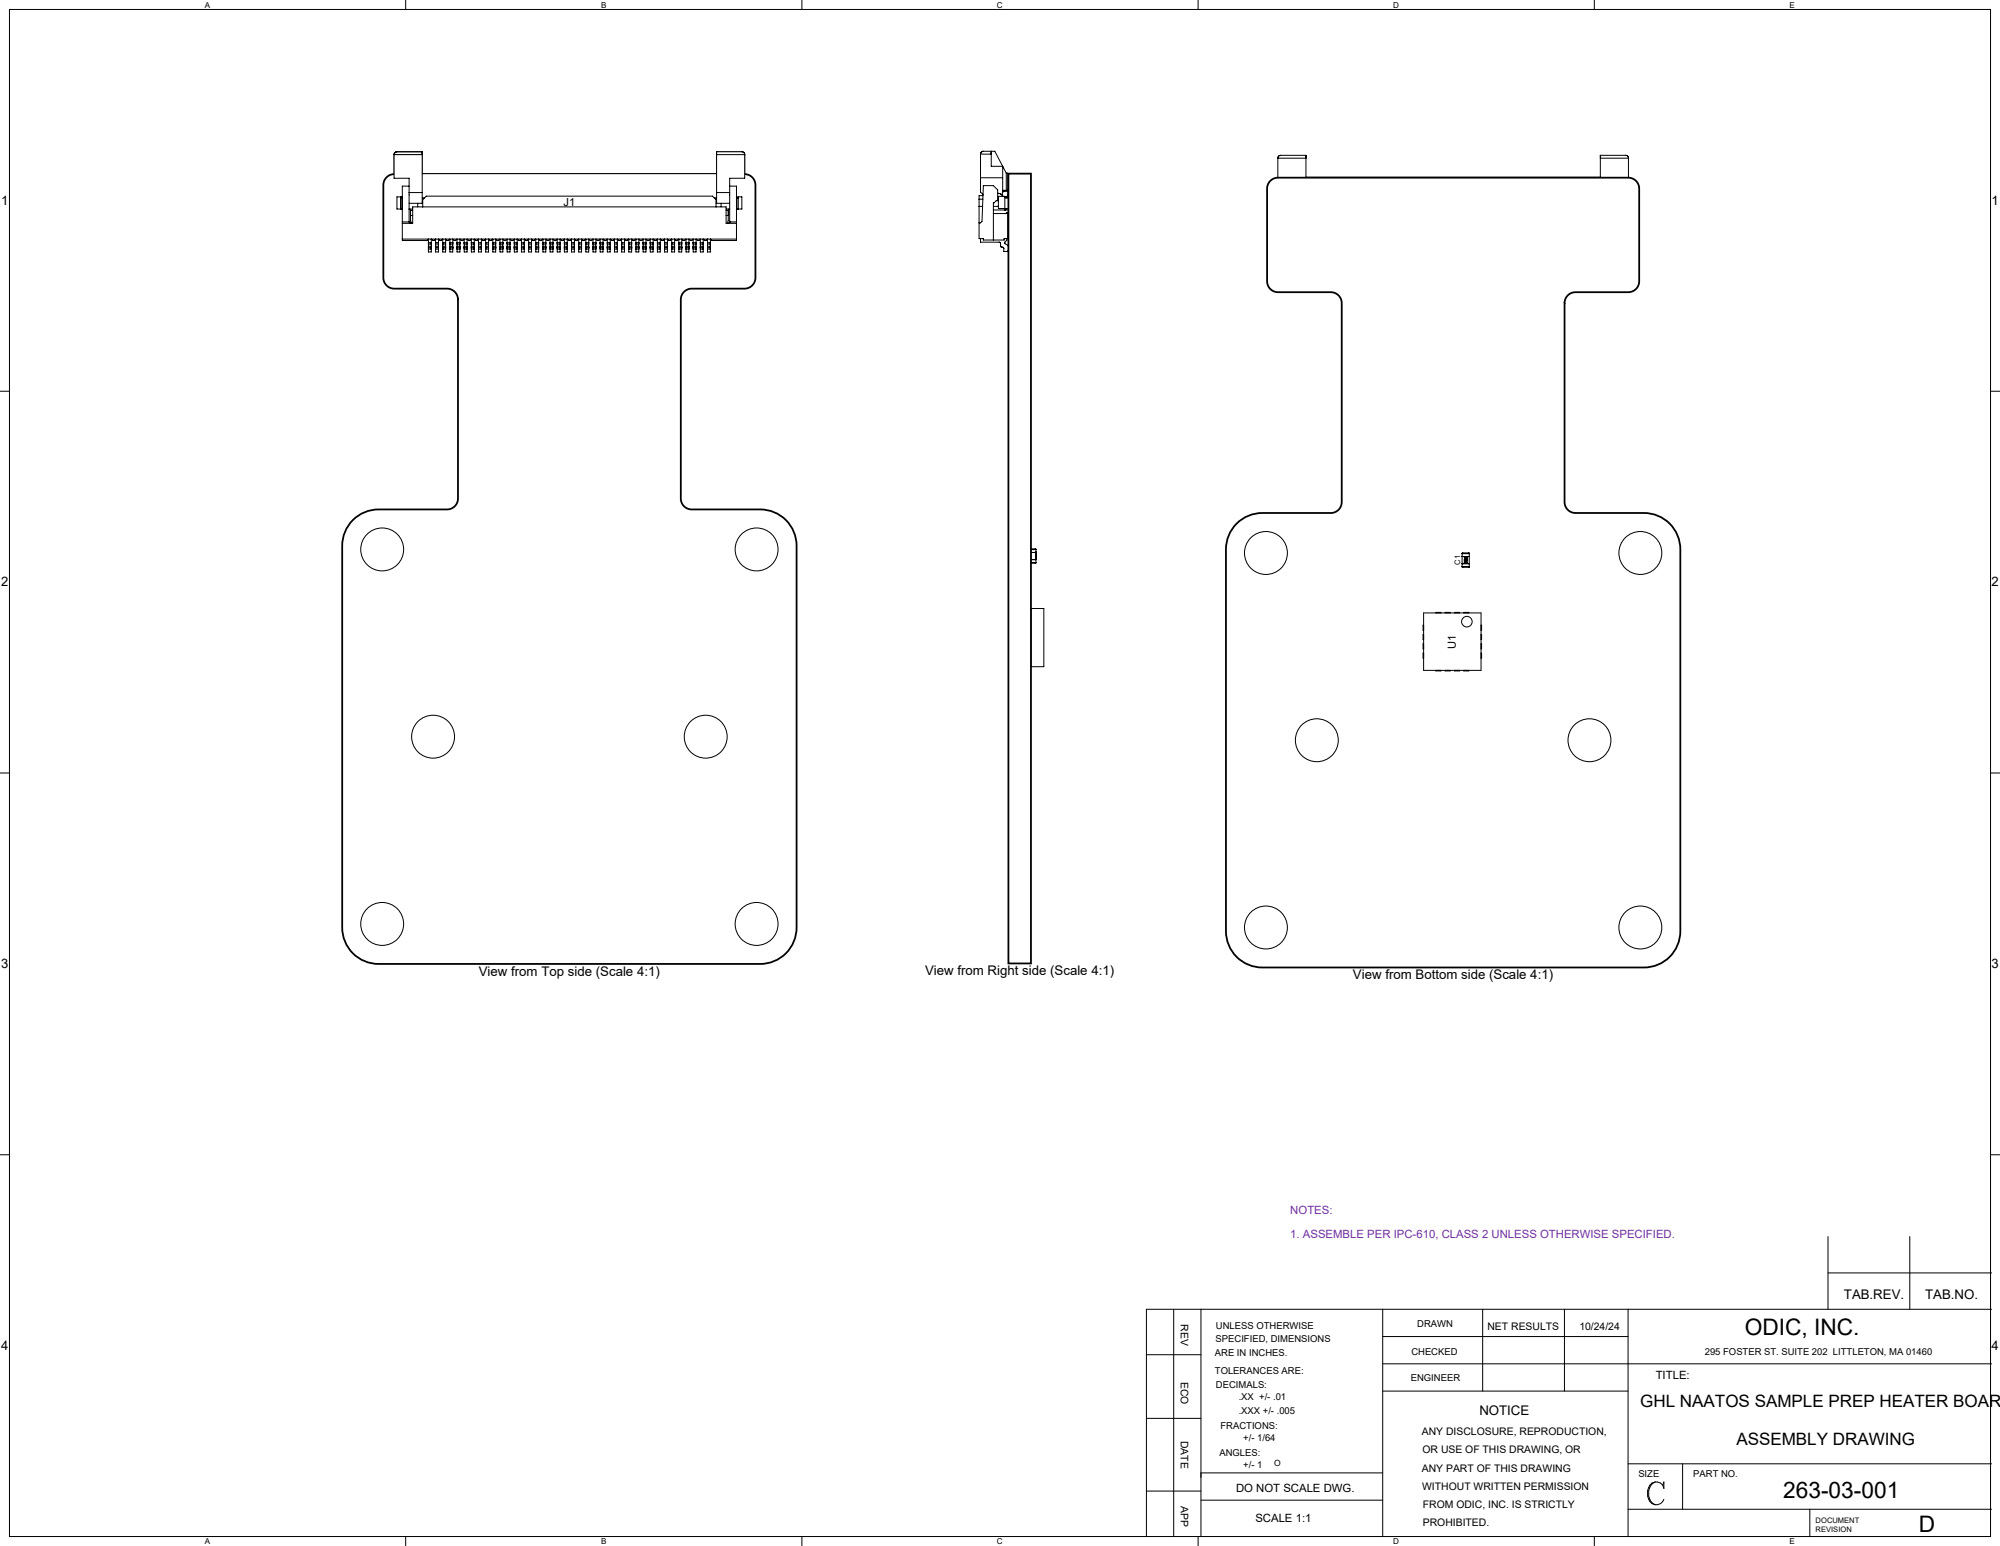
[picture p194: page 1]

View from Top side (Scale 4:1)

NOTES:
1. ASSEMBLE PER IPC-610, CLASS 2 UNLESS OTHERWISE SPECIFIED.

REV ECO DATE APP

295 FOSTER ST. SUITE 202 LITTLETON, MA 01460

TITLE:
GHL NAATOS SAMPLE PREP HEATER BOARD

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
