Global-Health-Labs/nPOC-BB/hw/beta/CAD/derived/drawings/GHL-1-20004.pdf

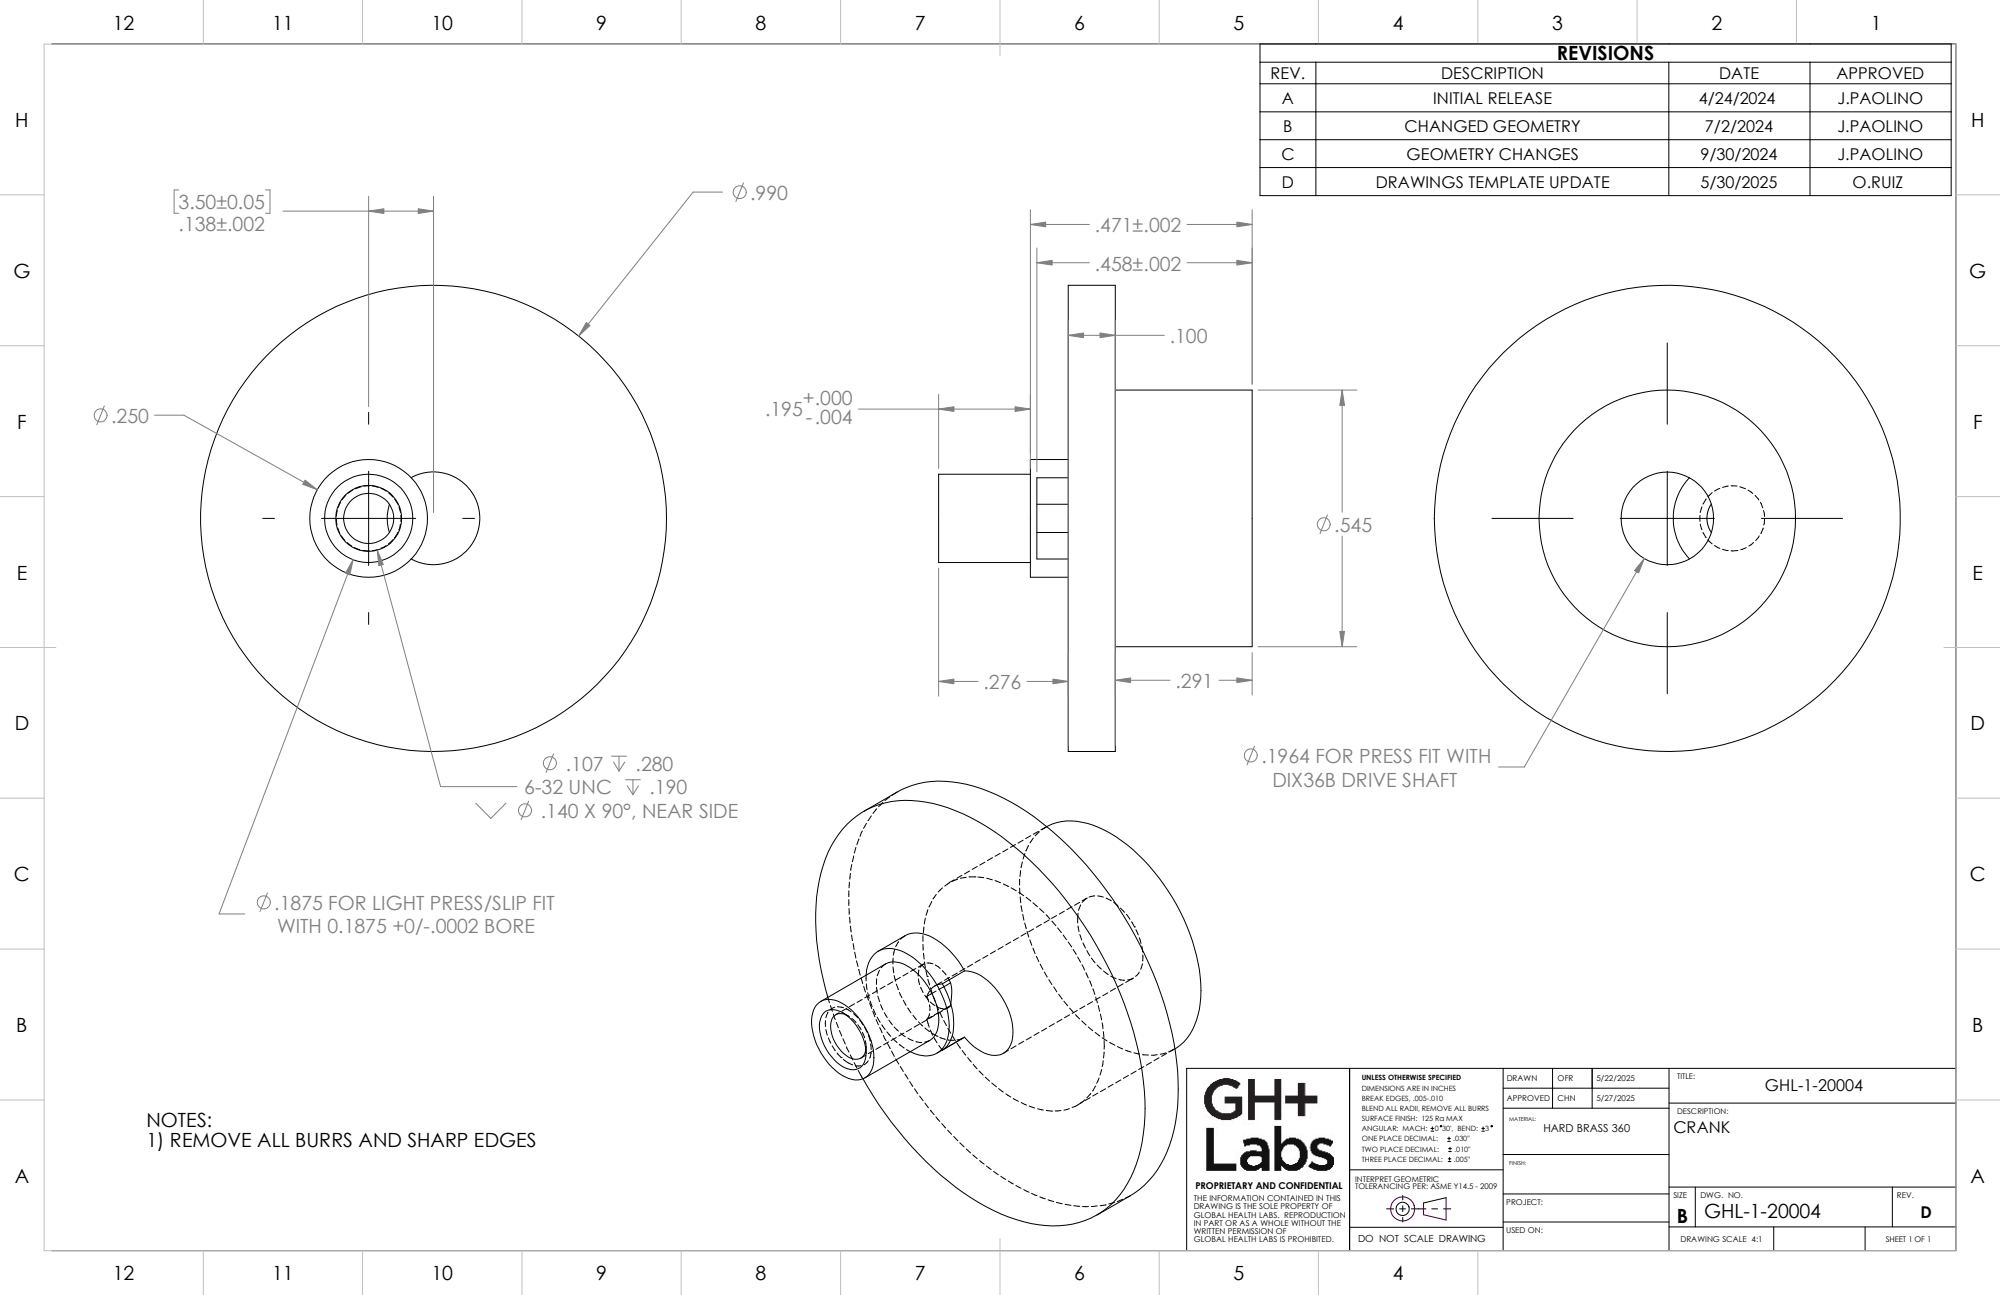
[picture p197: page 1]
PROJECT:; FINISH:; DESCRIPTION:; MATERIAL:; HARD BRASS 360; CRANK; USED ON:

REVISIONS

REV. | DESCRIPTION | DATE | APPROVED
A | INITIAL RELEASE | 4/24/2024 | J.PAOLINO
B | CHANGED GEOMETRY | 7/2/2024 | J.PAOLINO
C | GEOMETRY CHANGES | 9/30/2024 | J.PAOLINO
D | DRAWINGS TEMPLATE UPDATE | 5/30/2025 | O.RUIZ

DIX36B DRIVE SHAFT 6-32 UNC
.140 X 90°, NEAR SIDE

.1964 FOR PRESS FIT WITH

.1875 FOR LIGHT PRESS/SLIP FIT
WITH 0.1875 +0/-.0002 BORE

PROPRIETARY AND CONFIDENTIAL THE INFORMATION CONTAINED IN THIS DRAWING IS THE SOLE PROPERTY OF GLOBAL HEALTH LABS. REPRODUCTION WRITTEN PERMISSION OF GLOBAL HEALTH LABS IS PROHIBITED. | UNLESS OTHERWISE SPECIFIED DIMENSIONS ARE IN INCHES BREAK EDGES, .005-.010 BLEND ALL RADII, REMOVE ALL BURRS SURFACE FINISH: 125 Ra MAX ANGULAR: MACH: 0 30', BEND: 3 ONE PLACE DECIMAL: .030" TWO PLACE DECIMAL: .010" THREE PLACE DECIMAL: .005" | DRAWN | OFR | 5/22/2025 | TITLE: GHL-1-20004

APPROVED | CHN | 5/27/2025

NOTES:
1) REMOVE ALL BURRS AND SHARP EDGES

INTERPRET GEOMETRIC TOLERANCING PER: ASME Y14.5 - 2009

SIZE B | DWG. NO. | REV. D

GHL-1-20004 IN PART OR AS A WHOLE WITHOUT THE

DO NOT SCALE DRAWING | | DRAWING SCALE 4:1 | SHEET 1 OF 1
