Global-Health-Labs/nPOC-BB/hw/beta/CAD/derived/drawings/GHL-1-20011.pdf

2

4 3

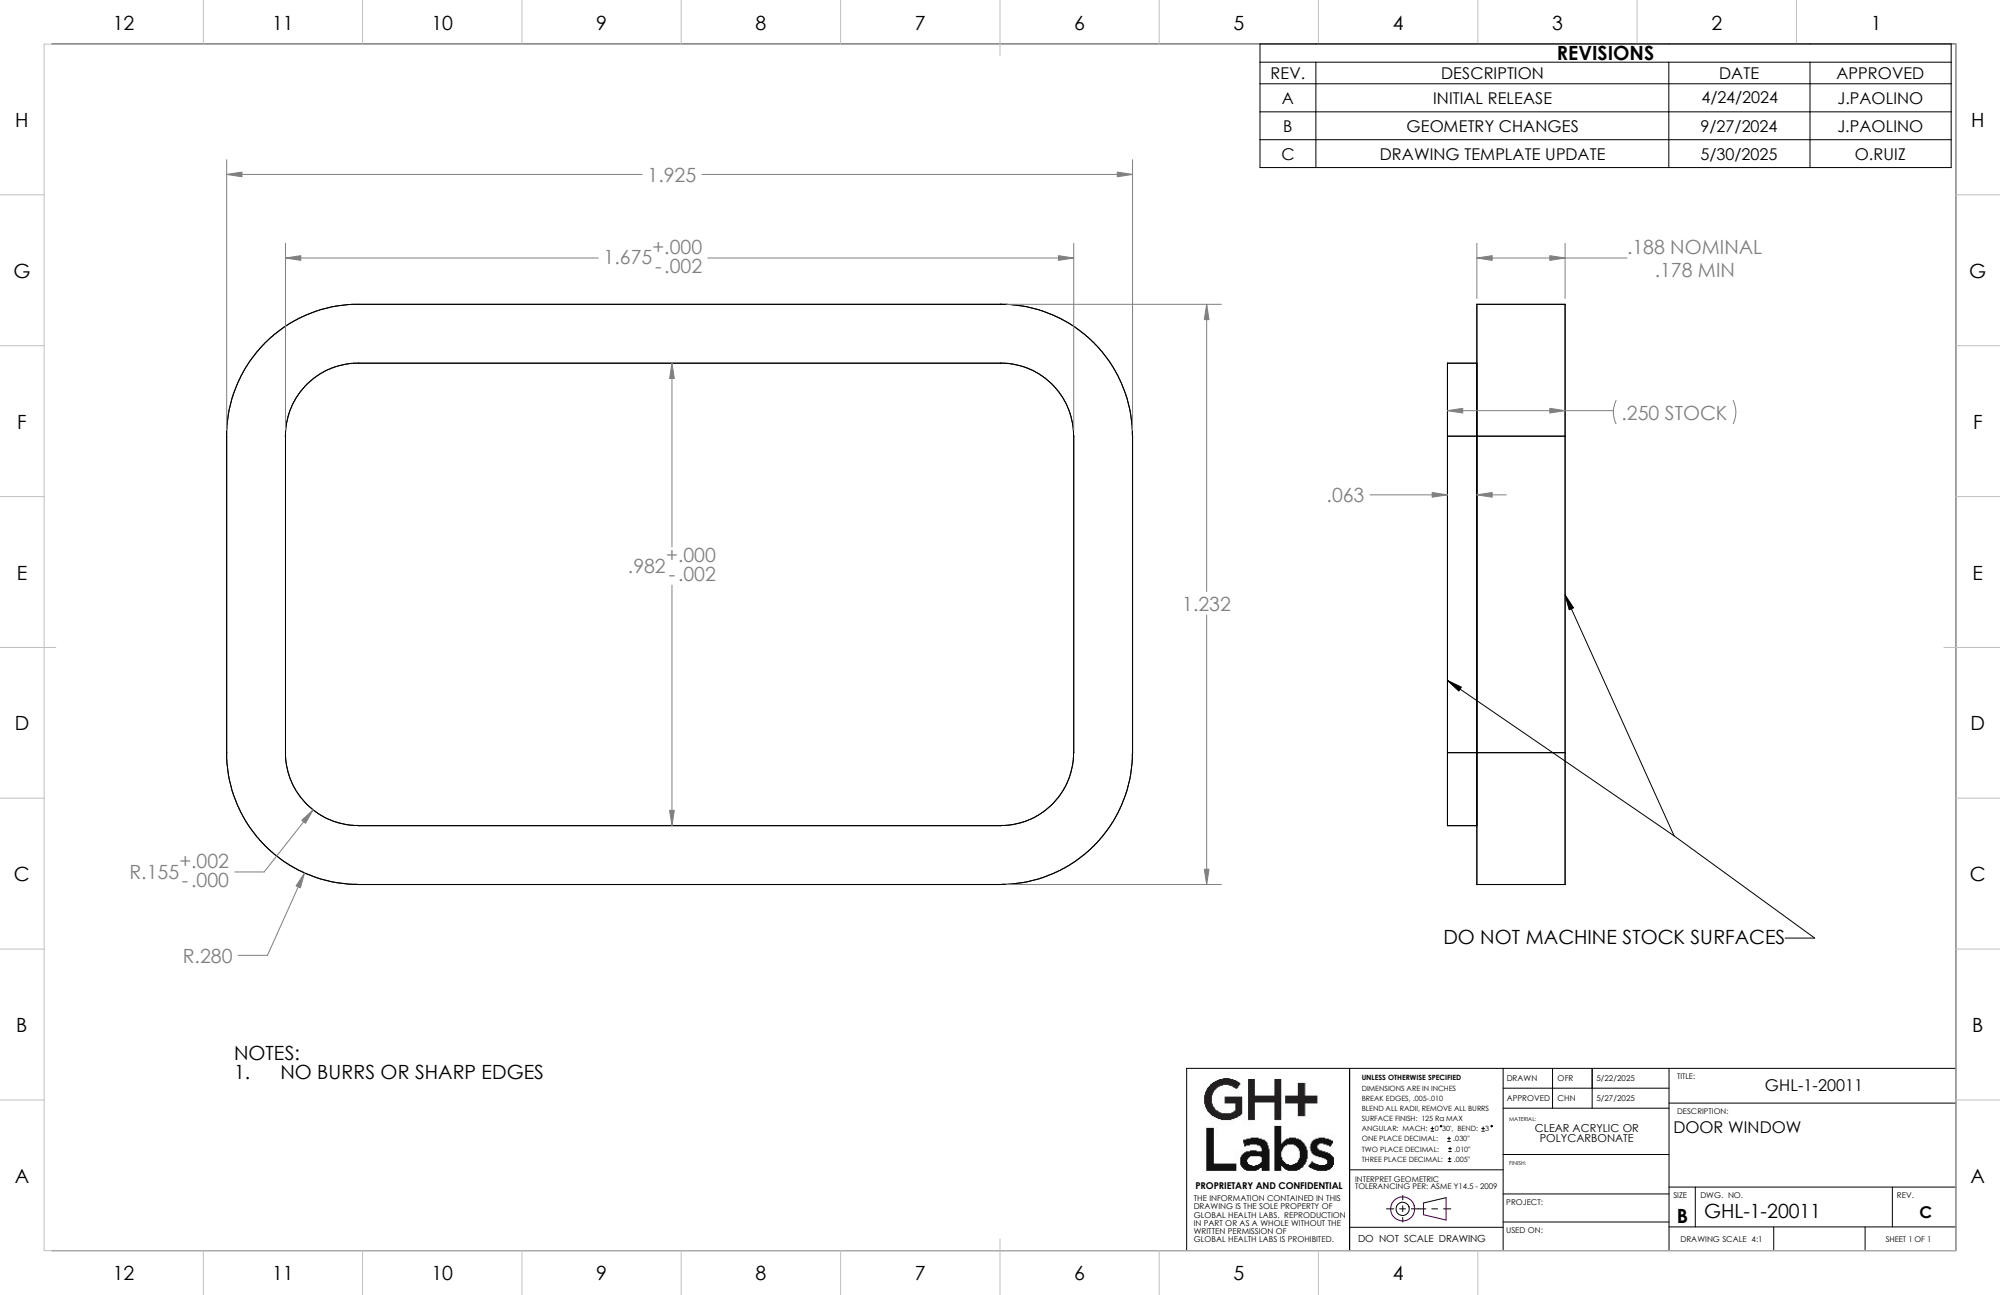
[picture p198: page 1]
PROJECT:; DESCRIPTION:; FINISH:; DOOR WINDOW; USED ON:; .250 STOCK; .188 NOMINAL .178 MIN

REVISIONS

REV. | DESCRIPTION | DATE | APPROVED
A | INITIAL RELEASE | 4/24/2024 | J.PAOLINO
B | GEOMETRY CHANGES | 9/27/2024 | J.PAOLINO
C | DRAWING TEMPLATE UPDATE | 5/30/2025 | O.RUIZ

DO NOT MACHINE STOCK SURFACES

NOTES:
1. NO BURRS OR SHARP EDGES

PROPRIETARY AND CONFIDENTIAL THE INFORMATION CONTAINED IN THIS DRAWING IS THE SOLE PROPERTY OF GLOBAL HEALTH LABS. REPRODUCTION IN PART OR AS A WHOLE WITHOUT THE WRITTEN PERMISSION OF GLOBAL HEALTH LABS IS PROHIBITED. | UNLESS OTHERWISE SPECIFIED DIMENSIONS ARE IN INCHES BREAK EDGES, .005-.010 BLEND ALL RADII, REMOVE ALL BURRS SURFACE FINISH: 125 Ra MAX ANGULAR: MACH: 0 30', BEND: 3 ONE PLACE DECIMAL: .030" TWO PLACE DECIMAL: .010" THREE PLACE DECIMAL: .005" | DRAWN | OFR | 5/22/2025 | TITLE: GHL-1-20011

APPROVED | CHN | 5/27/2025

MATERIAL:
CLEAR ACRYLIC OR
POLYCARBONATE

INTERPRET GEOMETRIC TOLERANCING PER: ASME Y14.5 - 2009

SIZE B | DWG. NO. GHL-1-20011 | REV. C

DO NOT SCALE DRAWING | | DRAWING SCALE 4:1 | SHEET 1 OF 1
