Global-Health-Labs/nPOC-BB/hw/beta/CAD/derived/drawings/GHL-1-20012.pdf

2

4 3

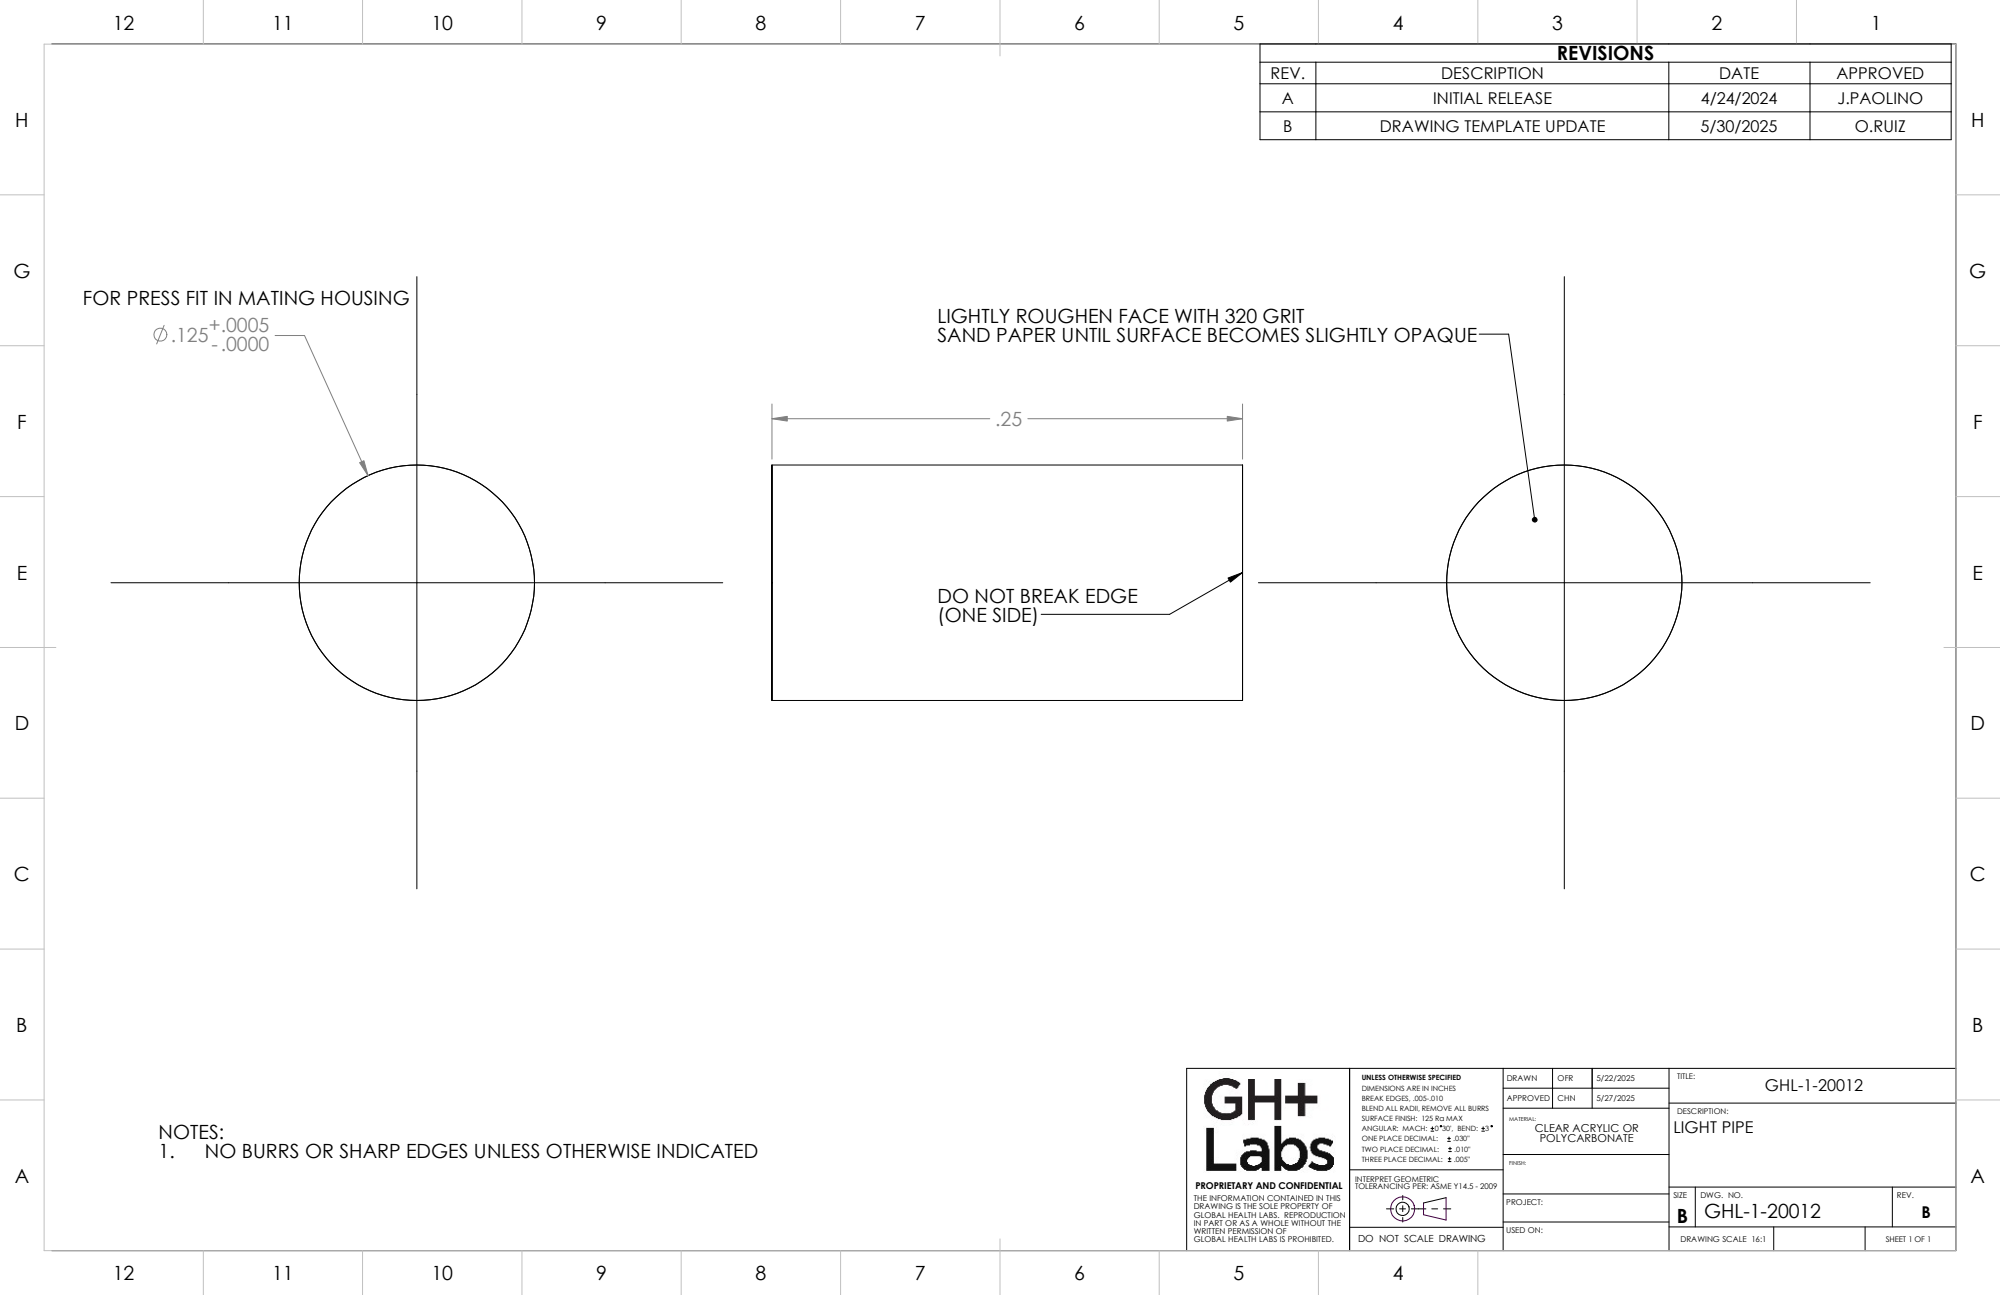
[picture p199: page 1]
PROJECT:; DESCRIPTION:; FINISH:; LIGHT PIPE; USED ON:

REVISIONS

REV. | DESCRIPTION | DATE | APPROVED
A | INITIAL RELEASE | 4/24/2024 | J.PAOLINO
B | DRAWING TEMPLATE UPDATE | 5/30/2025 | O.RUIZ

FOR PRESS FIT IN MATING HOUSING

LIGHTLY ROUGHEN FACE WITH 320 GRIT
SAND PAPER UNTIL SURFACE BECOMES SLIGHTLY OPAQUE

DO NOT BREAK EDGE
(ONE SIDE)

PROPRIETARY AND CONFIDENTIAL THE INFORMATION CONTAINED IN THIS DRAWING IS THE SOLE PROPERTY OF GLOBAL HEALTH LABS. REPRODUCTION IN PART OR AS A WHOLE WITHOUT THE WRITTEN PERMISSION OF GLOBAL HEALTH LABS IS PROHIBITED. | UNLESS OTHERWISE SPECIFIED DIMENSIONS ARE IN INCHES BREAK EDGES, .005-.010 BLEND ALL RADII, REMOVE ALL BURRS SURFACE FINISH: 125 Ra MAX ANGULAR: MACH: 0 30', BEND: 3 ONE PLACE DECIMAL: .030" TWO PLACE DECIMAL: .010" THREE PLACE DECIMAL: .005" | DRAWN | OFR | 5/22/2025 | TITLE: GHL-1-20012

APPROVED | CHN | 5/27/2025

MATERIAL:
CLEAR ACRYLIC OR
POLYCARBONATE

NOTES:
1. NO BURRS OR SHARP EDGES UNLESS OTHERWISE INDICATED

INTERPRET GEOMETRIC TOLERANCING PER: ASME Y14.5 - 2009

SIZE B | DWG. NO. GHL-1-20012 | REV. B

DO NOT SCALE DRAWING | | DRAWING SCALE 16:1 | SHEET 1 OF 1
