Global-Health-Labs/nPOC-BB/hw/beta/CAD/derived/drawings/GHL-1-20022.pdf

2

4 3

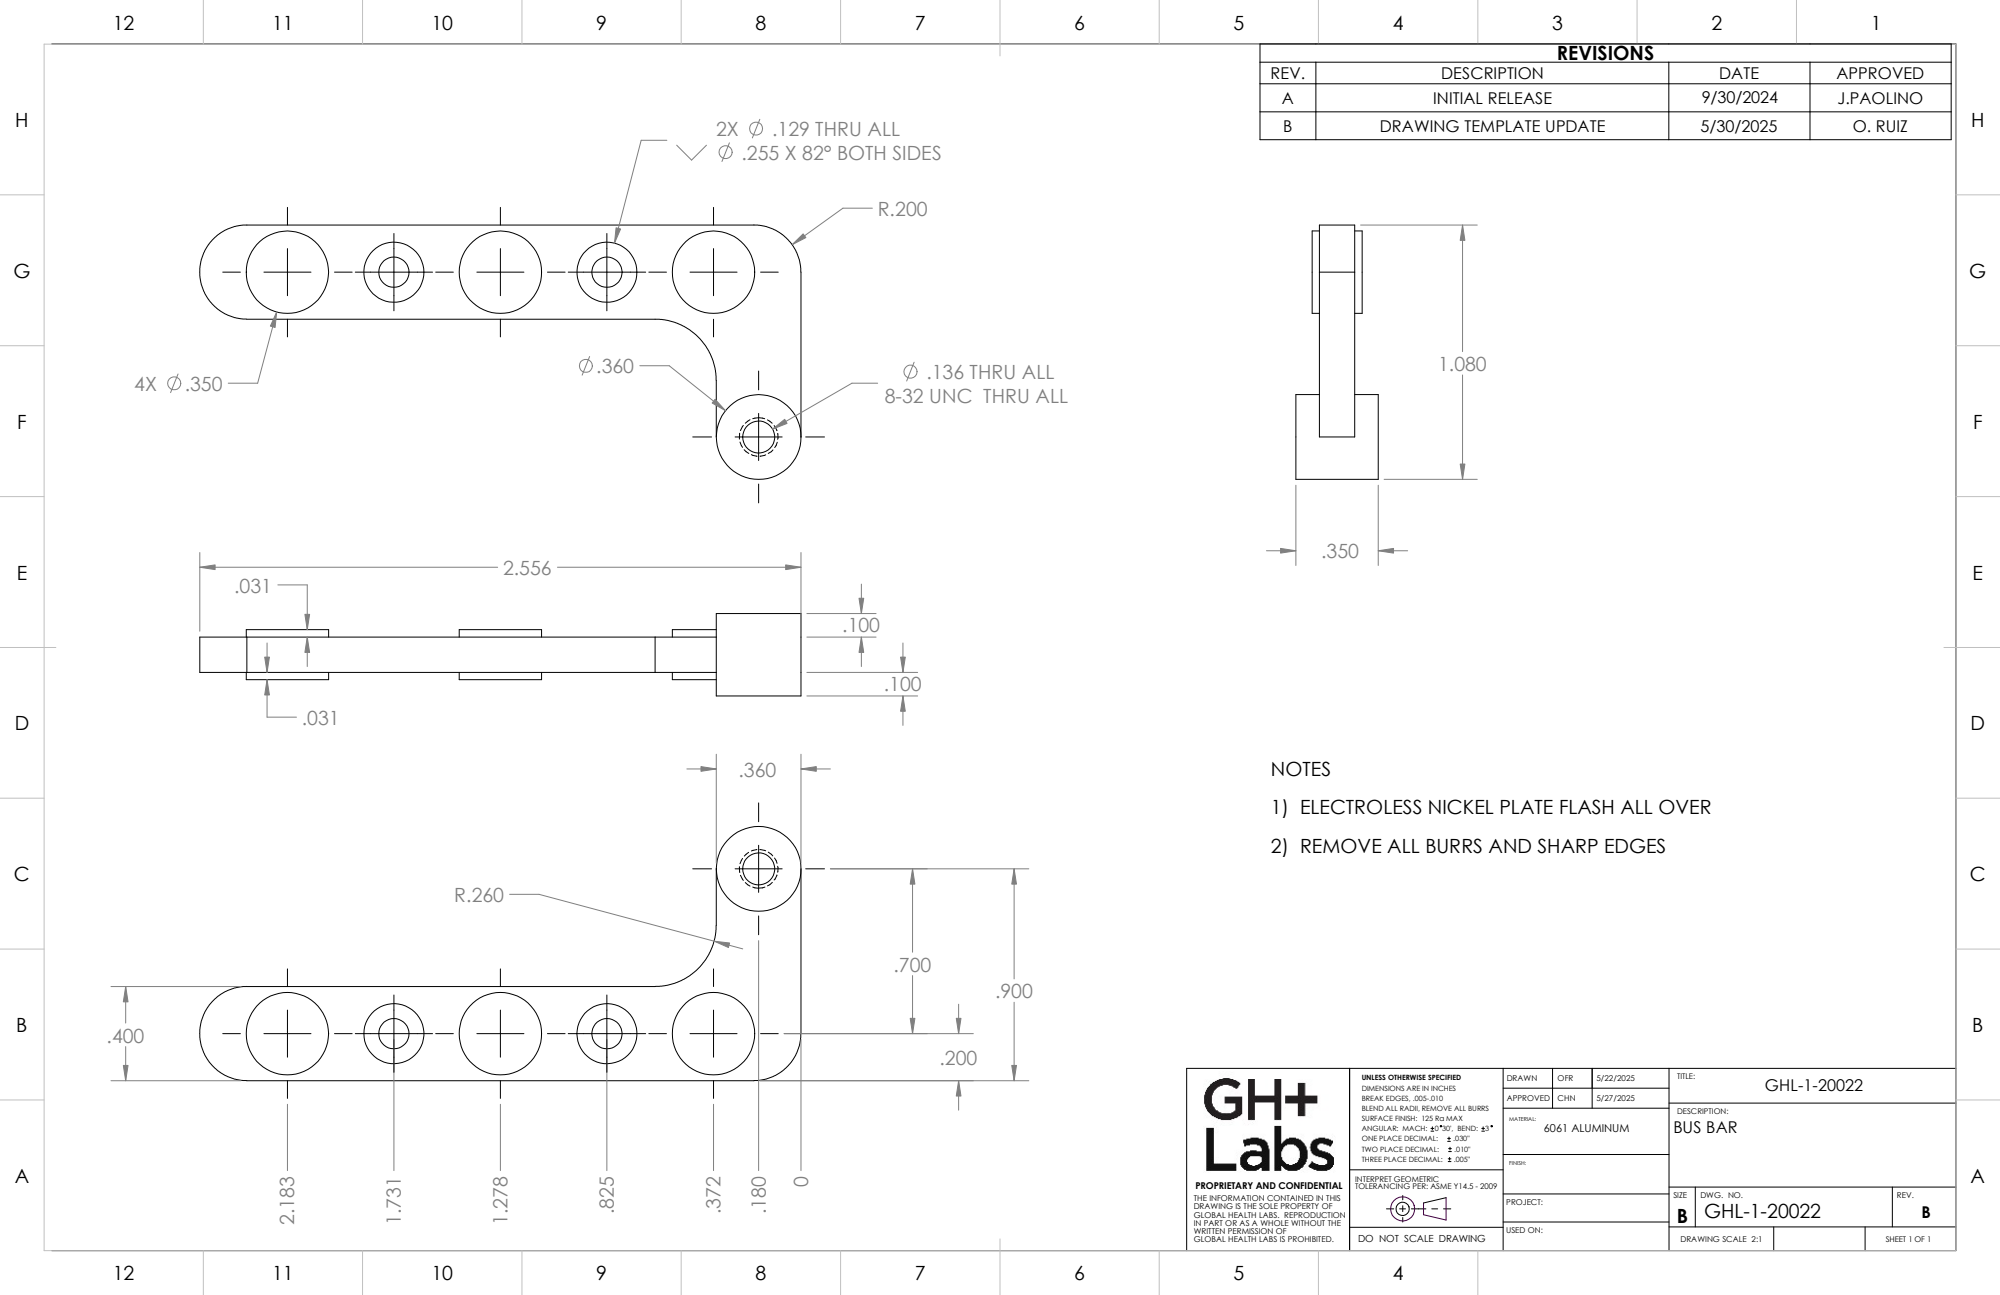
[picture p200: page 1]
PROJECT:; DESCRIPTION:; FINISH:; MATERIAL:; 6061 ALUMINUM; BUS BAR; USED ON:; .360 .136 THRU ALL 4X .350; .255 X 82° BOTH SIDES; .129 THRU ALL

REVISIONS

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

8-32 UNC THRU ALL

NOTES
1) ELECTROLESS NICKEL PLATE FLASH ALL OVER
2) REMOVE ALL BURRS AND SHARP EDGES

PROPRIETARY AND CONFIDENTIAL THE INFORMATION CONTAINED IN THIS DRAWING IS THE SOLE PROPERTY OF GLOBAL HEALTH LABS. REPRODUCTION IN PART OR AS A WHOLE WITHOUT THE WRITTEN PERMISSION OF GLOBAL HEALTH LABS IS PROHIBITED. | UNLESS OTHERWISE SPECIFIED DIMENSIONS ARE IN INCHES BREAK EDGES, .005-.010 BLEND ALL RADII, REMOVE ALL BURRS SURFACE FINISH: 125 Ra MAX ANGULAR: MACH: 0 30', BEND: 3 ONE PLACE DECIMAL: .030" TWO PLACE DECIMAL: .010" THREE PLACE DECIMAL: .005" | DRAWN | OFR | 5/22/2025 | TITLE: GHL-1-20022

APPROVED | CHN | 5/27/2025

INTERPRET GEOMETRIC TOLERANCING PER: ASME Y14.5 - 2009

SIZE B | DWG. NO. GHL-1-20022 | REV. B

DO NOT SCALE DRAWING | | DRAWING SCALE 2:1 | SHEET 1 OF 1
