Global-Health-Labs/nPOC-BB/(list of files, drawings)

Other design files:
hw/alpha/ECAD/altium/Battery and Charging.SchDoc
hw/alpha/ECAD/altium/MCU and Sensors.SchDoc
hw/alpha/ECAD/altium/nPOC-BB_alpha_main-board.PrjPcb
hw/alpha/ECAD/altium/nPOC-BB_alpha_main-board.SCHLIB
hw/alpha/ECAD/altium/Peripherals.SchDoc
hw/alpha/ECAD/altium/Power Supplies.SchDoc
hw/alpha/ECAD/altium/Revision History.SchDoc
hw/alpha/ECAD/altium/Title Page.SchDoc
hw/alpha/ECAD/altium/USB PD.SchDoc
hw/beta/ECAD/heater-board/altium/Main Schematic.SchDoc
hw/beta/ECAD/heater-board/altium/nPOC-BB_beta_heater-board.PcbDoc
hw/beta/ECAD/heater-board/altium/nPOC-BB_beta_heater-board.PcbLib
hw/beta/ECAD/heater-board/altium/nPOC-BB_beta_heater-board.PrjPcb
hw/beta/ECAD/heater-board/altium/nPOC-BB_beta_heater-board.SCHLIB
hw/beta/ECAD/main-board/altium/Battery and Charging.SchDoc
hw/beta/ECAD/main-board/altium/MCU.SchDoc
hw/beta/ECAD/main-board/altium/nPOC-BB_beta_main-board.PrjPcb
hw/beta/ECAD/main-board/altium/nPOC-BB_beta_main-board.SCHLIB
hw/beta/ECAD/main-board/altium/Peripherals.SchDoc
hw/beta/ECAD/main-board/altium/Power Supplies.SchDoc
hw/beta/ECAD/main-board/altium/Revision History.SchDoc
hw/beta/ECAD/main-board/altium/Title Page.SchDoc
hw/beta/ECAD/main-board/altium/USB Circuitry.SchDoc
hw/gamma/ECAD/heater-board/altium/Main Schematic.SchDoc
hw/gamma/ECAD/heater-board/altium/nPOC-BB_beta_heater-board.PcbDoc
hw/gamma/ECAD/heater-board/altium/nPOC-BB_beta_heater-board.PcbLib
hw/gamma/ECAD/heater-board/altium/nPOC-BB_beta_heater-board.PrjPcb
hw/gamma/ECAD/heater-board/altium/nPOC-BB_beta_heater-board.SCHLIB
hw/gamma/ECAD/main-board/altium/Battery and Charging.SchDoc
hw/gamma/ECAD/main-board/altium/MCU.SchDoc
hw/gamma/ECAD/main-board/altium/nPOC-BB_gamma_main-board.PrjPcb
hw/gamma/ECAD/main-board/altium/nPOC-BB_gamma_main-board.SCHLIB
hw/gamma/ECAD/main-board/altium/Peripherals.SchDoc
hw/gamma/ECAD/main-board/altium/Power Supplies.SchDoc
hw/gamma/ECAD/main-board/altium/Revision History.SchDoc
hw/gamma/ECAD/main-board/altium/Title Page.SchDoc
hw/gamma/ECAD/main-board/altium/USB Circuitry.SchDoc
