Global-Health-Labs/nPOC-BB/sw_tools/python/_sample_data/SamplePrepTestData/20250501_npocbb_autodl/SP16/config/cycle_config_2.txt

cycle_run_time_s:120.00
accept_cycle_time_error_s:15.0
cycle_delay_time_s:0
ramp_to_temp_before_start_cycle:false
ramp_to_temp_timeout:0.0
yellow_grace_period_s:0.0
heater_setpoint:93.50
motor_setpoint:0
run_heater_enable:true
run_motor_enable:false
heater_kp:60.000
heater_ki:0.050
heater_kd:50.000
motor_kp:0.005
motor_ki:0.0005
motor_kd:0.020
