Global-Health-Labs/nPOC-BB/sw_tools/python/_sample_data/SamplePrepTestData/20250501_npocbb_autodl/SP16/config/config_v3.5.txt

sample_rate:0.20
logging_rate:1.00
low_power_threshold:46
recovery_power_threshold:47
sample_valid_timeout_s:3600.00
alert_timeout_time_s:3.00
debug_to_com_en:true
min_run_zone_temp_en:false
min_run_zone_temp:80.00
do_automatic_runs:false
accept_run_time_error_s:30.0
heater_max_temp:120.0
max_heater_pid_pwm:100
switch_motor_ccw_cw:true
hal_sensor_thresh:0.30
motor_stall_percent:20
motor_stall_pwm:65
motor_stall_en:true
canary:12345
mmddyy:100124
hhmmss:120000
set_time_date:false
