Global-Health-Labs/nPOC-BB/(commit log)

2025-05-28 Added electronics files and alpha.md and gamma.md has a link-table to point to the directories.
    [GHL NAATOS Sample Prep Heater Board.GBL, GHL NAATOS Sample Prep Heater Board.GBO, GHL NAATOS Sample Prep Heater Board.GBP, GHL NAATOS Sample Prep Heater Board.GBS, GHL NAATOS Sample Prep Heater Board.GTL, GHL NAATOS Sample Prep Heater Board.GTO, GHL NAATOS Sample Prep Heater Board.GTP, GHL NAATOS Sample Prep Heater Board.GTS]
2025-06-13 Major content and organization update to docs
    [lookup_probability.csv, lookup_risk.csv, nPOC-BB_config_cycle_params.csv, nPOC-BB_config_run_params.csv, nPOC-BB_gamma_consumables.csv, nPOC-BB_gamma_instrument.csv, nPOC-BB_notifications.csv, nPOC-BB_risk.csv]
2025-06-21 Add /hw and /sw_tools. Edit docs.
    [0151660215.SLDPRT, 0402.SLDASM, 151660436.SLDPRT, 3625BL-24.SLDPRT, 53535A11.SLDPRT, 57155K346.SLDPRT, 57155K374.SLDPRT, 6181182224.SLDPRT]
2025-06-24 Modify hw/./CAD dirs to separate derived files
    [0151660215.SLDPRT, 0402.SLDASM, 151660436.SLDPRT, 3625BL-24.SLDPRT, 53535A11.SLDPRT, 57155K346.SLDPRT, 57155K374.SLDPRT, 6181182224.SLDPRT]
2025-06-27 Update /docs to add reviews, user guide, links
    [lookup_probability.csv, lookup_risk.csv, nPOC-BB_config_cycle_params.csv, nPOC-BB_config_run_params.csv, nPOC-BB_gamma_consumables-reagents.csv, nPOC-BB_gamma_consumables.csv, nPOC-BB_gamma_formulation.csv, nPOC-BB_gamma_heater_PCBA_BOM.csv]
2025-07-29 Update naatos_modules_fw_v3_gitlog.csv
    Shorten commit hashes (they trigger secret scanning commit block)
    [naatos_modules_fw_v3_gitlog.csv]
2025-07-31 corrected the binary of the firmware to V3.5 for sample-prep
